g3ncl/scacchiera/docs/hardware/matrix.md

# Matrix board (superseded baseline)

**Superseded 2026-08-02 by the four-lane [quad board](quad.md), which ships.** This file stays
because it is not dead weight: the quad instantiates this board's `matrix_cell` sixteen times and
inherits its loop geometry unchanged, so everything below about the antennas, the tag, the switch
cell and the tuning is the shipping design's documentation too. What is superseded is the outline,
the single-substrate stackup and the fabrication economics. The board still generates and still
passes DRC, and it stays that way deliberately: it is the measured baseline every figure in
`quad.md` is a delta against.

The sensing board: 8 row and 8 column line antennas under the 280 x 280 mm play area, one shared
13.56 MHz bus, and the switching that couples exactly one line at a time. A piece's square is the
intersection of the row and the column that both read its tag's UID, so 16 antennas cover 64
squares (the row-column technique from the research wiki, proven by the NFC Game Board project).
Schematic in `hardware/pcb/matrix.py`, layout in `hardware/pcb/matrix_layout.py`.

## Antennas

Each line is a single-turn rectangular loop, 276 x 31 mm of 1 mm trace, inset 2 mm inside its
35 mm lane. Single-turn keeps rows entirely on the front copper and columns entirely on the back,
so the two sets cross with no jumpers, and the resulting low inductance (0.59 uH by Grover's
formula from the routed geometry) tunes with a plain 220 pF C0G plus DNP trim pads. Rows face the
pieces; columns read through the 1.0 mm substrate, inside the 3.0 mm read budget of
[functional/physical.md](../functional/physical.md). The loop is drawn by a net-tie footprint
(`Chessboard:Antenna_Line`, generated by `hardware/pcb/footprints.py`) whose two terminals land on
through-hole pads in the component margin.

## Piece tag

Candidate, not yet purchased: an Avery Dennison **AD Circus SLIX2** round inlay (product code
3006370 / IL-603074) carrying the **NXP SL2S2602 (ICODE SLIX2)** die. Datasheets are filed in the
vault (`SL2S2602_NXP.pdf`, `AD-CIRCUS-SLIX2_AVERYDENNISON.pdf`) and ingested as
`Wiki/sources/sl2s2602-datasheet.md` and `Wiki/sources/ad-circus-slix2-datasheet.md`.

ISO/IEC 15693 rather than ISO/IEC 14443-A, and that is an architectural consequence rather than a
preference. A vicinity card operates at roughly a tenth the field strength of a proximity card,
and coupling an 18 mm tag coil to a 276 mm line antenna is weak by construction. 15693 is also
what BitwiseID's unaddressed `READ MULTIPLE BLOCKS` and `INVENTORY READ` need, and what the
PN5180 on the hub reads best.

Numbers the V4 model takes from these datasheets:

| Value | Figure | Source |
| --- | --- | --- |
| Tag antenna diameter | 18 mm | inlay datasheet, Overview |
| Die-cut diameter | 21 mm | inlay datasheet, Technical features |
| Inlay thickness | 141 um | inlay datasheet, Technical features |
| Chip input capacitance | 23.5 pF typ, 22.3 to 24.7 pF | SL2S2602 Table 84 |
| Minimum input power | 40 uW | SL2S2602 Table 84 |

The 21 mm die-cut leaves 0.5 mm radial clearance in the 22 mm recess of
[functional/physical.md](../functional/physical.md); this is the tag drawing that
`PHY-TAG-RECESS-DIAMETER` in [criteria.yaml](criteria.yaml) was waiting on. Model the 18 mm coil,
not the die-cut: using the die-cut would overstate the coupling area by 36 percent.

### Why the pawn bases are oversized

The tag fits the 22 mm recess, but at conventional proportions the recess does not fit a pawn. On
the 35 mm grid the standard ratios (king base 0.73 to 0.78 of the square, pawn base about 0.586)
give a 25.6 to 27.3 mm king base and an approximately 20.5 mm pawn base, smaller than the 21 mm
die-cut. Sixteen of the thirty-two pieces are pawns.

Every ISO 15693 tag small enough for a 20.5 mm pawn base was surveyed and rejected:

| Part | Size | Verdict |
| --- | --- | --- |
| AD Miniblock SLIX2 | 18 x 18 mm die-cut, 14.5 mm coil | 25.5 mm across the diagonal, worse than the round Circus |
| AD Minitrack SLIX2 | 14 x 31 mm | 31 mm long, does not fit any base |
| HID laundry tag SLIX2 | 16 mm disc | Fits, but EUR 1.64 and a sealed puck rather than a 141 um inlay |
| SLIX2 on-metal micro | 6 mm disc | EUR 2.50, and anti-metal behavior is prohibited by the functional spec |

Nothing small is comparably priced, and everything small couples worse, because coupling scales
with coil area and this design is already weakly coupled by construction. So the piece geometry
moves instead of the tag: `docs/functional/physical.md` sets a 24 mm minimum base diameter for
every piece, pawns included, which holds the 22 mm recess with 1 mm of wall per side and the bound
tag with 1.5 mm. A 35 mm square is already well under FIDE's 50 mm minimum, so the set is
non-standard regardless; the visible cost is that pawn bases end up close to the king's.

Two gaps, recorded rather than assumed away. Avery Dennison publishes no coil inductance, turn
count, or resonant frequency, so the tag resonator has to be back-solved against the 23.5 pF or
measured at V8, and that value is derived, not sourced. NXP publishes no equivalent parallel
resistance at minimum operating power, so loaded tag Q is derived too. V4 can run a bounded model
on this part; it cannot yet run a fully datasheet-sourced one.

### Coupling against the proven design

The prior art is in the vault as a full design package: schematics, Sprint Layout PCBs and the
vendor datasheets, at `Vault/Scacchiera/Clippings/nfcgameboard.com/files/`. Its antenna grid
schematic states **"Antenna: 15 x 320 (347) mm single winding PCB trace"**, thirty of them, on a
15 by 15 grid. Running that geometry through the same FastHenry model as ours is the only
calibration available for a number no datasheet gives:

| | nfcgameboard | this design |
| --- | --- | --- |
| Loop | 15 x 320 mm | 31 x 276 mm |
| Lane pitch | 21.3 mm (inferred from 320/15) | 35 mm |
| Fill, breadth over pitch | 0.70 | **0.89** |
| Gap between adjacent loops | 6.3 mm | **4.0 mm** |
| Adjacent-line coupling | 0.0786 | **0.1401** |
| Worst row-to-column coupling | 0.0170 | **0.0664** |

**Our lines couple 1.8 times harder than the design that demonstrably works, and our worst
row-to-column crossing is 3.9 times theirs.** That is not a proven defect, because nothing
establishes where the failure threshold is, but it does mean this copper sits outside the regime
the working hardware demonstrates, and the prior art can no longer be cited as covering it.

The lever is `LOOP_INSET`, and it is already against a wall:

| Inset | Breadth | Adjacent coupling | Margin enclosing a worst-case off-centre tag |
| --- | --- | --- | --- |
| **2.0 mm, current** | 31.0 mm | 0.1401 | **+1.0 mm** |
| 3.0 mm | 29.0 mm | 0.1067 | 0.0 mm |
| 4.0 mm | 27.0 mm | 0.0842 | -1.0 mm |
| 5.25 mm | 24.5 mm | 0.0640 | -2.2 mm |

A 24 mm piece base can sit 5.5 mm off centre in a 35 mm square, putting the far edge of an 18 mm
tag coil 14.5 mm from the centre, and the current loop half-breadth is 15.5 mm. So the 2 mm inset
is what keeps a badly placed piece inside its own loop, and buying crosstalk margin spends read
margin one for one. The enclosure figure is a proxy rather than a cliff, because a loop's field
does not stop at its conductor, but the direction of the trade is real.

Three ways out, none free: accept the coupling and show it harmless, widen the inset and accept
less tolerance to a badly placed piece, or enlarge the piece bases further so pieces self-centre
better and the inset can grow. The third interacts with the 24 mm minimum already set in
[functional/physical.md](../functional/physical.md).

Which is why this is a measurement question. The test article in
[test-article-quad.md](test-article-quad.md) settles read range against off-centre position and
whether a neighbouring line answers, in one session, and neither can be settled by more solving.

Note what the lever is, though: `LOOP_INSET` is per-line geometry, and the three ways out are one
sweep of one parameter. That was the argument for the split sensing plane in [quad.md](quad.md),
and it is why that board rather than this one ships: an attempt costs 20.92 EUR there against 58.34
here. The two architectures carry identical copper and identical coupling; they differ in what it
costs to change them.

## Switch cell

One cell per line, the single-ended half of the hybrid PIN switch the previous 64-antenna design
validated in SPICE:

- series BAR64-02V PIN diode: 2.5 ohm at 10 mA forward (datasheet max, 100 MHz), sub-picofarad
  reverse, so fifteen deselected
  cells load the bus with about 6 pF total where analog switches would collapse the tank;
- shunt BSS123-7-F grounding the tank when deselected (the off/on suppression);
- bias steering from the 3V3 rail: high-side BSS84-7-F, 180 ohm set resistor, isolation BAR64-02V,
  10 uH choke, with the forward current returning through the loop's own grounded end. That choke is
  rated 15 mA, and the swept bias reaches 10.58 mA over the rail and resistor tolerances, so 29
  percent of its rating stays unused;
- 100 nF DC block toward the shared bus and a 100 kilohm bleed.

Selection is one-hot active low from two daisy-chained 74HC595 registers; the same line both
releases the shunt and turns on the bias steering. After power-up the register state is undefined
until the hub clocks a pattern in, and the reader field is off until then.

## Interface to the hub

### The selection registers cannot be cleared

Both 74HC595 `SRCLR_N` pins are tied to 3V3 and both `OE_N` pins to ground, so the sixteen
selection outputs are permanently enabled and can never be blanked. The hub has a `SEL_SRCLR_N`
net on expander P1.3, but it runs to pullup R31 and stops: it is absent from J4's seven conductors
and from this board entirely. Confirmed against the generated netlists, where it reads
`SEL_SRCLR_N: (('R31', '2'), ('U6', '16'))` against a properly routed
`SEL_RCLK: (('J4', '7'), ('R26', '1'), ('U6', '4'))`.

Two consequences:

1. **From power-up until firmware acts, the selection is undefined.** A 74HC595's storage register
   powers up in no particular state and its outputs are live immediately. Several PIN diodes may be
   forward biased at once, which is an unmanaged current and a meaningless RF state, though not a
   damaging one: sixteen cells at about 10 mA is 160 mA on a rail sized well above that.
2. **Shifting a known pattern is the matrix driver's first action and cannot be skipped**, because
   there is no blanking alternative.

Not worth fixing in copper. J4 is a full 7-pin connector, so routing the signal means an 8-pin part
at both ends and a re-route of two boards, to replace something a 16-bit shift already does. What
was worth fixing is the trap: `hardware/pcb/firmware_pins.py` excludes the net from the generated
firmware header, so no driver can reach for a clear that would appear to succeed and do nothing.

### Connector

7-pin JST GH: the RF bus between two grounds, 3V3, and the register serial (SER, SRCLK, RCLK).
The reader and its matching live on the hub; this board is copper and switching only.

## Board

300 x 300 mm, 2 layers, 1.0 mm thick. The play area sits 15 mm off the left and bottom edges;
those margins carry every component (all on the back, keeping the front face flat for the
controlled air gap), the connector, and both-face ground pours. Components are placed
deterministically in code. Normal builds import the reviewed route in
`hardware/pcb/routes/matrix.ses`; `make pcb-matrix-reroute` explicitly produces a new Freerouting
candidate. KiCad DRC with schematic parity (`make pcb-matrix-drc`) reports 0 violations,
0 unconnected, and 0 parity issues. The four shared serial nets and Q24 power escape are routed
deterministically before the reviewed session is imported, so their 0.65 mm register escapes do
not depend on autorouter variation. Ground pours are added and filled after routing.

## Mounting

Two M2.5 plated holes bonded to ground, past each end of the switch-cell array. Only two, and that is
a constraint rather than a choice: the 15 mm left and bottom margins are already fully committed to
hand-routed register lanes, the reserved front-copper band for the U1 serial verticals, the cell part
rows at 4.4 and 10.6 mm, and the vertical corridors the router needs for all 16 selection lines.
Putting a 5.4 mm pad mid-margin made Freerouting fail outright on SEL_CHAIN. The far two edges are
only 5 mm wide with the outer antenna loop 1.6 mm away, where a grounded screw would load it.
Screwing all four edges needs a wider outline, which belongs with the enclosure design.

## Validation

`hardware/tests/test_sim_matrix.py` builds the cell and the full 16-cell bus from the same SKiDL
objects as the netlist, expands the loop footprint to its geometry-derived inductance and AC
resistance (`hardware/sim/loop.py`), and runs ngspice against
[criteria.yaml](criteria.yaml). With the exact Diodes vendor MOSFET models, the selected cell
resonates at 13.54 MHz, the loaded 16-line bus at 12.93 MHz, off/on suppression is 65.6 dB, and
steering bias is 10.326 mA on and 0.058 uA off.

## Cost

Generated BOM totals 4.80 EUR in parts; with area-dominated fabrication the board lands around
the 25 EUR target in [boards.md](boards.md).
