g3ncl/scacchiera/docs/software/architecture.md

# Firmware architecture

How the firmware is split so that the behaviour in [functional/gameplay.md](../functional/gameplay.md)
can be tested on a development machine rather than only on a board. This file covers the split, the
build targets, and the rule that keeps them apart. Driver detail belongs in its own file per
peripheral, not here.

## The split

V5 in [simulation-workflow.md](../simulation-workflow.md) requires gameplay and product state logic
to be independent of ESP32 register access. That is not a testing convenience, it follows from the
first principle in [functional/overview.md](../functional/overview.md): the typed physical position
is authoritative and a sensing fault is never converted into a move. Deciding what the position
means has to be separable from deciding what the hardware just reported, or the two get to influence
each other.

So there are two layers and one boundary.

`core/` holds the position, the rules, move derivation from typed snapshots, the clock, the game
state machine, the fault table, provisioning, and PGN. It includes no ESP-IDF header, touches no
register, and blocks on nothing. It is C that runs anywhere.

`port/` holds the PN5180, the TCA9535, the displays, the light bars, the matrix scan, the button,
persistence, and the network. It is where ESP-IDF appears.

The boundary is a small set of headers in `core/` that `port/` implements: a scan returns a typed
snapshot, a clock returns monotonic milliseconds, an output surface accepts display text and light
cues, and storage accepts and returns a game snapshot. On the host the same headers are implemented
by deterministic fakes, which is what makes generated move sequences and injected faults possible.

Nothing in `core/` calls into `port/`. The application in `main/` owns the wiring and is the only
place that knows both exist.

## Why C

The target build has to be the exact ESP32-C6 image V6 runs in Wokwi and V9 releases, and ESP-IDF is
a C toolchain. Using anything else in `core/` would mean either a second toolchain in the image or a
host-only reimplementation of the rules, and a rules engine that is not the shipped one is not
evidence. Strict warnings, static analysis, and the address and undefined-behaviour sanitizers all
run on the host build, where they are cheap.

## Build targets

Two, from the same sources:

- **Host tests.** Plain CMake and CTest over `core/` plus the fakes, with Unity and CMock. This is
  the V5 gate. It builds with warnings as errors and runs under the sanitizers.
- **Target image.** The ESP-IDF build over `core/`, `port/` and `main/` for the ESP32-C6 and its
  partition layout. This is the binary V6 executes and V9 releases.

A file that will not compile in both is in the wrong layer.

## Layout

```
software/firmware/
  core/          rules, state, clock, faults, PGN; no ESP-IDF
  core/hw/       the headers port and the fakes both implement
  port/          ESP-IDF drivers
  main/          application wiring and entry point
  test/          host tests and deterministic fakes
```

The browser client is a separate concern and gets its own directory and its own document when it
starts. It mirrors state and configures the board; nothing required by `docs/functional/` depends on
it being connected.

## Scope for hardware validation

V5 and V6 exist here to de-risk hardware before it is fabricated, not to finish the product. So the
work is ordered by what a board can teach us and nothing else.

**In scope now**, because it is what exercises the hardware: the PN5180 driver down to SPI framing,
BUSY, IRQ, reset and inventory; the TCA9535 and everything hanging off it; the display SPI at the
timing the SSD1362 table fixes; the matrix register chain and its scan; the light-bar data stream;
the button; the charger and rail signals; power-up, warm reset and the recovery path. These are the
parts whose failure means a board respin, so they are the parts V6 has to run in simulation against
behavioural peripheral models.

**The rules engine is real**: `core/game.c` is the game state machine from
[functional/gameplay.md](../functional/gameplay.md), driven by identity-resolved stable positions,
clean raw sweeps for the second-scale gestures, the button, and a clock that arrives as a parameter.
It covers the start check against the standard position, the ten-second time-control window, the
provisional-move contract (commit on the opponent's first lift, cancel by returning, replace by a
different legal move), promotion by replacement tag, the resign and draw king-absence countdowns,
pause and resume, flag fall with the insufficient-material exception, the automatic endings with the
claimable hints, a sealed persisted record after every commit, and resume-after-restart against a
matching physical board. Gestures advance only on clean sweeps: no evidence, no countdown, so an
unreadable board can never resign a game nobody touched.

## Status

`software/firmware/` holds the host build, the boundary headers, the core logic, the six drivers and
the deterministic fakes. `make firmware-test` is part of `make check`.

What is there:

- CMake and CTest over `core/` plus the fakes, building with `-Werror`, `-Wconversion`,
  `-Wsign-conversion`, `-Wshadow` and the rest, and with gcc's `-fanalyzer` as the static analysis
  step. `clang-tidy` and `cppcheck` are not installed on this machine.
- `core/`: `square` (zero based, aligned with the sensor array), `piece`, `fault` (the six faults
  from [functional/gameplay.md](../functional/gameplay.md) with a test that fails if the table
  drifts), `snapshot` (typed 64-square reading with UID, plus equality, occupancy and duplicate-UID
  detection), `scan_join` (sixteen line reads to sixty-four squares), `stability` (when a sweep has
  become a position), `text` with its generated glyph table, and the chess core: `move`,
  `position` (with FEN for perft fixtures), `movegen` (legal generation, verified against
  published perft counts), `movederive` (which legal move turned a known position into the sensed
  one), `chessclock`, `repetition`, `result`, `registry` and `identity` (UID to piece through the
  provisioning table), `game_record` (the sealed, CRC-checked persisted game), and the `engine`
  stub that will replace piecewise use of those parts with the game state machine.
- `core/hw/`: `clock`, `scan`, `output`, `storage`, the four headers `port/` and the fakes both
  implement as free functions. No indirection layer, because link-time substitution already does
  the job.
- `test/`: deterministic fakes for all four boundary headers, and twenty-one test executables
  covering square indexing, snapshot semantics, the fault table, the stub's contract, the fakes
  themselves, the scan join, the stability layer, text rendering, both the matrix and light-bar
  encodings, and the chess core: moves, positions, move generation (perft), move derivation, the
  clock, results, the registry and identity resolution.
- `main/`: the wiring plus the scan loop, one pass of scan, stability, identity and engine every
  quarter second, with faults surfacing on both displays. Only the expander aborts the boot on
  failure; a dead scan path or output surface logs, is announced where possible, and leaves the
  rest of the board running.

The game machine is pinned two ways: unit tests for every spec behaviour (commit, cancel,
replace, time selection, flag fall, gestures, resume, persistence failure), and generated
sequences in `test_game_sequences.c`, where scripted games cover checkmate, castling, en passant
and promotion end to end, and deterministic random games are cross-checked ply by ply against an
independent repetition ledger and result evaluation, ending with a resume round trip.

The analyzer and the sanitizers are both V5 obligations, and they do not share a build: gcc's
analyzer, run over sanitizer-instrumented code, reports uninitialized values that exist only in the
instrumentation's own temporaries, with no source location to inspect. So the gate runs one per
configuration. The configure probes a real sanitizer link, because gcc accepts the flag without the
runtime libraries and only fails at link. With `libasan` and `libubsan` present the tests run under
ASan and UBSan and the analyzer is skipped with a notice; a second configure with
`-DFIRMWARE_SANITIZE=OFF` is the analyzer pass. Without the runtimes the analyzer pass is what
runs, and the gate warns that the sanitizer half is missing.

### The target image

`make firmware-target` produces a 227 KB `chessboard.bin` for the ESP32-C6, leaving 85 percent of
its app partition free.

- **Pinned to ESP-IDF v5.5.5**, commit `b774170ff46c393eeb5e495ea37936038d3f4f4f`, with the
  riscv32 toolchain at esp-14.2.0. v5.5 rather than v6.0 because V6 has to run this exact image in
  Wokwi and the v5.5 line has the most mileage there.
- The IDF project root is `target/`, kept separate because the host gate owns
  `software/firmware/CMakeLists.txt` and two build systems cannot share one project root.
  `core/CMakeLists.txt` registers itself either as an IDF component or as a plain static library
  depending on `ESP_PLATFORM`, so both builds compile the same sources rather than a copy.
- `target/partitions.csv` fixes the layout: two 1.5 MB OTA app slots so a failed update cannot
  leave a board that will not boot, NVS for the in-progress snapshot because it is rewritten after
  every committed move and NVS wear-levels, and a 896 KB SPIFFS partition for PGN.
- `port/board_pins.h` is generated from the hub netlist by `hardware/pcb/firmware_pins.py`, and
  `hardware/tests/test_firmware_pins.py` fails if the committed copy drifts. A stale pin map is not
  a compile error, it is a board that boots and does the wrong thing.

`firmware-target` is deliberately not part of `make check`, because it needs a 2 GB toolchain
exported rather than a checkout dependency.

## Drivers

`port/` holds six drivers and the boundary implementation, all compiling for the C6. Boot order is
not arbitrary; each step depends on the previous one.

| Step | What it establishes |
| --- | --- |
| `expander_init` | resets asserted, light-bar rail off, matrix latch idle low |
| `spi_bus_init` | the one bus shared by reader, both displays and the matrix registers |
| `matrix_init` | shifts and latches all-deselected, the only path to a known selection |
| `pn5180_init` | reset, then an EEPROM version read that proves the framing |
| `display_init` | shared reset, 50 ms settle, init sequence, clear, on |
| `lightbar_init` | blank the pixels, then enable the rail |
| `board_hw_storage_init` | NVS for the in-progress snapshot |

Three properties of the wiring shape all of this, and each was read from the netlist rather than
assumed:

- **The matrix registers have no chip select**, so every byte sent to the reader or a display is
  also shifted into them. Their outputs only move on a latch edge, so the shift and the latch must
  be atomic against all other SPI traffic. Every driver that transacts acquires the bus.
- **The expander's outputs power up high**, so values are written before directions. Otherwise the
  reader and displays leave reset uncontrolled, the light-bar rail switches on, and the matrix
  latches random selection.
- **The matrix cannot be blanked**, so shifting a known pattern is mandatory rather than tidy.
- **The selection chain is four eight-bit registers, one per sensing board**, so a scan shifts 32
  bits and only the low nibble of each byte reaches a lane. Half of every register drives nothing
  ([hardware/quad.md](../hardware/quad.md)), which makes the line-to-bit map a stride of 8 with a
  lane count of 4 rather than the linear map the two-register monolith had. That is the one thing
  the sensing-plane repartition asked of software, and `test_matrix_encoding.c` pins both the
  stride and the byte order so a refactor cannot transpose the board.

## What is real and what is not

Real: the expander, the matrix selection, the PN5180 framing down to BUSY and sixteen-slot ISO
15693 anticollision, the SSD1362 command path, the light-bar stream, the clock, light cues, NVS
persistence, a full sixteen-line sweep joined into a snapshot, rendered display text, and the stability layer that decides when a sweep has become a position.

Text comes from `core/text.c` against a glyph table generated by
`software/firmware/tools/generate_font.py`, where the glyphs are drawn as art so a wrong bit shows
up in review rather than only on a panel. `make firmware-font` regenerates it. The renderer is in
`core/` because packing four-bit pixels two to a byte is logic, not hardware, and it is covered by
ten host tests including the nibble order, which mirrors characters in pairs when it is wrong.

Not real, and deliberately so:

- **PGN export.** The record persists moves and the clock; rendering completed games as PGN with
  SAN belongs to the browser-client increment, which also owns the explicit undo.
- **Sleep and low battery.** Both need the battery ADC path and a power-state driver that do not
  exist yet; the gameplay spec's twenty-minute sleep and five-minute low-battery shutdown stay
  open until they do.
- **The provisioning journey.** Identity resolution through the registry is real: a stable
  position is resolved UID by UID and an unknown tag is a `TAG_FAULT` at its square. What does not
  exist is the journey that fills the registry: the button-gated write of piece records to tags
  and the readback that proves them. Until then every piece on an unprovisioned board reads as
  `TAG_FAULT`, which is the honest state.
- **The BitwiseID scheme.** Sixteen-slot anticollision, now with the standard's mask recursion on
  collided slots, resolves everything a line carries, which is what makes a real position readable
  at all, but it does so slot by slot.
  [The research](../../Vault/Scacchiera/Wiki/concepts/bitwiseid-method.md) exists because that
  scales badly: the source paper measures an equivalent 8x8 scan at 616 to 745 ms with classic
  anticollision. Throughput, not correctness, is what BitwiseID buys, and it waits on a bench
  answer to whether the PN5180 exposes collision positions the way the paper's reader does.
- **Retry.** A collided slot is not retried, it is recursed: the slot a tag picks is UID-derived,
  so only a longer mask separates the colliders. A collision that survives the mask and round
  budgets is reported as an under-read line rather than guessed at.

`core/stability.c` is where "stable" is given a meaning, and it keeps two jobs apart that are easy
to conflate. Agreement emits a position once it has read identically three sweeps running, and only
once, so a board that stays put does not re-fire on every scan. Instability is separate: a square
changing more than three times inside a two-second window is the `SQUARE_UNSTABLE` fault from the
functional spec, "a square repeatedly changes between present, absent, or unreadable", which no
single sweep can see. The threshold sits above ordinary handling, because lift-place-adjust is a
move rather than a defect, and the window resets so a long game does not accumulate every square
into instability. A faulted sweep neither confirms the candidate nor replaces it.

The join from sixteen line reads to sixty-four squares lives in `core/scan_join.c`, not in a
driver, because that is where the ghost-piece and crosstalk faults live and it is testable without
hardware. Nine tests cover it, including that a tag heard on two lines never becomes a piece and
that a tag heard on one axis is not placed at a guessed square.
