g3ncl/scacchiera/docs/hardware/power-module-interface.md

# Power module interface

The battery, charger, protection, power path and 5 V conversion live on the custom power board. This
file is the contract that board satisfies and that an optional purchased replacement must also satisfy,
so either can be used without changing the hub, firmware, or enclosure electrical assumptions.

The hub owns the safety gate regardless of which module is fitted: qualified 5 V leaves the hub, and
a module that misbehaves cannot charge a cell outside the window proven in
[hub.md](hub.md).

## Signals

The input harness is seven-way JST GH 1.25 mm. The output harness is eight-way Molex Micro-Fit 3.0.
Power and ground use multiple contacts so no single terminal carries the whole interface current.

**J2, hub to module input.** Qualified 5 V, gated by cell temperature.

| Pin | Signal | Direction | Note |
| --- | --- | --- | --- |
| 1 to 3 | CHARGE_5V | hub to module | three contacts, 3.0 A capability |
| 4 to 7 | GND | shared | four contacts |

While an adapter is connected this harness carries charge current and system load together, which is
why it has more supply contacts than J3.

**J3, module to hub.** The module's regulated output and its optional telemetry.

| Pin | Signal | Direction | Required |
| --- | --- | --- | --- |
| 1, 2 | MODULE_5V | module to hub | yes, two contacts; connector revision required for margin at 2 A |
| 3, 4 | GND | shared | yes; connector revision required for margin at 2 A |
| 5 | I2C_SCL | hub to module | no |
| 6 | I2C_SDA | bidirectional | no |
| 7 | BAT_RAW | module to hub | yes, the cell terminal |
| 8 | NC | none | reserved, deliberately unconnected |

## Mandatory properties

A candidate module must provide all of these:

- **5 V output at 2.0 A continuous, never sagging below 4.0 V.** The board's coincident worst case
  is derived in `hardware/verification/load_budget.py` and comes to 1.48 A: both light bars white
  (448 mA) on the 5 V directly, plus 1.33 A on the 3.3 V rail behind the buck, with the radio at its
  transmit peak, the reader driving its field at maximum, both displays active and the matrix biased. The floor comes from the hub side: its buck holds 3.3 V until its input falls to 3.51 V at
  that load, and 4.0 V keeps half a volt in hand for the cable and connector drops that figure
  excludes. A module that sags further browns out the MCU, and the hub cannot ride it out; its
  output capacitance is worth about five microseconds. The 2 A rating provides 35 percent current
  headroom over that presently derived load and is the required 10 W stress capability.
- **Charging from a 5 V input at 1.5 A or more**, which gives the 6.5 Ah cell candidate enough
  constant-current time to meet `POWER-CHARGE-10-80` at 240 minutes.
- **Uninterrupted output across source insertion and removal.** The board must not reset when the
  adapter is connected or pulled. This is the property the module exists for, and V8 measures it.
- **Output that stays up at a few milliamps indefinitely.** The board sleeps after twenty idle
  minutes under `GAME-IDLE-SLEEP` and draws far less than the 45 to 50 mA at which power-bank
  controllers switch themselves off. If a module needs a register write to disable that shutdown,
  the setting must survive a brownout and a power cycle, and V8 must show it.
- **Cell terminal available** on a pad or pin, for the hub's own battery reading.
- **Cell protection**: overcharge, over-discharge, overcurrent and short circuit, on the module or
  on the cell's own protection board.
- **Fits the service volume**: no dimension across the rail above 46 mm, including the cell. A
  cylindrical cell may run lengthwise along the 310 mm rail, so its diameter rather than its length
  consumes this cross-rail dimension.

## Deliberately not required

- **I2C telemetry.** The hub reads cell voltage itself through the divider on `BAT_RAW`, so battery
  level and estimated play time do not depend on a module's register map. Where a module does expose
  I2C, the hub can use it for source presence and charge control, but nothing required by
  `docs/functional/` rests on it. This is what lets a module with an undocumented or absent I2C
  interface be fitted.
- **A cell thermistor.** The hub carries its own cell-bonded sensor and analog window, so a module
  without an NTC input is acceptable and a module with one is redundant rather than trusted.
- **USB Power Delivery negotiation.** The inlet is power-only and presents passive sink resistors.
  The hub does measure the ordinary Type-C 5 V current advertisement so it can distinguish default,
  1.5 A, and 3.0 A sources without requesting a PD contract or a higher voltage.
- **A specific cell format.** Any protected assembly meeting runtime, current, and cross-section
  requirements fits. The filed 21700 candidate is permitted lengthwise, but it is not yet a bound
  protected assembly.

## Fitted implementation

The custom power board is fitted. A purchased module is only an optional replacement and is not a V1
release dependency. The previously selected PiSugar 3 Plus fails the 46 mm width, which is why the
interface remains a contract rather than being written around that product.

## Verification

- V2 checks both connector pin maps against this table from the schematic.
- V3 proves the temperature gate holds for any module, derives the 4.0 V output floor from the hub,
  and sweeps the fitted custom board's boost power stage at the full 2 A obligation.
- V8 measures, on the fitted module: charge time against `POWER-CHARGE-10-80` and
  `POWER-CHARGE-10-FULL`, output continuity across source insertion and removal, output held during
  sleep, and cell-surface temperature under charge.
