g3ncl/scacchiera/Vault/Scacchiera/Wiki/concepts/commercial-battery-subsystem.md

---
type: concept
date_updated: 2026-07-26
source_count: 4
confidence: high
tags:
  - wiki/concept
  - wiki/power
  - wiki/safety
---

# Commercial battery subsystem

A purchased battery subsystem keeps the lithium cell, CC/CV charger, protection, boost converter,
and power-path switching together as a tested replaceable unit. The chessboard consumes a regulated
5 V rail and status data instead of reproducing the dangerous part of the design.

This boundary is cleaner than copying a module schematic. A published schematic does not transfer
layout parasitics, thermal behavior, production tests, battery matching, firmware, or transport
evidence. It is also cleaner than attaching telemetry around a minimal power-bank board when a
module such as [[pisugar3-plus]] already exposes power state and battery percentage over I2C.

The subsystem boundary does not make the completed product automatically safe. Enclosure
ventilation, cell temperature, strain relief, impact protection, NFC interference, charge time,
runtime, and output continuity remain system-level verification obligations.
