g3ncl/scacchiera/Vault/Scacchiera/Datasheets/430450200_C122431.md

# Molex 430450200 product data

Source: https://www.molex.com/en-us/products/part-detail/430450200
Captured: 2026-07-29

Part number: 430450200
Series: Micro-Fit 3.0 43045
Description: right-angle, through-hole, dual-row PCB header
Circuits: 2
Pitch: 3.00 mm
Current maximum per contact: 8.5 A
Voltage maximum: 600 V
Recommended PCB thickness: 1.60 mm
Operating temperature: -40 to +105 degC
Mating cycles maximum: 30
Mating housing: 430200200
Material: high-temperature thermoplastic housing, brass contacts, matte-tin mating finish

The manufacturer drawing is
https://www.molex.com/content/dam/molex/molex-dot-com/products/automated/en-us/3dcadmodelspdf/430/43045/430450200.pdf
and identifies material number 430450200 and a two-circuit shell.
