g3ncl/scacchiera/Vault/Scacchiera/Datasheets/430450800_C122422.md

# Molex 430450800 product data

Source: https://www.molex.com/en-us/products/part-detail/430450800
Captured: 2026-07-29

Part number: 430450800
Series: Micro-Fit 3.0 43045
Description: right-angle, through-hole, dual-row PCB header
Circuits: 8
Pitch: 3.00 mm
Current maximum per contact: 8.5 A
Voltage maximum: 600 V
Recommended PCB thickness: 1.60 mm
Operating temperature: -40 to +105 degC
Mating cycles maximum: 30
Mating housing: 430200800
Material: high-temperature thermoplastic housing, brass contacts, matte-tin mating finish

The manufacturer sales drawing for the family is
https://www.molex.com/content/dam/molex/molex-dot-com/products/automated/en-us/salesdrawingpdf/430/43045/430450400_sd.pdf
and explicitly lists 43045-0800 in the eight-circuit row.
