g3ncl/scacchiera/Vault/Scacchiera/Wiki/entities/0603waf1002t5e.md

---
type: entity
tags:
  - wiki/entity
  - wiki/component
date_updated: 2026-07-29
source_count: 1
---

# 0603WAF1002T5E

Exact fitted component from UNI-ROYAL, used by hub R34 (10k), hub R35 (10k), hub R4 (10k), hub R36 (10k), hub R20 (10k), hub R23 (10k), hub R25 (10k), hub R31 (10k), power R14 (10k 1%), power R1 (10k 1%), power R2 (10k 1%).

[mpn::0603WAF1002T5E] [supplier::JLCPCB]
[order_code::C25804] [category::resistor]

The immutable source is summarized in [[0603waf1002t5e-datasheet]]. The complete
library, rating, availability, and model audit is machine checked from
`docs/verification/v1-components.yaml`.
