g3ncl/scacchiera/Vault/Scacchiera/Wiki/entities/0603waf1003t5e.md

---
type: entity
tags:
  - wiki/entity
  - wiki/component
date_updated: 2026-07-29
source_count: 1
---

# 0603WAF1003T5E

Exact fitted component from UNI-ROYAL, used by matrix R3 (100k 1%), matrix R6 (100k 1%), matrix R9 (100k 1%), matrix R12 (100k 1%), matrix R15 (100k 1%), matrix R18 (100k 1%), matrix R21 (100k 1%), matrix R24 (100k 1%), matrix R27 (100k 1%), matrix R30 (100k 1%), matrix R33 (100k 1%), matrix R36 (100k 1%), matrix R39 (100k 1%), matrix R42 (100k 1%), matrix R45 (100k 1%), matrix R48 (100k 1%), hub R6 (100k 1%), hub R7 (100k 1%), hub R8 (100k 1%), hub R9 (100k 1%), hub R10 (100k 1%), hub R11 (100k 1%), hub R12 (100k), hub R15 (100k), hub R18 (100k), hub R19 (100k), hub R37 (100k), hub R24 (100k), hub R26 (100k), power R15 (100k 1%), power R17 (100k 1%), power R3 (100k 1%), power R6 (100k 1%), power R8 (100k 1%).

[mpn::0603WAF1003T5E] [supplier::JLCPCB]
[order_code::C25803] [category::resistor]

The immutable source is summarized in [[0603waf1003t5e-datasheet]]. The complete
library, rating, availability, and model audit is machine checked from
`docs/verification/v1-components.yaml`.
