g3ncl/scacchiera/Vault/Scacchiera/Wiki/sources/0603waf1003t5e-datasheet.md

---
type: source-summary
tags:
  - wiki/source
  - wiki/component
date_updated: 2026-07-29
source_file: "Datasheets/0603WAF1003T5E_C25803.pdf"
source_title: "0603WAF1003T5E manufacturer datasheet"
publisher: "UNI-ROYAL"
---

# 0603WAF1003T5E datasheet

This source binds [0603WAF1003T5E](../entities/0603waf1003t5e.md) to supplier order
code `C25803`. It is used by matrix R3 (100k 1%), matrix R6 (100k 1%), matrix R9 (100k 1%), matrix R12 (100k 1%), matrix R15 (100k 1%), matrix R18 (100k 1%), matrix R21 (100k 1%), matrix R24 (100k 1%), matrix R27 (100k 1%), matrix R30 (100k 1%), matrix R33 (100k 1%), matrix R36 (100k 1%), matrix R39 (100k 1%), matrix R42 (100k 1%), matrix R45 (100k 1%), matrix R48 (100k 1%), hub R6 (100k 1%), hub R7 (100k 1%), hub R8 (100k 1%), hub R9 (100k 1%), hub R10 (100k 1%), hub R11 (100k 1%), hub R12 (100k), hub R15 (100k), hub R18 (100k), hub R19 (100k), hub R37 (100k), hub R24 (100k), hub R26 (100k), power R15 (100k 1%), power R17 (100k 1%), power R3 (100k 1%), power R6 (100k 1%), power R8 (100k 1%).

[mpn::0603WAF1003T5E] [order_code::C25803]
[manufacturer::UNI-ROYAL] [footprint::Resistor_SMD:R_0603_1608Metric]

## Design facts reviewed

- Library proof: manufacturer pin and package drawing checked against the SKiDL pin numbers, KiCad pad numbers, polarity, top assembly side and KiCad zero-degree orientation.
- Ratings used by the design: value, tolerance, rated power, maximum working voltage, temperature coefficient, operating temperature and package dimensions.
- Exact selected limits: See the filed data sheet and structured audit..
- Datasheet locator: ratings, dimensions and part-number tables.
- Simulation treatment: analytical, valid only for
  lumped model with datasheet tolerance, bias, ESR, DCR and temperature corners.
- Conflicts: none open. Any later catalog or document mismatch reopens V1.
