g3ncl/scacchiera/Vault/Scacchiera/Wiki/sources/lqm21dh100m70l-datasheet.md

---
type: source-summary
tags:
  - wiki/source
  - wiki/component
date_updated: 2026-08-20
source_file: "Datasheets/LQM21DH100M70L_C882484.pdf"
source_title: "LQM21DH100M70L manufacturer datasheet"
publisher: "Murata"
---

# LQM21DH100M70L datasheet

This source binds [LQM21DH100M70L](../entities/lqm21dh100m70l.md) to supplier order
code `C882484`. It is used by matrix L1 (10uH), matrix L3 (10uH), matrix L5 (10uH), matrix L7 (10uH), matrix L9 (10uH), matrix L11 (10uH), matrix L13 (10uH), matrix L15 (10uH), matrix L17 (10uH), matrix L19 (10uH), matrix L21 (10uH), matrix L23 (10uH), matrix L25 (10uH), matrix L27 (10uH), matrix L29 (10uH), matrix L31 (10uH).

[mpn::LQM21DH100M70L] [order_code::C882484]
[manufacturer::Murata] [footprint::Inductor_SMD:L_0805_2012Metric]

## Design facts reviewed

- Library proof: manufacturer pin and package drawing checked against the SKiDL pin numbers, KiCad pad numbers, polarity, top assembly side and KiCad zero-degree orientation.
- Ratings used by the design: inductance, tolerance, rated or saturation current, DC resistance, self-resonance, temperature range and package dimensions.
- Exact selected limits: 10 uH plus or minus 20 percent at 1 MHz, 250 mA saturation-type rated current by inductance change, 300 mA temperature-rise rated current at 125 degrees Celsius ambient, 0.845 ohm maximum DC resistance, 27 MHz minimum self-resonance, ferrite shielded, 0805 package.
- Datasheet locator: electrical characteristics, ratings and dimensions tables.
- Simulation treatment: analytical, valid only for
  lumped model with datasheet tolerance, bias, ESR, DCR and temperature corners.
- Conflicts: none open. Any later catalog or document mismatch reopens V1.
