g3ncl/scacchiera/Vault/Scacchiera/Wiki/entities/0402b223k500nt.md

---
type: entity
tags:
  - wiki/entity
  - wiki/component
date_updated: 2026-07-29
source_count: 1
---

# 0402B223K500NT

Exact fitted component from Fenghua Advanced Technology, used by power C13 (22n 50V).

[mpn::0402B223K500NT] [supplier::JLCPCB]
[order_code::C1532] [category::capacitor]

The immutable source is summarized in [[0402b223k500nt-datasheet]]. The complete
library, rating, availability, and model audit is machine checked from
`docs/verification/v1-components.yaml`.

Power C13 is the series compensation capacitor for [[tps61088rhlr]]. A sensitivity analysis based on TI equations 13 through 17 selects 22 nF over the former 4.7 nF value. TI specifies the error-amplifier transconductance only typically, so the plus or minus 30 percent sweep does not close V3 control-loop evidence. JLC lists C1532 as a Basic assembly part while LCSC retail reported no stock on 2026-07-29.
