g3ncl/scacchiera/Vault/Scacchiera/Wiki/entities/0603waf1000t5e.md

---
type: entity
tags:
  - wiki/entity
  - wiki/component
date_updated: 2026-07-29
source_count: 1
---

# 0603WAF1000T5E

Exact fitted component from UNI-ROYAL, used by hub R27 (100R), hub R28 (100R), power R12 (100R 1%), power R13 (100R 1%).

[mpn::0603WAF1000T5E] [supplier::JLCPCB]
[order_code::C22775] [category::resistor]

The immutable source is summarized in [[0603waf1000t5e-datasheet]]. The complete
library, rating, availability, and model audit is machine checked from
`docs/verification/v1-components.yaml`.
