g3ncl/scacchiera/Vault/Scacchiera/Wiki/entities/0603waf1004t5e.md

---
type: entity
tags:
  - wiki/entity
  - wiki/component
date_updated: 2026-07-29
source_count: 1
---

# 0603WAF1004T5E

Exact fitted component from UNI-ROYAL, used by hub R3 (1M), hub R13 (1M), hub R14 (1M), hub R32 (1M), hub R33 (1M), power R16 (1M 1%), power R18 (1M 1%), power R19 (1M 1%).

[mpn::0603WAF1004T5E] [supplier::JLCPCB]
[order_code::C22935] [category::resistor]

The immutable source is summarized in [[0603waf1004t5e-datasheet]]. The complete
library, rating, availability, and model audit is machine checked from
`docs/verification/v1-components.yaml`.
