g3ncl/scacchiera/Vault/Scacchiera/Wiki/entities/0603waf2492t5e.md

---
type: entity
tags:
  - wiki/entity
  - wiki/component
date_updated: 2026-07-29
source_count: 1
---

# 0603WAF2492T5E

Exact fitted component from UNI-ROYAL, used by power R9 (24.9k 1%).

[mpn::0603WAF2492T5E] [supplier::JLCPCB]
[order_code::C25962] [category::resistor]

The immutable source is summarized in [[0603waf2492t5e-datasheet]]. The complete
library, rating, availability, and model audit is machine checked from
`docs/verification/v1-components.yaml`.
