g3ncl/scacchiera/Vault/Scacchiera/Wiki/entities/0603waf3303t5e.md

---
type: entity
tags:
  - wiki/entity
  - wiki/component
date_updated: 2026-07-29
source_count: 1
---

# 0603WAF3303T5E

Exact fitted component from UNI-ROYAL, used by power R6 (330k 1%).

[mpn::0603WAF3303T5E] [supplier::JLCPCB]
[order_code::C23137] [category::resistor]

The immutable source is summarized in [[0603waf3303t5e-datasheet]]. The complete
library, rating, availability, and model audit is machine checked from
`docs/verification/v1-components.yaml`.
