g3ncl/scacchiera/Vault/Scacchiera/Wiki/entities/0603waf3902t5e.md

---
type: entity
tags:
  - wiki/entity
  - wiki/component
date_updated: 2026-07-29
source_count: 1
---

# 0603WAF3902T5E

Exact fitted component from UNI-ROYAL, used by hub R5 (39k 1%), hub R17 (39k 1%), power R10 (39k 1%).

[mpn::0603WAF3902T5E] [supplier::JLCPCB]
[order_code::C23153] [category::resistor]

The immutable source is summarized in [[0603waf3902t5e-datasheet]]. The complete
library, rating, availability, and model audit is machine checked from
`docs/verification/v1-components.yaml`.
