g3ncl/scacchiera/Vault/Scacchiera/Wiki/entities/0603waf5101t5e.md

---
type: entity
tags:
  - wiki/entity
  - wiki/component
date_updated: 2026-07-29
source_count: 1
---

# 0603WAF5101T5E

Exact fitted component from UNI-ROYAL, used by hub R1 (5.1k), hub R2 (5.1k), power R7 (51k 1%), power R11 (5.1k 1%).

[mpn::0603WAF5101T5E] [supplier::JLCPCB]
[order_code::C23186] [category::resistor]

The immutable source is summarized in [[0603waf5101t5e-datasheet]]. The complete
library, rating, availability, and model audit is machine checked from
`docs/verification/v1-components.yaml`.
