g3ncl/scacchiera/Vault/Scacchiera/Wiki/entities/430250200.md

---
type: entity
tags: [wiki/entity, wiki/component]
date_updated: 2026-07-29
source_count: 1
---

# 430250200

Molex two-circuit Micro-Fit 3.0 receptacle housing selected for the protected battery assembly. It
mates with the fitted 430450200 PCB header and accepts [[430300038]] female terminals. Evidence is
summarized in [[micro-fit-3-0-mating-evidence]].
