g3ncl/scacchiera/Vault/Scacchiera/Wiki/entities/430250800.md

---
type: entity
tags: [wiki/entity, wiki/component]
date_updated: 2026-07-29
source_count: 1
---

# 430250800

Molex eight-circuit Micro-Fit 3.0 receptacle housing selected for both ends of the power-board to hub
harness. It mates with the fitted 430450800 PCB headers and accepts [[430300038]] female terminals.
Evidence is summarized in [[micro-fit-3-0-mating-evidence]].
