g3ncl/scacchiera/Vault/Scacchiera/Wiki/entities/430450200.md

---
type: entity
tags:
  - wiki/entity
  - wiki/component
date_updated: 2026-07-29
source_count: 1
---

# 430450200

Exact fitted component from Molex, used by power J3 (430450200).

[mpn::430450200] [supplier::JLCPCB]
[order_code::C122431] [category::connector]

The immutable source is summarized in [[430450200-datasheet]]. The complete
library, rating, availability, and model audit is machine checked from
`docs/verification/v1-components.yaml`.
