g3ncl/scacchiera/Vault/Scacchiera/Wiki/entities/430450800.md

---
type: entity
tags:
  - wiki/entity
  - wiki/component
date_updated: 2026-07-29
source_count: 1
---

# 430450800

Exact fitted component from Molex, used by hub J3 (430450800), power J2 (430450800).

[mpn::430450800] [supplier::JLCPCB]
[order_code::C122422] [category::connector]

The immutable source is summarized in [[430450800-datasheet]]. The complete
library, rating, availability, and model audit is machine checked from
`docs/verification/v1-components.yaml`.
