g3ncl/scacchiera/Vault/Scacchiera/Wiki/entities/b2b-ph-k-s-lf-sn.md

---
type: entity
tags:
  - wiki/entity
  - wiki/component
date_updated: 2026-07-29
source_count: 1
---

# B2B-PH-K-S(LF)(SN)

Exact fitted component from JST, used by power J3 (B2B-PH-K-S(LF)(SN)).

[mpn::B2B-PH-K-S(LF)(SN)] [supplier::JLCPCB]
[order_code::C131337] [category::connector]

The immutable source is summarized in [[b2b-ph-k-s-lf-sn-datasheet]]. The complete
library, rating, availability, and model audit is machine checked from
`docs/verification/v1-components.yaml`.
