g3ncl/scacchiera/Vault/Scacchiera/Wiki/entities/bat54h.md

---
type: entity
tags:
  - wiki/entity
  - wiki/component
date_updated: 2026-07-29
source_count: 1
---

# BAT54H

Exact fitted component from Jiangsu Changjing Electronics Technology, used by power D1 (BAT54H).

[mpn::BAT54H] [supplier::JLCPCB]
[order_code::C475620] [category::semiconductor]

The immutable source is summarized in [[bat54h-datasheet]]. The complete
library, rating, availability, and model audit is machine checked from
`docs/verification/v1-components.yaml`.

Power D1 clamps the comparator sense input during reversed-cell insertion. The exact LCSC C475620 device is SOD-323, with pin 1 cathode on the sense node and pin 2 anode at ground.
