g3ncl/scacchiera/Vault/Scacchiera/Wiki/entities/bq25619rtwr.md

---
type: entity
tags:
  - wiki/entity
  - wiki/component
date_updated: 2026-07-29
source_count: 1
---

# BQ25619RTWR

Superseded Texas Instruments charger previously used by power U1. [[bq25895rtwr]] replaces it
because the 5 A battery path was too close to the efficiency-bounded 10 W boost current.

[mpn::BQ25619RTWR] [supplier::JLCPCB]
[order_code::C2864534] [category::semiconductor]

The immutable source is summarized in [[bq25619rtwr-datasheet]]. It remains historical design
evidence and is no longer in the fitted-component audit.
