g3ncl/scacchiera/Vault/Scacchiera/Wiki/entities/cl05b104ko5nnnc.md

---
type: entity
tags:
  - wiki/entity
  - wiki/component
date_updated: 2026-07-29
source_count: 1
---

# CL05B104KO5NNNC

Exact fitted component from Samsung Electro-Mechanics, used by lightbar C1 (100n), lightbar C2 (100n), lightbar C3 (100n), lightbar C4 (100n), lightbar C5 (100n), lightbar C6 (100n), lightbar C7 (100n), lightbar C8 (100n), lightbar C9 (100n), lightbar C10 (100n), lightbar C11 (100n), lightbar C12 (100n), lightbar C13 (100n), lightbar C14 (100n), matrix C65 (100n X7R 10%), matrix C66 (100n X7R 10%), matrix C1 (100n X7R 10%), matrix C5 (100n X7R 10%), matrix C9 (100n X7R 10%), matrix C13 (100n X7R 10%), matrix C17 (100n X7R 10%), matrix C21 (100n X7R 10%), matrix C25 (100n X7R 10%), matrix C29 (100n X7R 10%), matrix C33 (100n X7R 10%), matrix C37 (100n X7R 10%), matrix C41 (100n X7R 10%), matrix C45 (100n X7R 10%), matrix C49 (100n X7R 10%), matrix C53 (100n X7R 10%), matrix C57 (100n X7R 10%), matrix C61 (100n X7R 10%), hub C38 (100n), hub C39 (100n), hub C15 (100n), hub C16 (100n), hub C17 (100n), hub C18 (100n), hub C1 (100n), hub C10 (100n), hub C11 (100n), hub C28 (100n), hub C21 (100n), hub C22 (100n), hub C23 (100n), hub C26 (100n), power C21 (100n 16V), power C1 (100n 16V), power C2 (100n 16V), power C20 (100n 16V), power C10 (100n 16V), power C11 (100n 16V), power C12 (100n 16V), power C16 (100n 16V).

[mpn::CL05B104KO5NNNC] [supplier::JLCPCB]
[order_code::C1525] [category::capacitor]

The immutable source is summarized in [[cl05b104ko5nnnc-datasheet]]. The complete
library, rating, availability, and model audit is machine checked from
`docs/verification/v1-components.yaml`.
