g3ncl/scacchiera/Vault/Scacchiera/Wiki/entities/cl10a105kb8nnnc.md

---
type: entity
tags:
  - wiki/entity
  - wiki/component
date_updated: 2026-07-29
source_count: 1
---

# CL10A105KB8NNNC

Exact fitted component from Samsung Electro-Mechanics, used by hub C13 (1u 50V), hub C6 (1u), power C3 (1u 25V), power C17 (1u 25V).

[mpn::CL10A105KB8NNNC] [supplier::JLCPCB]
[order_code::C15849] [category::capacitor]

The immutable source is summarized in [[cl10a105kb8nnnc-datasheet]]. The complete
library, rating, availability, and model audit is machine checked from
`docs/verification/v1-components.yaml`.
