g3ncl/scacchiera/Vault/Scacchiera/Wiki/entities/cl10a225ko8nnnc.md

---
type: entity
tags:
  - wiki/entity
  - wiki/component
date_updated: 2026-07-29
source_count: 1
---

# CL10A225KO8NNNC

Exact fitted component from Samsung Electro-Mechanics, used by hub C25 (2.2u 16V), power C9 (2.2u 16V).

[mpn::CL10A225KO8NNNC] [supplier::JLCPCB]
[order_code::C23630] [category::capacitor]

The immutable source is summarized in [[cl10a225ko8nnnc-datasheet]]. The complete
library, rating, availability, and model audit is machine checked from
`docs/verification/v1-components.yaml`.
