g3ncl/scacchiera/Vault/Scacchiera/Wiki/entities/cl21a106kaynnne.md

---
type: entity
tags:
  - wiki/entity
  - wiki/component
date_updated: 2026-07-29
source_count: 1
---

# CL21A106KAYNNNE

Exact fitted component from Samsung Electro-Mechanics, used by hub C14 (10u 25V), hub C2 (10u 25V), hub C27 (10u 25V), power C8 (10u 25V).

[mpn::CL21A106KAYNNNE] [supplier::JLCPCB]
[order_code::C15850] [category::capacitor]

The immutable source is summarized in [[cl21a106kaynnne-datasheet]]. The complete
library, rating, availability, and model audit is machine checked from
`docs/verification/v1-components.yaml`.
