g3ncl/scacchiera/Vault/Scacchiera/Wiki/entities/cl21a226maqnnne.md

---
type: entity
tags:
  - wiki/entity
  - wiki/component
date_updated: 2026-07-29
source_count: 1
---

# CL21A226MAQNNNE

Exact fitted component from Samsung Electro-Mechanics, used by hub C3 (22u 25V), hub C4 (22u 25V), power C7 (22u 25V), power C15 (22u 25V), power C18 (22u 25V), power C19 (22u 25V), power C22 (22u 25V).

[mpn::CL21A226MAQNNNE] [supplier::JLCPCB]
[order_code::C45783] [category::capacitor]

The immutable source is summarized in [[cl21a226maqnnne-datasheet]]. The complete
library, rating, availability, and model audit is machine checked from
`docs/verification/v1-components.yaml`.

The power boost now uses C18, C19, and C22 in parallel. Its minimum-capacitance corner combines initial tolerance, the published X5R temperature limit, and a 50 percent DC-bias sensitivity bound. The filed sheet gives no part-specific DC-bias curve or 500 kHz ESR limit, so those remain explicit V8 measurements rather than V3 claims.
