g3ncl/scacchiera/Vault/Scacchiera/Wiki/entities/cl21a475kaqnnne.md

---
type: entity
tags:
  - wiki/entity
  - wiki/component
date_updated: 2026-07-29
source_count: 1
---

# CL21A475KAQNNNE

Exact fitted component from Samsung Electro-Mechanics, used by power C4 (4.7u 25V), power C5 (4.7u 25V), power C14 (4.7u 25V), power C6 (4.7u 25V).

[mpn::CL21A475KAQNNNE] [supplier::JLCPCB]
[order_code::C1779] [category::capacitor]

The immutable source is summarized in [[cl21a475kaqnnne-datasheet]]. The complete
library, rating, availability, and model audit is machine checked from
`docs/verification/v1-components.yaml`.
