g3ncl/scacchiera/Vault/Scacchiera/Wiki/entities/sm07b-ghs-tb-lf-sn.md

---
type: entity
tags:
  - wiki/entity
  - wiki/component
date_updated: 2026-07-29
source_count: 1
---

# SM07B-GHS-TB(LF)(SN)

Exact fitted component from JST, used by matrix J1 (SM07B-GHS-TB), hub J2 (SM07B-GHS-TB(LF)(SN)), hub J4 (SM07B-GHS-TB(LF)(SN)), hub J5 (SM07B-GHS-TB(LF)(SN)), hub J6 (SM07B-GHS-TB(LF)(SN)), power J1 (SM07B-GHS-TB(LF)(SN)).

[mpn::SM07B-GHS-TB(LF)(SN)] [supplier::JLCPCB]
[order_code::C495552] [category::connector]

The immutable source is summarized in [[sm07b-ghs-tb-lf-sn-datasheet]]. The complete
library, rating, availability, and model audit is machine checked from
`docs/verification/v1-components.yaml`.
