g3ncl/scacchiera/Vault/Scacchiera/Wiki/sources/0402b223k500nt-datasheet.md

---
type: source-summary
tags:
  - wiki/source
  - wiki/component
date_updated: 2026-07-29
source_file: "Datasheets/0402B223K500NT_C1532.pdf"
source_title: "0402B223K500NT manufacturer datasheet"
publisher: "Fenghua Advanced Technology"
---

# 0402B223K500NT datasheet

This source binds [0402B223K500NT](../entities/0402b223k500nt.md) to supplier order
code `C1532`. It is used by power C13 (22n 50V).

[mpn::0402B223K500NT] [order_code::C1532]
[manufacturer::Fenghua Advanced Technology] [footprint::Capacitor_SMD:C_0402_1005Metric]

## Design facts reviewed

- Library proof: manufacturer pin and package drawing checked against the SKiDL pin numbers, KiCad pad numbers, polarity, top assembly side and KiCad zero-degree orientation.
- Ratings used by the design: capacitance, tolerance, rated voltage, dielectric, temperature range, DC-bias behavior where published and package dimensions.
- Exact selected limits: 22 nF plus or minus 10 percent, 50 V, X7R with plus or minus 15 percent temperature change from minus 55 to 125 degrees Celsius, 0402 package and nickel-barrier termination.
- Datasheet locator: part-number, characteristics and dimensions tables.
- Simulation treatment: analytical, valid only for
  initial tolerance and X7R temperature change are data-sheet bounded; error-amplifier transconductance is a plus or minus 30 percent sensitivity because TI gives no limits.
- Conflicts: none open. Any later catalog or document mismatch reopens V1.
