g3ncl/scacchiera/Vault/Scacchiera/Wiki/sources/0603waf1000t5e-datasheet.md

---
type: source-summary
tags:
  - wiki/source
  - wiki/component
date_updated: 2026-07-29
source_file: "Datasheets/0603WAF1000T5E_C22775.pdf"
source_title: "0603WAF1000T5E manufacturer datasheet"
publisher: "UNI-ROYAL"
---

# 0603WAF1000T5E datasheet

This source binds [0603WAF1000T5E](../entities/0603waf1000t5e.md) to supplier order
code `C22775`. It is used by hub R27 (100R), hub R28 (100R), power R12 (100R 1%), power R13 (100R 1%).

[mpn::0603WAF1000T5E] [order_code::C22775]
[manufacturer::UNI-ROYAL] [footprint::Resistor_SMD:R_0603_1608Metric]

## Design facts reviewed

- Library proof: manufacturer pin and package drawing checked against the SKiDL pin numbers, KiCad pad numbers, polarity, top assembly side and KiCad zero-degree orientation.
- Ratings used by the design: value, tolerance, rated power, maximum working voltage, temperature coefficient, operating temperature and package dimensions.
- Exact selected limits: See the filed data sheet and structured audit..
- Datasheet locator: ratings, dimensions and part-number tables.
- Simulation treatment: analytical, valid only for
  lumped model with datasheet tolerance, bias, ESR, DCR and temperature corners.
- Conflicts: none open. Any later catalog or document mismatch reopens V1.
