g3ncl/scacchiera/Vault/Scacchiera/Wiki/sources/430450200-datasheet.md

---
type: source-summary
tags:
  - wiki/source
  - wiki/component
date_updated: 2026-07-29
source_file: "Datasheets/430450200_C122431.md"
source_title: "430450200 manufacturer datasheet"
publisher: "Molex"
---

# 430450200 datasheet

This source binds [430450200](../entities/430450200.md) to supplier order
code `C122431`. It is used by power J3 (430450200).

[mpn::430450200] [order_code::C122431]
[manufacturer::Molex] [footprint::Connector_Molex:Molex_Micro-Fit_3.0_43045-0200_2x01_P3.00mm_Horizontal]

## Design facts reviewed

- Library proof: manufacturer pin and package drawing checked against the SKiDL pin numbers, KiCad pad numbers, polarity, top assembly side and KiCad zero-degree orientation.
- Ratings used by the design: pin numbering, current, voltage, contact resistance, temperature, mating direction and package dimensions.
- Exact selected limits: two circuits, 8.5 A maximum per contact, 600 V, minus 40 to 105 degrees Celsius, right-angle through-hole Micro-Fit 3.0 header.
- Datasheet locator: ratings, ordering information and dimensional drawing.
- Simulation treatment: layout_derived, valid only for
  contact and interconnect parasitics derived from rated contacts and routed geometry.
- Conflicts: none open. Any later catalog or document mismatch reopens V1.
