g3ncl/scacchiera/Vault/Scacchiera/Wiki/sources/430450800-datasheet.md

---
type: source-summary
tags:
  - wiki/source
  - wiki/component
date_updated: 2026-07-29
source_file: "Datasheets/430450800_C122422.md"
source_title: "430450800 manufacturer datasheet"
publisher: "Molex"
---

# 430450800 datasheet

This source binds [430450800](../entities/430450800.md) to supplier order
code `C122422`. It is used by hub J3 (430450800), power J2 (430450800).

[mpn::430450800] [order_code::C122422]
[manufacturer::Molex] [footprint::Connector_Molex:Molex_Micro-Fit_3.0_43045-0800_2x04_P3.00mm_Horizontal]

## Design facts reviewed

- Library proof: manufacturer pin and package drawing checked against the SKiDL pin numbers, KiCad pad numbers, polarity, top assembly side and KiCad zero-degree orientation.
- Ratings used by the design: pin numbering, current, voltage, contact resistance, temperature, mating direction and package dimensions.
- Exact selected limits: eight circuits, 8.5 A maximum per contact, 600 V, minus 40 to 105 degrees Celsius, right-angle through-hole Micro-Fit 3.0 header.
- Datasheet locator: ratings, ordering information and dimensional drawing.
- Simulation treatment: layout_derived, valid only for
  contact and interconnect parasitics derived from rated contacts and routed geometry.
- Conflicts: none open. Any later catalog or document mismatch reopens V1.
