g3ncl/scacchiera/Vault/Scacchiera/Wiki/sources/b2b-ph-k-s-lf-sn-datasheet.md

---
type: source-summary
tags:
  - wiki/source
  - wiki/component
date_updated: 2026-07-29
source_file: "Datasheets/B2B-PH-K-S-LF-SN_C131337.pdf"
source_title: "B2B-PH-K-S(LF)(SN) manufacturer datasheet"
publisher: "JST"
---

# B2B-PH-K-S(LF)(SN) datasheet

This source binds [B2B-PH-K-S(LF)(SN)](../entities/b2b-ph-k-s-lf-sn.md) to supplier order
code `C131337`. It is used by power J3 (B2B-PH-K-S(LF)(SN)).

[mpn::B2B-PH-K-S(LF)(SN)] [order_code::C131337]
[manufacturer::JST] [footprint::Connector_JST:JST_PH_B2B-PH-K_1x02_P2.00mm_Vertical]

## Design facts reviewed

- Library proof: manufacturer pin and package drawing checked against the SKiDL pin numbers, KiCad pad numbers, polarity, top assembly side and KiCad zero-degree orientation.
- Ratings used by the design: pin numbering, current, voltage, contact resistance, temperature, mating direction and package dimensions.
- Exact selected limits: See the filed data sheet and structured audit..
- Datasheet locator: ratings, ordering information and dimensional drawing.
- Simulation treatment: layout_derived, valid only for
  contact and interconnect parasitics derived from rated contacts and routed geometry.
- Conflicts: none open. Any later catalog or document mismatch reopens V1.
