g3ncl/scacchiera/Vault/Scacchiera/Wiki/sources/bq25895rtwr-datasheet.md

---
type: source-summary
tags:
  - wiki/source
  - wiki/component
date_updated: 2026-07-31
source_file: "Datasheets/BQ25895RTWR_C80200.pdf"
source_title: "BQ25895RTWR manufacturer datasheet"
publisher: "Texas Instruments"
---

# BQ25895RTWR datasheet

This source binds [BQ25895RTWR](../entities/bq25895rtwr.md) to supplier order
code `C80200`. It is used by power U1 (BQ25895RTWR).

[mpn::BQ25895RTWR] [order_code::C80200]
[manufacturer::Texas Instruments] [footprint::Package_DFN_QFN:Texas_RTW_WQFN-24-1EP_4x4mm_P0.5mm_EP2.7x2.7mm]

## Design facts reviewed

- Library proof: manufacturer pin and package drawing checked against the SKiDL pin numbers, KiCad pad numbers, polarity, top assembly side and KiCad zero-degree orientation.
- Ratings used by the design: pinout, no-connect and exposed-pad treatment, recommended operating range, absolute maximum voltage, current, power and temperature, startup state, thermal data and package.
- Exact selected limits: 3.9 to 14 V input operating range, 5 A charge-current capability, NVDC power path, 6 A continuous and 9 A one-second battery discharge path, 19 mOhm maximum BATFET resistance over temperature, 9 A overcurrent threshold and RTW WQFN-24 pinout.
- Datasheet locator: pin description, absolute maximum, recommended operation, electrical, thermal and package tables.
- Simulation treatment: datasheet_bounded, valid only for
  no distributable vendor ngspice model was identified; V3 may use only parameters enumerated in this part's filed datasheet and must sweep their full published limits; digital protocol behavior belongs to V6.
- Conflicts: none open. Any later catalog or document mismatch reopens V1.

## Thermal data, read 2026-07-31

The Thermal Information table gives theta-JA as 31.8 degrees Celsius per watt for the RTW
WQFN-24 package, and the Absolute Maximum table puts the junction limit at 150 degrees.
