g3ncl/scacchiera/Vault/Scacchiera/Wiki/sources/cl05b104ko5nnnc-datasheet.md

---
type: source-summary
tags:
  - wiki/source
  - wiki/component
date_updated: 2026-07-29
source_file: "Datasheets/CL05B104KO5NNNC_C1525_manufacturer.pdf"
source_title: "CL05B104KO5NNNC manufacturer datasheet"
publisher: "Samsung Electro-Mechanics"
---

# CL05B104KO5NNNC datasheet

This source binds [CL05B104KO5NNNC](../entities/cl05b104ko5nnnc.md) to supplier order
code `C1525`. It is used by lightbar C1 (100n), lightbar C2 (100n), lightbar C3 (100n), lightbar C4 (100n), lightbar C5 (100n), lightbar C6 (100n), lightbar C7 (100n), lightbar C8 (100n), lightbar C9 (100n), lightbar C10 (100n), lightbar C11 (100n), lightbar C12 (100n), lightbar C13 (100n), lightbar C14 (100n), matrix C65 (100n X7R 10%), matrix C66 (100n X7R 10%), matrix C1 (100n X7R 10%), matrix C5 (100n X7R 10%), matrix C9 (100n X7R 10%), matrix C13 (100n X7R 10%), matrix C17 (100n X7R 10%), matrix C21 (100n X7R 10%), matrix C25 (100n X7R 10%), matrix C29 (100n X7R 10%), matrix C33 (100n X7R 10%), matrix C37 (100n X7R 10%), matrix C41 (100n X7R 10%), matrix C45 (100n X7R 10%), matrix C49 (100n X7R 10%), matrix C53 (100n X7R 10%), matrix C57 (100n X7R 10%), matrix C61 (100n X7R 10%), hub C38 (100n), hub C39 (100n), hub C15 (100n), hub C16 (100n), hub C17 (100n), hub C18 (100n), hub C1 (100n), hub C10 (100n), hub C11 (100n), hub C28 (100n), hub C21 (100n), hub C22 (100n), hub C23 (100n), hub C26 (100n), power C21 (100n 16V), power C1 (100n 16V), power C2 (100n 16V), power C20 (100n 16V), power C10 (100n 16V), power C11 (100n 16V), power C12 (100n 16V), power C16 (100n 16V).

[mpn::CL05B104KO5NNNC] [order_code::C1525]
[manufacturer::Samsung Electro-Mechanics] [footprint::Capacitor_SMD:C_0402_1005Metric]

## Design facts reviewed

- Library proof: manufacturer pin and package drawing checked against the SKiDL pin numbers, KiCad pad numbers, polarity, top assembly side and KiCad zero-degree orientation.
- Ratings used by the design: capacitance, tolerance, rated voltage, dielectric, temperature range, DC-bias behavior where published and package dimensions.
- Exact selected limits: See the filed data sheet and structured audit..
- Datasheet locator: part-number, characteristics and dimensions tables.
- Simulation treatment: analytical, valid only for
  lumped model with datasheet tolerance, bias, ESR, DCR and temperature corners.
- Conflicts: none open. Any later catalog or document mismatch reopens V1.
