g3ncl/scacchiera/Vault/Scacchiera/Wiki/sources/cl10a105kb8nnnc-datasheet.md

---
type: source-summary
tags:
  - wiki/source
  - wiki/component
date_updated: 2026-07-29
source_file: "Datasheets/CL10A105KB8NNNC_C15849_manufacturer.pdf"
source_title: "CL10A105KB8NNNC manufacturer datasheet"
publisher: "Samsung Electro-Mechanics"
---

# CL10A105KB8NNNC datasheet

This source binds [CL10A105KB8NNNC](../entities/cl10a105kb8nnnc.md) to supplier order
code `C15849`. It is used by hub C13 (1u 50V), hub C6 (1u), power C3 (1u 25V), power C17 (1u 25V).

[mpn::CL10A105KB8NNNC] [order_code::C15849]
[manufacturer::Samsung Electro-Mechanics] [footprint::Capacitor_SMD:C_0603_1608Metric]

## Design facts reviewed

- Library proof: manufacturer pin and package drawing checked against the SKiDL pin numbers, KiCad pad numbers, polarity, top assembly side and KiCad zero-degree orientation.
- Ratings used by the design: capacitance, tolerance, rated voltage, dielectric, temperature range, DC-bias behavior where published and package dimensions.
- Exact selected limits: See the filed data sheet and structured audit..
- Datasheet locator: part-number, characteristics and dimensions tables.
- Simulation treatment: analytical, valid only for
  lumped model with datasheet tolerance, bias, ESR, DCR and temperature corners.
- Conflicts: none open. Any later catalog or document mismatch reopens V1.
