g3ncl/scacchiera/Vault/Scacchiera/Wiki/sources/cl10a225ko8nnnc-datasheet.md

---
type: source-summary
tags:
  - wiki/source
  - wiki/component
date_updated: 2026-07-29
source_file: "Datasheets/CL10A225KO8NNNC_C23630_manufacturer.pdf"
source_title: "CL10A225KO8NNNC manufacturer datasheet"
publisher: "Samsung Electro-Mechanics"
---

# CL10A225KO8NNNC datasheet

This source binds [CL10A225KO8NNNC](../entities/cl10a225ko8nnnc.md) to supplier order
code `C23630`. It is used by hub C25 (2.2u 16V), power C9 (2.2u 16V).

[mpn::CL10A225KO8NNNC] [order_code::C23630]
[manufacturer::Samsung Electro-Mechanics] [footprint::Capacitor_SMD:C_0603_1608Metric]

## Design facts reviewed

- Library proof: manufacturer pin and package drawing checked against the SKiDL pin numbers, KiCad pad numbers, polarity, top assembly side and KiCad zero-degree orientation.
- Ratings used by the design: capacitance, tolerance, rated voltage, dielectric, temperature range, DC-bias behavior where published and package dimensions.
- Exact selected limits: See the filed data sheet and structured audit..
- Datasheet locator: part-number, characteristics and dimensions tables.
- Simulation treatment: analytical, valid only for
  lumped model with datasheet tolerance, bias, ESR, DCR and temperature corners.
- Conflicts: none open. Any later catalog or document mismatch reopens V1.
