g3ncl/scacchiera/Vault/Scacchiera/Wiki/sources/cl21a226maqnnne-datasheet.md

---
type: source-summary
tags:
  - wiki/source
  - wiki/component
date_updated: 2026-07-29
source_file: "Datasheets/CL21A226MAQNNNE_C45783_manufacturer.pdf"
source_title: "CL21A226MAQNNNE manufacturer datasheet"
publisher: "Samsung Electro-Mechanics"
---

# CL21A226MAQNNNE datasheet

This source binds [CL21A226MAQNNNE](../entities/cl21a226maqnnne.md) to supplier order
code `C45783`. It is used by hub C3 (22u 25V), hub C4 (22u 25V), power C7 (22u 25V), power C15 (22u 25V), power C18 (22u 25V), power C19 (22u 25V), power C22 (22u 25V).

[mpn::CL21A226MAQNNNE] [order_code::C45783]
[manufacturer::Samsung Electro-Mechanics] [footprint::Capacitor_SMD:C_0805_2012Metric]

## Design facts reviewed

- Library proof: manufacturer pin and package drawing checked against the SKiDL pin numbers, KiCad pad numbers, polarity, top assembly side and KiCad zero-degree orientation.
- Ratings used by the design: capacitance, tolerance, rated voltage, dielectric, temperature range, DC-bias behavior where published and package dimensions.
- Exact selected limits: 22 uF plus or minus 20 percent, 25 V, X5R from minus 55 to 85 degrees Celsius with capacitance change within plus or minus 15 percent, and 0.1 maximum dissipation factor measured at 120 Hz.
- Datasheet locator: part-number, characteristics and dimensions tables.
- Simulation treatment: analytical, valid only for
  initial tolerance and X5R temperature change are datasheet-bounded; the 50 percent DC-bias value is a sensitivity bound, and 500 kHz ESR remains open.
- Conflicts: none open. Any later catalog or document mismatch reopens V1.
