g3ncl/scacchiera/Vault/Scacchiera/Wiki/sources/cl21a475kaqnnne-datasheet.md

---
type: source-summary
tags:
  - wiki/source
  - wiki/component
date_updated: 2026-07-29
source_file: "Datasheets/CL21A475KAQNNNE_C1779_manufacturer.pdf"
source_title: "CL21A475KAQNNNE manufacturer datasheet"
publisher: "Samsung Electro-Mechanics"
---

# CL21A475KAQNNNE datasheet

This source binds [CL21A475KAQNNNE](../entities/cl21a475kaqnnne.md) to supplier order
code `C1779`. It is used by power C4 (4.7u 25V), power C5 (4.7u 25V), power C14 (4.7u 25V), power C6 (4.7u 25V).

[mpn::CL21A475KAQNNNE] [order_code::C1779]
[manufacturer::Samsung Electro-Mechanics] [footprint::Capacitor_SMD:C_0805_2012Metric]

## Design facts reviewed

- Library proof: manufacturer pin and package drawing checked against the SKiDL pin numbers, KiCad pad numbers, polarity, top assembly side and KiCad zero-degree orientation.
- Ratings used by the design: capacitance, tolerance, rated voltage, dielectric, temperature range, DC-bias behavior where published and package dimensions.
- Exact selected limits: See the filed data sheet and structured audit..
- Datasheet locator: part-number, characteristics and dimensions tables.
- Simulation treatment: analytical, valid only for
  lumped model with datasheet tolerance, bias, ESR, DCR and temperature corners.
- Conflicts: none open. Any later catalog or document mismatch reopens V1.
