g3ncl/scacchiera/Vault/Scacchiera/Wiki/sources/dfe252012f-1r0m-p2-datasheet.md

---
type: source-summary
tags:
  - wiki/source
  - wiki/component
date_updated: 2026-07-29
source_file: "Datasheets/DFE252012F-1R0M-P2_C435392.pdf"
source_title: "DFE252012F-1R0M=P2 manufacturer datasheet"
publisher: "Murata"
---

# DFE252012F-1R0M=P2 datasheet

This source binds [DFE252012F-1R0M=P2](../entities/dfe252012f-1r0m-p2.md) to supplier order
code `C435392`. It is used by power L1 (1uH).

[mpn::DFE252012F-1R0M=P2] [order_code::C435392]
[manufacturer::Murata] [footprint::Chessboard:DFE252012F]

## Design facts reviewed

- Library proof: manufacturer pin and package drawing checked against the SKiDL pin numbers, KiCad pad numbers, polarity, top assembly side and KiCad zero-degree orientation.
- Ratings used by the design: inductance, tolerance, rated or saturation current, DC resistance, self-resonance, temperature range and package dimensions.
- Exact selected limits: 1.0 uH plus or minus 20 percent, 40 mOhm maximum DCR, 4.7 A maximum inductance-decrease current, 3.3 A maximum 40 degree temperature-rise current, minus 40 to 125 degrees Celsius and 2.5 x 2.0 x 1.2 mm body.
- Datasheet locator: electrical characteristics, ratings and dimensions tables.
- Simulation treatment: analytical, valid only for
  lumped model with datasheet tolerance, bias, ESR, DCR and temperature corners.
- Conflicts: none open. Any later catalog or document mismatch reopens V1.
