g3ncl/scacchiera/Vault/Scacchiera/Wiki/sources/mcp73871t-2cci-ml-datasheet.md

---
type: source-summary
tags:
  - wiki/source
  - wiki/component
date_updated: 2026-07-29
source_file: "Datasheets/MCP73871T-2CCI-ML_C511310.pdf"
source_title: "MCP73871T-2CCI/ML manufacturer datasheet"
publisher: "Microchip Technology"
---

# MCP73871T-2CCI/ML datasheet

This source binds [MCP73871T-2CCI/ML](../entities/mcp73871t-2cci-ml.md) to supplier order
code `C511310`. It is used by power U1 (MCP73871T-2CCI/ML).

[mpn::MCP73871T-2CCI/ML] [order_code::C511310]
[manufacturer::Microchip Technology] [footprint::Package_DFN_QFN:QFN-20-1EP_4x4mm_P0.5mm_EP2.6x2.6mm]

## Design facts reviewed

- Library proof: manufacturer pin and package drawing checked against the SKiDL pin numbers, KiCad pad numbers, polarity, top assembly side and KiCad zero-degree orientation.
- Ratings used by the design: pinout, no-connect and exposed-pad treatment, recommended operating range, absolute maximum voltage, current, power and temperature, startup state, thermal data and package.
- Exact selected limits: 900 to 1100 mA fast charge with PROG1 at 1 kohm and SEL high, 75 to 125 mA termination with PROG3 at 10 kohm, 1.5 to 1.8 A adapter input limit, 1.23 V VPCC threshold plus or minus 3 percent, and 7 V absolute maximum input.
- Datasheet locator: pin description, absolute maximum, recommended operation, electrical, thermal and package tables.
- Simulation treatment: datasheet_bounded, valid only for
  no distributable vendor ngspice model was identified; V3 may use only parameters enumerated in this part's filed datasheet and must sweep their full published limits; digital protocol behavior belongs to V6.
- Conflicts: none open. Any later catalog or document mismatch reopens V1.
