g3ncl/scacchiera/Vault/Scacchiera/Wiki/sources/micro-fit-3-0-mating-evidence.md

---
type: source-summary
tags:
  - wiki/source
  - wiki/component
date_updated: 2026-08-01
source_file: Datasheets/MICRO-FIT-3.0-MATING_MOLEX.md
source_title: Molex Micro-Fit 3.0 mating-component manufacturer evidence
publisher: Molex
---

# Micro-Fit 3.0 mating evidence

The manufacturer specification maps the fitted series 43045 PCB headers to series 43025
receptacle housings and series 43030 female terminals. The selected housings are [[430250800]] for
the eight-circuit hub link and [[430250200]] for the two-circuit cell link. Both are locking,
polarized, dual-row, 3.00 mm-pitch nylon housings rated from minus 40 to plus 105 degrees Celsius.

The selected [[430300038]] terminal is tin-plated phosphor bronze for 18 AWG or 0.75 square
millimetre wire, with 1.85 mm maximum insulation diameter. Molex names hand tool 63828-0200 for
this terminal and wire range.

This source binds mating compatibility and the terminal wire range. It does not qualify wire type,
length, color coding, crimp workmanship, strain relief, or a complete assembled harness.

It also carries no current rating, which matters because the cell harness runs 5.871 A peak
through one [[430300038]] contact pair. Partially addressed on 2026-08-01 by
[[micro-fit-current-rating]], which files PS-43045 revision M1 and finds its table stopping at
20 AWG at 5 A with no 18 AWG row. That leaves the fitted terminal's rating unresolved rather than
established.
