g3ncl/scacchiera/Vault/Scacchiera/Wiki/sources/micro-fit-current-rating.md

---
type: source-summary
tags:
  - wiki/source
  - wiki/component
date_updated: 2026-08-01
source_file: "Datasheets/PS-43045-M1_MOLEX-VIA-OCTOPART.pdf"
source_title: "Molex PS-43045 Micro-Fit dual row connectors, product specification revision M1, 2007-11-21, bundled with the 43030-0006 terminal drawing"
publisher: "Molex, retrieved from an Octopart mirror"
---

# Micro-Fit 3.0 current rating

Fills the gap [[micro-fit-3-0-mating-evidence]] left open: that page binds mating compatibility and
the wire range and says in its own last line that it qualifies nothing else, so no current rating
stood behind the highest-current path in the product. It does not close the gap. See the provenance
warning below.

[document::PS-43045] [revision::M1] [date::2007-11-21]

## Ratings recorded

Section 4.2, current and applicable wires:

| AWG | Amps |
| --- | --- |
| 20 | 5 |
| 22 | 5 |
| 24 | 4 |
| 26 | 3 |
| 28 | 2 |
| 30 | 1 |

**The table stops at 20 AWG. This revision has no 18 AWG row.** Maximum outside insulation diameter
is 1.85 mm for 20 to 24 AWG, which matches the 1.85 mm already recorded for the bound
[[430300038]] terminal.

Section 4.2's own preamble: current depends on connector size, contact material, plating, ambient
temperature and board characteristics, and "actual current rating is application dependent and
should be evaluated for each application".

Section 4.3, temperature: -40 to +105 degrees Celsius operating, **including terminal temperature
rise**.

The bundled 43030-0006 terminal drawing states 250 V, **5.0 A maximum**, 10 milliohm maximum contact
resistance. That terminal is the 20 to 24 AWG variant, not the fitted 18 AWG one.
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
