g3ncl/scacchiera/Vault/Scacchiera/Wiki/sources/nr6045s4r7mt-datasheet.md

---
type: source-summary
tags:
  - wiki/source
  - wiki/component
date_updated: 2026-08-01
source_file: "Datasheets/NR6045S4R7MT_C42370396.pdf"
source_title: "NR6045S4R7MT manufacturer datasheet"
publisher: "Magnetsyc"
---

# NR6045S4R7MT datasheet

This source binds [NR6045S4R7MT](../entities/nr6045s4r7mt.md) to supplier order
code `C42370396`. It is used by hub L1 (4.7uH).

[mpn::NR6045S4R7MT] [order_code::C42370396]
[manufacturer::Magnetsyc] [footprint::Chessboard:NR6045S]
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
