g3ncl/scacchiera/Vault/Scacchiera/Clippings/jlcpcb/economic-parts-2026-08-02.csv

code | url | file | library | deleted | lastSeen | brand | model | package | type | describe | erpComponentName | price | stock | MOQ | category | firstSeen | pcbaMinQty | pcbaMinPrice
C10002 | TexasInstruments-LM2596SX_5_0NOPB/C10002 | https://www.lcsc.com/datasheet/lcsc_datasheet_2304140030_Texas-Instruments-LM2596SX-5-0-NOPB_C10002.pdf | expand | 0 | 2026-08-02 05:18:50 | Texas Instruments | LM2596SX-5.0/NOPB | TO-263-5 | DC-DC Converters | -40℃~+125℃@(TJ) 1 150kHz 3A 4.5V~40V 5V Buck Buck Built-in Fixed No TO-263-5 DC-DC Converters ROHS | 降压型 3A 4.5V~40V | 1.3555 | 13254 | 1 | Power Management (PMIC) | 2026-06-07 09:28:36 | 1 | 1.3555
C1002 | Sunlord-GZ1608D601TF/C1002 | https://www.lcsc.com/datasheet/lcsc_datasheet_2310301640_Sunlord-GZ1608D601TF_C1002.pdf | base | 0 | 2026-08-02 05:18:50 | Sunlord | GZ1608D601TF | 0603 | Ferrite Beads | -55℃~+125℃ 1 200mA 450mΩ 600Ω@100MHz ±25% 0603 Ferrite Beads ROHS | 单路 0603磁珠 阻抗600Ω@100MHz | 0.0188 | 863729 | 1 | Filters | 2026-06-07 09:28:36 | 20 | 0.376
C1015 | Sunlord-GZ2012D101TF/C1015 | https://www.lcsc.com/datasheet/lcsc_datasheet_2310301640_Sunlord-GZ2012D101TF_C1015.pdf | base | 0 | 2026-08-02 05:18:50 | Sunlord | GZ2012D101TF | 0805 | Ferrite Beads | 1 100Ω@100MHz 150mΩ 800mA ±25% 0805 Ferrite Beads ROHS | 单路 0805磁珠 阻抗100Ω@100MHz | 0.0276 | 2131472 | 1 | Filters | 2026-06-07 09:28:36 | 20 | 0.552
C1017 | Sunlord-GZ2012D601TF/C1017 | https://www.lcsc.com/datasheet/lcsc_datasheet_2310301640_Sunlord-GZ2012D601TF_C1017.pdf | base | 0 | 2026-08-02 05:18:50 | Sunlord | GZ2012D601TF | 0805 | Ferrite Beads | -55℃~+125℃ 1 300mΩ 500mA 600Ω@100MHz ±25% 0805 Ferrite Beads ROHS | 单路 0805磁珠 阻抗600Ω@100MHz | 0.0286 | 500064 | 1 | Filters | 2026-06-07 09:28:36 | 20 | 0.572
C1034 | Sunlord-SDFL1608Q4R7KTF/C1034 | https://www.lcsc.com/datasheet/lcsc_datasheet_2310301641_Sunlord-SDFL1608Q4R7KTF_C1034.pdf | expand | 0 | 2026-08-02 05:18:50 | Sunlord | SDFL1608Q4R7KTF | 0603 | Inductors (SMD) | 15mA 2.1Ω 33MHz 35@10MHz 4.7uH ±10% 0603 Inductors (SMD) ROHS | 4.7uH ±10% | 0.0207 | 76557 | 1 | Inductors, Coils, Chokes | 2026-06-07 09:28:36 | 20 | 0.414
C1035 | Sunlord-SDFL1608S100KTF/C1035 | https://www.lcsc.com/datasheet/lcsc_datasheet_2310301641_Sunlord-SDFL1608S100KTF_C1035.pdf | base | 0 | 2026-08-02 05:18:50 | Sunlord | SDFL1608S100KTF | 0603 | Inductors (SMD) | 1.85Ω 10uH 17MHz 30@2MHz 3mA ±10% 0603 Inductors (SMD) ROHS | 10uH ±10% | 0.0302 | 695304 | 1 | Inductors, Coils, Chokes | 2026-06-07 09:28:36 | 20 | 0.604
C1042 | Sunlord-SDFL2012Q1R0KTF/C1042 | https://www.lcsc.com/datasheet/lcsc_datasheet_2310301641_Sunlord-SDFL2012Q1R0KTF_C1042.pdf | expand | 0 | 2026-08-02 05:18:50 | Sunlord | SDFL2012Q1R0KTF | 0805 | Inductors (SMD) | 1uH 400mΩ 45@10MHz 50mA 75MHz Multilayer inductor ±10% 0805 Inductors (SMD) ROHS | 1uH ±10% | 0.0541 | 61451 | 1 | Inductors, Coils, Chokes | 2026-06-07 09:28:36 | 20 | 1.082
C1043 | 1395-CMI201209U2R2KT/C1043 | https://www.lcsc.com/datasheet/lcsc_datasheet_2302231101_FH--Guangdong-Fenghua-Advanced-Tech-CMI201209U2R2KT_C1043.pdf | expand | 0 | 2026-08-02 05:18:50 | FH (Guangdong Fenghua Advanced Tech) | CMI201209U2R2KT | 0805 | Inductors (SMD) | 2.2uH 35@10MHz 50MHz 50mA 600mΩ ±10% 0805 Inductors (SMD) ROHS | 2.2uH ±10% | 0.027 | 147888 | 1 | Inductors, Coils, Chokes | 2026-06-07 09:28:36 | 20 | 0.54
C1046 | Sunlord-SDFL2012S100KTF/C1046 | https://www.lcsc.com/datasheet/lcsc_datasheet_2310301641_Sunlord-SDFL2012S100KTF_C1046.pdf | base | 0 | 2026-08-02 05:18:50 | Sunlord | SDFL2012S100KTF | 0805 | Inductors (SMD) | 1.15Ω 10uH 15mA 24MHz 50@2MHz Multilayer inductor ±10% 0805 Inductors (SMD) ROHS | 10uH ±10% | 0.0556 | 138839 | 1 | Inductors, Coils, Chokes | 2026-06-07 09:28:36 | 20 | 1.112
C10487 | VishayIntertech-SI2301CDS_T1GE3/C10487 | https://www.lcsc.com/datasheet/lcsc_datasheet_1808272021_Vishay-Intertech-SI2301CDS-T1-GE3_C10487.pdf | base | 0 | 2026-08-02 05:18:50 | Vishay Intertech | SI2301CDS-T1-GE3 | SOT-23 | MOSFETs | -55℃~+150℃ 1 P-Channel 1.6W 10nC@4.5V 142mΩ@2.5V 1V 20V 3.1A 405pF 55pF 75pF P-Channel SOT-23 MOSFETs ROHS | SI2301CDS-T1-GE3 | 0.1054 | 254636 | 1 | Transistors/Thyristors | 2026-06-07 09:28:36 | 5 | 0.527
C1049 | 1401-CMI321609U4R7KT/C1049 | https://www.lcsc.com/datasheet/lcsc_datasheet_2302231101_FH--Guangdong-Fenghua-Advanced-Tech-CMI321609U4R7KT_C1049.pdf | expand | 0 | 2026-08-02 05:18:50 | FH (Guangdong Fenghua Advanced Tech) | CMI321609U4R7KT | 1206 | Inductors (SMD) | 25mA 35@10MHz 35MHz 4.7uH 650mΩ ±10% 1206 Inductors (SMD) ROHS | 4.7uH ±10% | 0.0478 | 34105 | 1 | Inductors, Coils, Chokes | 2026-06-07 09:28:36 | 20 | 0.956
C1051 | 1403-CMI321609X100KT/C1051 | https://www.lcsc.com/datasheet/lcsc_datasheet_2302231101_FH--Guangdong-Fenghua-Advanced-Tech-CMI321609X100KT_C1051.pdf | expand | 0 | 2026-08-02 05:18:50 | FH (Guangdong Fenghua Advanced Tech) | CMI321609X100KT | 1206 | Inductors (SMD) | 10uH 24MHz 25mA 35@2MHz 800mΩ ±10% 1206 Inductors (SMD) ROHS | 10uH ±10% | 0.0472 | 189309 | 1 | Inductors, Coils, Chokes | 2026-06-07 09:28:36 | 20 | 0.944
C105432 | 106647-S8550_RANGE_120_200/C105432 | https://www.lcsc.com/datasheet/lcsc_datasheet_2304140030_Jiangsu-Changjing-Electronics-Technology-Co---Ltd--S8550-RANGE-120-200_C105432.pdf | base | 0 | 2026-08-02 05:18:50 | Jiangsu Changjing Electronics Technology Co., Ltd. | S8550(RANGE:120-200) | SOT-23 | Bipolar (BJT) | -55℃~+150℃ 1 PNP 100nA 120 150MHz 25V 300mW 500mA 5V 600mV PNP SOT-23 Bipolar (BJT) ROHS | S8550(RANGE:120-200) | 0.0152 | 277232 | 1 | Transistors/Thyristors | 2026-06-07 09:28:36 | 10 | 0.152
C107045 | YAGEO-CC0603JRNPO9BN270/C107045 | https://www.lcsc.com/datasheet/lcsc_datasheet_2304140030_YAGEO-CC0603JRNPO9BN270_C107045.pdf | expand | 0 | 2026-08-02 05:18:50 | YAGEO | CC0603JRNPO9BN270 | 0603 | Multilayer Ceramic Capacitors MLCC - SMD/SMT | 27pF 50V NP0 ±5% 0603 Multilayer Ceramic Capacitors MLCC - SMD/SMT ROHS | 27pF ±5% 50V | 0.0087 | 606189 | 1 | Capacitors | 2026-06-07 09:28:36 | 20 | 0.174
C107110 | YAGEO-CC0805JRNPO9BN150/C107110 | https://www.lcsc.com/datasheet/lcsc_datasheet_2304140030_YAGEO-CC0805JRNPO9BN150_C107110.pdf | expand | 0 | 2026-08-02 05:18:50 | YAGEO | CC0805JRNPO9BN150 | 0805 | Multilayer Ceramic Capacitors MLCC - SMD/SMT | 15pF 50V NP0 ±5% 0805 Multilayer Ceramic Capacitors MLCC - SMD/SMT ROHS | 15pF ±5% 50V | 0.0181 | 209496 | 1 | Capacitors | 2026-06-07 09:28:36 | 20 | 0.362
C107114 | YAGEO-CC0805JRNPO9BN300/C107114 | https://www.lcsc.com/datasheet/lcsc_datasheet_2304140030_YAGEO-CC0805JRNPO9BN300_C107114.pdf | expand | 0 | 2026-08-02 05:18:50 | YAGEO | CC0805JRNPO9BN300 | 0805 | Multilayer Ceramic Capacitors MLCC - SMD/SMT | 30pF 50V NP0 ±5% 0805 Multilayer Ceramic Capacitors MLCC - SMD/SMT ROHS | 30pF ±5% 50V | 0.0186 | 266313 | 1 | Capacitors | 2026-06-07 09:28:36 | 20 | 0.372
C107115 | YAGEO-CC0805JRNPO9BN330/C107115 | https://www.lcsc.com/datasheet/lcsc_datasheet_2304140030_YAGEO-CC0805JRNPO9BN330_C107115.pdf | expand | 0 | 2026-08-02 05:18:50 | YAGEO | CC0805JRNPO9BN330 | 0805 | Multilayer Ceramic Capacitors MLCC - SMD/SMT | 33pF 50V NP0 ±5% 0805 Multilayer Ceramic Capacitors MLCC - SMD/SMT ROHS | 33pF ±5% 50V | 0.0183 | 725823 | 1 | Capacitors | 2026-06-07 09:28:36 | 20 | 0.366
C107145 | YAGEO-CC0805KRX7R9BB221/C107145 | https://www.lcsc.com/datasheet/lcsc_datasheet_2304140030_YAGEO-CC0805KRX7R9BB221_C107145.pdf | base | 0 | 2026-08-02 05:18:50 | YAGEO | CC0805KRX7R9BB221 | 0805 | Multilayer Ceramic Capacitors MLCC - SMD/SMT | 220pF 50V X7R ±10% 0805 Multilayer Ceramic Capacitors MLCC - SMD/SMT ROHS | 220pF ±10% 50V | 0.0162 | 1078669 | 1 | Capacitors | 2026-06-07 09:28:36 | 20 | 0.324
C109227 | LiteOn-LTV_817S_TA1C/C109227 | https://www.lcsc.com/datasheet/lcsc_datasheet_2304140030_Lite-On-LTV-817S-TA1-C_C109227.pdf | base | 0 | 2026-08-02 05:18:50 | Lite-On | LTV-817S-TA1-C | SMD-4P | Transistor, Photovoltaic Output Optoisolators | -30℃~+110℃ 1 1.2V 100mV@1mA,20mA 35V 3us 4us@2mA,100Ω 50% 50mA 50mA 5kV 600% 6V DC Phototransistor SMD-4P Transistor, Photovoltaic Output Optoisolators ROHS | DC输入 隔离电压(rms):5000V | 0.0752 | 231791 | 1 | Optoisolators | 2026-06-07 09:28:36 | 5 | 0.376
C112574 | 113807-X5032110592MSB2GI/C112574 | https://www.lcsc.com/datasheet/lcsc_datasheet_2403291504_YXC-Crystal-Oscillators-X5032110592MSB2GI_C112574.pdf | expand | 0 | 2026-08-02 05:18:50 | YXC Crystal Oscillators | X5032110592MSB2GI | SMD5032-2P | Crystals | -40℃~+85℃ 11.0592MHz 20pF Crystal Oscillator ±10ppm ±20ppm SMD5032-2P Crystals ROHS | YSX530GA 11.0592MHZ 2P 5032 20PF ±10PPM -40~85℃ (±20PPM) | 0.304 | 12039 | 1 | Crystals, Oscillators, Resonators | 2026-06-07 09:28:36 | 5 | 1.52
C115450 | LiteOn-LTV_217_BG/C115450 | https://www.lcsc.com/datasheet/lcsc_datasheet_1811092010_Lite-On-LTV-217-B-G_C115450.pdf | base | 0 | 2026-08-02 05:18:50 | Lite-On | LTV-217-B-G | SOP-4-175mil | Transistor, Photovoltaic Output Optoisolators | -55℃~+110℃ 1 1.2V 200mW 2us 3.75kV 3us 400mV@8mA,2.4mA 50% 50mA 50mA 600% 6V 70V DC Phototransistor SOP-4-175mil Transistor, Photovoltaic Output Optoisolators ROHS | DC输入 | 0.0962 | 288725 | 1 | Optoisolators | 2026-06-07 09:28:36 | 5 | 0.481
C115962 | YXC_CrystalOscillators-X50328MSB2GI/C115962 | https://www.lcsc.com/datasheet/lcsc_datasheet_2403291504_YXC-Crystal-Oscillators-X50328MSB2GI_C115962.pdf | base | 0 | 2026-08-02 05:18:50 | YXC Crystal Oscillators | X50328MSB2GI | SMD5032-2P | Crystals | -40℃~+85℃ 20pF 8MHz Crystal Oscillator ±10ppm ±20ppm SMD5032-2P Crystals ROHS | YSX530GA 8MHZ 2P 5032 20PF ±10PPM -40~85℃ (±20PPM) | 0.2447 | 269367 | 1 | Crystals, Oscillators, Resonators | 2026-06-07 09:28:36 | 5 | 1.2235
C11616 | 12170-0402WGF5103TCE/C11616 | https://www.lcsc.com/datasheet/lcsc_datasheet_2206010216_UNI-ROYAL-Uniroyal-Elec-0402WGF5103TCE_C11616.pdf | expand | 0 | 2026-08-02 05:18:50 | UNI-ROYAL(Uniroyal Elec) | 0402WGF5103TCE | 0402 | Chip Resistor - Surface Mount | -55℃~+155℃ 50V 510kΩ 62.5mW Thick Film Resistor ±1% ±100ppm/℃ 0402 Chip Resistor - Surface Mount ROHS | 510kΩ ±1% 62.5mW 厚膜电阻 | 0.0011 | 0 | 8142 | Resistors | 2026-06-07 09:28:36 | 8152 | 8.9672
C11702 | 12256-0402WGF1001TCE/C11702 | https://www.lcsc.com/datasheet/lcsc_datasheet_2206010216_UNI-ROYAL-Uniroyal-Elec-0402WGF1001TCE_C11702.pdf | base | 0 | 2026-08-02 05:18:50 | UNI-ROYAL(Uniroyal Elec) | 0402WGF1001TCE | 0402 | Chip Resistor - Surface Mount | -55℃~+155℃ 1kΩ 50V 62.5mW Thick Film Resistor ±1% ±100ppm/℃ 0402 Chip Resistor - Surface Mount ROHS | 1kΩ ±1% 62.5mW 厚膜电阻 | 0.0098 | 4085386 | 914 | Resistors | 2026-06-07 09:28:36 | 924 | 9.0552
C12044 | 12599-TP4057_42_SOT26R/C12044 | https://www.lcsc.com/datasheet/lcsc_datasheet_1811021622_TOPPOWER-Nanjing-Extension-Microelectronics-TP4057-42-SOT26-R_C12044.pdf | expand | 0 | 2026-08-02 05:18:50 | TOPPOWER(Nanjing Extension Microelectronics) | TP4057-42-SOT26-R | SOT-23-6 | Battery Management | -40℃~+85℃ 1 4.2V 40uA 4V~9V 500mA Charging IC Lithium Battery Not supported Not supported SOT-23-6 Battery Management ROHS | 500mA单节锂离子电池充电器 | 0.1527 | 54755 | 1 | Power Management (PMIC) | 2026-06-07 09:28:36 | 5 | 0.7635
C12084 | TexasInstruments-SN65HVD230DR/C12084 | https://www.lcsc.com/datasheet/lcsc_datasheet_2304140030_Texas-Instruments-SN65HVD230DR_C12084.pdf | expand | 0 | 2026-08-02 05:18:50 | Texas Instruments | SN65HVD230DR | SOIC-8 | CAN Transceivers | -40℃~+85℃ 17mA 1Mbps 370uA 3V~3.6V CAN Transceiver SOIC-8 CAN Transceivers ROHS | 3.3-V CAN 收发器 | 0.7245 | 77619 | 1 | Interface | 2026-06-07 09:28:36 | 1 | 0.7245
C12447 | 13081-0603WAF4022T5E/C12447 | https://www.lcsc.com/datasheet/lcsc_datasheet_2206010216_UNI-ROYAL-Uniroyal-Elec-0603WAF4022T5E_C12447.pdf | expand | 0 | 2026-08-02 05:18:50 | UNI-ROYAL(Uniroyal Elec) | 0603WAF4022T5E | 0603 | Chip Resistor - Surface Mount | -55℃~+155℃ 100mW 40.2kΩ 75V Thick Film Resistor ±1% ±100ppm/℃ 0603 Chip Resistor - Surface Mount ROHS | 40.2kΩ ±1% 100mW 厚膜电阻 | 0.0055 | 171864 | 1 | Resistors | 2026-06-07 09:28:36 | 20 | 0.11
C12530 | 13164-CL05A225MQ5NSNC/C12530 | https://www.lcsc.com/datasheet/lcsc_datasheet_2304140030_Samsung-Electro-Mechanics-CL05A225MQ5NSNC_C12530.pdf | base | 0 | 2026-08-02 05:18:50 | Samsung Electro-Mechanics | CL05A225MQ5NSNC | 0402 | Multilayer Ceramic Capacitors MLCC - SMD/SMT | 2.2uF 6.3V X5R ±20% 0402 Multilayer Ceramic Capacitors MLCC - SMD/SMT ROHS | 2.2uF ±20% 6.3V | 0.0064 | 8397129 | 1 | Capacitors | 2026-06-07 09:28:36 | 20 | 0.128
C12674 | YXC_CrystalOscillators-X49SM8MSD2SC/C12674 | https://www.lcsc.com/datasheet/lcsc_datasheet_2403291504_YXC-Crystal-Oscillators-X49SM8MSD2SC_C12674.pdf | base | 0 | 2026-08-02 05:18:50 | YXC Crystal Oscillators | X49SM8MSD2SC | HC-49S-SMD | Crystals | -20℃~+70℃ 20pF 8MHz Crystal Oscillator ±20ppm ±30ppm HC-49S-SMD Crystals ROHS | HC-49SMD 8MHZ 20PF ±20PPM -20~70℃（±30PPM） | 0.0975 | 144244 | 1 | Crystals, Oscillators, Resonators | 2026-06-07 09:28:36 | 2 | 0.195
C12891 | 13537-CL31A226KAHNNNE/C12891 | https://www.lcsc.com/datasheet/lcsc_datasheet_2304140030_Samsung-Electro-Mechanics-CL31A226KAHNNNE_C12891.pdf | base | 0 | 2026-08-02 05:18:50 | Samsung Electro-Mechanics | CL31A226KAHNNNE | 1206 | Multilayer Ceramic Capacitors MLCC - SMD/SMT | 22uF 25V X5R ±10% 1206 Multilayer Ceramic Capacitors MLCC - SMD/SMT ROHS | 22uF ±10% 25V | 0.3817 | 1083133 | 1 | Capacitors | 2026-06-07 09:28:36 | 5 | 1.9085
C13167 | 13814-0603WAF2701T5E/C13167 | https://www.lcsc.com/datasheet/lcsc_datasheet_2206010216_UNI-ROYAL-Uniroyal-Elec-0603WAF2701T5E_C13167.pdf | base | 0 | 2026-08-02 05:18:50 | UNI-ROYAL(Uniroyal Elec) | 0603WAF2701T5E | 0603 | Chip Resistor - Surface Mount | -55℃~+155℃ 100mW 2.7kΩ 75V Thick Film Resistor ±1% ±100ppm/℃ 0603 Chip Resistor - Surface Mount ROHS | 2.7kΩ ±1% 100mW 厚膜电阻 | 0.0029 | 745666 | 1 | Resistors | 2026-06-07 09:28:36 | 20 | 0.058
C1322360 | 1413077-0603B822K500NT/C1322360 | https://wmsc.lcsc.com/wmsc/upload/file/pdf/v2/lcsc/2304140030_FH--Guangdong-Fenghua-Advanced-Tech-0603B822K500NT_C1322360.pdf | base | 0 | 2026-08-02 05:18:50 | FH (Guangdong Fenghua Advanced Tech) | 0603B822K500NT | 0603 | Multilayer Ceramic Capacitors MLCC - SMD/SMT | 50V 8.2nF X7R ±10% 0603 Multilayer Ceramic Capacitors MLCC - SMD/SMT ROHS | 8.2nF ±10% 50V | 0.0073 | 103895 | 1 | Capacitors | 2026-06-07 09:28:36 | 20 | 0.146
C13320 | 13967-0603WAF5104T5E/C13320 | https://www.lcsc.com/datasheet/lcsc_datasheet_2206010216_UNI-ROYAL-Uniroyal-Elec-0603WAF5104T5E_C13320.pdf | expand | 0 | 2026-08-02 05:18:50 | UNI-ROYAL(Uniroyal Elec) | 0603WAF5104T5E | 0603 | Chip Resistor - Surface Mount | -55℃~+155℃ 100mW 5.1MΩ 75V Thick Film Resistor ±1% ±100ppm/℃ 0603 Chip Resistor - Surface Mount ROHS | 5.1MΩ ±1% 100mW 厚膜电阻 | 0.0085 | 235151 | 1 | Resistors | 2026-06-07 09:28:36 | 20 | 0.17
C13415 | Sunlord-SDCL1608C68NJTDF/C13415 | https://www.lcsc.com/datasheet/lcsc_datasheet_2310301641_Sunlord-SDCL1608C68NJTDF_C13415.pdf | expand | 0 | 2026-08-02 05:18:50 | Sunlord | SDCL1608C68NJTDF | 0603 | Inductors (SMD) | 12@100MHz 300mA 68nH 850mΩ 900MHz ±5% 0603 Inductors (SMD) ROHS | 68nH ±5% | 0.0267 | 115845 | 1 | Inductors, Coils, Chokes | 2026-06-07 09:28:36 | 20 | 0.534
C13482 | MaxLinear-SP3232EEY_LTR/C13482 | https://www.lcsc.com/datasheet/lcsc_datasheet_2408280932_MaxLinear-SP3232EEY-L-TR_C13482.pdf | base | 0 | 2026-08-02 05:18:50 | MaxLinear | SP3232EEY-L/TR | TSSOP-16 | RS232 ICs | -40℃~+85℃ 2 2 235Kbps 3V~5.5V Transceiver Yes ±15kV TSSOP-16 RS232 ICs ROHS | SP3232EEY-L/TR | 0.3592 | 161421 | 1 | Interface | 2026-06-07 09:28:36 | 5 | 1.796
C13533 | 14182-CL05C331JB5NNNC/C13533 | https://www.lcsc.com/datasheet/lcsc_datasheet_2304140030_Samsung-Electro-Mechanics-CL05C331JB5NNNC_C13533.pdf | expand | 0 | 2026-08-02 05:18:50 | Samsung Electro-Mechanics | CL05C331JB5NNNC | 0402 | Multilayer Ceramic Capacitors MLCC - SMD/SMT | 330pF 50V C0G ±5% 0402 Multilayer Ceramic Capacitors MLCC - SMD/SMT ROHS | 330pF ±5% 50V | 0.0062 | 362711 | 1 | Capacitors | 2026-06-07 09:28:36 | 20 | 0.124
C13585 | 14236-CL31A106KBHNNNE/C13585 | https://www.lcsc.com/datasheet/lcsc_datasheet_2304140030_Samsung-Electro-Mechanics-CL31A106KBHNNNE_C13585.pdf | base | 0 | 2026-08-02 05:18:50 | Samsung Electro-Mechanics | CL31A106KBHNNNE | 1206 | Multilayer Ceramic Capacitors MLCC - SMD/SMT | 10uF 50V X5R ±10% 1206 Multilayer Ceramic Capacitors MLCC - SMD/SMT ROHS | 10uF ±10% 50V | 0.2911 | 4657882 | 1 | Capacitors | 2026-06-07 09:28:36 | 5 | 1.4555
C13738 | YXC_CrystalOscillators-X322516MLB4SI/C13738 | https://www.lcsc.com/datasheet/lcsc_datasheet_2403291504_YXC-Crystal-Oscillators-X322516MLB4SI_C13738.pdf | base | 0 | 2026-08-02 05:18:50 | YXC Crystal Oscillators | X322516MLB4SI | SMD3225-4P | Crystals | -40℃~+85℃ 16MHz 9pF Crystal Oscillator ±10ppm ±20ppm SMD3225-4P Crystals ROHS | YSX321SL 16MHZ 4P 3225 9PF ±10PPM -40~85℃ (±20PPM) | 0.0928 | 124414 | 1 | Crystals, Oscillators, Resonators | 2026-06-07 09:28:36 | 5 | 0.464
C13967 | 14623-CL21B474KBFNNNE/C13967 | https://www.lcsc.com/datasheet/lcsc_datasheet_2304140030_Samsung-Electro-Mechanics-CL21B474KBFNNNE_C13967.pdf | base | 0 | 2026-08-02 05:18:50 | Samsung Electro-Mechanics | CL21B474KBFNNNE | 0805 | Multilayer Ceramic Capacitors MLCC - SMD/SMT | 470nF 50V X7R ±10% 0805 Multilayer Ceramic Capacitors MLCC - SMD/SMT ROHS | 470nF ±10% 50V | 0.0284 | 861139 | 1 | Capacitors | 2026-06-07 09:28:36 | 20 | 0.568
C14033 | Sunlord-SDCL1005C3N9STDF/C14033 | https://www.lcsc.com/datasheet/lcsc_datasheet_2310301641_Sunlord-SDCL1005C3N9STDF_C14033.pdf | expand | 0 | 2026-08-02 05:18:50 | Sunlord | SDCL1005C3N9STDF | 0402 | Inductors (SMD) | 200mΩ 3.9nH 300mA 4GHz 8@100MHz Multilayer inductor 0402 Inductors (SMD) ROHS | ±0.3nH 3.9nH | 0.005 | 161928 | 1 | Inductors, Coils, Chokes | 2026-06-07 09:28:36 | 20 | 0.1
C14289 | HoltekSemicon-HT75331/C14289 | https://www.lcsc.com/datasheet/lcsc_datasheet_2312191111_Holtek-Semicon-HT7533-1_C14289.pdf | base | 0 | 2026-08-02 05:18:50 | Holtek Semicon | HT7533-1 | SOT-89-3 | Voltage Regulators - Linear, Low Drop Out (LDO) Regulators | -40℃~+85℃@(Ta) 1 100mA 2.5uA 25mV@(1mA) 3.3V 30V Fixed Positive SOT-89-3 Voltage Regulators - Linear, Low Drop Out (LDO) Regulators ROHS | 3.3V 100mA 30V | 0.1424 | 216797 | 1 | Power Management (PMIC) | 2026-06-07 09:28:36 | 5 | 0.712
C14441 | 15103-CL05C680JB5NNNC/C14441 | https://www.lcsc.com/datasheet/lcsc_datasheet_2304140030_Samsung-Electro-Mechanics-CL05C680JB5NNNC_C14441.pdf | expand | 0 | 2026-08-02 05:18:50 | Samsung Electro-Mechanics | CL05C680JB5NNNC | 0402 | Multilayer Ceramic Capacitors MLCC - SMD/SMT | 50V 68pF C0G ±5% 0402 Multilayer Ceramic Capacitors MLCC - SMD/SMT ROHS | 68pF ±5% 50V | 0.0094 | 178824 | 1 | Capacitors | 2026-06-07 09:28:36 | 20 | 0.188
C14663 | YAGEO-CC0603KRX7R9BB104/C14663 | https://www.lcsc.com/datasheet/lcsc_datasheet_2211101700_YAGEO-CC0603KRX7R9BB104_C14663.pdf | base | 0 | 2026-08-02 05:18:50 | YAGEO | CC0603KRX7R9BB104 | 0603 | Multilayer Ceramic Capacitors MLCC - SMD/SMT | 100nF 50V X7R ±10% 0603 Multilayer Ceramic Capacitors MLCC - SMD/SMT ROHS | 100nF ±10% 50V | 0.0241 | 33208690 | 1 | Capacitors | 2026-06-07 09:28:36 | 20 | 0.482
C14709 | MurataElectronics-BLM18PG121SN1D/C14709 | https://www.lcsc.com/datasheet/lcsc_datasheet_2304140030_Murata-Electronics-BLM18PG121SN1D_C14709.pdf | base | 0 | 2026-08-02 05:18:50 | Murata Electronics | BLM18PG121SN1D | 0603 | Ferrite Beads | -55℃~+125℃ 1 120Ω@100MHz 2A 50mΩ ±25% 0603 Ferrite Beads ROHS | 单路 0603磁珠 阻抗120Ω@100MHz | 0.023 | 2872703 | 1 | Filters | 2026-06-07 09:28:36 | 20 | 0.46
C14857 | 15529-CL21C470JBANNNC/C14857 | https://www.lcsc.com/datasheet/lcsc_datasheet_2304140030_Samsung-Electro-Mechanics-CL21C470JBANNNC_C14857.pdf | base | 0 | 2026-08-02 05:18:50 | Samsung Electro-Mechanics | CL21C470JBANNNC | 0805 | Multilayer Ceramic Capacitors MLCC - SMD/SMT | 47pF 50V C0G ±5% 0805 Multilayer Ceramic Capacitors MLCC - SMD/SMT ROHS | 47pF ±5% 50V | 0.0199 | 221006 | 1 | Capacitors | 2026-06-07 09:28:36 | 20 | 0.398
C14858 | 15530-CL10C101JB8NNNC/C14858 | https://www.lcsc.com/datasheet/lcsc_datasheet_2304140030_Samsung-Electro-Mechanics-CL10C101JB8NNNC_C14858.pdf | base | 0 | 2026-08-02 05:18:50 | Samsung Electro-Mechanics | CL10C101JB8NNNC | 0603 | Multilayer Ceramic Capacitors MLCC - SMD/SMT | 100pF 50V C0G ±5% 0603 Multilayer Ceramic Capacitors MLCC - SMD/SMT ROHS | 100pF ±5% 50V | 0.0145 | 7111745 | 1 | Capacitors | 2026-06-07 09:28:36 | 20 | 0.29
C14877 | MicrochipTech-ATMEGA328PAU/C14877 | https://www.lcsc.com/datasheet/lcsc_datasheet_2410010303_Microchip-Tech-ATMEGA328P-AU_C14877.pdf | expand | 0 | 2026-08-02 05:18:50 | Microchip Tech | ATMEGA328P-AU | TQFP-32(7x7) | Microcontrollers (MCU/MPU/SOC) | -40℃~+85℃ 1.8V~5.5V 10bit 1KB 20MHz 23 2KB 32KB 8 Bit AVR Built-in FLASH TQFP-32(7x7) Microcontrollers (MCU/MPU/SOC) ROHS | 基于AVR增强型RISC架构的低功耗CMOS 8位微控制器 | 2.4156 | 23665 | 1 | Embedded Processors & Controllers | 2026-06-07 09:28:36 | 1 | 2.4156
C149504 | 160838-0805W8F1003T5E/C149504 | https://www.lcsc.com/datasheet/lcsc_datasheet_2205312316_UNI-ROYAL-Uniroyal-Elec-0805W8F1003T5E_C149504.pdf | base | 0 | 2026-08-02 05:18:50 | UNI-ROYAL(Uniroyal Elec) | 0805W8F1003T5E | 0805 | Chip Resistor - Surface Mount | -55℃~+155℃ 100kΩ 125mW 150V Thick Film Resistor ±1% ±100ppm/℃ 0805 Chip Resistor - Surface Mount ROHS | 100kΩ ±1% 125mW 厚膜电阻 | 0.0103 | 6208569 | 1 | Resistors | 2026-06-07 09:28:36 | 20 | 0.206
C14996 | MDD_Microdiode_Semiconductor-SS210/C14996 | https://www.lcsc.com/datasheet/lcsc_datasheet_2407101107_MDD-Microdiode-Semiconductor-SS210_C14996.pdf | base | 0 | 2026-08-02 05:18:50 | MDD(Microdiode Semiconductor) | SS210 | SMA(DO-214AC) | Schottky Diodes | -55℃~+150℃ 1 Independent 100V 2A 500uA@100V 850mV@2A SMA(DO-214AC) Schottky Diodes ROHS | SS210 | 0.032 | 1492372 | 1 | Diodes | 2026-06-07 09:28:36 | 9 | 0.288
C15008 | 15681-CL31A107MQHNNNE/C15008 | https://www.lcsc.com/datasheet/lcsc_datasheet_2304140030_Samsung-Electro-Mechanics-CL31A107MQHNNNE_C15008.pdf | base | 0 | 2026-08-02 05:18:50 | Samsung Electro-Mechanics | CL31A107MQHNNNE | 1206 | Multilayer Ceramic Capacitors MLCC - SMD/SMT | 100uF 6.3V X5R ±20% 1206 Multilayer Ceramic Capacitors MLCC - SMD/SMT ROHS | 100uF ±20% 6.3V | 0.2932 | 3004801 | 1 | Capacitors | 2026-06-07 09:28:36 | 5 | 1.466
C15127 | Alpha_OmegaSemicon-AO3401A/C15127 | https://www.lcsc.com/datasheet/lcsc_datasheet_2412061733_Alpha---Omega-Semicon-AO3401A_C15127.pdf | base | 0 | 2026-08-02 05:18:50 | Alpha & Omega Semicon | AO3401A | SOT-23 | MOSFETs | 1 P-Channel 14nC@10V 30V 47mΩ@10V、60mΩ@4.5V、85mΩ@2.5V 4A 55pF 645pF 80pF 900mV SOT-23 MOSFETs ROHS | AO3401A | 0.0991 | 723870 | 1 | Transistors/Thyristors | 2026-06-07 09:28:36 | 5 | 0.4955
C15195 | 15869-CL05B103KB5NNNC/C15195 | https://www.lcsc.com/datasheet/lcsc_datasheet_2304140030_Samsung-Electro-Mechanics-CL05B103KB5NNNC_C15195.pdf | base | 0 | 2026-08-02 05:18:50 | Samsung Electro-Mechanics | CL05B103KB5NNNC | 0402 | Multilayer Ceramic Capacitors MLCC - SMD/SMT | 10nF 50V X7R ±10% 0402 Multilayer Ceramic Capacitors MLCC - SMD/SMT ROHS | 10nF ±10% 50V | 0.0053 | 10617920 | 1 | Capacitors | 2026-06-07 09:28:36 | 20 | 0.106
C1523 | 1875-0402B102K500NT/C1523 | https://www.lcsc.com/datasheet/lcsc_datasheet_2304140030_FH--Guangdong-Fenghua-Advanced-Tech-0402B102K500NT_C1523.pdf | base | 0 | 2026-08-02 05:18:50 | FH (Guangdong Fenghua Advanced Tech) | 0402B102K500NT | 0402 | Multilayer Ceramic Capacitors MLCC - SMD/SMT | 1nF 50V X7R ±10% 0402 Multilayer Ceramic Capacitors MLCC - SMD/SMT ROHS | 1nF ±10% 50V | 0.01 | 5476521 | 1 | Capacitors | 2026-06-07 09:28:36 | 20 | 0.2
C1525 | 1877-CL05B104KO5NNNC/C1525 | https://www.lcsc.com/datasheet/lcsc_datasheet_2304140030_Samsung-Electro-Mechanics-CL05B104KO5NNNC_C1525.pdf | base | 0 | 2026-08-02 05:18:50 | Samsung Electro-Mechanics | CL05B104KO5NNNC | 0402 | Multilayer Ceramic Capacitors MLCC - SMD/SMT | 100nF 16V X7R ±10% 0402 Multilayer Ceramic Capacitors MLCC - SMD/SMT ROHS | 100nF ±10% 16V | 0.0054 | 46798324 | 1 | Capacitors | 2026-06-07 09:28:36 | 20 | 0.108
C1527 | 1879-0402B151K500NT/C1527 | https://www.lcsc.com/datasheet/lcsc_datasheet_2304140030_FH--Guangdong-Fenghua-Advanced-Tech-0402B151K500NT_C1527.pdf | expand | 0 | 2026-08-02 05:18:50 | FH (Guangdong Fenghua Advanced Tech) | 0402B151K500NT | 0402 | Multilayer Ceramic Capacitors MLCC - SMD/SMT | 150pF 50V X7R ±10% 0402 Multilayer Ceramic Capacitors MLCC - SMD/SMT ROHS | 150pF ±10% 50V | 0.0037 | 186297 | 1 | Capacitors | 2026-06-07 09:28:36 | 20 | 0.074
C1530 | 1882-0402B221K500NT/C1530 | https://www.lcsc.com/datasheet/lcsc_datasheet_2304140030_FH--Guangdong-Fenghua-Advanced-Tech-0402B221K500NT_C1530.pdf | base | 0 | 2026-08-02 05:18:50 | FH (Guangdong Fenghua Advanced Tech) | 0402B221K500NT | 0402 | Multilayer Ceramic Capacitors MLCC - SMD/SMT | 220pF 50V X7R ±10% 0402 Multilayer Ceramic Capacitors MLCC - SMD/SMT ROHS | 220pF ±10% 50V | 0.003 | 1539308 | 1 | Capacitors | 2026-06-07 09:28:36 | 20 | 0.06
C1531 | 1883-0402B222K500NT/C1531 | https://www.lcsc.com/datasheet/lcsc_datasheet_2304140030_FH--Guangdong-Fenghua-Advanced-Tech-0402B222K500NT_C1531.pdf | expand | 0 | 2026-08-02 05:18:50 | FH (Guangdong Fenghua Advanced Tech) | 0402B222K500NT | 0402 | Multilayer Ceramic Capacitors MLCC - SMD/SMT | 2.2nF 50V X7R ±10% 0402 Multilayer Ceramic Capacitors MLCC - SMD/SMT ROHS | 2.2nF ±10% 50V | 0.0018 | 980076 | 1 | Capacitors | 2026-06-07 09:28:36 | 20 | 0.036
C1532 | 1884-0402B223K500NT/C1532 | https://www.lcsc.com/datasheet/lcsc_datasheet_2304140030_FH--Guangdong-Fenghua-Advanced-Tech-0402B223K500NT_C1532.pdf | base | 0 | 2026-08-02 05:18:50 | FH (Guangdong Fenghua Advanced Tech) | 0402B223K500NT | 0402 | Multilayer Ceramic Capacitors MLCC - SMD/SMT | 22nF 50V X7R ±10% 0402 Multilayer Ceramic Capacitors MLCC - SMD/SMT ROHS | 22nF ±10% 50V | 0.0137 | 1051123 | 1 | Capacitors | 2026-06-07 09:28:36 | 20 | 0.274
C1537 | 1889-0402B471K500NT/C1537 | https://www.lcsc.com/datasheet/lcsc_datasheet_2304140030_FH--Guangdong-Fenghua-Advanced-Tech-0402B471K500NT_C1537.pdf | expand | 0 | 2026-08-02 05:18:50 | FH (Guangdong Fenghua Advanced Tech) | 0402B471K500NT | 0402 | Multilayer Ceramic Capacitors MLCC - SMD/SMT | 470pF 50V X7R ±10% 0402 Multilayer Ceramic Capacitors MLCC - SMD/SMT ROHS | 470pF ±10% 50V | 0.0075 | 1008323 | 1 | Capacitors | 2026-06-07 09:28:36 | 20 | 0.15
C1538 | 1890-0402B472K500NT/C1538 | https://www.lcsc.com/datasheet/lcsc_datasheet_2304140030_FH--Guangdong-Fenghua-Advanced-Tech-0402B472K500NT_C1538.pdf | base | 0 | 2026-08-02 05:18:50 | FH (Guangdong Fenghua Advanced Tech) | 0402B472K500NT | 0402 | Multilayer Ceramic Capacitors MLCC - SMD/SMT | 4.7nF 50V X7R ±10% 0402 Multilayer Ceramic Capacitors MLCC - SMD/SMT ROHS | 4.7nF ±10% 50V | 0.0079 | 724105 | 1 | Capacitors | 2026-06-07 09:28:36 | 20 | 0.158
C1542 | 1894-0402B682K500NT/C1542 | https://www.lcsc.com/datasheet/lcsc_datasheet_2304140030_FH--Guangdong-Fenghua-Advanced-Tech-0402B682K500NT_C1542.pdf | expand | 0 | 2026-08-02 05:18:50 | FH (Guangdong Fenghua Advanced Tech) | 0402B682K500NT | 0402 | Multilayer Ceramic Capacitors MLCC - SMD/SMT | 50V 6.8nF X7R ±10% 0402 Multilayer Ceramic Capacitors MLCC - SMD/SMT ROHS | 6.8nF ±10% 50V | 0.0083 | 219291 | 1 | Capacitors | 2026-06-07 09:28:36 | 20 | 0.166
C1546 | 1898-0402CG101J500NT/C1546 | https://www.lcsc.com/datasheet/lcsc_datasheet_2304140030_FH--Guangdong-Fenghua-Advanced-Tech-0402CG101J500NT_C1546.pdf | base | 0 | 2026-08-02 05:18:50 | FH (Guangdong Fenghua Advanced Tech) | 0402CG101J500NT | 0402 | Multilayer Ceramic Capacitors MLCC - SMD/SMT | 100pF 50V C0G ±5% 0402 Multilayer Ceramic Capacitors MLCC - SMD/SMT ROHS | 100pF ±5% 50V | 0.0079 | 6139620 | 1 | Capacitors | 2026-06-07 09:28:36 | 20 | 0.158
C1547 | 1899-0402CG120J500NT/C1547 | https://www.lcsc.com/datasheet/lcsc_datasheet_2304140030_FH--Guangdong-Fenghua-Advanced-Tech-0402CG120J500NT_C1547.pdf | base | 0 | 2026-08-02 05:18:50 | FH (Guangdong Fenghua Advanced Tech) | 0402CG120J500NT | 0402 | Multilayer Ceramic Capacitors MLCC - SMD/SMT | 12pF 50V C0G ±5% 0402 Multilayer Ceramic Capacitors MLCC - SMD/SMT ROHS | 12pF ±5% 50V | 0.0113 | 2478448 | 1 | Capacitors | 2026-06-07 09:28:36 | 20 | 0.226
C1548 | 1900-0402CG150J500NT/C1548 | https://www.lcsc.com/datasheet/lcsc_datasheet_2304140030_FH--Guangdong-Fenghua-Advanced-Tech-0402CG150J500NT_C1548.pdf | base | 0 | 2026-08-02 05:18:50 | FH (Guangdong Fenghua Advanced Tech) | 0402CG150J500NT | 0402 | Multilayer Ceramic Capacitors MLCC - SMD/SMT | 15pF 50V C0G ±5% 0402 Multilayer Ceramic Capacitors MLCC - SMD/SMT ROHS | 15pF ±5% 50V | 0.0047 | 2353414 | 1 | Capacitors | 2026-06-07 09:28:36 | 20 | 0.094
C1549 | 1901-0402CG180J500NT/C1549 | https://www.lcsc.com/datasheet/lcsc_datasheet_2304140030_FH--Guangdong-Fenghua-Advanced-Tech-0402CG180J500NT_C1549.pdf | base | 0 | 2026-08-02 05:18:50 | FH (Guangdong Fenghua Advanced Tech) | 0402CG180J500NT | 0402 | Multilayer Ceramic Capacitors MLCC - SMD/SMT | 18pF 50V C0G ±5% 0402 Multilayer Ceramic Capacitors MLCC - SMD/SMT ROHS | 18pF ±5% 50V | 0.0054 | 1570075 | 1 | Capacitors | 2026-06-07 09:28:36 | 20 | 0.108
C1550 | 1902-0402CG1R0C500NT/C1550 | https://www.lcsc.com/datasheet/lcsc_datasheet_2304140030_FH--Guangdong-Fenghua-Advanced-Tech-0402CG1R0C500NT_C1550.pdf | expand | 0 | 2026-08-02 05:18:50 | FH (Guangdong Fenghua Advanced Tech) | 0402CG1R0C500NT | 0402 | Multilayer Ceramic Capacitors MLCC - SMD/SMT | 1pF 50V C0G 0402 Multilayer Ceramic Capacitors MLCC - SMD/SMT ROHS | ±0.25pF 1pF 50V | 0.0049 | 1194031 | 1 | Capacitors | 2026-06-07 09:28:36 | 20 | 0.098
C1552 | 1904-0402CG1R5C500NT/C1552 | https://www.lcsc.com/datasheet/lcsc_datasheet_2304140030_FH--Guangdong-Fenghua-Advanced-Tech-0402CG1R5C500NT_C1552.pdf | expand | 0 | 2026-08-02 05:18:50 | FH (Guangdong Fenghua Advanced Tech) | 0402CG1R5C500NT | 0402 | Multilayer Ceramic Capacitors MLCC - SMD/SMT | 1.5pF 50V C0G 0402 Multilayer Ceramic Capacitors MLCC - SMD/SMT ROHS | ±0.25pF 1.5pF 50V | 0.0056 | 325011 | 1 | Capacitors | 2026-06-07 09:28:36 | 20 | 0.112
C15525 | 16204-CL05A106MQ5NUNC/C15525 | https://www.lcsc.com/datasheet/lcsc_datasheet_2208231630_Samsung-Electro-Mechanics-CL05A106MQ5NUNC_C15525.pdf | base | 0 | 2026-08-02 05:18:50 | Samsung Electro-Mechanics | CL05A106MQ5NUNC | 0402 | Multilayer Ceramic Capacitors MLCC - SMD/SMT | 10uF 6.3V X5R ±20% 0402 Multilayer Ceramic Capacitors MLCC - SMD/SMT ROHS | 10uF ±20% 6.3V | 0.0281 | 12882471 | 1 | Capacitors | 2026-06-07 09:28:36 | 20 | 0.562
C1554 | 1906-0402CG200J500NT/C1554 | https://www.lcsc.com/datasheet/lcsc_datasheet_2304140030_FH--Guangdong-Fenghua-Advanced-Tech-0402CG200J500NT_C1554.pdf | base | 0 | 2026-08-02 05:18:50 | FH (Guangdong Fenghua Advanced Tech) | 0402CG200J500NT | 0402 | Multilayer Ceramic Capacitors MLCC - SMD/SMT | 20pF 50V C0G ±5% 0402 Multilayer Ceramic Capacitors MLCC - SMD/SMT ROHS | 20pF ±5% 50V | 0.0135 | 1489105 | 1 | Capacitors | 2026-06-07 09:28:36 | 20 | 0.27
C1555 | 1907-0402CG220J500NT/C1555 | https://www.lcsc.com/datasheet/lcsc_datasheet_2304140030_FH--Guangdong-Fenghua-Advanced-Tech-0402CG220J500NT_C1555.pdf | base | 0 | 2026-08-02 05:18:50 | FH (Guangdong Fenghua Advanced Tech) | 0402CG220J500NT | 0402 | Multilayer Ceramic Capacitors MLCC - SMD/SMT | 22pF 50V C0G ±5% 0402 Multilayer Ceramic Capacitors MLCC - SMD/SMT ROHS | 22pF ±5% 50V | 0.0087 | 3048635 | 1 | Capacitors | 2026-06-07 09:28:36 | 20 | 0.174
C1557 | 1909-0402CG270J500NT/C1557 | https://www.lcsc.com/datasheet/lcsc_datasheet_2304140030_FH--Guangdong-Fenghua-Advanced-Tech-0402CG270J500NT_C1557.pdf | expand | 0 | 2026-08-02 05:18:50 | FH (Guangdong Fenghua Advanced Tech) | 0402CG270J500NT | 0402 | Multilayer Ceramic Capacitors MLCC - SMD/SMT | 27pF 50V C0G ±5% 0402 Multilayer Ceramic Capacitors MLCC - SMD/SMT ROHS | 27pF ±5% 50V | 0.0036 | 638873 | 1 | Capacitors | 2026-06-07 09:28:36 | 20 | 0.072
C1559 | 1911-0402CG2R2C500NT/C1559 | https://www.lcsc.com/datasheet/lcsc_datasheet_2304140030_FH--Guangdong-Fenghua-Advanced-Tech-0402CG2R2C500NT_C1559.pdf | expand | 0 | 2026-08-02 05:18:50 | FH (Guangdong Fenghua Advanced Tech) | 0402CG2R2C500NT | 0402 | Multilayer Ceramic Capacitors MLCC - SMD/SMT | 2.2pF 50V C0G 0402 Multilayer Ceramic Capacitors MLCC - SMD/SMT ROHS | ±0.25pF 2.2pF 50V | 0.0051 | 336652 | 1 | Capacitors | 2026-06-07 09:28:36 | 20 | 0.102
C1561 | 1913-0402CG2R7C500NT/C1561 | https://www.lcsc.com/datasheet/lcsc_datasheet_2304140030_FH--Guangdong-Fenghua-Advanced-Tech-0402CG2R7C500NT_C1561.pdf | expand | 0 | 2026-08-02 05:18:50 | FH (Guangdong Fenghua Advanced Tech) | 0402CG2R7C500NT | 0402 | Multilayer Ceramic Capacitors MLCC - SMD/SMT | 2.7pF 50V C0G 0402 Multilayer Ceramic Capacitors MLCC - SMD/SMT ROHS | ±0.25pF 2.7pF 50V | 0.0032 | 141703 | 1 | Capacitors | 2026-06-07 09:28:36 | 20 | 0.064
C1562 | 1914-0402CG330J500NT/C1562 | https://www.lcsc.com/datasheet/lcsc_datasheet_2304140030_FH--Guangdong-Fenghua-Advanced-Tech-0402CG330J500NT_C1562.pdf | base | 0 | 2026-08-02 05:18:50 | FH (Guangdong Fenghua Advanced Tech) | 0402CG330J500NT | 0402 | Multilayer Ceramic Capacitors MLCC - SMD/SMT | 33pF 50V C0G ±5% 0402 Multilayer Ceramic Capacitors MLCC - SMD/SMT ROHS | 33pF ±5% 50V | 0.0117 | 1753625 | 1 | Capacitors | 2026-06-07 09:28:36 | 20 | 0.234
C1565 | 1917-0402CG3R3C500NT/C1565 | https://www.lcsc.com/datasheet/lcsc_datasheet_2304140030_FH--Guangdong-Fenghua-Advanced-Tech-0402CG3R3C500NT_C1565.pdf | expand | 0 | 2026-08-02 05:18:50 | FH (Guangdong Fenghua Advanced Tech) | 0402CG3R3C500NT | 0402 | Multilayer Ceramic Capacitors MLCC - SMD/SMT | 3.3pF 50V C0G 0402 Multilayer Ceramic Capacitors MLCC - SMD/SMT ROHS | ±0.25pF 3.3pF 50V | 0.004 | 255731 | 1 | Capacitors | 2026-06-07 09:28:36 | 20 | 0.08
C1567 | 1919-0402CG470J500NT/C1567 | https://www.lcsc.com/datasheet/lcsc_datasheet_2304140030_FH--Guangdong-Fenghua-Advanced-Tech-0402CG470J500NT_C1567.pdf | base | 0 | 2026-08-02 05:18:50 | FH (Guangdong Fenghua Advanced Tech) | 0402CG470J500NT | 0402 | Multilayer Ceramic Capacitors MLCC - SMD/SMT | 47pF 50V C0G ±5% 0402 Multilayer Ceramic Capacitors MLCC - SMD/SMT ROHS | 47pF ±5% 50V | 0.0152 | 1148301 | 1 | Capacitors | 2026-06-07 09:28:36 | 20 | 0.304
C1569 | 1921-0402CG4R7C500NT/C1569 | https://www.lcsc.com/datasheet/lcsc_datasheet_2304140030_FH--Guangdong-Fenghua-Advanced-Tech-0402CG4R7C500NT_C1569.pdf | expand | 0 | 2026-08-02 05:18:50 | FH (Guangdong Fenghua Advanced Tech) | 0402CG4R7C500NT | 0402 | Multilayer Ceramic Capacitors MLCC - SMD/SMT | 4.7pF 50V C0G 0402 Multilayer Ceramic Capacitors MLCC - SMD/SMT ROHS | ±0.25pF 4.7pF 50V | 0.0112 | 835422 | 1 | Capacitors | 2026-06-07 09:28:36 | 20 | 0.224
C1570 | 1922-0402CG300J500NT/C1570 | https://www.lcsc.com/datasheet/lcsc_datasheet_2304140030_FH--Guangdong-Fenghua-Advanced-Tech-0402CG300J500NT_C1570.pdf | expand | 0 | 2026-08-02 05:18:50 | FH (Guangdong Fenghua Advanced Tech) | 0402CG300J500NT | 0402 | Multilayer Ceramic Capacitors MLCC - SMD/SMT | 30pF 50V C0G ±5% 0402 Multilayer Ceramic Capacitors MLCC - SMD/SMT ROHS | 30pF ±5% 50V | 0.0041 | 365333 | 1 | Capacitors | 2026-06-07 09:28:36 | 20 | 0.082
C1576 | 1928-0402CG6R8C500NT/C1576 | https://www.lcsc.com/datasheet/lcsc_datasheet_2304140030_FH--Guangdong-Fenghua-Advanced-Tech-0402CG6R8C500NT_C1576.pdf | expand | 0 | 2026-08-02 05:18:50 | FH (Guangdong Fenghua Advanced Tech) | 0402CG6R8C500NT | 0402 | Multilayer Ceramic Capacitors MLCC - SMD/SMT | 50V 6.8pF C0G 0402 Multilayer Ceramic Capacitors MLCC - SMD/SMT ROHS | ±0.25pF 6.8pF 50V | 0.0067 | 297314 | 1 | Capacitors | 2026-06-07 09:28:36 | 20 | 0.134
C15849 | 16531-CL10A105KB8NNNC/C15849 | https://www.lcsc.com/datasheet/lcsc_datasheet_2304140030_Samsung-Electro-Mechanics-CL10A105KB8NNNC_C15849.pdf | base | 0 | 2026-08-02 05:18:50 | Samsung Electro-Mechanics | CL10A105KB8NNNC | 0603 | Multilayer Ceramic Capacitors MLCC - SMD/SMT | 1uF 50V X5R ±10% 0603 Multilayer Ceramic Capacitors MLCC - SMD/SMT ROHS | 1uF ±10% 50V | 0.0154 | 14248556 | 1 | Capacitors | 2026-06-07 09:28:36 | 20 | 0.308
C1585 | 1937-0402F333M500NT/C1585 | https://www.lcsc.com/datasheet/lcsc_datasheet_2304140030_FH--Guangdong-Fenghua-Advanced-Tech-0402F333M500NT_C1585.pdf | expand | 0 | 2026-08-02 05:18:50 | FH (Guangdong Fenghua Advanced Tech) | 0402F333M500NT | 0402 | Multilayer Ceramic Capacitors MLCC - SMD/SMT | 33nF 50V Y5V ±20% 0402 Multilayer Ceramic Capacitors MLCC - SMD/SMT ROHS | 停产 33nF ±20% 50V | 0.0031 | 0 | 1 | Capacitors | 2026-06-07 09:28:36 | 20 | 0.062
C15850 | 16532-CL21A106KAYNNNE/C15850 | https://www.lcsc.com/datasheet/lcsc_datasheet_2304140030_Samsung-Electro-Mechanics-CL21A106KAYNNNE_C15850.pdf | base | 0 | 2026-08-02 05:18:50 | Samsung Electro-Mechanics | CL21A106KAYNNNE | 0805 | Multilayer Ceramic Capacitors MLCC - SMD/SMT | 10uF 25V X5R ±10% 0805 Multilayer Ceramic Capacitors MLCC - SMD/SMT ROHS | 10uF ±10% 25V | 0.1044 | 11293715 | 1 | Capacitors | 2026-06-07 09:28:36 | 20 | 2.088
C15879 | onsemi-SMF05CT1G/C15879 | https://www.lcsc.com/datasheet/lcsc_datasheet_1810311712_onsemi-SMF05CT1G_C15879.pdf | expand | 0 | 2026-08-02 05:18:50 | onsemi | SMF05CT1G | SC-88 | ESD and Surge Protection (TVS/ESD) | -40℃~+125℃ 100W@8/20us 12.5V 5 5V 7.2V 70nA 80pF 8A@8/20us IEC 61000-4-2 TVS SC-88 ESD and Surge Protection (TVS/ESD) ROHS | TVS 5V截止 峰值浪涌电流：8A@8/20us | 0.1396 | 54171 | 1 | Circuit Protection | 2026-06-07 09:28:36 | 5 | 0.698
C1588 | 1940-CL10B102KB8NNNC/C1588 | https://www.lcsc.com/datasheet/lcsc_datasheet_2304140030_Samsung-Electro-Mechanics-CL10B102KB8NNNC_C1588.pdf | base | 0 | 2026-08-02 05:18:50 | Samsung Electro-Mechanics | CL10B102KB8NNNC | 0603 | Multilayer Ceramic Capacitors MLCC - SMD/SMT | 1nF 50V X7R ±10% 0603 Multilayer Ceramic Capacitors MLCC - SMD/SMT ROHS | 1nF ±10% 50V | 0.0072 | 7101557 | 1 | Capacitors | 2026-06-07 09:28:36 | 20 | 0.144
C1594 | 1946-0603B151K500NT/C1594 | https://www.lcsc.com/datasheet/lcsc_datasheet_2304140030_FH--Guangdong-Fenghua-Advanced-Tech-0603B151K500NT_C1594.pdf | base | 0 | 2026-08-02 05:18:50 | FH (Guangdong Fenghua Advanced Tech) | 0603B151K500NT | 0603 | Multilayer Ceramic Capacitors MLCC - SMD/SMT | 150pF 50V X7R ±10% 0603 Multilayer Ceramic Capacitors MLCC - SMD/SMT ROHS | 150pF ±10% 50V | 0.0113 | 332533 | 1 | Capacitors | 2026-06-07 09:28:36 | 20 | 0.226
C1595 | 1947-0603B152K500NT/C1595 | https://www.lcsc.com/datasheet/lcsc_datasheet_2304140030_FH--Guangdong-Fenghua-Advanced-Tech-0603B152K500NT_C1595.pdf | expand | 0 | 2026-08-02 05:18:50 | FH (Guangdong Fenghua Advanced Tech) | 0603B152K500NT | 0603 | Multilayer Ceramic Capacitors MLCC - SMD/SMT | 1.5nF 50V X7R ±10% 0603 Multilayer Ceramic Capacitors MLCC - SMD/SMT ROHS | 1.5nF ±10% 50V | 0.0075 | 216394 | 1 | Capacitors | 2026-06-07 09:28:36 | 20 | 0.15
C1596 | 1948-0603B153K500NT/C1596 | https://www.lcsc.com/datasheet/lcsc_datasheet_2304140030_FH--Guangdong-Fenghua-Advanced-Tech-0603B153K500NT_C1596.pdf | expand | 0 | 2026-08-02 05:18:50 | FH (Guangdong Fenghua Advanced Tech) | 0603B153K500NT | 0603 | Multilayer Ceramic Capacitors MLCC - SMD/SMT | 15nF 50V X7R ±10% 0603 Multilayer Ceramic Capacitors MLCC - SMD/SMT ROHS | 15nF ±10% 50V | 0.0117 | 71488 | 1 | Capacitors | 2026-06-07 09:28:36 | 20 | 0.234
C1600 | 1952-0603B201K500NT/C1600 | https://www.lcsc.com/datasheet/lcsc_datasheet_2304140030_FH--Guangdong-Fenghua-Advanced-Tech-0603B201K500NT_C1600.pdf | expand | 0 | 2026-08-02 05:18:50 | FH (Guangdong Fenghua Advanced Tech) | 0603B201K500NT | 0603 | Multilayer Ceramic Capacitors MLCC - SMD/SMT | 200pF 50V X7R ±10% 0603 Multilayer Ceramic Capacitors MLCC - SMD/SMT ROHS | 200pF ±10% 50V | 0.0163 | 41484 | 1 | Capacitors | 2026-06-07 09:28:36 | 20 | 0.326
C1603 | 1955-CL10B221KB8NNNC/C1603 | https://www.lcsc.com/datasheet/lcsc_datasheet_2304140030_Samsung-Electro-Mechanics-CL10B221KB8NNNC_C1603.pdf | base | 0 | 2026-08-02 05:18:50 | Samsung Electro-Mechanics | CL10B221KB8NNNC | 0603 | Multilayer Ceramic Capacitors MLCC - SMD/SMT | 220pF 50V X7R ±10% 0603 Multilayer Ceramic Capacitors MLCC - SMD/SMT ROHS | 220pF ±10% 50V | 0.0079 | 1284344 | 1 | Capacitors | 2026-06-07 09:28:36 | 20 | 0.158
C1604 | 1956-0603B222K500NT/C1604 | https://www.lcsc.com/datasheet/lcsc_datasheet_2304140030_FH--Guangdong-Fenghua-Advanced-Tech-0603B222K500NT_C1604.pdf | base | 0 | 2026-08-02 05:18:50 | FH (Guangdong Fenghua Advanced Tech) | 0603B222K500NT | 0603 | Multilayer Ceramic Capacitors MLCC - SMD/SMT | 2.2nF 50V X7R ±10% 0603 Multilayer Ceramic Capacitors MLCC - SMD/SMT ROHS | 2.2nF ±10% 50V | 0.0159 | 1790239 | 1 | Capacitors | 2026-06-07 09:28:36 | 20 | 0.318
C1609 | 1961-0603B272K500NT/C1609 | https://www.lcsc.com/datasheet/lcsc_datasheet_2304140030_FH--Guangdong-Fenghua-Advanced-Tech-0603B272K500NT_C1609.pdf | expand | 0 | 2026-08-02 05:18:50 | FH (Guangdong Fenghua Advanced Tech) | 0603B272K500NT | 0603 | Multilayer Ceramic Capacitors MLCC - SMD/SMT | 2.7nF 50V X7R ±10% 0603 Multilayer Ceramic Capacitors MLCC - SMD/SMT ROHS | 2.7nF ±10% 50V | 0.0093 | 133680 | 1 | Capacitors | 2026-06-07 09:28:36 | 20 | 0.186
C16106 | HoltekSemicon-HT75501/C16106 | https://www.lcsc.com/datasheet/lcsc_datasheet_2404031722_Holtek-Semicon-HT7550-1_C16106.pdf | expand | 0 | 2026-08-02 05:18:50 | Holtek Semicon | HT7550-1 | SOT-89-3 | Voltage Regulators - Linear, Low Drop Out (LDO) Regulators | -40℃~+85℃@(Ta) 1 150mA 2.5uA 25mV@(1mA) 30V 5V Fixed Positive SOT-89-3 Voltage Regulators - Linear, Low Drop Out (LDO) Regulators ROHS | 5V 150mA 30V | 0.1337 | 197461 | 1 | Power Management (PMIC) | 2026-06-07 09:28:36 | 5 | 0.6685
C1613 | 1965-CL10B332KB8NNNC/C1613 | https://www.lcsc.com/datasheet/lcsc_datasheet_2304140030_Samsung-Electro-Mechanics-CL10B332KB8NNNC_C1613.pdf | base | 0 | 2026-08-02 05:18:50 | Samsung Electro-Mechanics | CL10B332KB8NNNC | 0603 | Multilayer Ceramic Capacitors MLCC - SMD/SMT | 3.3nF 50V X7R ±10% 0603 Multilayer Ceramic Capacitors MLCC - SMD/SMT ROHS | 3.3nF ±10% 50V | 0.0065 | 471240 | 1 | Capacitors | 2026-06-07 09:28:36 | 20 | 0.13
C16133 | -TAJB107K006RNJ/C16133 | https://www.lcsc.com/datasheet/lcsc_datasheet_2111161030_Kyocera-AVX-TAJB107K006RNJ_C16133.pdf | base | 0 | 2026-08-02 05:18:50 | -- | TAJB107K006RNJ | CASE-B-3528-21(mm) | Tantalum Capacitors | -55℃~+125℃ 1.7Ω@100kHz 100uF 6.3V ±10% CASE-B-3528-21(mm) Tantalum Capacitors ROHS | 100uF ±10% 6.3V | 0.2779 | 475542 | 1 | Capacitors | 2026-06-07 09:28:36 | 5 | 1.3895
C1615 | 1967-0603B334K250NT/C1615 | https://www.lcsc.com/datasheet/lcsc_datasheet_2304140030_FH--Guangdong-Fenghua-Advanced-Tech-0603B334K250NT_C1615.pdf | expand | 0 | 2026-08-02 05:18:50 | FH (Guangdong Fenghua Advanced Tech) | 0603B334K250NT | 0603 | Multilayer Ceramic Capacitors MLCC - SMD/SMT | 25V 330nF X7R ±10% 0603 Multilayer Ceramic Capacitors MLCC - SMD/SMT ROHS | 330nF ±10% 25V | 0.0222 | 208770 | 1 | Capacitors | 2026-06-07 09:28:36 | 20 | 0.444
C1620 | 1972-0603B471K500NT/C1620 | https://www.lcsc.com/datasheet/lcsc_datasheet_2304140030_FH--Guangdong-Fenghua-Advanced-Tech-0603B471K500NT_C1620.pdf | base | 0 | 2026-08-02 05:18:50 | FH (Guangdong Fenghua Advanced Tech) | 0603B471K500NT | 0603 | Multilayer Ceramic Capacitors MLCC - SMD/SMT | 470pF 50V X7R ±10% 0603 Multilayer Ceramic Capacitors MLCC - SMD/SMT ROHS | 470pF ±10% 50V | 0.0158 | 1564714 | 1 | Capacitors | 2026-06-07 09:28:36 | 20 | 0.316
C1622 | 1974-CL10B473KB8NNNC/C1622 | https://www.lcsc.com/datasheet/lcsc_datasheet_2304140030_Samsung-Electro-Mechanics-CL10B473KB8NNNC_C1622.pdf | base | 0 | 2026-08-02 05:18:50 | Samsung Electro-Mechanics | CL10B473KB8NNNC | 0603 | Multilayer Ceramic Capacitors MLCC - SMD/SMT | 47nF 50V X7R ±10% 0603 Multilayer Ceramic Capacitors MLCC - SMD/SMT ROHS | 47nF ±10% 50V | 0.0137 | 1461713 | 1 | Capacitors | 2026-06-07 09:28:36 | 20 | 0.274
C1623 | 1975-CL10B474KA8NNNC/C1623 | https://www.lcsc.com/datasheet/lcsc_datasheet_2304140030_Samsung-Electro-Mechanics-CL10B474KA8NNNC_C1623.pdf | base | 0 | 2026-08-02 05:18:50 | Samsung Electro-Mechanics | CL10B474KA8NNNC | 0603 | Multilayer Ceramic Capacitors MLCC - SMD/SMT | 25V 470nF X7R ±10% 0603 Multilayer Ceramic Capacitors MLCC - SMD/SMT ROHS | 470nF ±10% 25V | 0.0241 | 4097414 | 1 | Capacitors | 2026-06-07 09:28:36 | 20 | 0.482
C1630 | 1982-0603B681K500NT/C1630 | https://www.lcsc.com/datasheet/lcsc_datasheet_2304140030_FH--Guangdong-Fenghua-Advanced-Tech-0603B681K500NT_C1630.pdf | expand | 0 | 2026-08-02 05:18:50 | FH (Guangdong Fenghua Advanced Tech) | 0603B681K500NT | 0603 | Multilayer Ceramic Capacitors MLCC - SMD/SMT | 50V 680pF X7R ±10% 0603 Multilayer Ceramic Capacitors MLCC - SMD/SMT ROHS | 680pF ±10% 50V | 0.0091 | 163509 | 1 | Capacitors | 2026-06-07 09:28:36 | 20 | 0.182
C1631 | 1983-0603B682K500NT/C1631 | https://www.lcsc.com/datasheet/lcsc_datasheet_2304140030_FH--Guangdong-Fenghua-Advanced-Tech-0603B682K500NT_C1631.pdf | base | 0 | 2026-08-02 05:18:50 | FH (Guangdong Fenghua Advanced Tech) | 0603B682K500NT | 0603 | Multilayer Ceramic Capacitors MLCC - SMD/SMT | 50V 6.8nF X7R ±10% 0603 Multilayer Ceramic Capacitors MLCC - SMD/SMT ROHS | 6.8nF ±10% 50V | 0.0109 | 323666 | 1 | Capacitors | 2026-06-07 09:28:36 | 20 | 0.218
C1634 | 1986-CL10C100JB8NNNC/C1634 | https://www.lcsc.com/datasheet/lcsc_datasheet_2304140030_Samsung-Electro-Mechanics-CL10C100JB8NNNC_C1634.pdf | base | 0 | 2026-08-02 05:18:50 | Samsung Electro-Mechanics | CL10C100JB8NNNC | 0603 | Multilayer Ceramic Capacitors MLCC - SMD/SMT | 10pF 50V C0G ±5% 0603 Multilayer Ceramic Capacitors MLCC - SMD/SMT ROHS | 10pF ±5% 50V | 0.0075 | 3192328 | 1 | Capacitors | 2026-06-07 09:28:36 | 20 | 0.15
C1644 | 1996-CL10C150JB8NNNC/C1644 | https://www.lcsc.com/datasheet/lcsc_datasheet_2304140030_Samsung-Electro-Mechanics-CL10C150JB8NNNC_C1644.pdf | base | 0 | 2026-08-02 05:18:50 | Samsung Electro-Mechanics | CL10C150JB8NNNC | 0603 | Multilayer Ceramic Capacitors MLCC - SMD/SMT | 15pF 50V C0G ±5% 0603 Multilayer Ceramic Capacitors MLCC - SMD/SMT ROHS | 15pF ±5% 50V | 0.0138 | 1492105 | 1 | Capacitors | 2026-06-07 09:28:36 | 20 | 0.276
C1647 | 1999-CL10C180JB8NNNC/C1647 | https://www.lcsc.com/datasheet/lcsc_datasheet_2304140030_Samsung-Electro-Mechanics-CL10C180JB8NNNC_C1647.pdf | base | 0 | 2026-08-02 05:18:50 | Samsung Electro-Mechanics | CL10C180JB8NNNC | 0603 | Multilayer Ceramic Capacitors MLCC - SMD/SMT | 18pF 50V C0G ±5% 0603 Multilayer Ceramic Capacitors MLCC - SMD/SMT ROHS | 18pF ±5% 50V | 0.0109 | 558843 | 1 | Capacitors | 2026-06-07 09:28:36 | 20 | 0.218
C1648 | 2000-CL10C200JB8NNNC/C1648 | https://www.lcsc.com/datasheet/lcsc_datasheet_2304140030_Samsung-Electro-Mechanics-CL10C200JB8NNNC_C1648.pdf | base | 0 | 2026-08-02 05:18:50 | Samsung Electro-Mechanics | CL10C200JB8NNNC | 0603 | Multilayer Ceramic Capacitors MLCC - SMD/SMT | 20pF 50V C0G ±5% 0603 Multilayer Ceramic Capacitors MLCC - SMD/SMT ROHS | 20pF ±5% 50V | 0.0152 | 2554507 | 1 | Capacitors | 2026-06-07 09:28:36 | 20 | 0.304
C1653 | 2005-CL10C220JB8NNNC/C1653 | https://www.lcsc.com/datasheet/lcsc_datasheet_2304140030_Samsung-Electro-Mechanics-CL10C220JB8NNNC_C1653.pdf | base | 0 | 2026-08-02 05:18:50 | Samsung Electro-Mechanics | CL10C220JB8NNNC | 0603 | Multilayer Ceramic Capacitors MLCC - SMD/SMT | 22pF 50V C0G ±5% 0603 Multilayer Ceramic Capacitors MLCC - SMD/SMT ROHS | 22pF ±5% 50V | 0.0067 | 4431048 | 1 | Capacitors | 2026-06-07 09:28:36 | 20 | 0.134
C1658 | 2010-0603CG300J500NT/C1658 | https://www.lcsc.com/datasheet/lcsc_datasheet_2304140030_FH--Guangdong-Fenghua-Advanced-Tech-0603CG300J500NT_C1658.pdf | base | 0 | 2026-08-02 05:18:50 | FH (Guangdong Fenghua Advanced Tech) | 0603CG300J500NT | 0603 | Multilayer Ceramic Capacitors MLCC - SMD/SMT | 30pF 50V C0G ±5% 0603 Multilayer Ceramic Capacitors MLCC - SMD/SMT ROHS | 30pF ±5% 50V | 0.0115 | 576272 | 1 | Capacitors | 2026-06-07 09:28:36 | 20 | 0.23
C16581 | 17264-TP4056_42ESOP8/C16581 | https://www.lcsc.com/datasheet/lcsc_datasheet_1809261820_TOPPOWER-Nanjing-Extension-Microelectronics-TP4056-42-ESOP8_C16581.pdf | expand | 0 | 2026-08-02 05:18:50 | TOPPOWER(Nanjing Extension Microelectronics) | TP4056-42-ESOP8 | ESOP-8 | Battery Management | -40℃~+85℃ 1 1A 2uA 4.2V 4V~8V Charging IC Lithium Battery Support ESOP-8 Battery Management ROHS | 1A线性锂离子电池充电器 | 0.1866 | 79665 | 1 | Power Management (PMIC) | 2026-06-07 09:28:36 | 1 | 0.1866
C1663 | 2015-CL10C330JB8NNNC/C1663 | https://www.lcsc.com/datasheet/lcsc_datasheet_2304140030_Samsung-Electro-Mechanics-CL10C330JB8NNNC_C1663.pdf | base | 0 | 2026-08-02 05:18:50 | Samsung Electro-Mechanics | CL10C330JB8NNNC | 0603 | Multilayer Ceramic Capacitors MLCC - SMD/SMT | 33pF 50V C0G ±5% 0603 Multilayer Ceramic Capacitors MLCC - SMD/SMT ROHS | 33pF ±5% 50V | 0.0077 | 1991377 | 1 | Capacitors | 2026-06-07 09:28:36 | 20 | 0.154
C1664 | 2016-CL10C331JB8NNNC/C1664 | https://www.lcsc.com/datasheet/lcsc_datasheet_2304140030_Samsung-Electro-Mechanics-CL10C331JB8NNNC_C1664.pdf | base | 0 | 2026-08-02 05:18:50 | Samsung Electro-Mechanics | CL10C331JB8NNNC | 0603 | Multilayer Ceramic Capacitors MLCC - SMD/SMT | 330pF 50V C0G ±5% 0603 Multilayer Ceramic Capacitors MLCC - SMD/SMT ROHS | 330pF ±5% 50V | 0.0146 | 990388 | 1 | Capacitors | 2026-06-07 09:28:36 | 20 | 0.292
C1669 | 2021-0603CG4R7C500NT/C1669 | https://www.lcsc.com/datasheet/lcsc_datasheet_2304140030_FH--Guangdong-Fenghua-Advanced-Tech-0603CG4R7C500NT_C1669.pdf | expand | 0 | 2026-08-02 05:18:50 | FH (Guangdong Fenghua Advanced Tech) | 0603CG4R7C500NT | 0603 | Multilayer Ceramic Capacitors MLCC - SMD/SMT | 4.7pF 50V C0G 0603 Multilayer Ceramic Capacitors MLCC - SMD/SMT ROHS | ±0.25pF 4.7pF 50V | 0.0048 | 109528 | 1 | Capacitors | 2026-06-07 09:28:36 | 20 | 0.096
C1671 | 2023-CL10C470JB8NNNC/C1671 | https://www.lcsc.com/datasheet/lcsc_datasheet_2304140030_Samsung-Electro-Mechanics-CL10C470JB8NNNC_C1671.pdf | base | 0 | 2026-08-02 05:18:50 | Samsung Electro-Mechanics | CL10C470JB8NNNC | 0603 | Multilayer Ceramic Capacitors MLCC - SMD/SMT | 47pF 50V C0G ±5% 0603 Multilayer Ceramic Capacitors MLCC - SMD/SMT ROHS | 47pF ±5% 50V | 0.0113 | 1413502 | 1 | Capacitors | 2026-06-07 09:28:36 | 20 | 0.226
C16772 | 17456-CL05B224KO5NNNC/C16772 | https://www.lcsc.com/datasheet/lcsc_datasheet_2304140030_Samsung-Electro-Mechanics-CL05B224KO5NNNC_C16772.pdf | base | 0 | 2026-08-02 05:18:50 | Samsung Electro-Mechanics | CL05B224KO5NNNC | 0402 | Multilayer Ceramic Capacitors MLCC - SMD/SMT | 16V 220nF X7R ±10% 0402 Multilayer Ceramic Capacitors MLCC - SMD/SMT ROHS | 220nF ±10% 16V | 0.006 | 4532376 | 1 | Capacitors | 2026-06-07 09:28:36 | 20 | 0.12
C16780 | 17464-CL21A476MQYNNNE/C16780 | https://www.lcsc.com/datasheet/lcsc_datasheet_2304140030_Samsung-Electro-Mechanics-CL21A476MQYNNNE_C16780.pdf | base | 0 | 2026-08-02 05:18:50 | Samsung Electro-Mechanics | CL21A476MQYNNNE | 0805 | Multilayer Ceramic Capacitors MLCC - SMD/SMT | 47uF 6.3V X5R ±20% 0805 Multilayer Ceramic Capacitors MLCC - SMD/SMT ROHS | 47uF ±20% 6.3V | 0.1766 | 2215585 | 1 | Capacitors | 2026-06-07 09:28:36 | 7 | 1.2362
C1679 | 2031-0603CG6R8C500NT/C1679 | https://www.lcsc.com/datasheet/lcsc_datasheet_2304140030_FH--Guangdong-Fenghua-Advanced-Tech-0603CG6R8C500NT_C1679.pdf | expand | 0 | 2026-08-02 05:18:50 | FH (Guangdong Fenghua Advanced Tech) | 0603CG6R8C500NT | 0603 | Multilayer Ceramic Capacitors MLCC - SMD/SMT | 50V 6.8pF C0G 0603 Multilayer Ceramic Capacitors MLCC - SMD/SMT ROHS | ±0.25pF 6.8pF 50V | 0.0047 | 436742 | 1 | Capacitors | 2026-06-07 09:28:36 | 20 | 0.086
C1685 | 2037-0603CG8R2C500NT/C1685 | https://www.lcsc.com/datasheet/lcsc_datasheet_2304140030_FH--Guangdong-Fenghua-Advanced-Tech-0603CG8R2C500NT_C1685.pdf | expand | 0 | 2026-08-02 05:18:50 | FH (Guangdong Fenghua Advanced Tech) | 0603CG8R2C500NT | 0603 | Multilayer Ceramic Capacitors MLCC - SMD/SMT | 50V 8.2pF C0G 0603 Multilayer Ceramic Capacitors MLCC - SMD/SMT ROHS | ±0.25pF 8.2pF 50V | 0.0073 | 83717 | 1 | Capacitors | 2026-06-07 09:28:36 | 20 | 0.146
C1710 | 2062-CL21B103KBANNNC/C1710 | https://www.lcsc.com/datasheet/lcsc_datasheet_2304140030_Samsung-Electro-Mechanics-CL21B103KBANNNC_C1710.pdf | base | 0 | 2026-08-02 05:18:50 | Samsung Electro-Mechanics | CL21B103KBANNNC | 0805 | Multilayer Ceramic Capacitors MLCC - SMD/SMT | 10nF 50V X7R ±10% 0805 Multilayer Ceramic Capacitors MLCC - SMD/SMT ROHS | 10nF ±10% 50V | 0.0189 | 2888232 | 1 | Capacitors | 2026-06-07 09:28:36 | 20 | 0.378
C1716 | 2068-0805B151K500NT/C1716 | https://www.lcsc.com/datasheet/lcsc_datasheet_2304140030_FH--Guangdong-Fenghua-Advanced-Tech-0805B151K500NT_C1716.pdf | expand | 0 | 2026-08-02 05:18:50 | FH (Guangdong Fenghua Advanced Tech) | 0805B151K500NT | 0805 | Multilayer Ceramic Capacitors MLCC - SMD/SMT | 150pF 50V X7R ±10% 0805 Multilayer Ceramic Capacitors MLCC - SMD/SMT ROHS | 150pF ±10% 50V | 0.0217 | 103075 | 1 | Capacitors | 2026-06-07 09:28:36 | 20 | 0.434
C17168 | 17853-0402WGF0000TCE/C17168 | https://www.lcsc.com/datasheet/lcsc_datasheet_2206010216_UNI-ROYAL-Uniroyal-Elec-0402WGF0000TCE_C17168.pdf | base | 0 | 2026-08-02 05:18:50 | UNI-ROYAL(Uniroyal Elec) | 0402WGF0000TCE | 0402 | Chip Resistor - Surface Mount | -55℃~+155℃ 0Ω 50V 62.5mW Thick Film Resistor ±1% ±800ppm/℃ 0402 Chip Resistor - Surface Mount ROHS | 0Ω ±1% 62.5mW 厚膜电阻 | 0.0012 | 312307 | 7463 | Resistors | 2026-06-07 09:28:36 | 7473 | 8.9676
C1717 | 2069-0805B152K500NT/C1717 | https://www.lcsc.com/datasheet/lcsc_datasheet_2304140030_FH--Guangdong-Fenghua-Advanced-Tech-0805B152K500NT_C1717.pdf | expand | 0 | 2026-08-02 05:18:50 | FH (Guangdong Fenghua Advanced Tech) | 0805B152K500NT | 0805 | Multilayer Ceramic Capacitors MLCC - SMD/SMT | 1.5nF 50V X7R ±10% 0805 Multilayer Ceramic Capacitors MLCC - SMD/SMT ROHS | 1.5nF ±10% 50V | 0.0139 | 99196 | 1 | Capacitors | 2026-06-07 09:28:36 | 20 | 0.278
C17179589 | hongjiacheng-MMBD4148CC/C17179589 | https://wmsc.lcsc.com/wmsc/upload/file/pdf/v2/lcsc/2309121402_hongjiacheng-MMBD4148CC_C17179589.pdf | expand | 0 | 2026-08-02 05:18:50 | hongjiacheng | MMBD4148CC | SOT-23 | Switching Diodes | -55℃~+150℃ 1 Pair Common Cathode 100V 1V@10mA 200mA 350mW 4ns 5uA SOT-23 Switching Diodes ROHS | MMBD4148CC | 0.0172 | 3297 | 1 | Diodes | 2026-06-07 09:28:36 | 10 | 0.172
C17179590 | hongjiacheng-MMBD4148SE/C17179590 | https://wmsc.lcsc.com/wmsc/upload/file/pdf/v2/lcsc/2402060455_hongjiacheng-MMBD4148SE_C17179590.pdf | expand | 0 | 2026-08-02 05:18:50 | hongjiacheng | MMBD4148SE | SOT-23 | Switching Diodes | -55℃~+150℃ 1 Pair Series Connection 100V 1V@10mA 200mA 2A 350mW 4ns 5uA SOT-23 Switching Diodes ROHS | MMBD4148SE | 0.0153 | 169133 | 1 | Diodes | 2026-06-07 09:28:36 | 10 | 0.153
C1729 | 2081-CL21B223KBANNNC/C1729 | https://www.lcsc.com/datasheet/lcsc_datasheet_2304140030_Samsung-Electro-Mechanics-CL21B223KBANNNC_C1729.pdf | base | 0 | 2026-08-02 05:18:50 | Samsung Electro-Mechanics | CL21B223KBANNNC | 0805 | Multilayer Ceramic Capacitors MLCC - SMD/SMT | 22nF 50V X7R ±10% 0805 Multilayer Ceramic Capacitors MLCC - SMD/SMT ROHS | 22nF ±10% 50V | 0.0083 | 285084 | 1 | Capacitors | 2026-06-07 09:28:36 | 20 | 0.166
C17379 | 18067-0805W8F1201T5E/C17379 | https://www.lcsc.com/datasheet/lcsc_datasheet_2206010216_UNI-ROYAL-Uniroyal-Elec-0805W8F1201T5E_C17379.pdf | base | 0 | 2026-08-02 05:18:50 | UNI-ROYAL(Uniroyal Elec) | 0805W8F1201T5E | 0805 | Chip Resistor - Surface Mount | -55℃~+155℃ 1.2kΩ 125mW 150V Thick Film Resistor ±1% ±100ppm/℃ 0805 Chip Resistor - Surface Mount ROHS | 1.2kΩ ±1% 125mW 厚膜电阻 | 0.0091 | 565586 | 1 | Resistors | 2026-06-07 09:28:36 | 20 | 0.182
C1739 | 2091-0805B333K500NT/C1739 | https://www.lcsc.com/datasheet/lcsc_datasheet_2304140030_FH--Guangdong-Fenghua-Advanced-Tech-0805B333K500NT_C1739.pdf | base | 0 | 2026-08-02 05:18:50 | FH (Guangdong Fenghua Advanced Tech) | 0805B333K500NT | 0805 | Multilayer Ceramic Capacitors MLCC - SMD/SMT | 33nF 50V X7R ±10% 0805 Multilayer Ceramic Capacitors MLCC - SMD/SMT ROHS | 33nF ±10% 50V | 0.018 | 202353 | 1 | Capacitors | 2026-06-07 09:28:36 | 20 | 0.36
C17398 | 18086-0805W8F1801T5E/C17398 | https://www.lcsc.com/datasheet/lcsc_datasheet_2206010216_UNI-ROYAL-Uniroyal-Elec-0805W8F1801T5E_C17398.pdf | expand | 0 | 2026-08-02 05:18:50 | UNI-ROYAL(Uniroyal Elec) | 0805W8F1801T5E | 0805 | Chip Resistor - Surface Mount | -55℃~+155℃ 1.8kΩ 125mW 150V Thick Film Resistor ±1% ±100ppm/℃ 0805 Chip Resistor - Surface Mount ROHS | 1.8kΩ ±1% 125mW 厚膜电阻 | 0.004 | 13448 | 2239 | Resistors | 2026-06-07 09:28:36 | 2249 | 8.996
C1740 | 2092-0805B334K500NT/C1740 | https://www.lcsc.com/datasheet/lcsc_datasheet_2304140030_FH--Guangdong-Fenghua-Advanced-Tech-0805B334K500NT_C1740.pdf | expand | 0 | 2026-08-02 05:18:50 | FH (Guangdong Fenghua Advanced Tech) | 0805B334K500NT | 0805 | Multilayer Ceramic Capacitors MLCC - SMD/SMT | 330nF 50V X7R ±10% 0805 Multilayer Ceramic Capacitors MLCC - SMD/SMT ROHS | 330nF ±10% 50V | 0.0273 | 12 | 329 | Capacitors | 2026-06-07 09:28:36 | 339 | 9.2547
C17408 | 18096-0805W8F1000T5E/C17408 | https://www.lcsc.com/datasheet/lcsc_datasheet_2411221126_UNI-ROYAL-Uniroyal-Elec-0805W8F1000T5E_C17408.pdf | base | 0 | 2026-08-02 05:18:50 | UNI-ROYAL(Uniroyal Elec) | 0805W8F1000T5E | 0805 | Chip Resistor - Surface Mount | -55℃~+155℃ 100Ω 125mW 150V Thick Film Resistor ±1% ±100ppm/℃ 0805 Chip Resistor - Surface Mount ROHS | 100Ω ±1% 125mW 厚膜电阻 | 0.0103 | 7954302 | 1 | Resistors | 2026-06-07 09:28:36 | 20 | 0.206
C17414 | 18102-0805W8F1002T5E/C17414 | https://www.lcsc.com/datasheet/lcsc_datasheet_2411221126_UNI-ROYAL-Uniroyal-Elec-0805W8F1002T5E_C17414.pdf | base | 0 | 2026-08-02 05:18:50 | UNI-ROYAL(Uniroyal Elec) | 0805W8F1002T5E | 0805 | Chip Resistor - Surface Mount | -55℃~+155℃ 10kΩ 125mW 150V Thick Film Resistor ±1% ±100ppm/℃ 0805 Chip Resistor - Surface Mount ROHS | 10kΩ ±1% 125mW 厚膜电阻 | 0.011 | 21914118 | 1 | Resistors | 2026-06-07 09:28:36 | 20 | 0.22
C17415 | 18103-0805W8F100JT5E/C17415 | https://www.lcsc.com/datasheet/lcsc_datasheet_2206010216_UNI-ROYAL-Uniroyal-Elec-0805W8F100JT5E_C17415.pdf | base | 0 | 2026-08-02 05:18:50 | UNI-ROYAL(Uniroyal Elec) | 0805W8F100JT5E | 0805 | Chip Resistor - Surface Mount | -55℃~+155℃ 10Ω 125mW 150V Thick Film Resistor ±1% ±200ppm/℃ 0805 Chip Resistor - Surface Mount ROHS | 10Ω ±1% 125mW 厚膜电阻 | 0.0099 | 3568269 | 1 | Resistors | 2026-06-07 09:28:36 | 20 | 0.198
C17429 | 18117-0805W8F1102T5E/C17429 | https://www.lcsc.com/datasheet/lcsc_datasheet_2206010216_UNI-ROYAL-Uniroyal-Elec-0805W8F1102T5E_C17429.pdf | expand | 0 | 2026-08-02 05:18:50 | UNI-ROYAL(Uniroyal Elec) | 0805W8F1102T5E | 0805 | Chip Resistor - Surface Mount | -55℃~+155℃ 11kΩ 125mW 150V Thick Film Resistor ±1% ±100ppm/℃ 0805 Chip Resistor - Surface Mount ROHS | 11kΩ ±1% 125mW 厚膜电阻 | 0.0043 | 90125 | 1 | Resistors | 2026-06-07 09:28:36 | 20 | 0.086
C1743 | 2095-0805B471K500NT/C1743 | https://www.lcsc.com/datasheet/lcsc_datasheet_2304140030_FH--Guangdong-Fenghua-Advanced-Tech-0805B471K500NT_C1743.pdf | base | 0 | 2026-08-02 05:18:50 | FH (Guangdong Fenghua Advanced Tech) | 0805B471K500NT | 0805 | Multilayer Ceramic Capacitors MLCC - SMD/SMT | 470pF 50V X7R ±10% 0805 Multilayer Ceramic Capacitors MLCC - SMD/SMT ROHS | 470pF ±10% 50V | 0.0142 | 587238 | 1 | Capacitors | 2026-06-07 09:28:36 | 20 | 0.284
C17436 | 18124-0805W8F1203T5E/C17436 | https://www.lcsc.com/datasheet/lcsc_datasheet_2206010216_UNI-ROYAL-Uniroyal-Elec-0805W8F1203T5E_C17436.pdf | expand | 0 | 2026-08-02 05:18:50 | UNI-ROYAL(Uniroyal Elec) | 0805W8F1203T5E | 0805 | Chip Resistor - Surface Mount | -55℃~+155℃ 120kΩ 125mW 150V Thick Film Resistor ±1% ±100ppm/℃ 0805 Chip Resistor - Surface Mount ROHS | 120kΩ ±1% 125mW 厚膜电阻 | 0.0075 | 209698 | 1 | Resistors | 2026-06-07 09:28:36 | 20 | 0.15
C17437 | 18125-0805W8F1200T5E/C17437 | https://www.lcsc.com/datasheet/lcsc_datasheet_2206010216_UNI-ROYAL-Uniroyal-Elec-0805W8F1200T5E_C17437.pdf | base | 0 | 2026-08-02 05:18:50 | UNI-ROYAL(Uniroyal Elec) | 0805W8F1200T5E | 0805 | Chip Resistor - Surface Mount | -55℃~+155℃ 120Ω 125mW 150V Thick Film Resistor ±1% ±100ppm/℃ 0805 Chip Resistor - Surface Mount ROHS | 120Ω ±1% 125mW 厚膜电阻 | 0.0155 | 1577728 | 1 | Resistors | 2026-06-07 09:28:36 | 20 | 0.31
C1744 | 2096-0805B472K500NT/C1744 | https://www.lcsc.com/datasheet/lcsc_datasheet_2304140030_FH--Guangdong-Fenghua-Advanced-Tech-0805B472K500NT_C1744.pdf | base | 0 | 2026-08-02 05:18:50 | FH (Guangdong Fenghua Advanced Tech) | 0805B472K500NT | 0805 | Multilayer Ceramic Capacitors MLCC - SMD/SMT | 4.7nF 50V X7R ±10% 0805 Multilayer Ceramic Capacitors MLCC - SMD/SMT ROHS | 4.7nF ±10% 50V | 0.0156 | 644688 | 1 | Capacitors | 2026-06-07 09:28:36 | 20 | 0.312
C17444 | 18132-0805W8F1202T5E/C17444 | https://www.lcsc.com/datasheet/lcsc_datasheet_2206010216_UNI-ROYAL-Uniroyal-Elec-0805W8F1202T5E_C17444.pdf | base | 0 | 2026-08-02 05:18:50 | UNI-ROYAL(Uniroyal Elec) | 0805W8F1202T5E | 0805 | Chip Resistor - Surface Mount | -55℃~+155℃ 125mW 12kΩ 150V Thick Film Resistor ±1% ±100ppm/℃ 0805 Chip Resistor - Surface Mount ROHS | 12kΩ ±1% 125mW 厚膜电阻 | 0.0041 | 804964 | 1 | Resistors | 2026-06-07 09:28:36 | 20 | 0.082
C17455 | 18143-0805W8F1302T5E/C17455 | https://www.lcsc.com/datasheet/lcsc_datasheet_2206010216_UNI-ROYAL-Uniroyal-Elec-0805W8F1302T5E_C17455.pdf | expand | 0 | 2026-08-02 05:18:50 | UNI-ROYAL(Uniroyal Elec) | 0805W8F1302T5E | 0805 | Chip Resistor - Surface Mount | -55℃~+155℃ 125mW 13kΩ 150V Thick Film Resistor ±1% ±100ppm/℃ 0805 Chip Resistor - Surface Mount ROHS | 13kΩ ±1% 125mW 厚膜电阻 | 0.018 | 184244 | 1 | Resistors | 2026-06-07 09:28:36 | 20 | 0.36
C17470 | 18158-0805W8F1503T5E/C17470 | https://www.lcsc.com/datasheet/lcsc_datasheet_2206010216_UNI-ROYAL-Uniroyal-Elec-0805W8F1503T5E_C17470.pdf | base | 0 | 2026-08-02 05:18:50 | UNI-ROYAL(Uniroyal Elec) | 0805W8F1503T5E | 0805 | Chip Resistor - Surface Mount | -55℃~+155℃ 125mW 150V 150kΩ Thick Film Resistor ±1% ±100ppm/℃ 0805 Chip Resistor - Surface Mount ROHS | 150kΩ ±1% 125mW 厚膜电阻 | 0.0129 | 942088 | 1 | Resistors | 2026-06-07 09:28:36 | 20 | 0.258
C17471 | 18159-0805W8F1500T5E/C17471 | https://www.lcsc.com/datasheet/lcsc_datasheet_2206010216_UNI-ROYAL-Uniroyal-Elec-0805W8F1500T5E_C17471.pdf | base | 0 | 2026-08-02 05:18:50 | UNI-ROYAL(Uniroyal Elec) | 0805W8F1500T5E | 0805 | Chip Resistor - Surface Mount | -55℃~+155℃ 125mW 150V 150Ω Thick Film Resistor ±1% ±100ppm/℃ 0805 Chip Resistor - Surface Mount ROHS | 150Ω ±1% 125mW 厚膜电阻 | 0.0105 | 925578 | 1 | Resistors | 2026-06-07 09:28:36 | 20 | 0.21
C17475 | 18163-0805W8F1502T5E/C17475 | https://www.lcsc.com/datasheet/lcsc_datasheet_2206010216_UNI-ROYAL-Uniroyal-Elec-0805W8F1502T5E_C17475.pdf | base | 0 | 2026-08-02 05:18:50 | UNI-ROYAL(Uniroyal Elec) | 0805W8F1502T5E | 0805 | Chip Resistor - Surface Mount | -55℃~+155℃ 125mW 150V 15kΩ Thick Film Resistor ±1% ±100ppm/℃ 0805 Chip Resistor - Surface Mount ROHS | 15kΩ ±1% 125mW 厚膜电阻 | 0.013 | 1245934 | 1 | Resistors | 2026-06-07 09:28:36 | 20 | 0.26
C17477 | 18165-0805W8F0000T5E/C17477 | https://www.lcsc.com/datasheet/lcsc_datasheet_2206010216_UNI-ROYAL-Uniroyal-Elec-0805W8F0000T5E_C17477.pdf | base | 0 | 2026-08-02 05:18:50 | UNI-ROYAL(Uniroyal Elec) | 0805W8F0000T5E | 0805 | Chip Resistor - Surface Mount | -55℃~+155℃ 0Ω 125mW 150V Thick Film Resistor ±1% ±800ppm/℃ 0805 Chip Resistor - Surface Mount ROHS | 0Ω ±1% 125mW 厚膜电阻 | 0.01 | 8301502 | 1 | Resistors | 2026-06-07 09:28:36 | 20 | 0.2
C17480 | 18168-0805W8F150JT5E/C17480 | https://www.lcsc.com/datasheet/lcsc_datasheet_2206010216_UNI-ROYAL-Uniroyal-Elec-0805W8F150JT5E_C17480.pdf | expand | 0 | 2026-08-02 05:18:50 | UNI-ROYAL(Uniroyal Elec) | 0805W8F150JT5E | 0805 | Chip Resistor - Surface Mount | -55℃~+155℃ 125mW 150V 15Ω Thick Film Resistor ±1% ±100ppm/℃ 0805 Chip Resistor - Surface Mount ROHS | 15Ω ±1% 125mW 厚膜电阻 | 0.0086 | 573363 | 1 | Resistors | 2026-06-07 09:28:36 | 20 | 0.172
C17490 | 18178-0805W8F1602T5E/C17490 | https://www.lcsc.com/datasheet/lcsc_datasheet_2206010216_UNI-ROYAL-Uniroyal-Elec-0805W8F1602T5E_C17490.pdf | expand | 0 | 2026-08-02 05:18:50 | UNI-ROYAL(Uniroyal Elec) | 0805W8F1602T5E | 0805 | Chip Resistor - Surface Mount | -55℃~+155℃ 125mW 150V 16kΩ Thick Film Resistor ±1% ±100ppm/℃ 0805 Chip Resistor - Surface Mount ROHS | 16kΩ ±1% 125mW 厚膜电阻 | 0.0139 | 333488 | 1 | Resistors | 2026-06-07 09:28:36 | 20 | 0.278
C17501 | 18189-0805W8F1803T5E/C17501 | https://www.lcsc.com/datasheet/lcsc_datasheet_2206010216_UNI-ROYAL-Uniroyal-Elec-0805W8F1803T5E_C17501.pdf | expand | 0 | 2026-08-02 05:18:50 | UNI-ROYAL(Uniroyal Elec) | 0805W8F1803T5E | 0805 | Chip Resistor - Surface Mount | -55℃~+155℃ 125mW 150V 180kΩ Thick Film Resistor ±1% ±100ppm/℃ 0805 Chip Resistor - Surface Mount ROHS | 180kΩ ±1% 125mW 厚膜电阻 | 0.0075 | 156510 | 1 | Resistors | 2026-06-07 09:28:36 | 20 | 0.15
C17506 | 18194-0805W8F1802T5E/C17506 | https://www.lcsc.com/datasheet/lcsc_datasheet_2206010216_UNI-ROYAL-Uniroyal-Elec-0805W8F1802T5E_C17506.pdf | expand | 0 | 2026-08-02 05:18:50 | UNI-ROYAL(Uniroyal Elec) | 0805W8F1802T5E | 0805 | Chip Resistor - Surface Mount | -55℃~+155℃ 125mW 150V 18kΩ Thick Film Resistor ±1% ±100ppm/℃ 0805 Chip Resistor - Surface Mount ROHS | 18kΩ ±1% 125mW 厚膜电阻 | 0.0086 | 275082 | 1 | Resistors | 2026-06-07 09:28:36 | 20 | 0.172
C17513 | 18201-0805W8F1001T5E/C17513 | https://www.lcsc.com/datasheet/lcsc_datasheet_2205311800_UNI-ROYAL-Uniroyal-Elec-0805W8F1001T5E_C17513.pdf | base | 0 | 2026-08-02 05:18:50 | UNI-ROYAL(Uniroyal Elec) | 0805W8F1001T5E | 0805 | Chip Resistor - Surface Mount | -55℃~+155℃ 125mW 150V 1kΩ Thick Film Resistor ±1% ±100ppm/℃ 0805 Chip Resistor - Surface Mount ROHS | 1kΩ ±1% 125mW 厚膜电阻 | 0.0163 | 12897724 | 1 | Resistors | 2026-06-07 09:28:36 | 20 | 0.326
C17514 | 18202-0805W8F1004T5E/C17514 | https://www.lcsc.com/datasheet/lcsc_datasheet_2206010200_UNI-ROYAL-Uniroyal-Elec-0805W8F1004T5E_C17514.pdf | base | 0 | 2026-08-02 05:18:50 | UNI-ROYAL(Uniroyal Elec) | 0805W8F1004T5E | 0805 | Chip Resistor - Surface Mount | -55℃~+155℃ 125mW 150V 1MΩ Thick Film Resistor ±1% ±100ppm/℃ 0805 Chip Resistor - Surface Mount ROHS | 1MΩ ±1% 125mW 厚膜电阻 | 0.0093 | 3559202 | 1 | Resistors | 2026-06-07 09:28:36 | 20 | 0.186
C17520 | 18208-0805W8F2201T5E/C17520 | https://www.lcsc.com/datasheet/lcsc_datasheet_2206010200_UNI-ROYAL-Uniroyal-Elec-0805W8F2201T5E_C17520.pdf | base | 0 | 2026-08-02 05:18:50 | UNI-ROYAL(Uniroyal Elec) | 0805W8F2201T5E | 0805 | Chip Resistor - Surface Mount | -55℃~+155℃ 125mW 150V 2.2kΩ Thick Film Resistor ±1% ±100ppm/℃ 0805 Chip Resistor - Surface Mount ROHS | 2.2kΩ ±1% 125mW 厚膜电阻 | 0.0092 | 1283003 | 1 | Resistors | 2026-06-07 09:28:36 | 20 | 0.184
C17521 | 18209-0805W8F220KT5E/C17521 | https://www.lcsc.com/datasheet/lcsc_datasheet_2206010200_UNI-ROYAL-Uniroyal-Elec-0805W8F220KT5E_C17521.pdf | base | 0 | 2026-08-02 05:18:50 | UNI-ROYAL(Uniroyal Elec) | 0805W8F220KT5E | 0805 | Chip Resistor - Surface Mount | -55℃~+155℃ 125mW 150V 2.2Ω Thick Film Resistor ±1% ±200ppm/℃ 0805 Chip Resistor - Surface Mount ROHS | 2.2Ω ±1% 125mW 厚膜电阻 | 0.008 | 402983 | 1 | Resistors | 2026-06-07 09:28:36 | 20 | 0.16
C17526 | 18214-0805W8F2401T5E/C17526 | https://www.lcsc.com/datasheet/lcsc_datasheet_2206010200_UNI-ROYAL-Uniroyal-Elec-0805W8F2401T5E_C17526.pdf | base | 0 | 2026-08-02 05:18:50 | UNI-ROYAL(Uniroyal Elec) | 0805W8F2401T5E | 0805 | Chip Resistor - Surface Mount | -55℃~+155℃ 125mW 150V 2.4kΩ Thick Film Resistor ±1% ±100ppm/℃ 0805 Chip Resistor - Surface Mount ROHS | 2.4kΩ ±1% 125mW 厚膜电阻 | 0.0036 | 418080 | 1 | Resistors | 2026-06-07 09:28:36 | 20 | 0.072
C17530 | 18218-0805W8F2701T5E/C17530 | https://www.lcsc.com/datasheet/lcsc_datasheet_2206010200_UNI-ROYAL-Uniroyal-Elec-0805W8F2701T5E_C17530.pdf | base | 0 | 2026-08-02 05:18:50 | UNI-ROYAL(Uniroyal Elec) | 0805W8F2701T5E | 0805 | Chip Resistor - Surface Mount | -55℃~+155℃ 125mW 150V 2.7kΩ Thick Film Resistor ±1% ±100ppm/℃ 0805 Chip Resistor - Surface Mount ROHS | 2.7kΩ ±1% 125mW 厚膜电阻 | 0.0119 | 2093742 | 1 | Resistors | 2026-06-07 09:28:36 | 20 | 0.238
C17539 | 18227-0805W8F2003T5E/C17539 | https://www.lcsc.com/datasheet/lcsc_datasheet_2206010200_UNI-ROYAL-Uniroyal-Elec-0805W8F2003T5E_C17539.pdf | base | 0 | 2026-08-02 05:18:50 | UNI-ROYAL(Uniroyal Elec) | 0805W8F2003T5E | 0805 | Chip Resistor - Surface Mount | -55℃~+155℃ 125mW 150V 200kΩ Thick Film Resistor ±1% ±100ppm/℃ 0805 Chip Resistor - Surface Mount ROHS | 200kΩ ±1% 125mW 厚膜电阻 | 0.013 | 960375 | 1 | Resistors | 2026-06-07 09:28:36 | 20 | 0.26
C17540 | 18228-0805W8F2000T5E/C17540 | https://www.lcsc.com/datasheet/lcsc_datasheet_2206010200_UNI-ROYAL-Uniroyal-Elec-0805W8F2000T5E_C17540.pdf | base | 0 | 2026-08-02 05:18:50 | UNI-ROYAL(Uniroyal Elec) | 0805W8F2000T5E | 0805 | Chip Resistor - Surface Mount | -55℃~+155℃ 125mW 150V 200Ω Thick Film Resistor ±1% ±100ppm/℃ 0805 Chip Resistor - Surface Mount ROHS | 200Ω ±1% 125mW 厚膜电阻 | 0.0137 | 1968426 | 1 | Resistors | 2026-06-07 09:28:36 | 20 | 0.274
C17544 | 18232-0805W8F200JT5E/C17544 | https://www.lcsc.com/datasheet/lcsc_datasheet_2206010200_UNI-ROYAL-Uniroyal-Elec-0805W8F200JT5E_C17544.pdf | base | 0 | 2026-08-02 05:18:50 | UNI-ROYAL(Uniroyal Elec) | 0805W8F200JT5E | 0805 | Chip Resistor - Surface Mount | -55℃~+155℃ 125mW 150V 20Ω Thick Film Resistor ±1% ±100ppm/℃ 0805 Chip Resistor - Surface Mount ROHS | 20Ω ±1% 125mW 厚膜电阻 | 0.0096 | 2462622 | 1 | Resistors | 2026-06-07 09:28:36 | 20 | 0.192
C1755 | 2107-0805B682K500NT/C1755 | https://www.lcsc.com/datasheet/lcsc_datasheet_2304140030_FH--Guangdong-Fenghua-Advanced-Tech-0805B682K500NT_C1755.pdf | expand | 0 | 2026-08-02 05:18:50 | FH (Guangdong Fenghua Advanced Tech) | 0805B682K500NT | 0805 | Multilayer Ceramic Capacitors MLCC - SMD/SMT | 50V 6.8nF X7R ±10% 0805 Multilayer Ceramic Capacitors MLCC - SMD/SMT ROHS | 6.8nF ±10% 50V | 0.0133 | 81285 | 1 | Capacitors | 2026-06-07 09:28:36 | 20 | 0.266
C17556 | 18244-0805W8F2203T5E/C17556 | https://www.lcsc.com/datasheet/lcsc_datasheet_2206010200_UNI-ROYAL-Uniroyal-Elec-0805W8F2203T5E_C17556.pdf | base | 0 | 2026-08-02 05:18:50 | UNI-ROYAL(Uniroyal Elec) | 0805W8F2203T5E | 0805 | Chip Resistor - Surface Mount | -55℃~+155℃ 125mW 150V 220kΩ Thick Film Resistor ±1% ±100ppm/℃ 0805 Chip Resistor - Surface Mount ROHS | 220kΩ ±1% 125mW 厚膜电阻 | 0.0107 | 587253 | 1 | Resistors | 2026-06-07 09:28:36 | 20 | 0.214
C17557 | 18245-0805W8F2200T5E/C17557 | https://www.lcsc.com/datasheet/lcsc_datasheet_2206010200_UNI-ROYAL-Uniroyal-Elec-0805W8F2200T5E_C17557.pdf | base | 0 | 2026-08-02 05:18:50 | UNI-ROYAL(Uniroyal Elec) | 0805W8F2200T5E | 0805 | Chip Resistor - Surface Mount | -55℃~+155℃ 125mW 150V 220Ω Thick Film Resistor ±1% ±100ppm/℃ 0805 Chip Resistor - Surface Mount ROHS | 220Ω ±1% 125mW 厚膜电阻 | 0.0106 | 1584595 | 1 | Resistors | 2026-06-07 09:28:36 | 20 | 0.212
C17560 | 18248-0805W8F2202T5E/C17560 | https://www.lcsc.com/datasheet/lcsc_datasheet_2206010200_UNI-ROYAL-Uniroyal-Elec-0805W8F2202T5E_C17560.pdf | base | 0 | 2026-08-02 05:18:50 | UNI-ROYAL(Uniroyal Elec) | 0805W8F2202T5E | 0805 | Chip Resistor - Surface Mount | -55℃~+155℃ 125mW 150V 22kΩ Thick Film Resistor ±1% ±100ppm/℃ 0805 Chip Resistor - Surface Mount ROHS | 22kΩ ±1% 125mW 厚膜电阻 | 0.0107 | 2301912 | 1 | Resistors | 2026-06-07 09:28:36 | 20 | 0.214
C17561 | 18249-0805W8F220JT5E/C17561 | https://www.lcsc.com/datasheet/lcsc_datasheet_2206010200_UNI-ROYAL-Uniroyal-Elec-0805W8F220JT5E_C17561.pdf | base | 0 | 2026-08-02 05:18:50 | UNI-ROYAL(Uniroyal Elec) | 0805W8F220JT5E | 0805 | Chip Resistor - Surface Mount | -55℃~+155℃ 125mW 150V 22Ω Thick Film Resistor ±1% ±100ppm/℃ 0805 Chip Resistor - Surface Mount ROHS | 22Ω ±1% 125mW 厚膜电阻 | 0.0103 | 2119779 | 1 | Resistors | 2026-06-07 09:28:36 | 20 | 0.206
C17572 | 18260-0805W8F2400T5E/C17572 | https://www.lcsc.com/datasheet/lcsc_datasheet_2206010200_UNI-ROYAL-Uniroyal-Elec-0805W8F2400T5E_C17572.pdf | expand | 0 | 2026-08-02 05:18:50 | UNI-ROYAL(Uniroyal Elec) | 0805W8F2400T5E | 0805 | Chip Resistor - Surface Mount | -55℃~+155℃ 125mW 150V 240Ω Thick Film Resistor ±1% ±100ppm/℃ 0805 Chip Resistor - Surface Mount ROHS | 240Ω ±1% 125mW 厚膜电阻 | 0.016 | 287714 | 1 | Resistors | 2026-06-07 09:28:36 | 20 | 0.32
C17575 | 18263-0805W8F2402T5E/C17575 | https://www.lcsc.com/datasheet/lcsc_datasheet_2206010200_UNI-ROYAL-Uniroyal-Elec-0805W8F2402T5E_C17575.pdf | base | 0 | 2026-08-02 05:18:50 | UNI-ROYAL(Uniroyal Elec) | 0805W8F2402T5E | 0805 | Chip Resistor - Surface Mount | -55℃~+155℃ 125mW 150V 24kΩ Thick Film Resistor ±1% ±100ppm/℃ 0805 Chip Resistor - Surface Mount ROHS | 24kΩ ±1% 125mW 厚膜电阻 | 0.0072 | 683756 | 1 | Resistors | 2026-06-07 09:28:36 | 20 | 0.144
C17589 | 18277-0805W8F2703T5E/C17589 | https://www.lcsc.com/datasheet/lcsc_datasheet_2206010200_UNI-ROYAL-Uniroyal-Elec-0805W8F2703T5E_C17589.pdf | expand | 0 | 2026-08-02 05:18:50 | UNI-ROYAL(Uniroyal Elec) | 0805W8F2703T5E | 0805 | Chip Resistor - Surface Mount | -55℃~+155℃ 125mW 150V 270kΩ Thick Film Resistor ±1% ±100ppm/℃ 0805 Chip Resistor - Surface Mount ROHS | 270kΩ ±1% 125mW 厚膜电阻 | 0.012 | 211004 | 1 | Resistors | 2026-06-07 09:28:36 | 20 | 0.24
C17590 | 18278-0805W8F2700T5E/C17590 | https://www.lcsc.com/datasheet/lcsc_datasheet_2206010200_UNI-ROYAL-Uniroyal-Elec-0805W8F2700T5E_C17590.pdf | expand | 0 | 2026-08-02 05:18:50 | UNI-ROYAL(Uniroyal Elec) | 0805W8F2700T5E | 0805 | Chip Resistor - Surface Mount | -55℃~+155℃ 125mW 150V 270Ω Thick Film Resistor ±1% ±100ppm/℃ 0805 Chip Resistor - Surface Mount ROHS | 270Ω ±1% 125mW 厚膜电阻 | 0.015 | 608394 | 1 | Resistors | 2026-06-07 09:28:36 | 20 | 0.3
C17593 | 18281-0805W8F2702T5E/C17593 | https://www.lcsc.com/datasheet/lcsc_datasheet_2206010200_UNI-ROYAL-Uniroyal-Elec-0805W8F2702T5E_C17593.pdf | base | 0 | 2026-08-02 05:18:50 | UNI-ROYAL(Uniroyal Elec) | 0805W8F2702T5E | 0805 | Chip Resistor - Surface Mount | -55℃~+155℃ 125mW 150V 27kΩ Thick Film Resistor ±1% ±100ppm/℃ 0805 Chip Resistor - Surface Mount ROHS | 27kΩ ±1% 125mW 厚膜电阻 | 0.0044 | 429115 | 1 | Resistors | 2026-06-07 09:28:36 | 20 | 0.088
C17594 | 18282-0805W8F270JT5E/C17594 | https://www.lcsc.com/datasheet/lcsc_datasheet_2206010200_UNI-ROYAL-Uniroyal-Elec-0805W8F270JT5E_C17594.pdf | expand | 0 | 2026-08-02 05:18:50 | UNI-ROYAL(Uniroyal Elec) | 0805W8F270JT5E | 0805 | Chip Resistor - Surface Mount | -55℃~+155℃ 125mW 150V 27Ω Thick Film Resistor ±1% ±100ppm/℃ 0805 Chip Resistor - Surface Mount ROHS | 27Ω ±1% 125mW 厚膜电阻 | 0.0072 | 154709 | 1 | Resistors | 2026-06-07 09:28:36 | 20 | 0.144
C17604 | 18292-0805W8F2001T5E/C17604 | https://www.lcsc.com/datasheet/lcsc_datasheet_2206010200_UNI-ROYAL-Uniroyal-Elec-0805W8F2001T5E_C17604.pdf | base | 0 | 2026-08-02 05:18:50 | UNI-ROYAL(Uniroyal Elec) | 0805W8F2001T5E | 0805 | Chip Resistor - Surface Mount | -55℃~+155℃ 125mW 150V 2kΩ Thick Film Resistor ±1% ±100ppm/℃ 0805 Chip Resistor - Surface Mount ROHS | 2kΩ ±1% 125mW 厚膜电阻 | 0.0112 | 5440427 | 1 | Resistors | 2026-06-07 09:28:36 | 20 | 0.224
C17606 | 18294-0805W8F200KT5E/C17606 | https://www.lcsc.com/datasheet/lcsc_datasheet_2206010200_UNI-ROYAL-Uniroyal-Elec-0805W8F200KT5E_C17606.pdf | expand | 0 | 2026-08-02 05:18:50 | UNI-ROYAL(Uniroyal Elec) | 0805W8F200KT5E | 0805 | Chip Resistor - Surface Mount | -55℃~+155℃ 125mW 150V 2Ω Thick Film Resistor ±1% ±200ppm/℃ 0805 Chip Resistor - Surface Mount ROHS | 2Ω ±1% 125mW 厚膜电阻 | 0.0055 | 0 | 1629 | Resistors | 2026-06-07 09:28:36 | 1641 | 9.0255
C17614 | 18302-0805W8F3901T5E/C17614 | https://www.lcsc.com/datasheet/lcsc_datasheet_2206010200_UNI-ROYAL-Uniroyal-Elec-0805W8F3901T5E_C17614.pdf | base | 0 | 2026-08-02 05:18:50 | UNI-ROYAL(Uniroyal Elec) | 0805W8F3901T5E | 0805 | Chip Resistor - Surface Mount | -55℃~+155℃ 125mW 150V 3.9kΩ Thick Film Resistor ±1% ±100ppm/℃ 0805 Chip Resistor - Surface Mount ROHS | 3.9kΩ ±1% 125mW 厚膜电阻 | 0.005 | 467228 | 1 | Resistors | 2026-06-07 09:28:36 | 20 | 0.1
C17616 | 18304-0805W8F3003T5E/C17616 | https://www.lcsc.com/datasheet/lcsc_datasheet_2206010200_UNI-ROYAL-Uniroyal-Elec-0805W8F3003T5E_C17616.pdf | expand | 0 | 2026-08-02 05:18:50 | UNI-ROYAL(Uniroyal Elec) | 0805W8F3003T5E | 0805 | Chip Resistor - Surface Mount | -55℃~+155℃ 125mW 150V 300kΩ Thick Film Resistor ±1% ±100ppm/℃ 0805 Chip Resistor - Surface Mount ROHS | 300kΩ ±1% 125mW 厚膜电阻 | 0.0132 | 365455 | 1 | Resistors | 2026-06-07 09:28:36 | 20 | 0.264
C17617 | 18305-0805W8F3000T5E/C17617 | https://www.lcsc.com/datasheet/lcsc_datasheet_2206010200_UNI-ROYAL-Uniroyal-Elec-0805W8F3000T5E_C17617.pdf | base | 0 | 2026-08-02 05:18:50 | UNI-ROYAL(Uniroyal Elec) | 0805W8F3000T5E | 0805 | Chip Resistor - Surface Mount | -55℃~+155℃ 125mW 150V 300Ω Thick Film Resistor ±1% ±100ppm/℃ 0805 Chip Resistor - Surface Mount ROHS | 300Ω ±1% 125mW 厚膜电阻 | 0.0095 | 1210739 | 1 | Resistors | 2026-06-07 09:28:36 | 20 | 0.19
C17621 | 18309-0805W8F3002T5E/C17621 | https://www.lcsc.com/datasheet/lcsc_datasheet_2205311830_UNI-ROYAL-Uniroyal-Elec-0805W8F3002T5E_C17621.pdf | base | 0 | 2026-08-02 05:18:50 | UNI-ROYAL(Uniroyal Elec) | 0805W8F3002T5E | 0805 | Chip Resistor - Surface Mount | -55℃~+155℃ 125mW 150V 30kΩ Thick Film Resistor ±1% ±100ppm/℃ 0805 Chip Resistor - Surface Mount ROHS | 30kΩ ±1% 125mW 厚膜电阻 | 0.0079 | 1292554 | 1 | Resistors | 2026-06-07 09:28:36 | 20 | 0.158
C17629 | 18317-0805W8F3303T5E/C17629 | https://www.lcsc.com/datasheet/lcsc_datasheet_2205311830_UNI-ROYAL-Uniroyal-Elec-0805W8F3303T5E_C17629.pdf | expand | 0 | 2026-08-02 05:18:50 | UNI-ROYAL(Uniroyal Elec) | 0805W8F3303T5E | 0805 | Chip Resistor - Surface Mount | -55℃~+155℃ 125mW 150V 330kΩ Thick Film Resistor ±1% ±100ppm/℃ 0805 Chip Resistor - Surface Mount ROHS | 330kΩ ±1% 125mW 厚膜电阻 | 0.0055 | 269830 | 1 | Resistors | 2026-06-07 09:28:36 | 20 | 0.11
C17630 | 18318-0805W8F3300T5E/C17630 | https://www.lcsc.com/datasheet/lcsc_datasheet_2205311830_UNI-ROYAL-Uniroyal-Elec-0805W8F3300T5E_C17630.pdf | base | 0 | 2026-08-02 05:18:50 | UNI-ROYAL(Uniroyal Elec) | 0805W8F3300T5E | 0805 | Chip Resistor - Surface Mount | -55℃~+155℃ 125mW 150V 330Ω Thick Film Resistor ±1% ±100ppm/℃ 0805 Chip Resistor - Surface Mount ROHS | 330Ω ±1% 125mW 厚膜电阻 | 0.0093 | 3057141 | 1 | Resistors | 2026-06-07 09:28:36 | 20 | 0.186
C17633 | 18321-0805W8F3302T5E/C17633 | https://www.lcsc.com/datasheet/lcsc_datasheet_2205311830_UNI-ROYAL-Uniroyal-Elec-0805W8F3302T5E_C17633.pdf | base | 0 | 2026-08-02 05:18:50 | UNI-ROYAL(Uniroyal Elec) | 0805W8F3302T5E | 0805 | Chip Resistor - Surface Mount | -55℃~+155℃ 125mW 150V 33kΩ Thick Film Resistor ±1% ±100ppm/℃ 0805 Chip Resistor - Surface Mount ROHS | 33kΩ ±1% 125mW 厚膜电阻 | 0.0043 | 552954 | 1 | Resistors | 2026-06-07 09:28:36 | 20 | 0.086
C17634 | 18322-0805W8F330JT5E/C17634 | https://www.lcsc.com/datasheet/lcsc_datasheet_2205311830_UNI-ROYAL-Uniroyal-Elec-0805W8F330JT5E_C17634.pdf | base | 0 | 2026-08-02 05:18:50 | UNI-ROYAL(Uniroyal Elec) | 0805W8F330JT5E | 0805 | Chip Resistor - Surface Mount | -55℃~+155℃ 125mW 150V 33Ω Thick Film Resistor ±1% ±200ppm/℃ 0805 Chip Resistor - Surface Mount ROHS | 33Ω ±1% 125mW 厚膜电阻 | 0.0135 | 1308143 | 1 | Resistors | 2026-06-07 09:28:36 | 20 | 0.27
C17655 | 18343-0805W8F3900T5E/C17655 | https://www.lcsc.com/datasheet/lcsc_datasheet_2206010200_UNI-ROYAL-Uniroyal-Elec-0805W8F3900T5E_C17655.pdf | base | 0 | 2026-08-02 05:18:50 | UNI-ROYAL(Uniroyal Elec) | 0805W8F3900T5E | 0805 | Chip Resistor - Surface Mount | -55℃~+155℃ 125mW 150V 390Ω Thick Film Resistor ±1% ±100ppm/℃ 0805 Chip Resistor - Surface Mount ROHS | 390Ω ±1% 125mW 厚膜电阻 | 0.0039 | 1921324 | 1 | Resistors | 2026-06-07 09:28:36 | 20 | 0.078
C17656 | 18344-0805W8F3903T5E/C17656 | https://www.lcsc.com/datasheet/lcsc_datasheet_2206010200_UNI-ROYAL-Uniroyal-Elec-0805W8F3903T5E_C17656.pdf | expand | 0 | 2026-08-02 05:18:50 | UNI-ROYAL(Uniroyal Elec) | 0805W8F3903T5E | 0805 | Chip Resistor - Surface Mount | -55℃~+155℃ 125mW 150V 390kΩ Thick Film Resistor ±1% ±100ppm/℃ 0805 Chip Resistor - Surface Mount ROHS | 390kΩ ±1% 125mW 厚膜电阻 | 0.0052 | 462249 | 1 | Resistors | 2026-06-07 09:28:36 | 20 | 0.104
C17661 | 18349-0805W8F3001T5E/C17661 | https://www.lcsc.com/datasheet/lcsc_datasheet_2206010200_UNI-ROYAL-Uniroyal-Elec-0805W8F3001T5E_C17661.pdf | base | 0 | 2026-08-02 05:18:50 | UNI-ROYAL(Uniroyal Elec) | 0805W8F3001T5E | 0805 | Chip Resistor - Surface Mount | -55℃~+155℃ 125mW 150V 3kΩ Thick Film Resistor ±1% ±100ppm/℃ 0805 Chip Resistor - Surface Mount ROHS | 3kΩ ±1% 125mW 厚膜电阻 | 0.0095 | 2486029 | 1 | Resistors | 2026-06-07 09:28:36 | 20 | 0.19
C17667 | 18355-0805W8F4301T5E/C17667 | https://www.lcsc.com/datasheet/lcsc_datasheet_2206010200_UNI-ROYAL-Uniroyal-Elec-0805W8F4301T5E_C17667.pdf | expand | 0 | 2026-08-02 05:18:50 | UNI-ROYAL(Uniroyal Elec) | 0805W8F4301T5E | 0805 | Chip Resistor - Surface Mount | -55℃~+155℃ 125mW 150V 4.3kΩ Thick Film Resistor ±1% ±100ppm/℃ 0805 Chip Resistor - Surface Mount ROHS | 4.3kΩ ±1% 125mW 厚膜电阻 | 0.017 | 266200 | 1 | Resistors | 2026-06-07 09:28:36 | 20 | 0.34
C17673 | 18361-0805W8F4701T5E/C17673 | https://www.lcsc.com/datasheet/lcsc_datasheet_2206010200_UNI-ROYAL-Uniroyal-Elec-0805W8F4701T5E_C17673.pdf | base | 0 | 2026-08-02 05:18:50 | UNI-ROYAL(Uniroyal Elec) | 0805W8F4701T5E | 0805 | Chip Resistor - Surface Mount | -55℃~+155℃ 125mW 150V 4.7kΩ Thick Film Resistor ±1% ±100ppm/℃ 0805 Chip Resistor - Surface Mount ROHS | 4.7kΩ ±1% 125mW 厚膜电阻 | 0.011 | 7405086 | 1 | Resistors | 2026-06-07 09:28:36 | 20 | 0.22
C17675 | 18363-0805W8F470KT5E/C17675 | https://www.lcsc.com/datasheet/lcsc_datasheet_2206010200_UNI-ROYAL-Uniroyal-Elec-0805W8F470KT5E_C17675.pdf | base | 0 | 2026-08-02 05:18:50 | UNI-ROYAL(Uniroyal Elec) | 0805W8F470KT5E | 0805 | Chip Resistor - Surface Mount | -55℃~+155℃ 125mW 150V 4.7Ω Thick Film Resistor ±1% ±200ppm/℃ 0805 Chip Resistor - Surface Mount ROHS | 4.7Ω ±1% 125mW 厚膜电阻 | 0.0066 | 109150 | 1 | Resistors | 2026-06-07 09:28:36 | 20 | 0.132
C17677 | 18365-0805W8F4991T5E/C17677 | https://www.lcsc.com/datasheet/lcsc_datasheet_2206010200_UNI-ROYAL-Uniroyal-Elec-0805W8F4991T5E_C17677.pdf | expand | 0 | 2026-08-02 05:18:50 | UNI-ROYAL(Uniroyal Elec) | 0805W8F4991T5E | 0805 | Chip Resistor - Surface Mount | -55℃~+155℃ 125mW 150V 4.99kΩ Thick Film Resistor ±1% ±100ppm/℃ 0805 Chip Resistor - Surface Mount ROHS | 4.99kΩ ±1% 125mW 厚膜电阻 | 0.0063 | 188203 | 1 | Resistors | 2026-06-07 09:28:36 | 20 | 0.126
C17695 | 18383-0805W8F4302T5E/C17695 | https://www.lcsc.com/datasheet/lcsc_datasheet_2206010200_UNI-ROYAL-Uniroyal-Elec-0805W8F4302T5E_C17695.pdf | expand | 0 | 2026-08-02 05:18:50 | UNI-ROYAL(Uniroyal Elec) | 0805W8F4302T5E | 0805 | Chip Resistor - Surface Mount | -55℃~+155℃ 125mW 150V 43kΩ Thick Film Resistor ±1% ±100ppm/℃ 0805 Chip Resistor - Surface Mount ROHS | 43kΩ ±1% 125mW 厚膜电阻 | 0.0051 | 113820 | 1 | Resistors | 2026-06-07 09:28:36 | 20 | 0.102
C17709 | 18397-0805W8F4703T5E/C17709 | https://www.lcsc.com/datasheet/lcsc_datasheet_2206010200_UNI-ROYAL-Uniroyal-Elec-0805W8F4703T5E_C17709.pdf | base | 0 | 2026-08-02 05:18:50 | UNI-ROYAL(Uniroyal Elec) | 0805W8F4703T5E | 0805 | Chip Resistor - Surface Mount | -55℃~+155℃ 125mW 150V 470kΩ Thick Film Resistor ±1% ±100ppm/℃ 0805 Chip Resistor - Surface Mount ROHS | 470kΩ ±1% 125mW 厚膜电阻 | 0.0046 | 755640 | 1 | Resistors | 2026-06-07 09:28:36 | 20 | 0.092
C17710 | 18398-0805W8F4700T5E/C17710 | https://www.lcsc.com/datasheet/lcsc_datasheet_2206010200_UNI-ROYAL-Uniroyal-Elec-0805W8F4700T5E_C17710.pdf | base | 0 | 2026-08-02 05:18:50 | UNI-ROYAL(Uniroyal Elec) | 0805W8F4700T5E | 0805 | Chip Resistor - Surface Mount | -55℃~+155℃ 125mW 150V 470Ω Thick Film Resistor ±1% ±100ppm/℃ 0805 Chip Resistor - Surface Mount ROHS | 470Ω ±1% 125mW 厚膜电阻 | 0.0105 | 3383790 | 1 | Resistors | 2026-06-07 09:28:36 | 20 | 0.21
C17713 | 18401-0805W8F4702T5E/C17713 | https://www.lcsc.com/datasheet/lcsc_datasheet_2206010200_UNI-ROYAL-Uniroyal-Elec-0805W8F4702T5E_C17713.pdf | base | 0 | 2026-08-02 05:18:50 | UNI-ROYAL(Uniroyal Elec) | 0805W8F4702T5E | 0805 | Chip Resistor - Surface Mount | -55℃~+155℃ 125mW 150V 47kΩ Thick Film Resistor ±1% ±100ppm/℃ 0805 Chip Resistor - Surface Mount ROHS | 47kΩ ±1% 125mW 厚膜电阻 | 0.0131 | 2672342 | 1 | Resistors | 2026-06-07 09:28:36 | 20 | 0.262
C17714 | 18402-0805W8F470JT5E/C17714 | https://www.lcsc.com/datasheet/lcsc_datasheet_2206010200_UNI-ROYAL-Uniroyal-Elec-0805W8F470JT5E_C17714.pdf | base | 0 | 2026-08-02 05:18:50 | UNI-ROYAL(Uniroyal Elec) | 0805W8F470JT5E | 0805 | Chip Resistor - Surface Mount | -55℃~+155℃ 125mW 150V 47Ω Thick Film Resistor ±1% ±100ppm/℃ 0805 Chip Resistor - Surface Mount ROHS | 47Ω ±1% 125mW 厚膜电阻 | 0.0092 | 920282 | 1 | Resistors | 2026-06-07 09:28:36 | 20 | 0.184
C17719 | 18407-0805W8F4992T5E/C17719 | https://www.lcsc.com/datasheet/lcsc_datasheet_2206010200_UNI-ROYAL-Uniroyal-Elec-0805W8F4992T5E_C17719.pdf | expand | 0 | 2026-08-02 05:18:50 | UNI-ROYAL(Uniroyal Elec) | 0805W8F4992T5E | 0805 | Chip Resistor - Surface Mount | -55℃~+155℃ 125mW 150V 49.9kΩ Thick Film Resistor ±1% ±100ppm/℃ 0805 Chip Resistor - Surface Mount ROHS | 49.9kΩ ±1% 125mW 厚膜电阻 | 0.0089 | 91548 | 1 | Resistors | 2026-06-07 09:28:36 | 20 | 0.178
C17720 | 18408-0805W8F499JT5E/C17720 | https://www.lcsc.com/datasheet/lcsc_datasheet_2206010200_UNI-ROYAL-Uniroyal-Elec-0805W8F499JT5E_C17720.pdf | base | 0 | 2026-08-02 05:18:50 | UNI-ROYAL(Uniroyal Elec) | 0805W8F499JT5E | 0805 | Chip Resistor - Surface Mount | -55℃~+155℃ 125mW 150V 49.9Ω Thick Film Resistor ±1% ±100ppm/℃ 0805 Chip Resistor - Surface Mount ROHS | 49.9Ω ±1% 125mW 厚膜电阻 | 0.0121 | 918456 | 1 | Resistors | 2026-06-07 09:28:36 | 20 | 0.242
C17724 | 18412-0805W8F510KT5E/C17724 | https://www.lcsc.com/datasheet/lcsc_datasheet_2206010200_UNI-ROYAL-Uniroyal-Elec-0805W8F510KT5E_C17724.pdf | base | 0 | 2026-08-02 05:18:50 | UNI-ROYAL(Uniroyal Elec) | 0805W8F510KT5E | 0805 | Chip Resistor - Surface Mount | -55℃~+155℃ 125mW 150V 5.1Ω Thick Film Resistor ±1% ±200ppm/℃ 0805 Chip Resistor - Surface Mount ROHS | 5.1Ω ±1% 125mW 厚膜电阻 | 0.0069 | 749134 | 1 | Resistors | 2026-06-07 09:28:36 | 20 | 0.138
C17733 | 18421-0805W8F5103T5E/C17733 | https://www.lcsc.com/datasheet/lcsc_datasheet_2206010200_UNI-ROYAL-Uniroyal-Elec-0805W8F5103T5E_C17733.pdf | expand | 0 | 2026-08-02 05:18:50 | UNI-ROYAL(Uniroyal Elec) | 0805W8F5103T5E | 0805 | Chip Resistor - Surface Mount | -55℃~+155℃ 125mW 150V 510kΩ Thick Film Resistor ±1% ±100ppm/℃ 0805 Chip Resistor - Surface Mount ROHS | 510kΩ ±1% 125mW 厚膜电阻 | 0.0122 | 412134 | 1 | Resistors | 2026-06-07 09:28:36 | 20 | 0.244
C17734 | 18422-0805W8F5100T5E/C17734 | https://www.lcsc.com/datasheet/lcsc_datasheet_2206010200_UNI-ROYAL-Uniroyal-Elec-0805W8F5100T5E_C17734.pdf | base | 0 | 2026-08-02 05:18:50 | UNI-ROYAL(Uniroyal Elec) | 0805W8F5100T5E | 0805 | Chip Resistor - Surface Mount | -55℃~+155℃ 125mW 150V 510Ω Thick Film Resistor ±1% ±100ppm/℃ 0805 Chip Resistor - Surface Mount ROHS | 510Ω ±1% 125mW 厚膜电阻 | 0.009 | 3033409 | 1 | Resistors | 2026-06-07 09:28:36 | 20 | 0.18
C17737 | 18425-0805W8F5102T5E/C17737 | https://www.lcsc.com/datasheet/lcsc_datasheet_2206010200_UNI-ROYAL-Uniroyal-Elec-0805W8F5102T5E_C17737.pdf | base | 0 | 2026-08-02 05:18:50 | UNI-ROYAL(Uniroyal Elec) | 0805W8F5102T5E | 0805 | Chip Resistor - Surface Mount | -55℃~+155℃ 125mW 150V 51kΩ Thick Film Resistor ±1% ±100ppm/℃ 0805 Chip Resistor - Surface Mount ROHS | 51kΩ ±1% 125mW 厚膜电阻 | 0.0146 | 1245793 | 1 | Resistors | 2026-06-07 09:28:36 | 20 | 0.292
C17738 | 18426-0805W8F510JT5E/C17738 | https://www.lcsc.com/datasheet/lcsc_datasheet_2411221126_UNI-ROYAL-Uniroyal-Elec-0805W8F510JT5E_C17738.pdf | base | 0 | 2026-08-02 05:18:50 | UNI-ROYAL(Uniroyal Elec) | 0805W8F510JT5E | 0805 | Chip Resistor - Surface Mount | -55℃~+155℃ 125mW 150V 51Ω Thick Film Resistor ±1% ±100ppm/℃ 0805 Chip Resistor - Surface Mount ROHS | 51Ω ±1% 125mW 厚膜电阻 | 0.0054 | 1074615 | 1 | Resistors | 2026-06-07 09:28:36 | 20 | 0.108
C17756 | 18444-0805W8F5602T5E/C17756 | https://www.lcsc.com/datasheet/lcsc_datasheet_2206010200_UNI-ROYAL-Uniroyal-Elec-0805W8F5602T5E_C17756.pdf | expand | 0 | 2026-08-02 05:18:50 | UNI-ROYAL(Uniroyal Elec) | 0805W8F5602T5E | 0805 | Chip Resistor - Surface Mount | -55℃~+155℃ 125mW 150V 56kΩ Thick Film Resistor ±1% ±100ppm/℃ 0805 Chip Resistor - Surface Mount ROHS | 56kΩ ±1% 125mW 厚膜电阻 | 0.0059 | 640653 | 1 | Resistors | 2026-06-07 09:28:36 | 20 | 0.118
C17757 | 18445-0805W8F560JT5E/C17757 | https://www.lcsc.com/datasheet/lcsc_datasheet_2206010200_UNI-ROYAL-Uniroyal-Elec-0805W8F560JT5E_C17757.pdf | expand | 0 | 2026-08-02 05:18:50 | UNI-ROYAL(Uniroyal Elec) | 0805W8F560JT5E | 0805 | Chip Resistor - Surface Mount | -55℃~+155℃ 125mW 150V 56Ω Thick Film Resistor ±1% ±100ppm/℃ 0805 Chip Resistor - Surface Mount ROHS | 56Ω ±1% 125mW 厚膜电阻 | 0.0092 | 16423 | 974 | Resistors | 2026-06-07 09:28:36 | 984 | 9.0528
C17767 | 18455-0805W8F6201T5E/C17767 | https://www.lcsc.com/datasheet/lcsc_datasheet_2205311830_UNI-ROYAL-Uniroyal-Elec-0805W8F6201T5E_C17767.pdf | expand | 0 | 2026-08-02 05:18:50 | UNI-ROYAL(Uniroyal Elec) | 0805W8F6201T5E | 0805 | Chip Resistor - Surface Mount | -55℃~+155℃ 125mW 150V 6.2kΩ Thick Film Resistor ±1% ±100ppm/℃ 0805 Chip Resistor - Surface Mount ROHS | 6.2kΩ ±1% 125mW 厚膜电阻 | 0.006 | 207048 | 1 | Resistors | 2026-06-07 09:28:36 | 20 | 0.12
C17772 | 18460-0805W8F6801T5E/C17772 | https://www.lcsc.com/datasheet/lcsc_datasheet_2205311830_UNI-ROYAL-Uniroyal-Elec-0805W8F6801T5E_C17772.pdf | base | 0 | 2026-08-02 05:18:50 | UNI-ROYAL(Uniroyal Elec) | 0805W8F6801T5E | 0805 | Chip Resistor - Surface Mount | -55℃~+155℃ 125mW 150V 6.8kΩ Thick Film Resistor ±1% ±100ppm/℃ 0805 Chip Resistor - Surface Mount ROHS | 6.8kΩ ±1% 125mW 厚膜电阻 | 0.0142 | 654987 | 1 | Resistors | 2026-06-07 09:28:36 | 20 | 0.284
C17783 | 18471-0805W8F6202T5E/C17783 | https://www.lcsc.com/datasheet/lcsc_datasheet_2205311830_UNI-ROYAL-Uniroyal-Elec-0805W8F6202T5E_C17783.pdf | expand | 0 | 2026-08-02 05:18:50 | UNI-ROYAL(Uniroyal Elec) | 0805W8F6202T5E | 0805 | Chip Resistor - Surface Mount | -55℃~+155℃ 125mW 150V 62kΩ Thick Film Resistor ±1% ±100ppm/℃ 0805 Chip Resistor - Surface Mount ROHS | 62kΩ ±1% 125mW 厚膜电阻 | 0.0041 | 375055 | 1 | Resistors | 2026-06-07 09:28:36 | 20 | 0.082
C1779 | 2131-CL21A475KAQNNNE/C1779 | https://www.lcsc.com/datasheet/lcsc_datasheet_2304140030_Samsung-Electro-Mechanics-CL21A475KAQNNNE_C1779.pdf | base | 0 | 2026-08-02 05:18:50 | Samsung Electro-Mechanics | CL21A475KAQNNNE | 0805 | Multilayer Ceramic Capacitors MLCC - SMD/SMT | 25V 4.7uF X5R ±10% 0805 Multilayer Ceramic Capacitors MLCC - SMD/SMT ROHS | 4.7uF ±10% 25V | 0.0454 | 3660909 | 1 | Capacitors | 2026-06-07 09:28:36 | 20 | 0.908
C17797 | 18485-0805W8F6803T5E/C17797 | https://www.lcsc.com/datasheet/lcsc_datasheet_2205311830_UNI-ROYAL-Uniroyal-Elec-0805W8F6803T5E_C17797.pdf | expand | 0 | 2026-08-02 05:18:50 | UNI-ROYAL(Uniroyal Elec) | 0805W8F6803T5E | 0805 | Chip Resistor - Surface Mount | -55℃~+155℃ 125mW 150V 680kΩ Thick Film Resistor ±1% ±100ppm/℃ 0805 Chip Resistor - Surface Mount ROHS | 680kΩ ±1% 125mW 厚膜电阻 | 0.0041 | 96123 | 1 | Resistors | 2026-06-07 09:28:36 | 20 | 0.082
C17798 | 18486-0805W8F6800T5E/C17798 | https://www.lcsc.com/datasheet/lcsc_datasheet_2205311830_UNI-ROYAL-Uniroyal-Elec-0805W8F6800T5E_C17798.pdf | base | 0 | 2026-08-02 05:18:50 | UNI-ROYAL(Uniroyal Elec) | 0805W8F6800T5E | 0805 | Chip Resistor - Surface Mount | -55℃~+155℃ 125mW 150V 680Ω Thick Film Resistor ±1% ±100ppm/℃ 0805 Chip Resistor - Surface Mount ROHS | 680Ω ±1% 125mW 厚膜电阻 | 0.0112 | 1540821 | 1 | Resistors | 2026-06-07 09:28:36 | 20 | 0.224
C17801 | 18489-0805W8F6802T5E/C17801 | https://www.lcsc.com/datasheet/lcsc_datasheet_2205311830_UNI-ROYAL-Uniroyal-Elec-0805W8F6802T5E_C17801.pdf | base | 0 | 2026-08-02 05:18:50 | UNI-ROYAL(Uniroyal Elec) | 0805W8F6802T5E | 0805 | Chip Resistor - Surface Mount | -55℃~+155℃ 125mW 150V 68kΩ Thick Film Resistor ±1% ±100ppm/℃ 0805 Chip Resistor - Surface Mount ROHS | 68kΩ ±1% 125mW 厚膜电阻 | 0.0038 | 366155 | 1 | Resistors | 2026-06-07 09:28:36 | 20 | 0.076
C17802 | 18490-0805W8F680JT5E/C17802 | https://www.lcsc.com/datasheet/lcsc_datasheet_2205311830_UNI-ROYAL-Uniroyal-Elec-0805W8F680JT5E_C17802.pdf | expand | 0 | 2026-08-02 05:18:50 | UNI-ROYAL(Uniroyal Elec) | 0805W8F680JT5E | 0805 | Chip Resistor - Surface Mount | -55℃~+155℃ 125mW 150V 68Ω Thick Film Resistor ±1% ±200ppm/℃ 0805 Chip Resistor - Surface Mount ROHS | 68Ω ±1% 125mW 厚膜电阻 | 0.0163 | 80946 | 1 | Resistors | 2026-06-07 09:28:36 | 20 | 0.326
C17807 | 18495-0805W8F7501T5E/C17807 | https://www.lcsc.com/datasheet/lcsc_datasheet_2205311830_UNI-ROYAL-Uniroyal-Elec-0805W8F7501T5E_C17807.pdf | expand | 0 | 2026-08-02 05:18:50 | UNI-ROYAL(Uniroyal Elec) | 0805W8F7501T5E | 0805 | Chip Resistor - Surface Mount | -55℃~+155℃ 125mW 150V 7.5kΩ Thick Film Resistor ±1% ±100ppm/℃ 0805 Chip Resistor - Surface Mount ROHS | 7.5kΩ ±1% 125mW 厚膜电阻 | 0.0051 | 502139 | 1 | Resistors | 2026-06-07 09:28:36 | 20 | 0.102
C17818 | 18506-0805W8F7500T5E/C17818 | https://www.lcsc.com/datasheet/lcsc_datasheet_2205311830_UNI-ROYAL-Uniroyal-Elec-0805W8F7500T5E_C17818.pdf | expand | 0 | 2026-08-02 05:18:50 | UNI-ROYAL(Uniroyal Elec) | 0805W8F7500T5E | 0805 | Chip Resistor - Surface Mount | -55℃~+155℃ 125mW 150V 750Ω Thick Film Resistor ±1% ±100ppm/℃ 0805 Chip Resistor - Surface Mount ROHS | 750Ω ±1% 125mW 厚膜电阻 | 0.0044 | 404513 | 1 | Resistors | 2026-06-07 09:28:36 | 20 | 0.088
C17819 | 18507-0805W8F7502T5E/C17819 | https://www.lcsc.com/datasheet/lcsc_datasheet_2205311830_UNI-ROYAL-Uniroyal-Elec-0805W8F7502T5E_C17819.pdf | expand | 0 | 2026-08-02 05:18:50 | UNI-ROYAL(Uniroyal Elec) | 0805W8F7502T5E | 0805 | Chip Resistor - Surface Mount | -55℃~+155℃ 125mW 150V 75kΩ Thick Film Resistor ±1% ±100ppm/℃ 0805 Chip Resistor - Surface Mount ROHS | 75kΩ ±1% 125mW 厚膜电阻 | 0.0163 | 818812 | 1 | Resistors | 2026-06-07 09:28:36 | 20 | 0.326
C17828 | 18516-0805W8F8201T5E/C17828 | https://www.lcsc.com/datasheet/lcsc_datasheet_2205311830_UNI-ROYAL-Uniroyal-Elec-0805W8F8201T5E_C17828.pdf | base | 0 | 2026-08-02 05:18:50 | UNI-ROYAL(Uniroyal Elec) | 0805W8F8201T5E | 0805 | Chip Resistor - Surface Mount | -55℃~+155℃ 125mW 150V 8.2kΩ Thick Film Resistor ±1% ±100ppm/℃ 0805 Chip Resistor - Surface Mount ROHS | 8.2kΩ ±1% 125mW 厚膜电阻 | 0.0038 | 551182 | 1 | Resistors | 2026-06-07 09:28:36 | 20 | 0.076
C17837 | 18525-0805W8F8200T5E/C17837 | https://www.lcsc.com/datasheet/lcsc_datasheet_2205311830_UNI-ROYAL-Uniroyal-Elec-0805W8F8200T5E_C17837.pdf | expand | 0 | 2026-08-02 05:18:50 | UNI-ROYAL(Uniroyal Elec) | 0805W8F8200T5E | 0805 | Chip Resistor - Surface Mount | -55℃~+155℃ 125mW 150V 820Ω Thick Film Resistor ±1% ±100ppm/℃ 0805 Chip Resistor - Surface Mount ROHS | 820Ω ±1% 125mW 厚膜电阻 | 0.016 | 243091 | 1 | Resistors | 2026-06-07 09:28:36 | 20 | 0.32
C17840 | 18528-0805W8F8202T5E/C17840 | https://www.lcsc.com/datasheet/lcsc_datasheet_2205311830_UNI-ROYAL-Uniroyal-Elec-0805W8F8202T5E_C17840.pdf | expand | 0 | 2026-08-02 05:18:50 | UNI-ROYAL(Uniroyal Elec) | 0805W8F8202T5E | 0805 | Chip Resistor - Surface Mount | -55℃~+155℃ 125mW 150V 82kΩ Thick Film Resistor ±1% ±100ppm/℃ 0805 Chip Resistor - Surface Mount ROHS | 82kΩ ±1% 125mW 厚膜电阻 | 0.0113 | 125030 | 1 | Resistors | 2026-06-07 09:28:36 | 20 | 0.226
C17855 | 18543-0805W8F9101T5E/C17855 | https://www.lcsc.com/datasheet/lcsc_datasheet_2206010200_UNI-ROYAL-Uniroyal-Elec-0805W8F9101T5E_C17855.pdf | expand | 0 | 2026-08-02 05:18:50 | UNI-ROYAL(Uniroyal Elec) | 0805W8F9101T5E | 0805 | Chip Resistor - Surface Mount | -55℃~+155℃ 125mW 150V 9.1kΩ Thick Film Resistor ±1% ±100ppm/℃ 0805 Chip Resistor - Surface Mount ROHS | 9.1kΩ ±1% 125mW 厚膜电阻 | 0.0041 | 153864 | 1 | Resistors | 2026-06-07 09:28:36 | 20 | 0.082
C17887 | 18575-1206W4F3000T5E/C17887 | https://www.lcsc.com/datasheet/lcsc_datasheet_2206010200_UNI-ROYAL-Uniroyal-Elec-1206W4F3000T5E_C17887.pdf | base | 0 | 2026-08-02 05:18:50 | UNI-ROYAL(Uniroyal Elec) | 1206W4F3000T5E | 1206 | Chip Resistor - Surface Mount | -55℃~+155℃ 200V 250mW 300Ω Thick Film Resistor ±1% ±100ppm/℃ 1206 Chip Resistor - Surface Mount ROHS | 300Ω ±1% 250mW 厚膜电阻 | 0.012 | 591256 | 1 | Resistors | 2026-06-07 09:28:36 | 15 | 0.18
C17888 | 18576-1206W4F0000T5E/C17888 | https://www.lcsc.com/datasheet/lcsc_datasheet_2206010200_UNI-ROYAL-Uniroyal-Elec-1206W4F0000T5E_C17888.pdf | base | 0 | 2026-08-02 05:18:50 | UNI-ROYAL(Uniroyal Elec) | 1206W4F0000T5E | 1206 | Chip Resistor - Surface Mount | -55℃~+155℃ 0Ω 200V 250mW Thick Film Resistor ±1% ±800ppm/℃ 1206 Chip Resistor - Surface Mount ROHS | 0Ω ±1% 250mW 厚膜电阻 | 0.0218 | 3422433 | 1 | Resistors | 2026-06-07 09:28:36 | 15 | 0.327
C1790 | 2142-CL21C101JBANNNC/C1790 | https://www.lcsc.com/datasheet/lcsc_datasheet_2304140030_Samsung-Electro-Mechanics-CL21C101JBANNNC_C1790.pdf | base | 0 | 2026-08-02 05:18:50 | Samsung Electro-Mechanics | CL21C101JBANNNC | 0805 | Multilayer Ceramic Capacitors MLCC - SMD/SMT | 100pF 50V C0G ±5% 0805 Multilayer Ceramic Capacitors MLCC - SMD/SMT ROHS | 100pF ±5% 50V | 0.0091 | 1212595 | 1 | Capacitors | 2026-06-07 09:28:36 | 20 | 0.182
C17900 | 18588-1206W4F1003T5E/C17900 | https://www.lcsc.com/datasheet/lcsc_datasheet_2206010145_UNI-ROYAL-Uniroyal-Elec-1206W4F1003T5E_C17900.pdf | base | 0 | 2026-08-02 05:18:50 | UNI-ROYAL(Uniroyal Elec) | 1206W4F1003T5E | 1206 | Chip Resistor - Surface Mount | -55℃~+155℃ 100kΩ 200V 250mW Thick Film Resistor ±1% ±100ppm/℃ 1206 Chip Resistor - Surface Mount ROHS | 100kΩ ±1% 250mW 厚膜电阻 | 0.0233 | 1981884 | 1 | Resistors | 2026-06-07 09:28:36 | 15 | 0.3495
C17901 | 18589-1206W4F1000T5E/C17901 | https://www.lcsc.com/datasheet/lcsc_datasheet_2206010145_UNI-ROYAL-Uniroyal-Elec-1206W4F1000T5E_C17901.pdf | base | 0 | 2026-08-02 05:18:50 | UNI-ROYAL(Uniroyal Elec) | 1206W4F1000T5E | 1206 | Chip Resistor - Surface Mount | -55℃~+155℃ 100Ω 200V 250mW Thick Film Resistor ±1% ±100ppm/℃ 1206 Chip Resistor - Surface Mount ROHS | 100Ω ±1% 250mW 厚膜电阻 | 0.0146 | 2512453 | 1 | Resistors | 2026-06-07 09:28:36 | 15 | 0.219
C17902 | 18590-1206W4F1002T5E/C17902 | https://www.lcsc.com/datasheet/lcsc_datasheet_2206010145_UNI-ROYAL-Uniroyal-Elec-1206W4F1002T5E_C17902.pdf | base | 0 | 2026-08-02 05:18:50 | UNI-ROYAL(Uniroyal Elec) | 1206W4F1002T5E | 1206 | Chip Resistor - Surface Mount | -55℃~+155℃ 10kΩ 200V 250mW Thick Film Resistor ±1% ±100ppm/℃ 1206 Chip Resistor - Surface Mount ROHS | 10kΩ ±1% 250mW 厚膜电阻 | 0.0207 | 3796580 | 1 | Resistors | 2026-06-07 09:28:36 | 15 | 0.3105
C17903 | 18591-1206W4F100JT5E/C17903 | https://www.lcsc.com/datasheet/lcsc_datasheet_2206010145_UNI-ROYAL-Uniroyal-Elec-1206W4F100JT5E_C17903.pdf | base | 0 | 2026-08-02 05:18:50 | UNI-ROYAL(Uniroyal Elec) | 1206W4F100JT5E | 1206 | Chip Resistor - Surface Mount | -55℃~+155℃ 10Ω 200V 250mW Thick Film Resistor ±1% ±400ppm/℃ 1206 Chip Resistor - Surface Mount ROHS | 10Ω ±1% 250mW 厚膜电阻 | 0.021 | 2192297 | 1 | Resistors | 2026-06-07 09:28:36 | 15 | 0.315
C17909 | 18597-1206W4F1200T5E/C17909 | https://www.lcsc.com/datasheet/lcsc_datasheet_2206010145_UNI-ROYAL-Uniroyal-Elec-1206W4F1200T5E_C17909.pdf | base | 0 | 2026-08-02 05:18:50 | UNI-ROYAL(Uniroyal Elec) | 1206W4F1200T5E | 1206 | Chip Resistor - Surface Mount | -55℃~+155℃ 120Ω 200V 250mW Thick Film Resistor ±1% ±100ppm/℃ 1206 Chip Resistor - Surface Mount ROHS | 120Ω ±1% 250mW 厚膜电阻 | 0.0132 | 1141018 | 1 | Resistors | 2026-06-07 09:28:36 | 15 | 0.198
C1792 | 2144-0805CG120J500NT/C1792 | https://www.lcsc.com/datasheet/lcsc_datasheet_2304140030_FH--Guangdong-Fenghua-Advanced-Tech-0805CG120J500NT_C1792.pdf | expand | 0 | 2026-08-02 05:18:50 | FH (Guangdong Fenghua Advanced Tech) | 0805CG120J500NT | 0805 | Multilayer Ceramic Capacitors MLCC - SMD/SMT | 12pF 50V C0G ±5% 0805 Multilayer Ceramic Capacitors MLCC - SMD/SMT ROHS | 12pF ±5% 50V | 0.0153 | 35109 | 586 | Capacitors | 2026-06-07 09:28:36 | 596 | 9.1188
C17924 | 18612-1206W4F1800T5E/C17924 | https://www.lcsc.com/datasheet/lcsc_datasheet_2206010145_UNI-ROYAL-Uniroyal-Elec-1206W4F1800T5E_C17924.pdf | expand | 0 | 2026-08-02 05:18:50 | UNI-ROYAL(Uniroyal Elec) | 1206W4F1800T5E | 1206 | Chip Resistor - Surface Mount | -55℃~+155℃ 180Ω 200V 250mW Thick Film Resistor ±1% ±100ppm/℃ 1206 Chip Resistor - Surface Mount ROHS | 180Ω ±1% 250mW 厚膜电阻 | 0.0234 | 171974 | 1 | Resistors | 2026-06-07 09:28:36 | 15 | 0.351
C17927 | 18615-1206W4F1004T5E/C17927 | https://www.lcsc.com/datasheet/lcsc_datasheet_2206010145_UNI-ROYAL-Uniroyal-Elec-1206W4F1004T5E_C17927.pdf | base | 0 | 2026-08-02 05:18:50 | UNI-ROYAL(Uniroyal Elec) | 1206W4F1004T5E | 1206 | Chip Resistor - Surface Mount | -55℃~+155℃ 1MΩ 200V 250mW Thick Film Resistor ±1% ±100ppm/℃ 1206 Chip Resistor - Surface Mount ROHS | 1MΩ ±1% 250mW 厚膜电阻 | 0.0077 | 5624460 | 1 | Resistors | 2026-06-07 09:28:36 | 15 | 0.1155
C17928 | 18616-1206W4F100KT5E/C17928 | https://www.lcsc.com/datasheet/lcsc_datasheet_2206010145_UNI-ROYAL-Uniroyal-Elec-1206W4F100KT5E_C17928.pdf | base | 0 | 2026-08-02 05:18:50 | UNI-ROYAL(Uniroyal Elec) | 1206W4F100KT5E | 1206 | Chip Resistor - Surface Mount | -55℃~+155℃ 1Ω 200V 250mW Thick Film Resistor ±1% ±200ppm/℃ 1206 Chip Resistor - Surface Mount ROHS | 1Ω ±1% 250mW 厚膜电阻 | 0.0454 | 312170 | 1 | Resistors | 2026-06-07 09:28:36 | 15 | 0.681
C17936 | 18624-1206W4F4701T5E/C17936 | https://www.lcsc.com/datasheet/lcsc_datasheet_2206010145_UNI-ROYAL-Uniroyal-Elec-1206W4F4701T5E_C17936.pdf | base | 0 | 2026-08-02 05:18:50 | UNI-ROYAL(Uniroyal Elec) | 1206W4F4701T5E | 1206 | Chip Resistor - Surface Mount | -55℃~+155℃ 200V 250mW 4.7kΩ Thick Film Resistor ±1% ±100ppm/℃ 1206 Chip Resistor - Surface Mount ROHS | 4.7kΩ ±1% 250mW 厚膜电阻 | 0.0205 | 4066321 | 1 | Resistors | 2026-06-07 09:28:36 | 15 | 0.3075
C17944 | 18632-1206W4F2001T5E/C17944 | https://www.lcsc.com/datasheet/lcsc_datasheet_2206010145_UNI-ROYAL-Uniroyal-Elec-1206W4F2001T5E_C17944.pdf | base | 0 | 2026-08-02 05:18:50 | UNI-ROYAL(Uniroyal Elec) | 1206W4F2001T5E | 1206 | Chip Resistor - Surface Mount | -55℃~+155℃ 200V 250mW 2kΩ Thick Film Resistor ±1% ±100ppm/℃ 1206 Chip Resistor - Surface Mount ROHS | 2kΩ ±1% 250mW 厚膜电阻 | 0.0158 | 769794 | 1 | Resistors | 2026-06-07 09:28:36 | 15 | 0.237
C17955 | 18643-1206W4F200JT5E/C17955 | https://www.lcsc.com/datasheet/lcsc_datasheet_2206010145_UNI-ROYAL-Uniroyal-Elec-1206W4F200JT5E_C17955.pdf | base | 0 | 2026-08-02 05:18:50 | UNI-ROYAL(Uniroyal Elec) | 1206W4F200JT5E | 1206 | Chip Resistor - Surface Mount | -55℃~+155℃ 200V 20Ω 250mW Thick Film Resistor ±1% ±100ppm/℃ 1206 Chip Resistor - Surface Mount ROHS | 20Ω ±1% 250mW 厚膜电阻 | 0.0205 | 753406 | 1 | Resistors | 2026-06-07 09:28:36 | 15 | 0.3075
C17958 | 18646-1206W4F220JT5E/C17958 | https://www.lcsc.com/datasheet/lcsc_datasheet_2206010145_UNI-ROYAL-Uniroyal-Elec-1206W4F220JT5E_C17958.pdf | base | 0 | 2026-08-02 05:18:50 | UNI-ROYAL(Uniroyal Elec) | 1206W4F220JT5E | 1206 | Chip Resistor - Surface Mount | -55℃~+155℃ 200V 22Ω 250mW Thick Film Resistor ±1% ±100ppm/℃ 1206 Chip Resistor - Surface Mount ROHS | 22Ω ±1% 250mW 厚膜电阻 | 0.0138 | 408748 | 1 | Resistors | 2026-06-07 09:28:36 | 15 | 0.207
C1797 | 2149-0805CG180J500NT/C1797 | https://www.lcsc.com/datasheet/lcsc_datasheet_2304140030_FH--Guangdong-Fenghua-Advanced-Tech-0805CG180J500NT_C1797.pdf | expand | 0 | 2026-08-02 05:18:50 | FH (Guangdong Fenghua Advanced Tech) | 0805CG180J500NT | 0805 | Multilayer Ceramic Capacitors MLCC - SMD/SMT | 18pF 50V C0G ±5% 0805 Multilayer Ceramic Capacitors MLCC - SMD/SMT ROHS | 18pF ±5% 50V | 0.0124 | 215767 | 1 | Capacitors | 2026-06-07 09:28:36 | 20 | 0.248
C1798 | 2150-CL21C200JBANNNC/C1798 | https://www.lcsc.com/datasheet/lcsc_datasheet_2304140030_Samsung-Electro-Mechanics-CL21C200JBANNNC_C1798.pdf | base | 0 | 2026-08-02 05:18:50 | Samsung Electro-Mechanics | CL21C200JBANNNC | 0805 | Multilayer Ceramic Capacitors MLCC - SMD/SMT | 20pF 50V C0G ±5% 0805 Multilayer Ceramic Capacitors MLCC - SMD/SMT ROHS | 20pF ±5% 50V | 0.0173 | 320624 | 1 | Capacitors | 2026-06-07 09:28:36 | 20 | 0.346
C17985 | 18673-1206W4F7500T5E/C17985 | https://www.lcsc.com/datasheet/lcsc_datasheet_2206010145_UNI-ROYAL-Uniroyal-Elec-1206W4F7500T5E_C17985.pdf | expand | 0 | 2026-08-02 05:18:50 | UNI-ROYAL(Uniroyal Elec) | 1206W4F7500T5E | 1206 | Chip Resistor - Surface Mount | -55℃~+155℃ 200V 250mW 750Ω Thick Film Resistor ±1% ±100ppm/℃ 1206 Chip Resistor - Surface Mount ROHS | 750Ω ±1% 250mW 厚膜电阻 | 0.0143 | 153293 | 1 | Resistors | 2026-06-07 09:28:36 | 15 | 0.2145
C1804 | 2156-CL21C220JBANNNC/C1804 | https://www.lcsc.com/datasheet/lcsc_datasheet_2304140030_Samsung-Electro-Mechanics-CL21C220JBANNNC_C1804.pdf | base | 0 | 2026-08-02 05:18:50 | Samsung Electro-Mechanics | CL21C220JBANNNC | 0805 | Multilayer Ceramic Capacitors MLCC - SMD/SMT | 22pF 50V C0G ±5% 0805 Multilayer Ceramic Capacitors MLCC - SMD/SMT ROHS | 22pF ±5% 50V | 0.018 | 1214149 | 1 | Capacitors | 2026-06-07 09:28:36 | 20 | 0.36
C18199085 | hongjiacheng-1N4001W/C18199085 | https://wmsc.lcsc.com/wmsc/upload/file/pdf/v2/lcsc/2309251015_hongjiacheng-1N4001W_C18199085.pdf | expand | 0 | 2026-08-02 05:18:50 | hongjiacheng | 1N4001W | SOD-123FL | Diodes - General Purpose | -55℃~+150℃ 1A 1V@1A 2uA@50V 30A 50V Standalone SOD-123FL Diodes - General Purpose ROHS | 1N4001W | 0.0084 | 136547 | 1 | Diodes | 2026-06-07 09:28:36 | 15 | 0.126
C18199086 | hongjiacheng-1N4002W/C18199086 | https://wmsc.lcsc.com/wmsc/upload/file/pdf/v2/lcsc/2309251425_hongjiacheng-1N4002W_C18199086.pdf | expand | 0 | 2026-08-02 05:18:50 | hongjiacheng | 1N4002W | SOD-123FL | Diodes - General Purpose | -55℃~+150℃ 100V 1A 1V@1A 2uA@100V 30A Standalone SOD-123FL Diodes - General Purpose ROHS | 1N4002W | 0.0093 | 87170 | 1 | Diodes | 2026-06-07 09:28:36 | 15 | 0.1395
C18199087 | hongjiacheng-1N4004W/C18199087 | https://wmsc.lcsc.com/wmsc/upload/file/pdf/v2/lcsc/2309251425_hongjiacheng-1N4004W_C18199087.pdf | expand | 0 | 2026-08-02 05:18:50 | hongjiacheng | 1N4004W | SOD-123FL | Diodes - General Purpose | -55℃~+150℃ 1A 1V@1A 2uA@400V 30A 400V Independent SOD-123FL Diodes - General Purpose ROHS | 1N4004W | 0.0098 | 219027 | 1 | Diodes | 2026-06-07 09:28:36 | 15 | 0.147
C18199088 | hongjiacheng-1N4007W/C18199088 | https://wmsc.lcsc.com/wmsc/upload/file/pdf/v2/lcsc/2309251425_hongjiacheng-1N4007W_C18199088.pdf | expand | 0 | 2026-08-02 05:18:50 | hongjiacheng | 1N4007W | SOD-123FL | Diodes - General Purpose | -55℃~+150℃ 1A 1V@1A 1kV 2uA@1000V 30A Standalone SOD-123FL Diodes - General Purpose ROHS | 1N4007W | 0.0078 | 1246688 | 1 | Diodes | 2026-06-07 09:28:36 | 15 | 0.117
C18199089 | hongjiacheng-M1F/C18199089 | https://wmsc.lcsc.com/wmsc/upload/file/pdf/v2/lcsc/2309251015_hongjiacheng-M1F_C18199089.pdf | expand | 0 | 2026-08-02 05:18:50 | hongjiacheng | M1F | SMAF | Diodes - General Purpose | -55℃~+150℃ 1A 1V@1A 2uA@50V 30A 50V Standalone SMAF Diodes - General Purpose ROHS | M1F | 0.011 | 15318 | 1 | Diodes | 2026-06-07 09:28:36 | 15 | 0.165
C18199090 | hongjiacheng-M7F/C18199090 | https://wmsc.lcsc.com/wmsc/upload/file/pdf/v2/lcsc/2309251425_hongjiacheng-M7F_C18199090.pdf | expand | 0 | 2026-08-02 05:18:50 | hongjiacheng | M7F | SMAF | Diodes - General Purpose | -55℃~+150℃ 1A 1V@1A 1kV 2uA@1000V 30A Standalone SMAF Diodes - General Purpose ROHS | M7F | 0.0122 | 25400 | 1 | Diodes | 2026-06-07 09:28:36 | 15 | 0.183
C18199091 | hongjiacheng-S2MF/C18199091 | https://wmsc.lcsc.com/wmsc/upload/file/pdf/v2/lcsc/2309251015_hongjiacheng-S2MF_C18199091.pdf | expand | 0 | 2026-08-02 05:18:50 | hongjiacheng | S2MF | SMAF | Diodes - General Purpose | -55℃~+150℃ 1V@2A 1kV 2A 2uA@1000V 50A Standalone SMAF Diodes - General Purpose ROHS | S2MF | 0.0143 | 137 | 1 | Diodes | 2026-06-07 09:28:36 | 15 | 0.2145
C18199092 | hongjiacheng-S3MF/C18199092 | https://wmsc.lcsc.com/wmsc/upload/file/pdf/v2/lcsc/2309251015_hongjiacheng-S3MF_C18199092.pdf | expand | 0 | 2026-08-02 05:18:50 | hongjiacheng | S3MF | SMAF | Diodes - General Purpose | -55℃~+150℃ 1.1V@3A 1kV 3A 5uA@1000V 80A Standalone SMAF Diodes - General Purpose ROHS | S3MF | 0.0225 | 95683 | 1 | Diodes | 2026-06-07 09:28:36 | 15 | 0.3375
C18199093 | hongjiacheng-M1/C18199093 | https://wmsc.lcsc.com/wmsc/upload/file/pdf/v2/lcsc/2310131745_hongjiacheng-M1_C18199093.pdf | expand | 0 | 2026-08-02 05:18:50 | hongjiacheng | M1 | SMA(DO-214AC) | Diodes - General Purpose | -55℃~+150℃ 1A 1V@1A 2uA@50V 30A 50V Standalone SMA(DO-214AC) Diodes - General Purpose ROHS | M1 | 0.0144 | 13489 | 1 | Diodes | 2026-06-07 09:28:36 | 15 | 0.216
C18199095 | hongjiacheng-M4/C18199095 | https://wmsc.lcsc.com/wmsc/upload/file/pdf/v2/lcsc/2402090755_hongjiacheng-M4_C18199095.pdf | expand | 0 | 2026-08-02 05:18:50 | hongjiacheng | M4 | SMA(DO-214AC) | Diodes - General Purpose | -55℃~+150℃ 1A 1V@1A 2uA@400V 30A 400V Standalone SMA(DO-214AC) Diodes - General Purpose ROHS | M4 | 0.013 | 209698 | 1 | Diodes | 2026-06-07 09:28:36 | 15 | 0.195
C18199098 | hongjiacheng-M6/C18199098 | https://wmsc.lcsc.com/wmsc/upload/file/pdf/v2/lcsc/2310161756_hongjiacheng-M6_C18199098.pdf | expand | 0 | 2026-08-02 05:18:50 | hongjiacheng | M6 | SMA(DO-214AC) | Diodes - General Purpose | -55℃~+150℃ 1A 1V@1A 2uA@800V 30A 800V Standalone SMA(DO-214AC) Diodes - General Purpose ROHS | M6 | 0.0128 | 18974 | 1 | Diodes | 2026-06-07 09:28:36 | 15 | 0.192
C18199100 | hongjiacheng-S2M/C18199100 | https://wmsc.lcsc.com/wmsc/upload/file/pdf/v2/lcsc/2310131745_hongjiacheng-S2M_C18199100.pdf | expand | 0 | 2026-08-02 05:18:50 | hongjiacheng | S2M | SMA(DO-214AC) | Diodes - General Purpose | -55℃~+150℃ 1V@2A 1kV 2A 2uA@1000V 50A Standalone SMA(DO-214AC) Diodes - General Purpose ROHS | S2M | 0.0186 | 2205 | 1 | Diodes | 2026-06-07 09:28:36 | 15 | 0.279
C18199101 | hongjiacheng-S2MB/C18199101 | https://wmsc.lcsc.com/wmsc/upload/file/pdf/v2/lcsc/2310131745_hongjiacheng-S2MB_C18199101.pdf | expand | 0 | 2026-08-02 05:18:50 | hongjiacheng | S2MB | SMB | Diodes - General Purpose | -55℃~+150℃ 1V@2A 1kV 2A 2uA@1000V 50A Standalone SMB Diodes - General Purpose ROHS | S2MB | 0.0165 | 142156 | 1 | Diodes | 2026-06-07 09:28:36 | 5 | 0.0825
C18199102 | hongjiacheng-S3MB/C18199102 | https://wmsc.lcsc.com/wmsc/upload/file/pdf/v2/lcsc/2310131745_hongjiacheng-S3MB_C18199102.pdf | expand | 0 | 2026-08-02 05:18:50 | hongjiacheng | S3MB | SMB | Diodes - General Purpose | -55℃~+150℃ 100A 1V@3A 1kV 2uA@1000V 3A Standalone SMB Diodes - General Purpose ROHS | S3MB | 0.031 | 376342 | 1 | Diodes | 2026-06-07 09:28:36 | 5 | 0.155
C18199103 | hongjiacheng-S3MC/C18199103 | https://wmsc.lcsc.com/wmsc/upload/file/pdf/v2/lcsc/2310131745_hongjiacheng-S3MC_C18199103.pdf | expand | 0 | 2026-08-02 05:18:50 | hongjiacheng | S3MC | SMC | Diodes - General Purpose | -55℃~+150℃ 100A 1V@3A 1kV 2uA@1000V 3A Standalone SMC Diodes - General Purpose ROHS | S3MC | 0.0585 | 3081 | 1 | Diodes | 2026-06-07 09:28:36 | 2 | 0.117
C18199104 | hongjiacheng-S5JB/C18199104 | https://wmsc.lcsc.com/wmsc/upload/file/pdf/v2/lcsc/2310131745_hongjiacheng-S5JB_C18199104.pdf | expand | 0 | 2026-08-02 05:18:50 | hongjiacheng | S5JB | SMB | Diodes - General Purpose | -55℃~+150℃ 150A 1V@5A 2uA@600V 5A 600V Standalone SMB Diodes - General Purpose ROHS | S5JB | 0.0325 | 131 | 276 | Diodes | 2026-06-07 09:28:36 | 278 | 9.035
C18199105 | hongjiacheng-S5MB/C18199105 | https://wmsc.lcsc.com/wmsc/upload/file/pdf/v2/lcsc/2402091120_hongjiacheng-S5MB_C18199105.pdf | expand | 0 | 2026-08-02 05:18:50 | hongjiacheng | S5MB | SMB | Diodes - General Purpose | -55℃~+150℃ 150A 1V@5A 1kV 2uA@1000V 5A Standalone SMB Diodes - General Purpose ROHS | S5MB | 0.0407 | 828450 | 1 | Diodes | 2026-06-07 09:28:36 | 5 | 0.2035
C18199106 | hongjiacheng-S5MC/C18199106 | https://wmsc.lcsc.com/wmsc/upload/file/pdf/v2/lcsc/2310131745_hongjiacheng-S5MC_C18199106.pdf | expand | 0 | 2026-08-02 05:18:50 | hongjiacheng | S5MC | SMC | Diodes - General Purpose | -55℃~+150℃ 150A 1V@5A 1kV 2uA@1000V 5A Standalone SMC Diodes - General Purpose ROHS | S5MC | 0.0551 | 33046 | 1 | Diodes | 2026-06-07 09:28:36 | 2 | 0.1102
C18199107 | hongjiacheng-S6MC/C18199107 | https://wmsc.lcsc.com/wmsc/upload/file/pdf/v2/lcsc/2310131745_hongjiacheng-S6MC_C18199107.pdf | expand | 0 | 2026-08-02 05:18:50 | hongjiacheng | S6MC | SMC | Diodes - General Purpose | -55℃~+150℃ 1.1V@6A 150A 1kV 5uA@1000V 6A Standalone SMC Diodes - General Purpose ROHS | S6MC | 0.0659 | 49525 | 1 | Diodes | 2026-06-07 09:28:36 | 2 | 0.1318
C18199108 | hongjiacheng-S8KC/C18199108 | https://wmsc.lcsc.com/wmsc/upload/file/pdf/v2/lcsc/2310131745_hongjiacheng-S8KC_C18199108.pdf | expand | 0 | 2026-08-02 05:18:50 | hongjiacheng | S8KC | SMC | Diodes - General Purpose | -55℃~+150℃ 175A 1V@8A 2uA@800V 800V 8A Standalone SMC Diodes - General Purpose ROHS | S8KC | 0.0577 | 10262 | 1 | Diodes | 2026-06-07 09:28:36 | 2 | 0.1154
C18199109 | hongjiacheng-S8MC/C18199109 | https://wmsc.lcsc.com/wmsc/upload/file/pdf/v2/lcsc/2402091540_hongjiacheng-S8MC_C18199109.pdf | expand | 0 | 2026-08-02 05:18:50 | hongjiacheng | S8MC | SMC | Diodes - General Purpose | -55℃~+150℃ 175A 1V@8A 1kV 2uA@1000V 8A Standalone SMC Diodes - General Purpose ROHS | S8MC | 0.0568 | 6053 | 1 | Diodes | 2026-06-07 09:28:36 | 2 | 0.1136
C18199110 | hongjiacheng-S10JC/C18199110 | https://wmsc.lcsc.com/wmsc/upload/file/pdf/v2/lcsc/2310131745_hongjiacheng-S10JC_C18199110.pdf | expand | 0 | 2026-08-02 05:18:50 | hongjiacheng | S10JC | SMC | Diodes - General Purpose | -55℃~+150℃ 10A 1V@10A 200A 2uA@600V 600V Standalone SMC Diodes - General Purpose ROHS | S10JC | 0.0817 | 19476 | 1 | Diodes | 2026-06-07 09:28:36 | 2 | 0.1634
C18199111 | hongjiacheng-S10MC/C18199111 | https://wmsc.lcsc.com/wmsc/upload/file/pdf/v2/lcsc/2402151400_hongjiacheng-S10MC_C18199111.pdf | expand | 0 | 2026-08-02 05:18:50 | hongjiacheng | S10MC | SMC | Diodes - General Purpose | -55℃~+150℃ 10A 1V@10A 1kV 200A 2uA@1000V Standalone SMC Diodes - General Purpose ROHS | S10MC | 0.094 | 92623 | 1 | Diodes | 2026-06-07 09:28:36 | 2 | 0.188
C18199112 | hongjiacheng-S5BBF/C18199112 | https://wmsc.lcsc.com/wmsc/upload/file/pdf/v2/lcsc/2310131745_hongjiacheng-S5BBF_C18199112.pdf | expand | 0 | 2026-08-02 05:18:50 | hongjiacheng | S5BBF | SMBF | Diodes - General Purpose | -55℃~+150℃ 100V 150A 1V@5A 2uA@100V 5A Standalone SMBF Diodes - General Purpose ROHS | S5BBF | 0.0355 | 9104 | 1 | Diodes | 2026-06-07 09:28:36 | 5 | 0.1775
C18199113 | hongjiacheng-FR102W/C18199113 | https://wmsc.lcsc.com/wmsc/upload/file/pdf/v2/lcsc/2309251015_hongjiacheng-FR102W_C18199113.pdf | expand | 0 | 2026-08-02 05:18:50 | hongjiacheng | FR102W | SOD-123FL | Fast Recovery / High Efficiency Diodes | -55℃~+150℃ 1 Independent 1.3V@1A 100V 150ns 1A 2uA@100V 30A SOD-123FL Fast Recovery / High Efficiency Diodes ROHS | FR102W | 0.009 | 1693 | 1 | Diodes | 2026-06-07 09:28:36 | 15 | 0.135
C18199114 | hongjiacheng-FR107W/C18199114 | https://wmsc.lcsc.com/wmsc/upload/file/pdf/v2/lcsc/2309251425_hongjiacheng-FR107W_C18199114.pdf | expand | 0 | 2026-08-02 05:18:50 | hongjiacheng | FR107W | SOD-123FL | Fast Recovery / High Efficiency Diodes | -55℃~+150℃ 1 Independent 1.3V@1A 1A 1kV 2uA@1000V 30A 500ns SOD-123FL Fast Recovery / High Efficiency Diodes ROHS | FR107W | 0.0106 | 178699 | 1 | Diodes | 2026-06-07 09:28:36 | 15 | 0.159
C18199115 | hongjiacheng-RS1MF/C18199115 | https://wmsc.lcsc.com/wmsc/upload/file/pdf/v2/lcsc/2309251015_hongjiacheng-RS1MF_C18199115.pdf | expand | 0 | 2026-08-02 05:18:50 | hongjiacheng | RS1MF | SMAF | Fast Recovery / High Efficiency Diodes | -55℃~+150℃ 1 Independent 1.3V@1A 1A 1kV 30A 500ns 5uA@1kV SMAF Fast Recovery / High Efficiency Diodes ROHS | RS1MF | 0.0111 | 36210 | 1 | Diodes | 2026-06-07 09:28:36 | 15 | 0.1665
C18199116 | hongjiacheng-RS3MF/C18199116 | https://wmsc.lcsc.com/wmsc/upload/file/pdf/v2/lcsc/2309251015_hongjiacheng-RS3MF_C18199116.pdf | expand | 0 | 2026-08-02 05:18:50 | hongjiacheng | RS3MF | SMAF | Fast Recovery / High Efficiency Diodes | -55℃~+150℃ 1 Independent 1.3V@3A 1kV 3A 500ns 5uA@1kV 70A SMAF Fast Recovery / High Efficiency Diodes ROHS | RS3MF | 0.0323 | 130811 | 1 | Diodes | 2026-06-07 09:28:36 | 15 | 0.4845
C18199117 | hongjiacheng-RS1G/C18199117 | https://wmsc.lcsc.com/wmsc/upload/file/pdf/v2/lcsc/2309251015_hongjiacheng-RS1G_C18199117.pdf | expand | 0 | 2026-08-02 05:18:50 | hongjiacheng | RS1G | SMA(DO-214AC) | Fast Recovery / High Efficiency Diodes | -55℃~+150℃ 1 Independent 1.3V@1A 150ns 1A 30A 400V 5uA@400V SMA(DO-214AC) Fast Recovery / High Efficiency Diodes ROHS | RS1G | 0.0134 | 12622 | 1 | Diodes | 2026-06-07 09:28:36 | 15 | 0.201
C18199118 | hongjiacheng-RS1J/C18199118 | https://wmsc.lcsc.com/wmsc/upload/file/pdf/v2/lcsc/2309251425_hongjiacheng-RS1J_C18199118.pdf | expand | 0 | 2026-08-02 05:18:50 | hongjiacheng | RS1J | SMA(DO-214AC) | Fast Recovery / High Efficiency Diodes | -55℃~+150℃ 1 Independent 1.3V@1A 1A 250ns 30A 5uA@600V 600V SMA(DO-214AC) Fast Recovery / High Efficiency Diodes ROHS | RS1J | 0.0147 | 36693 | 1 | Diodes | 2026-06-07 09:28:36 | 15 | 0.2205
C18199119 | hongjiacheng-RS3MB/C18199119 | https://wmsc.lcsc.com/wmsc/upload/file/pdf/v2/lcsc/2309251015_hongjiacheng-RS3MB_C18199119.pdf | expand | 0 | 2026-08-02 05:18:50 | hongjiacheng | RS3MB | SMB | Fast Recovery / High Efficiency Diodes | -55℃~+150℃ 1 Independent 1.3V@3A 100A 1kV 2uA@1000V 3A 500ns SMB Fast Recovery / High Efficiency Diodes ROHS | RS3MB | 0.0354 | 4544 | 1 | Diodes | 2026-06-07 09:28:36 | 5 | 0.177
C18199120 | hongjiacheng-RS3MC/C18199120 | https://wmsc.lcsc.com/wmsc/upload/file/pdf/v2/lcsc/2309271620_hongjiacheng-RS3MC_C18199120.pdf | expand | 0 | 2026-08-02 05:18:50 | hongjiacheng | RS3MC | SMC | Fast Recovery / High Efficiency Diodes | -55℃~+150℃ 1 Independent 1.3V@3A 100A 1kV 2uA@1000V 3A 500ns SMC Fast Recovery / High Efficiency Diodes ROHS | RS3MC | 0.0577 | 3388 | 1 | Diodes | 2026-06-07 09:28:36 | 2 | 0.1154
C18199121 | hongjiacheng-RS5MC/C18199121 | https://wmsc.lcsc.com/wmsc/upload/file/pdf/v2/lcsc/2309251015_hongjiacheng-RS5MC_C18199121.pdf | expand | 0 | 2026-08-02 05:18:50 | hongjiacheng | RS5MC | SMC | Fast Recovery / High Efficiency Diodes | -55℃~+150℃ 1 Independent 1.3V@5A 150A 1kV 2uA@1000V 500ns 5A SMC Fast Recovery / High Efficiency Diodes ROHS | RS5MC | 0.0602 | 16333 | 1 | Diodes | 2026-06-07 09:28:36 | 2 | 0.1204
C18199122 | hongjiacheng-US1DW/C18199122 | https://jlc-prod-smt.oss-eu-central-1.aliyuncs.com/smtDataManualFile/8755883096690839552-C18199122.pdf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 | expand | 0 | 2026-08-02 05:18:50 | hongjiacheng | US1DW | SOD-123FL | Fast Recovery / High Efficiency Diodes | -55℃~+150℃ 1 Independent 1.7V 1A 200V 2uA 30A 50ns SOD-123FL Fast Recovery / High Efficiency Diodes ROHS | US1DW | 0.012 | 40920 | 1 | Diodes | 2026-06-07 09:28:36 | 15 | 0.18
C18199123 | hongjiacheng-US1MW/C18199123 | https://wmsc.lcsc.com/wmsc/upload/file/pdf/v2/lcsc/2402212310_hongjiacheng-US1MW_C18199123.pdf | expand | 0 | 2026-08-02 05:18:50 | hongjiacheng | US1MW | SOD-123FL | Fast Recovery / High Efficiency Diodes | -55℃~+150℃ 1 Independent 1.7V@1A 1A 1kV 2uA@1000V 30A 75ns SOD-123FL Fast Recovery / High Efficiency Diodes ROHS | US1MW | 0.0119 | 477412 | 1 | Diodes | 2026-06-07 09:28:36 | 15 | 0.1785
C18199124 | hongjiacheng-US1MF/C18199124 | https://wmsc.lcsc.com/wmsc/upload/file/pdf/v2/lcsc/2310131745_hongjiacheng-US1MF_C18199124.pdf | expand | 0 | 2026-08-02 05:18:50 | hongjiacheng | US1MF | SMAF | Fast Recovery / High Efficiency Diodes | -55℃~+150℃ 1 Independent 1.7V@1A 1A 1kV 30A 5uA 75ns SMAF Fast Recovery / High Efficiency Diodes ROHS | US1MF | 0.014 | 57089 | 1 | Diodes | 2026-06-07 09:28:36 | 15 | 0.21
C18199125 | hongjiacheng-US1A/C18199125 | https://wmsc.lcsc.com/wmsc/upload/file/pdf/v2/lcsc/2309251015_hongjiacheng-US1A_C18199125.pdf | expand | 0 | 2026-08-02 05:18:50 | hongjiacheng | US1A | SMA(DO-214AC) | Fast Recovery / High Efficiency Diodes | -55℃~+150℃ 1 Independent 1A 1V@1A 30A 50V 50ns 5uA@50V SMA(DO-214AC) Fast Recovery / High Efficiency Diodes ROHS | US1A | 0.0147 | 4226 | 1 | Diodes | 2026-06-07 09:28:36 | 20 | 0.294
C18199126 | hongjiacheng-US1B/C18199126 | https://wmsc.lcsc.com/wmsc/upload/file/pdf/v2/lcsc/2309251425_hongjiacheng-US1B_C18199126.pdf | expand | 0 | 2026-08-02 05:18:50 | hongjiacheng | US1B | SMA(DO-214AC) | Fast Recovery / High Efficiency Diodes | -55℃~+150℃ 1 Independent 100V 1A 1V@1A 30A 50ns 5uA@100V SMA(DO-214AC) Fast Recovery / High Efficiency Diodes ROHS | US1B | 0.0147 | 17374 | 1 | Diodes | 2026-06-07 09:28:36 | 15 | 0.2205
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
