g3ncl/scacchiera/Vault/Scacchiera/Datasheets/PISUGAR3_PLUS.step

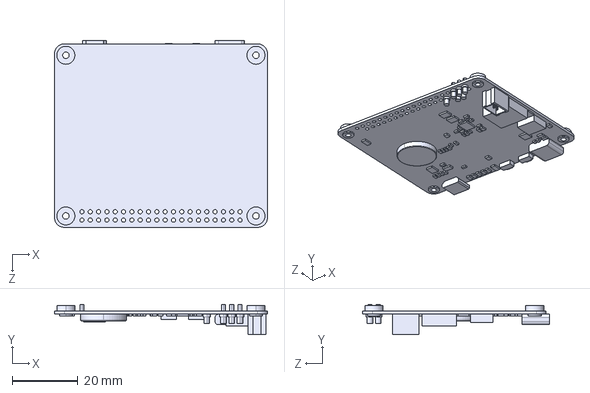
[picture p1: CAD file, 2026-07-26]
Vault/Scacchiera/Datasheets/PISUGAR3_PLUS.step
65.0 x 9.22 x 57.0 mm
