g3ncl/scacchiera/Vault/Scacchiera/Clippings/nfcgameboard.com/files/schematics-pdf/15x15 antenna grid switches.pdf

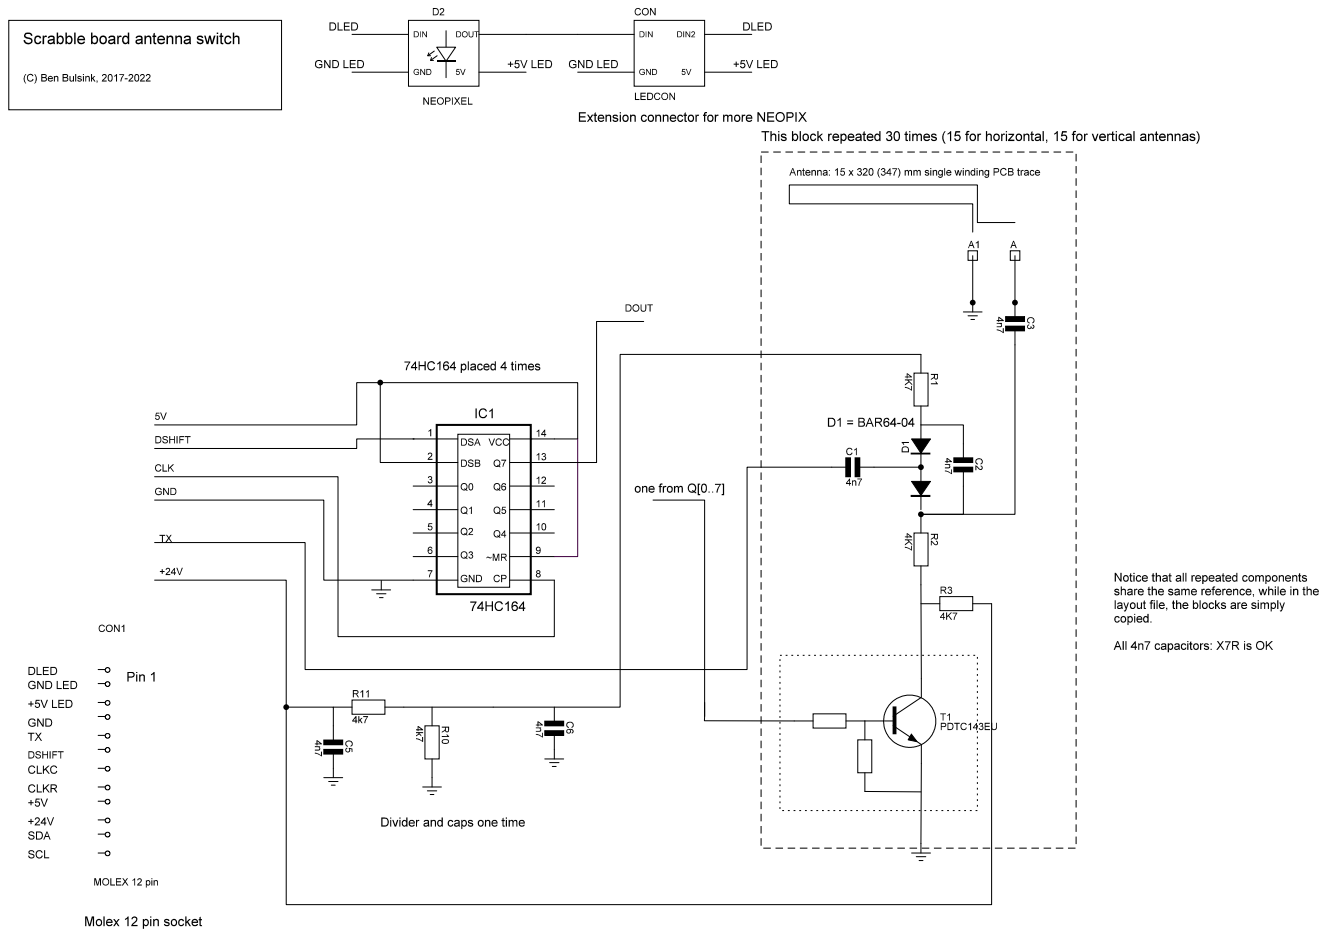
[picture p2: page 1]

Scrabble board antenna switch

Extension connector for more NEOPIX

This block repeated 30 times (15 for horizontal, 15 for vertical antennas)

Antenna: 15 x 320 (347) mm single winding PCB trace

Notice that all repeated components
share the same reference, while in the
layout file, the blocks are simply
copied.

All 4n7 capacitors: X7R is OK

Divider and caps one time
