g3ncl/scacchiera/Vault/Scacchiera/Clippings/nfcgameboard.com/files/schematics-pdf/Arduino Pro Micro.pdf

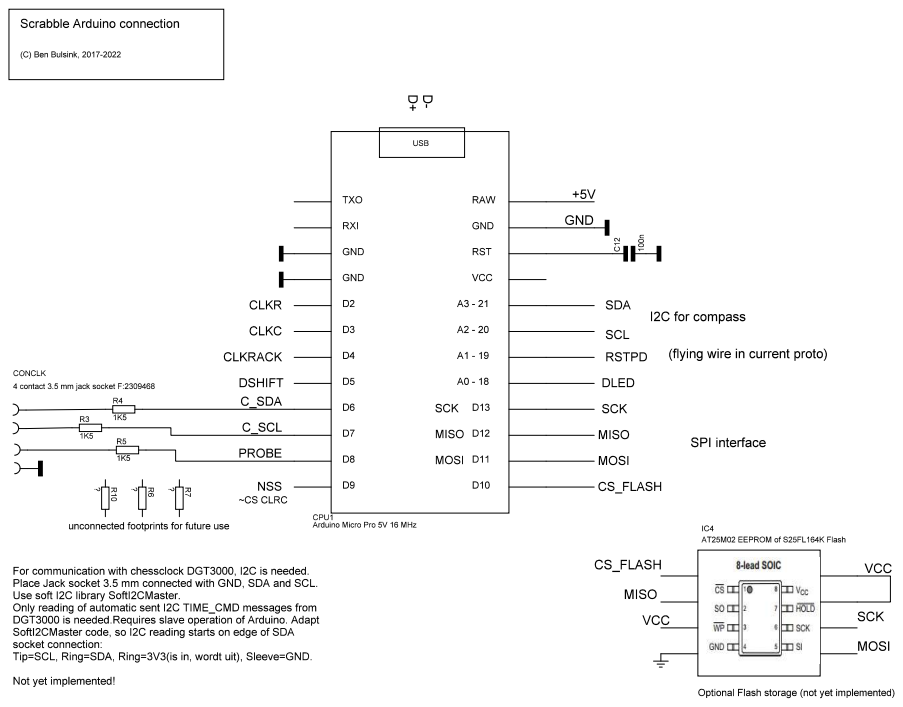
[picture p3: page 1]

CONCLK
4 contact 3.5 mm jack socket F:2309468

unconnected footprints for future use

For communication with chessclock DGT3000, I2C is needed.
Place Jack socket 3.5 mm connected with GND, SDA and SCL.
Use soft I2C library SoftI2CMaster.
Only reading of automatic sent I2C TIME_CMD messages from
DGT3000 is needed.Requires slave operation of Arduino. Adapt
SoftI2CMaster code, so I2C reading starts on edge of SDA
socket connection:
Tip=SCL, Ring=SDA, Ring=3V3(is in, wordt uit), Sleeve=GND.

Optional Flash storage (not yet implemented)
