g3ncl/scacchiera/Vault/Scacchiera/Clippings/nfcgameboard.com/files/schematics-pdf/CLRC632 reader.pdf

### Scrabble ICode reader

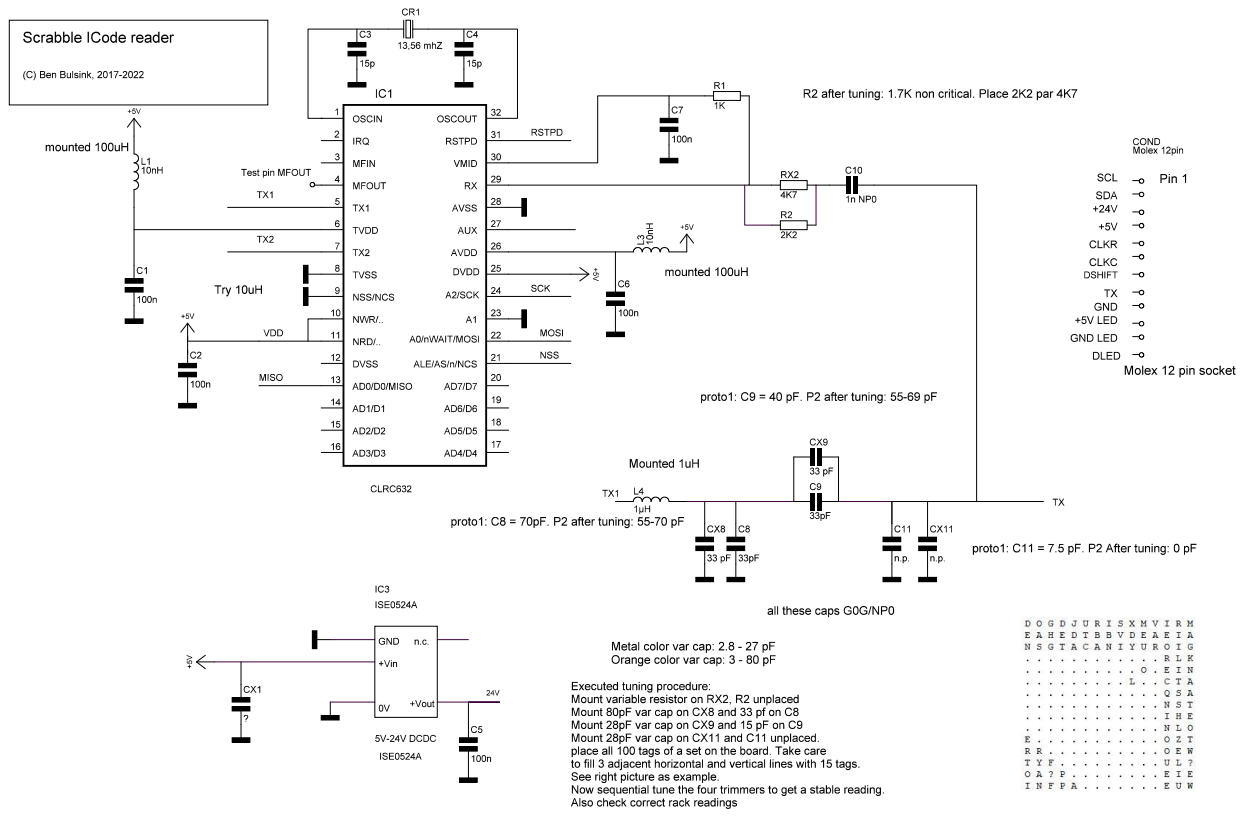
[picture p4: page 1]

R2 after tuning: 1.7K non critical. Place 2K2 par 4K7

proto1: C9 = 40 pF. P2 after tuning: 55-69 pF

proto1: C11 = 7.5 pF. P2 After tuning: 0 pF

Metal color var cap: 2.8 - 27 pF
Orange color var cap: 3 - 80 pF

Executed tuning procedure:
Mount variable resistor on RX2, R2 unplaced
Mount 80pF var cap on CX8 and 33 pf on C8
Mount 28pF var cap on CX9 and 15 pF on C9
Mount 28pF var cap on CX11 and C11 unplaced.
place all 100 tags of a set on the board. Take care
to fill 3 adjacent horizontal and vertical lines with 15 tags.
See right picture as example.
Now sequential tune the four trimmers to get a stable reading.
Also check correct rack readings
