g3ncl/scacchiera/Vault/Scacchiera/Clippings/nfcgameboard.com/files/schematics-pdf/Racks antenna switches.pdf

## Scrabble rack antenna switch

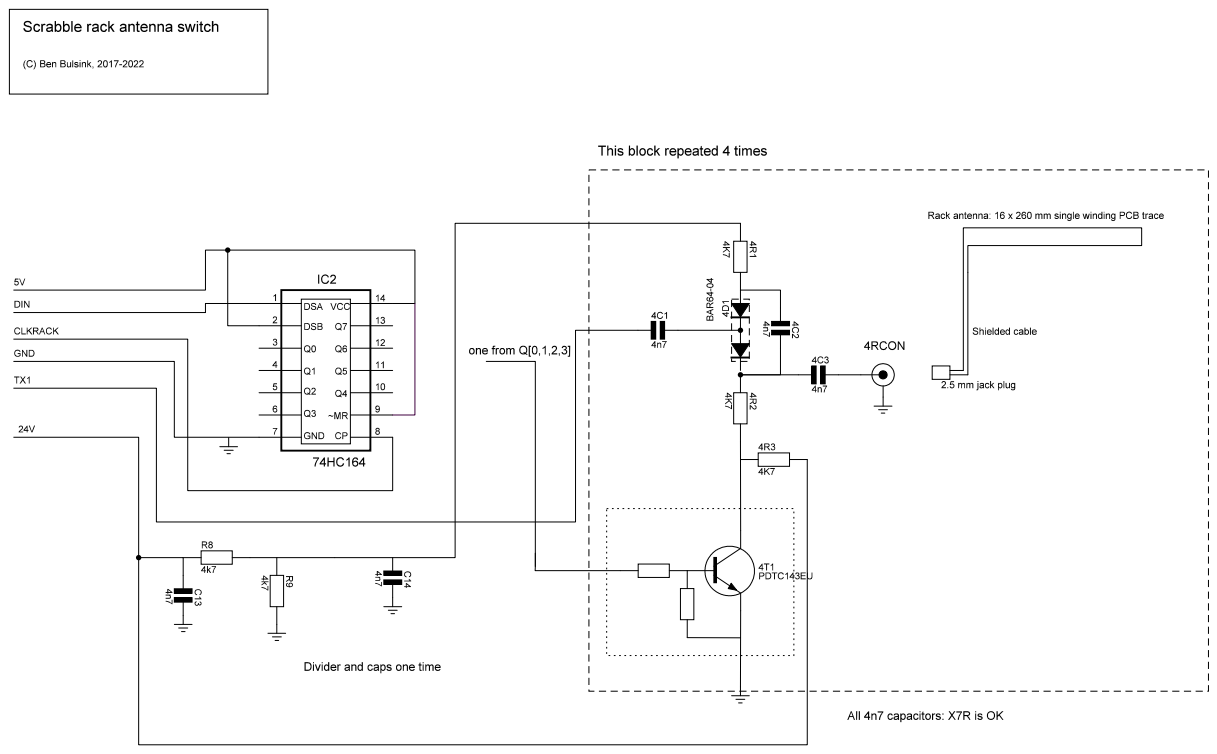
[picture p5: page 1]

This block repeated 4 times

Rack antenna: 16 x 260 mm single winding PCB trace

Divider and caps one time

All 4n7 capacitors: X7R is OK
