g3ncl/scacchiera/Vault/Scacchiera/Clippings/nfcgameboard.com/files/Cable-to-antenna-adapter.pdf

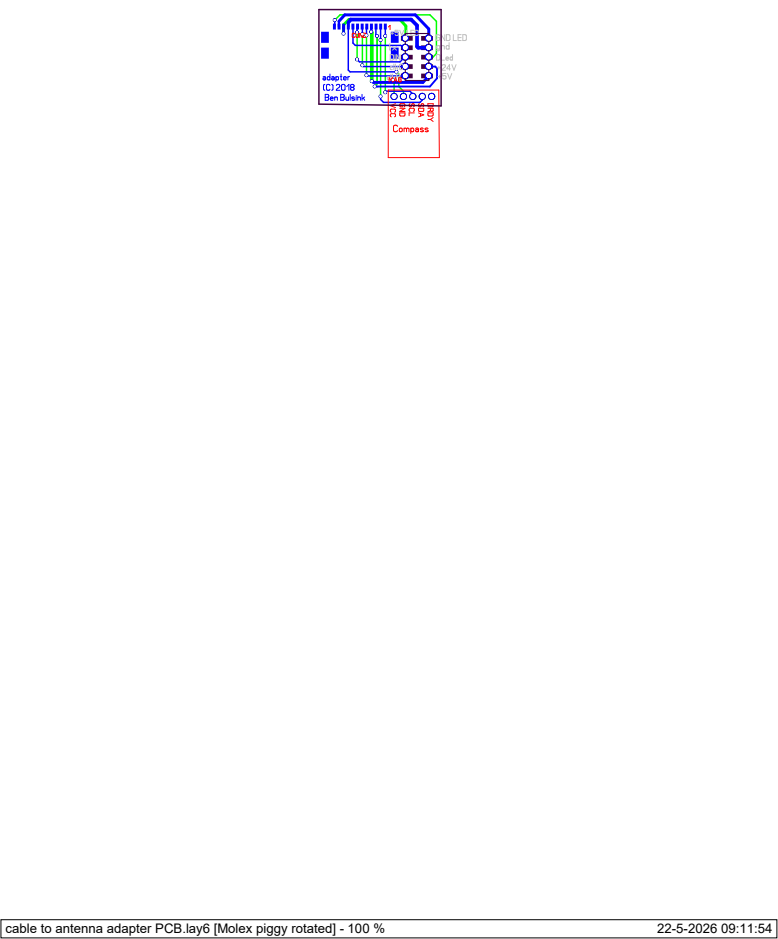
[picture p6: page 1]
cable to antenna adapter PCB.lay6 [Molex piggy rotated] - 100 %
