g3ncl/scacchiera/Vault/Scacchiera/Clippings/nfcgameboard.com/files/Scrabble-board-antenna-PCB.pdf

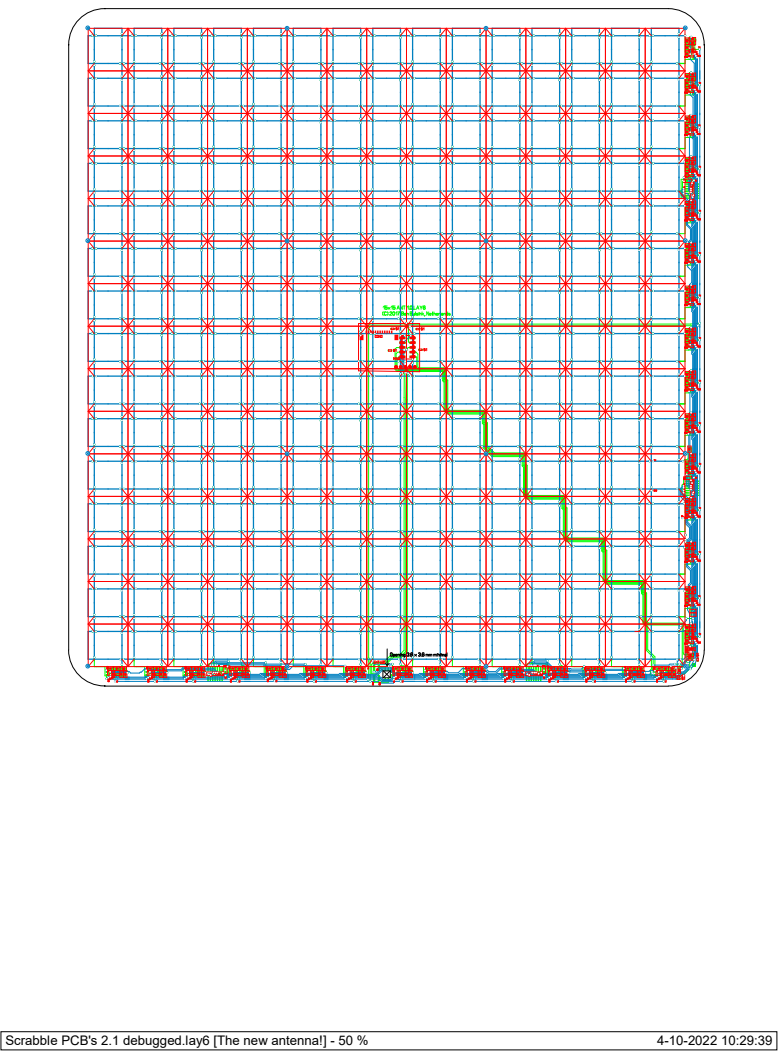
[picture p7: page 1]
Scrabble PCB's 2.1 debugged.lay6 [The new antenna!] - 50 %
