g3ncl/scacchiera/Vault/Scacchiera/Clippings/nfcgameboard.com/files/Scrabble-controller-board-PCB.pdf

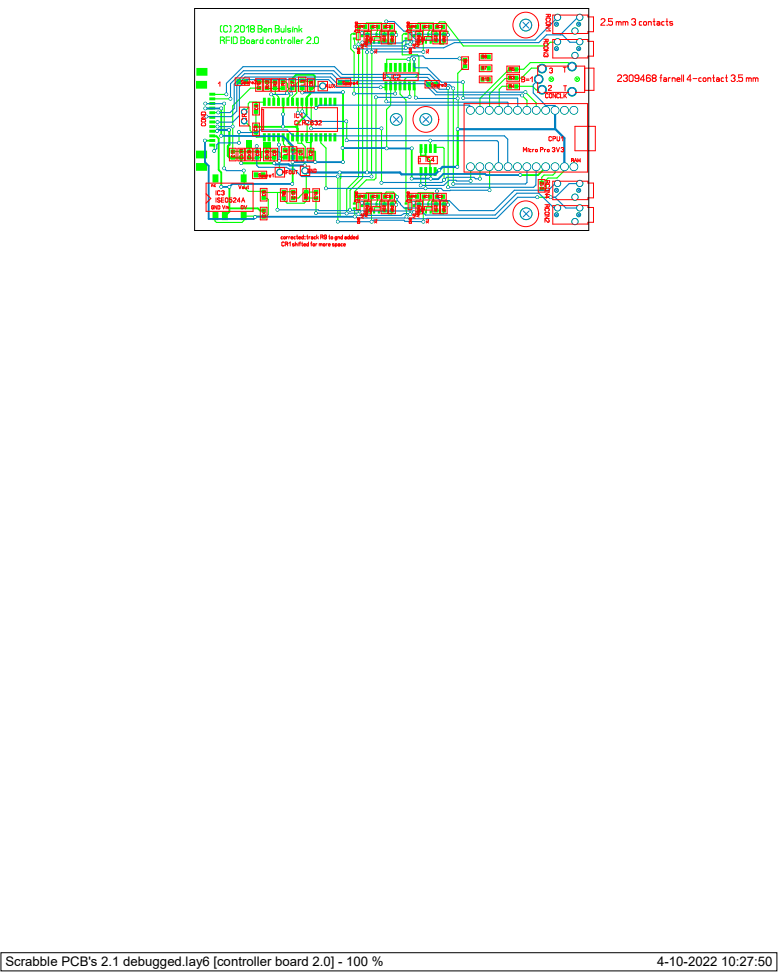
[picture p8: page 1]
Scrabble PCB's 2.1 debugged.lay6 [controller board 2.0] - 100 %
