g3ncl/scacchiera/(list of files, drawings)

Other design files:
Vault/Scacchiera/Clippings/nfcgameboard.com/files/pcb-layouts/antenna PCB.lay6
Vault/Scacchiera/Clippings/nfcgameboard.com/files/pcb-layouts/cable to antenna adapter PCB.lay6
Vault/Scacchiera/Clippings/nfcgameboard.com/files/pcb-layouts/Controller board PCB.lay6
Vault/Scacchiera/Clippings/nfcgameboard.com/files/pcb-layouts/rack antenna PCB.lay6
Vault/Scacchiera/Clippings/nfcgameboard.com/files/schematics-splan/15x15 antenna grid switches.spl8
Vault/Scacchiera/Clippings/nfcgameboard.com/files/schematics-splan/Arduino Pro Micro.spl8
Vault/Scacchiera/Clippings/nfcgameboard.com/files/schematics-splan/CLRC632 reader.spl8
Vault/Scacchiera/Clippings/nfcgameboard.com/files/schematics-splan/Racks antenna switches.spl8
