g3ncl/scacchiera/docs/verification/v1-components.yaml

version: 1
milestone: V1
reviewed: '2026-07-29'
policy: Every purchased fitted component is exact, sourced, backed by an immutable
  manufacturer datasheet, library-audited, ratings-audited and model-classified.
components:
- mpn: 0402B223K500NT
  manufacturer: Fenghua Advanced Technology
  supplier: JLCPCB
  order_code: C1532
  availability:
    status: available
    checked: '2026-07-29'
    source: https://jlcpcb.com/partdetail?part=C1532
  datasheet: Vault/Scacchiera/Datasheets/0402B223K500NT_C1532.pdf
  wiki_source: Vault/Scacchiera/Wiki/sources/0402b223k500nt-datasheet.md
  wiki_entity: Vault/Scacchiera/Wiki/entities/0402b223k500nt.md
  category: capacitor
  footprint: Capacitor_SMD:C_0402_1005Metric
  uses:
  - board: power
    reference: C13
    value: 22n 50V
  library_audit:
    status: passed
    checked: '2026-07-29'
    evidence: manufacturer pin and package drawing checked against the SKiDL pin numbers,
      KiCad pad numbers, polarity, top assembly side and KiCad zero-degree orientation
    checks:
    - symbol_pin_numbers_and_names
    - symbol_electrical_types
    - exposed_and_no_connect_pins
    - footprint_pad_numbers
    - package_dimensions
    - polarity_and_pin_one
    - assembly_side
    - cpl_zero_rotation
  ratings_audit:
    status: passed
    fields: capacitance, tolerance, rated voltage, dielectric, temperature range,
      DC-bias behavior where published and package dimensions
    datasheet_locator: part-number, characteristics and dimensions tables
  simulation_model:
    kind: analytical
    path: hardware/sim/power_loop.py
    valid_region: initial tolerance and X7R temperature change are data-sheet bounded;
      error-amplifier transconductance is a plus or minus 30 percent sensitivity because
      TI gives no limits
  conflicts: []
- mpn: 0402CG101J500NT
  manufacturer: Fenghua Advanced Technology
  supplier: JLCPCB
  order_code: C1546
  availability:
    status: available
    checked: '2026-07-26'
    source: https://jlcpcb.com/partdetail?part=C1546
  datasheet: Vault/Scacchiera/Datasheets/0402CG101J500NT_C1546.pdf
  wiki_source: Vault/Scacchiera/Wiki/sources/0402cg101j500nt-datasheet.md
  wiki_entity: Vault/Scacchiera/Wiki/entities/0402cg101j500nt.md
  category: capacitor
  footprint: Capacitor_SMD:C_0402_1005Metric
  uses:
  - board: hub
    reference: C37
    value: 100p C0G
  library_audit:
    status: passed
    checked: '2026-07-26'
    evidence: manufacturer pin and package drawing checked against the SKiDL pin numbers,
      KiCad pad numbers, polarity, top assembly side and KiCad zero-degree orientation
    checks:
    - symbol_pin_numbers_and_names
    - symbol_electrical_types
    - exposed_and_no_connect_pins
    - footprint_pad_numbers
    - package_dimensions
    - polarity_and_pin_one
    - assembly_side
    - cpl_zero_rotation
  ratings_audit:
    status: passed
    fields: capacitance, tolerance, rated voltage, dielectric, temperature range,
      DC-bias behavior where published and package dimensions
    datasheet_locator: part-number, characteristics and dimensions tables
  simulation_model:
    kind: analytical
    path: hardware/sim
    valid_region: lumped model with datasheet tolerance, bias, ESR, DCR and temperature
      corners
  conflicts: []
- mpn: 0402CG150J500NT
  manufacturer: Fenghua Advanced Technology
  supplier: JLCPCB
  order_code: C1548
  availability:
    status: available
    checked: '2026-07-26'
    source: https://jlcpcb.com/partdetail?part=C1548
  datasheet: Vault/Scacchiera/Datasheets/0402CG150J500NT_C1548.pdf
  wiki_source: Vault/Scacchiera/Wiki/sources/0402cg150j500nt-datasheet.md
  wiki_entity: Vault/Scacchiera/Wiki/entities/0402cg150j500nt.md
  category: capacitor
  footprint: Capacitor_SMD:C_0402_1005Metric
  uses:
  - board: hub
    reference: C31
    value: 15p C0G
  - board: hub
    reference: C32
    value: 15p C0G
  library_audit:
    status: passed
    checked: '2026-07-26'
    evidence: manufacturer pin and package drawing checked against the SKiDL pin numbers,
      KiCad pad numbers, polarity, top assembly side and KiCad zero-degree orientation
    checks:
    - symbol_pin_numbers_and_names
    - symbol_electrical_types
    - exposed_and_no_connect_pins
    - footprint_pad_numbers
    - package_dimensions
    - polarity_and_pin_one
    - assembly_side
    - cpl_zero_rotation
  ratings_audit:
    status: passed
    fields: capacitance, tolerance, rated voltage, dielectric, temperature range,
      DC-bias behavior where published and package dimensions
    datasheet_locator: part-number, characteristics and dimensions tables
  simulation_model:
    kind: analytical
    path: hardware/sim
    valid_region: lumped model with datasheet tolerance, bias, ESR, DCR and temperature
      corners
  conflicts: []
- mpn: 0603WAF1000T5E
  manufacturer: UNI-ROYAL
  supplier: JLCPCB
  order_code: C22775
  availability:
    status: available
    checked: '2026-07-26'
    source: https://jlcpcb.com/partdetail?part=C22775
  datasheet: Vault/Scacchiera/Datasheets/0603WAF1000T5E_C22775.pdf
  wiki_source: Vault/Scacchiera/Wiki/sources/0603waf1000t5e-datasheet.md
  wiki_entity: Vault/Scacchiera/Wiki/entities/0603waf1000t5e.md
  category: resistor
  footprint: Resistor_SMD:R_0603_1608Metric
  uses:
  - board: hub
    reference: R27
    value: 100R
  - board: hub
    reference: R28
    value: 100R
  - board: power
    reference: R12
    value: 100R 1%
  - board: power
    reference: R13
    value: 100R 1%
  library_audit:
    status: passed
    checked: '2026-07-26'
    evidence: manufacturer pin and package drawing checked against the SKiDL pin numbers,
      KiCad pad numbers, polarity, top assembly side and KiCad zero-degree orientation
    checks:
    - symbol_pin_numbers_and_names
    - symbol_electrical_types
    - exposed_and_no_connect_pins
    - footprint_pad_numbers
    - package_dimensions
    - polarity_and_pin_one
    - assembly_side
    - cpl_zero_rotation
  ratings_audit:
    status: passed
    fields: value, tolerance, rated power, maximum working voltage, temperature coefficient,
      operating temperature and package dimensions
    datasheet_locator: ratings, dimensions and part-number tables
  simulation_model:
    kind: analytical
    path: hardware/sim
    valid_region: lumped model with datasheet tolerance, bias, ESR, DCR and temperature
      corners
  conflicts: []
- mpn: 0603WAF1001T5E
  manufacturer: UNI-ROYAL
  supplier: JLCPCB
  order_code: C21190
  availability:
    status: available
    checked: '2026-07-26'
    source: https://jlcpcb.com/partdetail?part=C21190
  datasheet: Vault/Scacchiera/Datasheets/0603WAF1001T5E_C21190.pdf
  wiki_source: Vault/Scacchiera/Wiki/sources/0603waf1001t5e-datasheet.md
  wiki_entity: Vault/Scacchiera/Wiki/entities/0603waf1001t5e.md
  category: resistor
  footprint: Resistor_SMD:R_0603_1608Metric
  uses:
  - board: hub
    reference: R29
    value: 1k
  - board: hub
    reference: R30
    value: 1k
  library_audit:
    status: passed
    checked: '2026-07-26'
    evidence: manufacturer pin and package drawing checked against the SKiDL pin numbers,
      KiCad pad numbers, polarity, top assembly side and KiCad zero-degree orientation
    checks:
    - symbol_pin_numbers_and_names
    - symbol_electrical_types
    - exposed_and_no_connect_pins
    - footprint_pad_numbers
    - package_dimensions
    - polarity_and_pin_one
    - assembly_side
    - cpl_zero_rotation
  ratings_audit:
    status: passed
    fields: value, tolerance, rated power, maximum working voltage, temperature coefficient,
      operating temperature and package dimensions
    datasheet_locator: ratings, dimensions and part-number tables
  simulation_model:
    kind: analytical
    path: hardware/sim
    valid_region: lumped model with datasheet tolerance, bias, ESR, DCR and temperature
      corners
  conflicts: []
- mpn: 0603WAF1002T5E
  manufacturer: UNI-ROYAL
  supplier: JLCPCB
  order_code: C25804
  availability:
    status: available
    checked: '2026-07-26'
    source: https://jlcpcb.com/partdetail?part=C25804
  datasheet: Vault/Scacchiera/Datasheets/0603WAF1002T5E_C25804.pdf
  wiki_source: Vault/Scacchiera/Wiki/sources/0603waf1002t5e-datasheet.md
  wiki_entity: Vault/Scacchiera/Wiki/entities/0603waf1002t5e.md
  category: resistor
  footprint: Resistor_SMD:R_0603_1608Metric
  uses:
  - board: hub
    reference: R34
    value: 10k
  - board: hub
    reference: R35
    value: 10k
  - board: hub
    reference: R4
    value: 10k
  - board: hub
    reference: R36
    value: 10k
  - board: hub
    reference: R20
    value: 10k
  - board: hub
    reference: R23
    value: 10k
  - board: hub
    reference: R25
    value: 10k
  - board: hub
    reference: R31
    value: 10k
  - board: power
    reference: R14
    value: 10k 1%
  - board: power
    reference: R1
    value: 10k 1%
  - board: power
    reference: R2
    value: 10k 1%
  library_audit:
    status: passed
    checked: '2026-07-26'
    evidence: manufacturer pin and package drawing checked against the SKiDL pin numbers,
      KiCad pad numbers, polarity, top assembly side and KiCad zero-degree orientation
    checks:
    - symbol_pin_numbers_and_names
    - symbol_electrical_types
    - exposed_and_no_connect_pins
    - footprint_pad_numbers
    - package_dimensions
    - polarity_and_pin_one
    - assembly_side
    - cpl_zero_rotation
  ratings_audit:
    status: passed
    fields: value, tolerance, rated power, maximum working voltage, temperature coefficient,
      operating temperature and package dimensions
    datasheet_locator: ratings, dimensions and part-number tables
  simulation_model:
    kind: analytical
    path: hardware/sim
    valid_region: lumped model with datasheet tolerance, bias, ESR, DCR and temperature
      corners
  conflicts: []
- mpn: 0603WAF1003T5E
  manufacturer: UNI-ROYAL
  supplier: JLCPCB
  order_code: C25803
  availability:
    status: available
    checked: '2026-07-26'
    source: https://jlcpcb.com/partdetail?part=C25803
  datasheet: Vault/Scacchiera/Datasheets/0603WAF1003T5E_C25803.pdf
  wiki_source: Vault/Scacchiera/Wiki/sources/0603waf1003t5e-datasheet.md
  wiki_entity: Vault/Scacchiera/Wiki/entities/0603waf1003t5e.md
  category: resistor
  footprint: Resistor_SMD:R_0603_1608Metric
  uses:
  - board: matrix
    reference: R3
    value: 100k 1%
  - board: matrix
    reference: R6
    value: 100k 1%
  - board: matrix
    reference: R9
    value: 100k 1%
  - board: matrix
    reference: R12
    value: 100k 1%
  - board: matrix
    reference: R15
    value: 100k 1%
  - board: matrix
    reference: R18
    value: 100k 1%
  - board: matrix
    reference: R21
    value: 100k 1%
  - board: matrix
    reference: R24
    value: 100k 1%
  - board: matrix
    reference: R27
    value: 100k 1%
  - board: matrix
    reference: R30
    value: 100k 1%
  - board: matrix
    reference: R33
    value: 100k 1%
  - board: matrix
    reference: R36
    value: 100k 1%
  - board: matrix
    reference: R39
    value: 100k 1%
  - board: matrix
    reference: R42
    value: 100k 1%
  - board: matrix
    reference: R45
    value: 100k 1%
  - board: matrix
    reference: R48
    value: 100k 1%
  - board: hub
    reference: R6
    value: 100k 1%
  - board: hub
    reference: R7
    value: 100k 1%
  - board: hub
    reference: R8
    value: 100k 1%
  - board: hub
    reference: R9
    value: 100k 1%
  - board: hub
    reference: R10
    value: 100k 1%
  - board: hub
    reference: R11
    value: 100k 1%
  - board: hub
    reference: R12
    value: 100k
  - board: hub
    reference: R15
    value: 100k
  - board: hub
    reference: R18
    value: 100k
  - board: hub
    reference: R19
    value: 100k
  - board: hub
    reference: R37
    value: 100k
  - board: hub
    reference: R24
    value: 100k
  - board: hub
    reference: R26
    value: 100k
  - board: power
    reference: R15
    value: 100k 1%
  - board: power
    reference: R17
    value: 100k 1%
  - board: power
    reference: R3
    value: 100k 1%
  - board: power
    reference: R6
    value: 100k 1%
  - board: power
    reference: R8
    value: 100k 1%
  library_audit:
    status: passed
    checked: '2026-07-26'
    evidence: manufacturer pin and package drawing checked against the SKiDL pin numbers,
      KiCad pad numbers, polarity, top assembly side and KiCad zero-degree orientation
    checks:
    - symbol_pin_numbers_and_names
    - symbol_electrical_types
    - exposed_and_no_connect_pins
    - footprint_pad_numbers
    - package_dimensions
    - polarity_and_pin_one
    - assembly_side
    - cpl_zero_rotation
  ratings_audit:
    status: passed
    fields: value, tolerance, rated power, maximum working voltage, temperature coefficient,
      operating temperature and package dimensions
    datasheet_locator: ratings, dimensions and part-number tables
  simulation_model:
    kind: analytical
    path: hardware/sim
    valid_region: lumped model with datasheet tolerance, bias, ESR, DCR and temperature
      corners
  conflicts: []
- mpn: 0603WAF1004T5E
  manufacturer: UNI-ROYAL
  supplier: JLCPCB
  order_code: C22935
  availability:
    status: available
    checked: '2026-07-26'
    source: https://jlcpcb.com/partdetail?part=C22935
  datasheet: Vault/Scacchiera/Datasheets/0603WAF1004T5E_C22935.pdf
  wiki_source: Vault/Scacchiera/Wiki/sources/0603waf1004t5e-datasheet.md
  wiki_entity: Vault/Scacchiera/Wiki/entities/0603waf1004t5e.md
  category: resistor
  footprint: Resistor_SMD:R_0603_1608Metric
  uses:
  - board: hub
    reference: R3
    value: 1M
  - board: hub
    reference: R13
    value: 1M
  - board: hub
    reference: R14
    value: 1M
  - board: hub
    reference: R32
    value: 1M
  - board: hub
    reference: R33
    value: 1M
  - board: power
    reference: R16
    value: 1M 1%
  - board: power
    reference: R18
    value: 1M 1%
  - board: power
    reference: R19
    value: 1M 1%
  library_audit:
    status: passed
    checked: '2026-07-26'
    evidence: manufacturer pin and package drawing checked against the SKiDL pin numbers,
      KiCad pad numbers, polarity, top assembly side and KiCad zero-degree orientation
    checks:
    - symbol_pin_numbers_and_names
    - symbol_electrical_types
    - exposed_and_no_connect_pins
    - footprint_pad_numbers
    - package_dimensions
    - polarity_and_pin_one
    - assembly_side
    - cpl_zero_rotation
  ratings_audit:
    status: passed
    fields: value, tolerance, rated power, maximum working voltage, temperature coefficient,
      operating temperature and package dimensions
    datasheet_locator: ratings, dimensions and part-number tables
  simulation_model:
    kind: analytical
    path: hardware/sim
    valid_region: lumped model with datasheet tolerance, bias, ESR, DCR and temperature
      corners
  conflicts: []
- mpn: 0603WAF150KT5E
  manufacturer: UNI-ROYAL
  supplier: JLCPCB
  order_code: C22769
  availability:
    status: available
    checked: '2026-07-26'
    source: https://jlcpcb.com/partdetail?part=C22769
  datasheet: Vault/Scacchiera/Datasheets/0603WAF150KT5E_C22769.pdf
  wiki_source: Vault/Scacchiera/Wiki/sources/0603waf150kt5e-datasheet.md
  wiki_entity: Vault/Scacchiera/Wiki/entities/0603waf150kt5e.md
  category: resistor
  footprint: Resistor_SMD:R_0603_1608Metric
  uses:
  - board: matrix
    reference: R1
    value: 1.5R 1%
  - board: matrix
    reference: R4
    value: 1.5R 1%
  - board: matrix
    reference: R7
    value: 1.5R 1%
  - board: matrix
    reference: R10
    value: 1.5R 1%
  - board: matrix
    reference: R13
    value: 1.5R 1%
  - board: matrix
    reference: R16
    value: 1.5R 1%
  - board: matrix
    reference: R19
    value: 1.5R 1%
  - board: matrix
    reference: R22
    value: 1.5R 1%
  - board: matrix
    reference: R25
    value: 1.5R 1%
  - board: matrix
    reference: R28
    value: 1.5R 1%
  - board: matrix
    reference: R31
    value: 1.5R 1%
  - board: matrix
    reference: R34
    value: 1.5R 1%
  - board: matrix
    reference: R37
    value: 1.5R 1%
  - board: matrix
    reference: R40
    value: 1.5R 1%
  - board: matrix
    reference: R43
    value: 1.5R 1%
  - board: matrix
    reference: R46
    value: 1.5R 1%
  library_audit:
    status: passed
    checked: '2026-07-26'
    evidence: manufacturer pin and package drawing checked against the SKiDL pin numbers,
      KiCad pad numbers, polarity, top assembly side and KiCad zero-degree orientation
    checks:
    - symbol_pin_numbers_and_names
    - symbol_electrical_types
    - exposed_and_no_connect_pins
    - footprint_pad_numbers
    - package_dimensions
    - polarity_and_pin_one
    - assembly_side
    - cpl_zero_rotation
  ratings_audit:
    status: passed
    fields: value, tolerance, rated power, maximum working voltage, temperature coefficient,
      operating temperature and package dimensions
    datasheet_locator: ratings, dimensions and part-number tables
  simulation_model:
    kind: analytical
    path: hardware/sim
    valid_region: lumped model with datasheet tolerance, bias, ESR, DCR and temperature
      corners
  conflicts: []
- mpn: 0603WAF2492T5E
  manufacturer: UNI-ROYAL
  supplier: JLCPCB
  order_code: C25962
  availability:
    status: available
    checked: '2026-07-26'
    source: https://jlcpcb.com/partdetail?part=C25962
  datasheet: Vault/Scacchiera/Datasheets/0603WAF2492T5E_C25962.pdf
  wiki_source: Vault/Scacchiera/Wiki/sources/0603waf2492t5e-datasheet.md
  wiki_entity: Vault/Scacchiera/Wiki/entities/0603waf2492t5e.md
  category: resistor
  footprint: Resistor_SMD:R_0603_1608Metric
  uses:
  - board: power
    reference: R9
    value: 24.9k 1%
  library_audit:
    status: passed
    checked: '2026-07-26'
    evidence: manufacturer pin and package drawing checked against the SKiDL pin numbers,
      KiCad pad numbers, polarity, top assembly side and KiCad zero-degree orientation
    checks:
    - symbol_pin_numbers_and_names
    - symbol_electrical_types
    - exposed_and_no_connect_pins
    - footprint_pad_numbers
    - package_dimensions
    - polarity_and_pin_one
    - assembly_side
    - cpl_zero_rotation
  ratings_audit:
    status: passed
    fields: value, tolerance, rated power, maximum working voltage, temperature coefficient,
      operating temperature and package dimensions
    datasheet_locator: ratings, dimensions and part-number tables
  simulation_model:
    kind: analytical
    path: hardware/sim
    valid_region: lumped model with datasheet tolerance, bias, ESR, DCR and temperature
      corners
  conflicts: []
- mpn: 0603WAF3902T5E
  manufacturer: UNI-ROYAL
  supplier: JLCPCB
  order_code: C23153
  availability:
    status: available
    checked: '2026-07-26'
    source: https://jlcpcb.com/partdetail?part=C23153
  datasheet: Vault/Scacchiera/Datasheets/0603WAF3902T5E_C23153.pdf
  wiki_source: Vault/Scacchiera/Wiki/sources/0603waf3902t5e-datasheet.md
  wiki_entity: Vault/Scacchiera/Wiki/entities/0603waf3902t5e.md
  category: resistor
  footprint: Resistor_SMD:R_0603_1608Metric
  uses:
  - board: hub
    reference: R5
    value: 39k 1%
  - board: hub
    reference: R17
    value: 39k 1%
  - board: power
    reference: R10
    value: 39k 1%
  library_audit:
    status: passed
    checked: '2026-07-26'
    evidence: manufacturer pin and package drawing checked against the SKiDL pin numbers,
      KiCad pad numbers, polarity, top assembly side and KiCad zero-degree orientation
    checks:
    - symbol_pin_numbers_and_names
    - symbol_electrical_types
    - exposed_and_no_connect_pins
    - footprint_pad_numbers
    - package_dimensions
    - polarity_and_pin_one
    - assembly_side
    - cpl_zero_rotation
  ratings_audit:
    status: passed
    fields: value, tolerance, rated power, maximum working voltage, temperature coefficient,
      operating temperature and package dimensions
    datasheet_locator: ratings, dimensions and part-number tables
  simulation_model:
    kind: analytical
    path: hardware/sim
    valid_region: lumped model with datasheet tolerance, bias, ESR, DCR and temperature
      corners
  conflicts: []
- mpn: 0603WAF4701T5E
  manufacturer: UNI-ROYAL
  supplier: JLCPCB
  order_code: C23162
  availability:
    status: available
    checked: '2026-07-26'
    source: https://jlcpcb.com/partdetail?part=C23162
  datasheet: Vault/Scacchiera/Datasheets/0603WAF4701T5E_C23162.pdf
  wiki_source: Vault/Scacchiera/Wiki/sources/0603waf4701t5e-datasheet.md
  wiki_entity: Vault/Scacchiera/Wiki/entities/0603waf4701t5e.md
  category: resistor
  footprint: Resistor_SMD:R_0603_1608Metric
  uses:
  - board: hub
    reference: R21
    value: 4.7k
  - board: hub
    reference: R22
    value: 4.7k
  library_audit:
    status: passed
    checked: '2026-07-26'
    evidence: manufacturer pin and package drawing checked against the SKiDL pin numbers,
      KiCad pad numbers, polarity, top assembly side and KiCad zero-degree orientation
    checks:
    - symbol_pin_numbers_and_names
    - symbol_electrical_types
    - exposed_and_no_connect_pins
    - footprint_pad_numbers
    - package_dimensions
    - polarity_and_pin_one
    - assembly_side
    - cpl_zero_rotation
  ratings_audit:
    status: passed
    fields: value, tolerance, rated power, maximum working voltage, temperature coefficient,
      operating temperature and package dimensions
    datasheet_locator: ratings, dimensions and part-number tables
  simulation_model:
    kind: analytical
    path: hardware/sim
    valid_region: lumped model with datasheet tolerance, bias, ESR, DCR and temperature
      corners
  conflicts: []
- mpn: 0603WAF5101T5E
  manufacturer: UNI-ROYAL
  supplier: JLCPCB
  order_code: C23186
  availability:
    status: available
    checked: '2026-07-26'
    source: https://jlcpcb.com/partdetail?part=C23186
  datasheet: Vault/Scacchiera/Datasheets/0603WAF5101T5E_C23186.pdf
  wiki_source: Vault/Scacchiera/Wiki/sources/0603waf5101t5e-datasheet.md
  wiki_entity: Vault/Scacchiera/Wiki/entities/0603waf5101t5e.md
  category: resistor
  footprint: Resistor_SMD:R_0603_1608Metric
  uses:
  - board: hub
    reference: R1
    value: 5.1k
  - board: hub
    reference: R2
    value: 5.1k
  - board: power
    reference: R7
    value: 51k 1%
  - board: power
    reference: R11
    value: 5.1k 1%
  library_audit:
    status: passed
    checked: '2026-07-26'
    evidence: manufacturer pin and package drawing checked against the SKiDL pin numbers,
      KiCad pad numbers, polarity, top assembly side and KiCad zero-degree orientation
    checks:
    - symbol_pin_numbers_and_names
    - symbol_electrical_types
    - exposed_and_no_connect_pins
    - footprint_pad_numbers
    - package_dimensions
    - polarity_and_pin_one
    - assembly_side
    - cpl_zero_rotation
  ratings_audit:
    status: passed
    fields: value, tolerance, rated power, maximum working voltage, temperature coefficient,
      operating temperature and package dimensions
    datasheet_locator: ratings, dimensions and part-number tables
  simulation_model:
    kind: analytical
    path: hardware/sim
    valid_region: lumped model with datasheet tolerance, bias, ESR, DCR and temperature
      corners
  conflicts: []
- mpn: 0603WAF9102T5E
  manufacturer: UNI-ROYAL
  supplier: JLCPCB
  order_code: C23265
  availability:
    status: available
    checked: '2026-07-26'
    source: https://jlcpcb.com/partdetail?part=C23265
  datasheet: Vault/Scacchiera/Datasheets/0603WAF9102T5E_C23265.pdf
  wiki_source: Vault/Scacchiera/Wiki/sources/0603waf9102t5e-datasheet.md
  wiki_entity: Vault/Scacchiera/Wiki/entities/0603waf9102t5e.md
  category: resistor
  footprint: Resistor_SMD:R_0603_1608Metric
  uses:
  - board: power
    reference: R4
    value: 91k 1%
  - board: power
    reference: R5
    value: 91k 1%
  library_audit:
    status: passed
    checked: '2026-07-26'
    evidence: manufacturer pin and package drawing checked against the SKiDL pin numbers,
      KiCad pad numbers, polarity, top assembly side and KiCad zero-degree orientation
    checks:
    - symbol_pin_numbers_and_names
    - symbol_electrical_types
    - exposed_and_no_connect_pins
    - footprint_pad_numbers
    - package_dimensions
    - polarity_and_pin_one
    - assembly_side
    - cpl_zero_rotation
  ratings_audit:
    status: passed
    fields: value, tolerance, rated power, maximum working voltage, temperature coefficient,
      operating temperature and package dimensions
    datasheet_locator: ratings, dimensions and part-number tables
  simulation_model:
    kind: analytical
    path: hardware/sim
    valid_region: lumped model with datasheet tolerance, bias, ESR, DCR and temperature
      corners
  conflicts: []
- mpn: '430450200'
  manufacturer: Molex
  supplier: JLCPCB
  order_code: C122431
  availability:
    status: available
    checked: '2026-07-26'
    source: https://jlcpcb.com/partdetail?part=C122431
  datasheet: Vault/Scacchiera/Datasheets/430450200_C122431.md
  wiki_source: Vault/Scacchiera/Wiki/sources/430450200-datasheet.md
  wiki_entity: Vault/Scacchiera/Wiki/entities/430450200.md
  category: connector
  footprint: Connector_Molex:Molex_Micro-Fit_3.0_43045-0200_2x01_P3.00mm_Horizontal
  uses:
  - board: power
    reference: J3
    value: '430450200'
  library_audit:
    status: passed
    checked: '2026-07-26'
    evidence: manufacturer pin and package drawing checked against the SKiDL pin numbers,
      KiCad pad numbers, polarity, top assembly side and KiCad zero-degree orientation
    checks:
    - symbol_pin_numbers_and_names
    - symbol_electrical_types
    - exposed_and_no_connect_pins
    - footprint_pad_numbers
    - package_dimensions
    - polarity_and_pin_one
    - assembly_side
    - cpl_zero_rotation
  ratings_audit:
    status: passed
    fields: pin numbering, current, voltage, contact resistance, temperature, mating
      direction and package dimensions
    datasheet_locator: ratings, ordering information and dimensional drawing
  simulation_model:
    kind: layout_derived
    path: hardware/sim
    valid_region: contact and interconnect parasitics derived from rated contacts
      and routed geometry
  conflicts: []
- mpn: '430450800'
  manufacturer: Molex
  supplier: JLCPCB
  order_code: C122422
  availability:
    status: available
    checked: '2026-07-26'
    source: https://jlcpcb.com/partdetail?part=C122422
  datasheet: Vault/Scacchiera/Datasheets/430450800_C122422.md
  wiki_source: Vault/Scacchiera/Wiki/sources/430450800-datasheet.md
  wiki_entity: Vault/Scacchiera/Wiki/entities/430450800.md
  category: connector
  footprint: Connector_Molex:Molex_Micro-Fit_3.0_43045-0800_2x04_P3.00mm_Horizontal
  uses:
  - board: hub
    reference: J3
    value: '430450800'
  - board: power
    reference: J2
    value: '430450800'
  library_audit:
    status: passed
    checked: '2026-07-26'
    evidence: manufacturer pin and package drawing checked against the SKiDL pin numbers,
      KiCad pad numbers, polarity, top assembly side and KiCad zero-degree orientation
    checks:
    - symbol_pin_numbers_and_names
    - symbol_electrical_types
    - exposed_and_no_connect_pins
    - footprint_pad_numbers
    - package_dimensions
    - polarity_and_pin_one
    - assembly_side
    - cpl_zero_rotation
  ratings_audit:
    status: passed
    fields: pin numbering, current, voltage, contact resistance, temperature, mating
      direction and package dimensions
    datasheet_locator: ratings, ordering information and dimensional drawing
  simulation_model:
    kind: layout_derived
    path: hardware/sim
    valid_region: contact and interconnect parasitics derived from rated contacts
      and routed geometry
  conflicts: []
- mpn: 74HC595D,118
  manufacturer: Nexperia
  supplier: JLCPCB
  order_code: C5947
  availability:
    status: available
    checked: '2026-07-26'
    source: https://jlcpcb.com/partdetail?part=C5947
  datasheet: Vault/Scacchiera/Datasheets/74HC595D-118_C5947.pdf
  wiki_source: Vault/Scacchiera/Wiki/sources/74hc595d-118-datasheet.md
  wiki_entity: Vault/Scacchiera/Wiki/entities/74hc595d-118.md
  category: semiconductor
  footprint: Package_SO:SOIC-16_3.9x9.9mm_P1.27mm
  uses:
  - board: matrix
    reference: U1
    value: 74HC595D,118
  - board: matrix
    reference: U2
    value: 74HC595D,118
  library_audit:
    status: passed
    checked: '2026-07-26'
    evidence: manufacturer pin and package drawing checked against the SKiDL pin numbers,
      KiCad pad numbers, polarity, top assembly side and KiCad zero-degree orientation
    checks:
    - symbol_pin_numbers_and_names
    - symbol_electrical_types
    - exposed_and_no_connect_pins
    - footprint_pad_numbers
    - package_dimensions
    - polarity_and_pin_one
    - assembly_side
    - cpl_zero_rotation
  ratings_audit:
    status: passed
    fields: pinout, no-connect and exposed-pad treatment, recommended operating range,
      absolute maximum voltage, current, power and temperature, startup state, thermal
      data and package
    datasheet_locator: pin description, absolute maximum, recommended operation, electrical,
      thermal and package tables
  simulation_model:
    kind: datasheet_bounded
    path: hardware/sim
    valid_region: no distributable vendor ngspice model was identified; V3 may use
      only parameters enumerated in this part's filed datasheet and must sweep their
      full published limits; digital protocol behavior belongs to V6
  conflicts: []
- mpn: 7M27100009
  manufacturer: TXC
  supplier: JLCPCB
  order_code: C90919
  availability:
    status: available
    checked: '2026-07-26'
    source: https://jlcpcb.com/partdetail?part=C90919
  datasheet: Vault/Scacchiera/Datasheets/7M27100009_C90919.pdf
  wiki_source: Vault/Scacchiera/Wiki/sources/7m27100009-datasheet.md
  wiki_entity: Vault/Scacchiera/Wiki/entities/7m27100009.md
  category: crystal
  footprint: Crystal:Crystal_SMD_3225-4Pin_3.2x2.5mm
  uses:
  - board: hub
    reference: Y1
    value: 27.12MHz 7M27100009
  library_audit:
    status: passed
    checked: '2026-07-26'
    evidence: manufacturer pin and package drawing checked against the SKiDL pin numbers,
      KiCad pad numbers, polarity, top assembly side and KiCad zero-degree orientation
    checks:
    - symbol_pin_numbers_and_names
    - symbol_electrical_types
    - exposed_and_no_connect_pins
    - footprint_pad_numbers
    - package_dimensions
    - polarity_and_pin_one
    - assembly_side
    - cpl_zero_rotation
  ratings_audit:
    status: passed
    fields: frequency, tolerance, load capacitance, ESR, drive level, temperature
      stability and package dimensions
    datasheet_locator: electrical specifications and dimensions
  simulation_model:
    kind: analytical
    path: hardware/sim
    valid_region: lumped model with datasheet tolerance, bias, ESR, DCR and temperature
      corners
  conflicts: []
- mpn: A1257WR-S-4P
  manufacturer: CJT
  supplier: JLCPCB
  order_code: C225127
  availability:
    status: available
    checked: '2026-07-26'
    source: https://jlcpcb.com/partdetail?part=C225127
  datasheet: Vault/Scacchiera/Datasheets/A1257WR-S-4P_C225127.pdf
  wiki_source: Vault/Scacchiera/Wiki/sources/a1257wr-s-4p-datasheet.md
  wiki_entity: Vault/Scacchiera/Wiki/entities/a1257wr-s-4p.md
  category: connector
  footprint: Connector_JST:JST_GH_SM04B-GHS-TB_1x04-1MP_P1.25mm_Horizontal
  uses:
  - board: lightbar
    reference: J1
    value: A1257WR-S-4P
  - board: hub
    reference: J7
    value: A1257WR-S-4P
  - board: hub
    reference: J8
    value: A1257WR-S-4P
  - board: hub
    reference: J9
    value: A1257WR-S-4P
  library_audit:
    status: passed
    checked: '2026-07-26'
    evidence: manufacturer pin and package drawing checked against the SKiDL pin numbers,
      KiCad pad numbers, polarity, top assembly side and KiCad zero-degree orientation
    checks:
    - symbol_pin_numbers_and_names
    - symbol_electrical_types
    - exposed_and_no_connect_pins
    - footprint_pad_numbers
    - package_dimensions
    - polarity_and_pin_one
    - assembly_side
    - cpl_zero_rotation
  ratings_audit:
    status: passed
    fields: pin numbering, current, voltage, contact resistance, temperature, mating
      direction and package dimensions
    datasheet_locator: ratings, ordering information and dimensional drawing
  simulation_model:
    kind: layout_derived
    path: hardware/sim
    valid_region: contact and interconnect parasitics derived from rated contacts
      and routed geometry
  conflicts: []
- mpn: AP22811AW5-7
  manufacturer: Diodes Incorporated
  supplier: JLCPCB
  order_code: C3001660
  availability:
    status: available
    checked: '2026-07-26'
    source: https://jlcpcb.com/partdetail?part=C3001660
  datasheet: Vault/Scacchiera/Datasheets/AP22811AW5-7_C3001660.pdf
  wiki_source: Vault/Scacchiera/Wiki/sources/ap22811aw5-7-datasheet.md
  wiki_entity: Vault/Scacchiera/Wiki/entities/ap22811aw5-7.md
  category: semiconductor
  footprint: Package_TO_SOT_SMD:SOT-23-5
  uses:
  - board: hub
    reference: U1
    value: AP22811AW5-7
  library_audit:
    status: passed
    checked: '2026-07-26'
    evidence: manufacturer pin and package drawing checked against the SKiDL pin numbers,
      KiCad pad numbers, polarity, top assembly side and KiCad zero-degree orientation
    checks:
    - symbol_pin_numbers_and_names
    - symbol_electrical_types
    - exposed_and_no_connect_pins
    - footprint_pad_numbers
    - package_dimensions
    - polarity_and_pin_one
    - assembly_side
    - cpl_zero_rotation
  ratings_audit:
    status: passed
    fields: pinout, no-connect and exposed-pad treatment, recommended operating range,
      absolute maximum voltage, current, power and temperature, startup state, thermal
      data and package
    datasheet_locator: pin description, absolute maximum, recommended operation, electrical,
      thermal and package tables
  simulation_model:
    kind: datasheet_bounded
    path: hardware/sim
    valid_region: no distributable vendor ngspice model was identified; V3 may use
      only parameters enumerated in this part's filed datasheet and must sweep their
      full published limits; digital protocol behavior belongs to V6
  conflicts: []
- mpn: AP63203WU-7
  manufacturer: Diodes Incorporated
  supplier: JLCPCB
  order_code: C780769
  availability:
    status: available
    checked: '2026-07-26'
    source: https://jlcpcb.com/partdetail?part=C780769
  datasheet: Vault/Scacchiera/Datasheets/AP63203WU-7_C780769.pdf
  wiki_source: Vault/Scacchiera/Wiki/sources/ap63203wu-7-datasheet.md
  wiki_entity: Vault/Scacchiera/Wiki/entities/ap63203wu-7.md
  category: semiconductor
  footprint: Package_TO_SOT_SMD:SOT-23-6
  uses:
  - board: hub
    reference: U5
    value: AP63203WU-7
  library_audit:
    status: passed
    checked: '2026-07-26'
    evidence: manufacturer pin and package drawing checked against the SKiDL pin numbers,
      KiCad pad numbers, polarity, top assembly side and KiCad zero-degree orientation
    checks:
    - symbol_pin_numbers_and_names
    - symbol_electrical_types
    - exposed_and_no_connect_pins
    - footprint_pad_numbers
    - package_dimensions
    - polarity_and_pin_one
    - assembly_side
    - cpl_zero_rotation
  ratings_audit:
    status: passed
    fields: pinout, no-connect and exposed-pad treatment, recommended operating range,
      absolute maximum voltage, current, power and temperature, startup state, thermal
      data and package
    datasheet_locator: pin description, absolute maximum, recommended operation, electrical,
      thermal and package tables
  simulation_model:
    kind: datasheet_bounded
    path: hardware/sim
    valid_region: no distributable vendor ngspice model was identified; V3 may use
      only parameters enumerated in this part's filed datasheet and must sweep their
      full published limits; digital protocol behavior belongs to V6
  conflicts: []
- mpn: BAR64-02V
  manufacturer: Jiangsu Changjing Electronics Technology
  supplier: JLCPCB
  order_code: C5295579
  availability:
    status: available
    checked: '2026-07-26'
    source: https://jlcpcb.com/partdetail?part=C5295579
  datasheet: Vault/Scacchiera/Datasheets/BAR64-02V_C5295579.pdf
  wiki_source: Vault/Scacchiera/Wiki/sources/bar64-02v-datasheet.md
  wiki_entity: Vault/Scacchiera/Wiki/entities/bar64-02v.md
  category: semiconductor
  footprint: Diode_SMD:D_SOD-523
  uses:
  - board: matrix
    reference: D1
    value: BAR64-02V
  - board: matrix
    reference: D2
    value: BAR64-02V
  - board: matrix
    reference: D3
    value: BAR64-02V
  - board: matrix
    reference: D4
    value: BAR64-02V
  - board: matrix
    reference: D5
    value: BAR64-02V
  - board: matrix
    reference: D6
    value: BAR64-02V
  - board: matrix
    reference: D7
    value: BAR64-02V
  - board: matrix
    reference: D8
    value: BAR64-02V
  - board: matrix
    reference: D9
    value: BAR64-02V
  - board: matrix
    reference: D10
    value: BAR64-02V
  - board: matrix
    reference: D11
    value: BAR64-02V
  - board: matrix
    reference: D12
    value: BAR64-02V
  - board: matrix
    reference: D13
    value: BAR64-02V
  - board: matrix
    reference: D14
    value: BAR64-02V
  - board: matrix
    reference: D15
    value: BAR64-02V
  - board: matrix
    reference: D16
    value: BAR64-02V
  - board: matrix
    reference: D17
    value: BAR64-02V
  - board: matrix
    reference: D18
    value: BAR64-02V
  - board: matrix
    reference: D19
    value: BAR64-02V
  - board: matrix
    reference: D20
    value: BAR64-02V
  - board: matrix
    reference: D21
    value: BAR64-02V
  - board: matrix
    reference: D22
    value: BAR64-02V
  - board: matrix
    reference: D23
    value: BAR64-02V
  - board: matrix
    reference: D24
    value: BAR64-02V
  - board: matrix
    reference: D25
    value: BAR64-02V
  - board: matrix
    reference: D26
    value: BAR64-02V
  - board: matrix
    reference: D27
    value: BAR64-02V
  - board: matrix
    reference: D28
    value: BAR64-02V
  - board: matrix
    reference: D29
    value: BAR64-02V
  - board: matrix
    reference: D30
    value: BAR64-02V
  - board: matrix
    reference: D31
    value: BAR64-02V
  - board: matrix
    reference: D32
    value: BAR64-02V
  library_audit:
    status: passed
    checked: '2026-07-26'
    evidence: manufacturer pin and package drawing checked against the SKiDL pin numbers,
      KiCad pad numbers, polarity, top assembly side and KiCad zero-degree orientation
    checks:
    - symbol_pin_numbers_and_names
    - symbol_electrical_types
    - exposed_and_no_connect_pins
    - footprint_pad_numbers
    - package_dimensions
    - polarity_and_pin_one
    - assembly_side
    - cpl_zero_rotation
  ratings_audit:
    status: passed
    fields: pinout, no-connect and exposed-pad treatment, recommended operating range,
      absolute maximum voltage, current, power and temperature, startup state, thermal
      data and package
    datasheet_locator: pin description, absolute maximum, recommended operation, electrical,
      thermal and package tables
  simulation_model:
    kind: datasheet_bounded
    path: hardware/sim/models/bar64_02v.lib
    valid_region: 2.5 ohm maximum at 10 mA and 100 MHz; 0.55 pF maximum at 1 V and
      0.35 pF maximum at 5 V; V3 sweeps those published maxima
  conflicts: []
- mpn: BAT54H
  manufacturer: Jiangsu Changjing Electronics Technology
  supplier: JLCPCB
  order_code: C475620
  availability:
    status: available
    checked: '2026-07-26'
    source: https://jlcpcb.com/partdetail?part=C475620
  datasheet: Vault/Scacchiera/Datasheets/BAT54H_C475620.pdf
  wiki_source: Vault/Scacchiera/Wiki/sources/bat54h-datasheet.md
  wiki_entity: Vault/Scacchiera/Wiki/entities/bat54h.md
  category: semiconductor
  footprint: Diode_SMD:D_SOD-323
  uses:
  - board: power
    reference: D1
    value: BAT54H
  library_audit:
    status: passed
    checked: '2026-07-26'
    evidence: manufacturer pin and package drawing checked against the SKiDL pin numbers,
      KiCad pad numbers, polarity, top assembly side and KiCad zero-degree orientation
    checks:
    - symbol_pin_numbers_and_names
    - symbol_electrical_types
    - exposed_and_no_connect_pins
    - footprint_pad_numbers
    - package_dimensions
    - polarity_and_pin_one
    - assembly_side
    - cpl_zero_rotation
  ratings_audit:
    status: passed
    fields: pinout, no-connect and exposed-pad treatment, recommended operating range,
      absolute maximum voltage, current, power and temperature, startup state, thermal
      data and package
    datasheet_locator: pin description, absolute maximum, recommended operation, electrical,
      thermal and package tables
  simulation_model:
    kind: datasheet_bounded
    path: hardware/sim/reverse_battery.py
    valid_region: ngspice functional polarity model sweeps cold and already-powered
      insertion; comparator offset, hysteresis, power-on reset, MOSFET body diode
      and hot on-resistance are bounded from the filed component data sheets
  conflicts: []
- mpn: BQ25895RTWR
  manufacturer: Texas Instruments
  supplier: JLCPCB
  order_code: C80200
  availability:
    status: available
    checked: '2026-07-26'
    source: https://jlcpcb.com/partdetail?part=C80200
  datasheet: Vault/Scacchiera/Datasheets/BQ25895RTWR_C80200.pdf
  wiki_source: Vault/Scacchiera/Wiki/sources/bq25895rtwr-datasheet.md
  wiki_entity: Vault/Scacchiera/Wiki/entities/bq25895rtwr.md
  category: semiconductor
  footprint: Package_DFN_QFN:Texas_RTW_WQFN-24-1EP_4x4mm_P0.5mm_EP2.7x2.7mm
  uses:
  - board: power
    reference: U1
    value: BQ25895RTWR
  library_audit:
    status: passed
    checked: '2026-07-26'
    evidence: manufacturer pin and package drawing checked against the SKiDL pin numbers,
      KiCad pad numbers, polarity, top assembly side and KiCad zero-degree orientation
    checks:
    - symbol_pin_numbers_and_names
    - symbol_electrical_types
    - exposed_and_no_connect_pins
    - footprint_pad_numbers
    - package_dimensions
    - polarity_and_pin_one
    - assembly_side
    - cpl_zero_rotation
  ratings_audit:
    status: passed
    fields: pinout, no-connect and exposed-pad treatment, recommended operating range,
      absolute maximum voltage, current, power and temperature, startup state, thermal
      data and package
    datasheet_locator: pin description, absolute maximum, recommended operation, electrical,
      thermal and package tables
  simulation_model:
    kind: datasheet_bounded
    path: hardware/sim
    valid_region: no distributable vendor ngspice model was identified; V3 may use
      only parameters enumerated in this part's filed datasheet and must sweep their
      full published limits; digital protocol behavior belongs to V6
  conflicts: []
- mpn: BSS123-7-F
  manufacturer: Diodes Incorporated
  supplier: JLCPCB
  order_code: C85107
  availability:
    status: available
    checked: '2026-07-26'
    source: https://jlcpcb.com/partdetail?part=C85107
  datasheet: Vault/Scacchiera/Datasheets/BSS123-7-F_C85107.pdf
  wiki_source: Vault/Scacchiera/Wiki/sources/bss123-7-f-datasheet.md
  wiki_entity: Vault/Scacchiera/Wiki/entities/bss123-7-f.md
  category: semiconductor
  footprint: Package_TO_SOT_SMD:SOT-23
  uses:
  - board: matrix
    reference: Q1
    value: BSS123-7-F
  - board: matrix
    reference: Q3
    value: BSS123-7-F
  - board: matrix
    reference: Q5
    value: BSS123-7-F
  - board: matrix
    reference: Q7
    value: BSS123-7-F
  - board: matrix
    reference: Q9
    value: BSS123-7-F
  - board: matrix
    reference: Q11
    value: BSS123-7-F
  - board: matrix
    reference: Q13
    value: BSS123-7-F
  - board: matrix
    reference: Q15
    value: BSS123-7-F
  - board: matrix
    reference: Q17
    value: BSS123-7-F
  - board: matrix
    reference: Q19
    value: BSS123-7-F
  - board: matrix
    reference: Q21
    value: BSS123-7-F
  - board: matrix
    reference: Q23
    value: BSS123-7-F
  - board: matrix
    reference: Q25
    value: BSS123-7-F
  - board: matrix
    reference: Q27
    value: BSS123-7-F
  - board: matrix
    reference: Q29
    value: BSS123-7-F
  - board: matrix
    reference: Q31
    value: BSS123-7-F
  library_audit:
    status: passed
    checked: '2026-07-26'
    evidence: manufacturer pin and package drawing checked against the SKiDL pin numbers,
      KiCad pad numbers, polarity, top assembly side and KiCad zero-degree orientation
    checks:
    - symbol_pin_numbers_and_names
    - symbol_electrical_types
    - exposed_and_no_connect_pins
    - footprint_pad_numbers
    - package_dimensions
    - polarity_and_pin_one
    - assembly_side
    - cpl_zero_rotation
  ratings_audit:
    status: passed
    fields: pinout, no-connect and exposed-pad treatment, recommended operating range,
      absolute maximum voltage, current, power and temperature, startup state, thermal
      data and package
    datasheet_locator: pin description, absolute maximum, recommended operation, electrical,
      thermal and package tables
  simulation_model:
    kind: vendor
    path: hardware/sim/models/vendor/BSS123.spice.txt
    valid_region: Diodes model for BSS123, D-G-S order; corner limits remain datasheet
      bounded
  conflicts: []
- mpn: BSS84-7-F
  manufacturer: Diodes Incorporated
  supplier: JLCPCB
  order_code: C85202
  availability:
    status: available
    checked: '2026-07-26'
    source: https://jlcpcb.com/partdetail?part=C85202
  datasheet: Vault/Scacchiera/Datasheets/BSS84-7-F_C85202.pdf
  wiki_source: Vault/Scacchiera/Wiki/sources/bss84-7-f-datasheet.md
  wiki_entity: Vault/Scacchiera/Wiki/entities/bss84-7-f.md
  category: semiconductor
  footprint: Package_TO_SOT_SMD:SOT-23
  uses:
  - board: matrix
    reference: Q2
    value: BSS84-7-F
  - board: matrix
    reference: Q4
    value: BSS84-7-F
  - board: matrix
    reference: Q6
    value: BSS84-7-F
  - board: matrix
    reference: Q8
    value: BSS84-7-F
  - board: matrix
    reference: Q10
    value: BSS84-7-F
  - board: matrix
    reference: Q12
    value: BSS84-7-F
  - board: matrix
    reference: Q14
    value: BSS84-7-F
  - board: matrix
    reference: Q16
    value: BSS84-7-F
  - board: matrix
    reference: Q18
    value: BSS84-7-F
  - board: matrix
    reference: Q20
    value: BSS84-7-F
  - board: matrix
    reference: Q22
    value: BSS84-7-F
  - board: matrix
    reference: Q24
    value: BSS84-7-F
  - board: matrix
    reference: Q26
    value: BSS84-7-F
  - board: matrix
    reference: Q28
    value: BSS84-7-F
  - board: matrix
    reference: Q30
    value: BSS84-7-F
  - board: matrix
    reference: Q32
    value: BSS84-7-F
  library_audit:
    status: passed
    checked: '2026-07-26'
    evidence: manufacturer pin and package drawing checked against the SKiDL pin numbers,
      KiCad pad numbers, polarity, top assembly side and KiCad zero-degree orientation
    checks:
    - symbol_pin_numbers_and_names
    - symbol_electrical_types
    - exposed_and_no_connect_pins
    - footprint_pad_numbers
    - package_dimensions
    - polarity_and_pin_one
    - assembly_side
    - cpl_zero_rotation
  ratings_audit:
    status: passed
    fields: pinout, no-connect and exposed-pad treatment, recommended operating range,
      absolute maximum voltage, current, power and temperature, startup state, thermal
      data and package
    datasheet_locator: pin description, absolute maximum, recommended operation, electrical,
      thermal and package tables
  simulation_model:
    kind: vendor
    path: hardware/sim/models/vendor/BSS84.spice.txt
    valid_region: Diodes model for BSS84, D-G-S order; corner limits remain datasheet
      bounded
  conflicts: []
- mpn: CC0603FRNPO9BN221
  manufacturer: Yageo
  supplier: JLCPCB
  order_code: C519500
  availability:
    status: available
    checked: '2026-07-26'
    source: https://jlcpcb.com/partdetail?part=C519500
  datasheet: Vault/Scacchiera/Datasheets/CC0603FRNPO9BN221_C519500.pdf
  wiki_source: Vault/Scacchiera/Wiki/sources/cc0603frnpo9bn221-datasheet.md
  wiki_entity: Vault/Scacchiera/Wiki/entities/cc0603frnpo9bn221.md
  category: capacitor
  footprint: Capacitor_SMD:C_0603_1608Metric
  uses:
  - board: matrix
    reference: C2
    value: 220p C0G 2%
  - board: matrix
    reference: C6
    value: 220p C0G 2%
  - board: matrix
    reference: C10
    value: 220p C0G 2%
  - board: matrix
    reference: C14
    value: 220p C0G 2%
  - board: matrix
    reference: C18
    value: 220p C0G 2%
  - board: matrix
    reference: C22
    value: 220p C0G 2%
  - board: matrix
    reference: C26
    value: 220p C0G 2%
  - board: matrix
    reference: C30
    value: 220p C0G 2%
  - board: matrix
    reference: C34
    value: 220p C0G 2%
  - board: matrix
    reference: C38
    value: 220p C0G 2%
  - board: matrix
    reference: C42
    value: 220p C0G 2%
  - board: matrix
    reference: C46
    value: 220p C0G 2%
  - board: matrix
    reference: C50
    value: 220p C0G 2%
  - board: matrix
    reference: C54
    value: 220p C0G 2%
  - board: matrix
    reference: C58
    value: 220p C0G 2%
  - board: matrix
    reference: C62
    value: 220p C0G 2%
  library_audit:
    status: passed
    checked: '2026-07-26'
    evidence: manufacturer pin and package drawing checked against the SKiDL pin numbers,
      KiCad pad numbers, polarity, top assembly side and KiCad zero-degree orientation
    checks:
    - symbol_pin_numbers_and_names
    - symbol_electrical_types
    - exposed_and_no_connect_pins
    - footprint_pad_numbers
    - package_dimensions
    - polarity_and_pin_one
    - assembly_side
    - cpl_zero_rotation
  ratings_audit:
    status: passed
    fields: capacitance, tolerance, rated voltage, dielectric, temperature range,
      DC-bias behavior where published and package dimensions
    datasheet_locator: part-number, characteristics and dimensions tables
  simulation_model:
    kind: analytical
    path: hardware/sim
    valid_region: lumped model with datasheet tolerance, bias, ESR, DCR and temperature
      corners
  conflicts: []
- mpn: CC1206KKX7RCBB472
  manufacturer: Yageo
  supplier: JLCPCB
  order_code: C107198
  availability:
    status: available
    checked: '2026-07-26'
    source: https://jlcpcb.com/partdetail?part=C107198
  datasheet: Vault/Scacchiera/Datasheets/CC1206KKX7RCBB472_C107198.pdf
  wiki_source: Vault/Scacchiera/Wiki/sources/cc1206kkx7rcbb472-datasheet.md
  wiki_entity: Vault/Scacchiera/Wiki/entities/cc1206kkx7rcbb472.md
  category: capacitor
  footprint: Capacitor_SMD:C_1206_3216Metric
  uses:
  - board: hub
    reference: C12
    value: 4.7n 1kV
  library_audit:
    status: passed
    checked: '2026-07-26'
    evidence: manufacturer pin and package drawing checked against the SKiDL pin numbers,
      KiCad pad numbers, polarity, top assembly side and KiCad zero-degree orientation
    checks:
    - symbol_pin_numbers_and_names
    - symbol_electrical_types
    - exposed_and_no_connect_pins
    - footprint_pad_numbers
    - package_dimensions
    - polarity_and_pin_one
    - assembly_side
    - cpl_zero_rotation
  ratings_audit:
    status: passed
    fields: capacitance, tolerance, rated voltage, dielectric, temperature range,
      DC-bias behavior where published and package dimensions
    datasheet_locator: part-number, characteristics and dimensions tables
  simulation_model:
    kind: analytical
    path: hardware/sim
    valid_region: lumped model with datasheet tolerance, bias, ESR, DCR and temperature
      corners
  conflicts: []
- mpn: CDMC8D28NP-1R2MC
  manufacturer: Sumida
  supplier: JLCPCB
  order_code: C17268233
  availability:
    status: available
    checked: '2026-07-26'
    source: https://jlcpcb.com/partdetail?part=C17268233
  datasheet: Vault/Scacchiera/Datasheets/CDMC8D28NP-1R2MC_C17268233.pdf
  wiki_source: Vault/Scacchiera/Wiki/sources/cdmc8d28np-1r2mc-datasheet.md
  wiki_entity: Vault/Scacchiera/Wiki/entities/cdmc8d28np-1r2mc.md
  category: inductor
  footprint: Chessboard:CDMC8D28
  uses:
  - board: power
    reference: L2
    value: 1.2uH
  library_audit:
    status: passed
    checked: '2026-07-26'
    evidence: manufacturer pin and package drawing checked against the SKiDL pin numbers,
      KiCad pad numbers, polarity, top assembly side and KiCad zero-degree orientation
    checks:
    - symbol_pin_numbers_and_names
    - symbol_electrical_types
    - exposed_and_no_connect_pins
    - footprint_pad_numbers
    - package_dimensions
    - polarity_and_pin_one
    - assembly_side
    - cpl_zero_rotation
  ratings_audit:
    status: passed
    fields: inductance, tolerance, rated or saturation current, DC resistance, self-resonance,
      temperature range and package dimensions
    datasheet_locator: electrical characteristics, ratings and dimensions tables
  simulation_model:
    kind: analytical
    path: hardware/sim
    valid_region: lumped model with datasheet tolerance, bias, ESR, DCR and temperature
      corners
  conflicts: []
- mpn: CL05A105KA5NQNC
  manufacturer: Samsung Electro-Mechanics
  supplier: JLCPCB
  order_code: C52923
  availability:
    status: available
    checked: '2026-07-26'
    source: https://jlcpcb.com/partdetail?part=C52923
  datasheet: Vault/Scacchiera/Datasheets/CL05A105KA5NQNC_C52923_manufacturer.pdf
  wiki_source: Vault/Scacchiera/Wiki/sources/cl05a105ka5nqnc-datasheet.md
  wiki_entity: Vault/Scacchiera/Wiki/entities/cl05a105ka5nqnc.md
  category: capacitor
  footprint: Capacitor_SMD:C_0402_1005Metric
  uses:
  - board: hub
    reference: C20
    value: 1u 25V
  - board: hub
    reference: C24
    value: 1u 25V
  library_audit:
    status: passed
    checked: '2026-07-26'
    evidence: manufacturer pin and package drawing checked against the SKiDL pin numbers,
      KiCad pad numbers, polarity, top assembly side and KiCad zero-degree orientation
    checks:
    - symbol_pin_numbers_and_names
    - symbol_electrical_types
    - exposed_and_no_connect_pins
    - footprint_pad_numbers
    - package_dimensions
    - polarity_and_pin_one
    - assembly_side
    - cpl_zero_rotation
  ratings_audit:
    status: passed
    fields: capacitance, tolerance, rated voltage, dielectric, temperature range,
      DC-bias behavior where published and package dimensions
    datasheet_locator: part-number, characteristics and dimensions tables
  simulation_model:
    kind: analytical
    path: hardware/sim
    valid_region: lumped model with datasheet tolerance, bias, ESR, DCR and temperature
      corners
  conflicts: []
- mpn: CL05B104KO5NNNC
  manufacturer: Samsung Electro-Mechanics
  supplier: JLCPCB
  order_code: C1525
  availability:
    status: available
    checked: '2026-07-26'
    source: https://jlcpcb.com/partdetail?part=C1525
  datasheet: Vault/Scacchiera/Datasheets/CL05B104KO5NNNC_C1525_manufacturer.pdf
  wiki_source: Vault/Scacchiera/Wiki/sources/cl05b104ko5nnnc-datasheet.md
  wiki_entity: Vault/Scacchiera/Wiki/entities/cl05b104ko5nnnc.md
  category: capacitor
  footprint: Capacitor_SMD:C_0402_1005Metric
  uses:
  - board: lightbar
    reference: C1
    value: 100n
  - board: lightbar
    reference: C2
    value: 100n
  - board: lightbar
    reference: C3
    value: 100n
  - board: lightbar
    reference: C4
    value: 100n
  - board: lightbar
    reference: C5
    value: 100n
  - board: lightbar
    reference: C6
    value: 100n
  - board: lightbar
    reference: C7
    value: 100n
  - board: lightbar
    reference: C8
    value: 100n
  - board: lightbar
    reference: C9
    value: 100n
  - board: lightbar
    reference: C10
    value: 100n
  - board: lightbar
    reference: C11
    value: 100n
  - board: lightbar
    reference: C12
    value: 100n
  - board: lightbar
    reference: C13
    value: 100n
  - board: lightbar
    reference: C14
    value: 100n
  - board: matrix
    reference: C65
    value: 100n X7R 10%
  - board: matrix
    reference: C66
    value: 100n X7R 10%
  - board: matrix
    reference: C1
    value: 100n X7R 10%
  - board: matrix
    reference: C5
    value: 100n X7R 10%
  - board: matrix
    reference: C9
    value: 100n X7R 10%
  - board: matrix
    reference: C13
    value: 100n X7R 10%
  - board: matrix
    reference: C17
    value: 100n X7R 10%
  - board: matrix
    reference: C21
    value: 100n X7R 10%
  - board: matrix
    reference: C25
    value: 100n X7R 10%
  - board: matrix
    reference: C29
    value: 100n X7R 10%
  - board: matrix
    reference: C33
    value: 100n X7R 10%
  - board: matrix
    reference: C37
    value: 100n X7R 10%
  - board: matrix
    reference: C41
    value: 100n X7R 10%
  - board: matrix
    reference: C45
    value: 100n X7R 10%
  - board: matrix
    reference: C49
    value: 100n X7R 10%
  - board: matrix
    reference: C53
    value: 100n X7R 10%
  - board: matrix
    reference: C57
    value: 100n X7R 10%
  - board: matrix
    reference: C61
    value: 100n X7R 10%
  - board: hub
    reference: C38
    value: 100n
  - board: hub
    reference: C39
    value: 100n
  - board: hub
    reference: C15
    value: 100n
  - board: hub
    reference: C16
    value: 100n
  - board: hub
    reference: C17
    value: 100n
  - board: hub
    reference: C18
    value: 100n
  - board: hub
    reference: C1
    value: 100n
  - board: hub
    reference: C10
    value: 100n
  - board: hub
    reference: C11
    value: 100n
  - board: hub
    reference: C28
    value: 100n
  - board: hub
    reference: C21
    value: 100n
  - board: hub
    reference: C22
    value: 100n
  - board: hub
    reference: C23
    value: 100n
  - board: hub
    reference: C26
    value: 100n
  - board: power
    reference: C21
    value: 100n 16V
  - board: power
    reference: C1
    value: 100n 16V
  - board: power
    reference: C2
    value: 100n 16V
  - board: power
    reference: C20
    value: 100n 16V
  - board: power
    reference: C10
    value: 100n 16V
  - board: power
    reference: C11
    value: 100n 16V
  - board: power
    reference: C12
    value: 100n 16V
  - board: power
    reference: C16
    value: 100n 16V
  library_audit:
    status: passed
    checked: '2026-07-26'
    evidence: manufacturer pin and package drawing checked against the SKiDL pin numbers,
      KiCad pad numbers, polarity, top assembly side and KiCad zero-degree orientation
    checks:
    - symbol_pin_numbers_and_names
    - symbol_electrical_types
    - exposed_and_no_connect_pins
    - footprint_pad_numbers
    - package_dimensions
    - polarity_and_pin_one
    - assembly_side
    - cpl_zero_rotation
  ratings_audit:
    status: passed
    fields: capacitance, tolerance, rated voltage, dielectric, temperature range,
      DC-bias behavior where published and package dimensions
    datasheet_locator: part-number, characteristics and dimensions tables
  simulation_model:
    kind: analytical
    path: hardware/sim
    valid_region: lumped model with datasheet tolerance, bias, ESR, DCR and temperature
      corners
  conflicts: []
- mpn: CL10A105KB8NNNC
  manufacturer: Samsung Electro-Mechanics
  supplier: JLCPCB
  order_code: C15849
  availability:
    status: available
    checked: '2026-07-26'
    source: https://jlcpcb.com/partdetail?part=C15849
  datasheet: Vault/Scacchiera/Datasheets/CL10A105KB8NNNC_C15849_manufacturer.pdf
  wiki_source: Vault/Scacchiera/Wiki/sources/cl10a105kb8nnnc-datasheet.md
  wiki_entity: Vault/Scacchiera/Wiki/entities/cl10a105kb8nnnc.md
  category: capacitor
  footprint: Capacitor_SMD:C_0603_1608Metric
  uses:
  - board: hub
    reference: C13
    value: 1u 50V
  - board: hub
    reference: C6
    value: 1u
  - board: power
    reference: C3
    value: 1u 25V
  - board: power
    reference: C17
    value: 1u 25V
  library_audit:
    status: passed
    checked: '2026-07-26'
    evidence: manufacturer pin and package drawing checked against the SKiDL pin numbers,
      KiCad pad numbers, polarity, top assembly side and KiCad zero-degree orientation
    checks:
    - symbol_pin_numbers_and_names
    - symbol_electrical_types
    - exposed_and_no_connect_pins
    - footprint_pad_numbers
    - package_dimensions
    - polarity_and_pin_one
    - assembly_side
    - cpl_zero_rotation
  ratings_audit:
    status: passed
    fields: capacitance, tolerance, rated voltage, dielectric, temperature range,
      DC-bias behavior where published and package dimensions
    datasheet_locator: part-number, characteristics and dimensions tables
  simulation_model:
    kind: analytical
    path: hardware/sim
    valid_region: lumped model with datasheet tolerance, bias, ESR, DCR and temperature
      corners
  conflicts: []
- mpn: CL10A225KO8NNNC
  manufacturer: Samsung Electro-Mechanics
  supplier: JLCPCB
  order_code: C23630
  availability:
    status: available
    checked: '2026-07-26'
    source: https://jlcpcb.com/partdetail?part=C23630
  datasheet: Vault/Scacchiera/Datasheets/CL10A225KO8NNNC_C23630_manufacturer.pdf
  wiki_source: Vault/Scacchiera/Wiki/sources/cl10a225ko8nnnc-datasheet.md
  wiki_entity: Vault/Scacchiera/Wiki/entities/cl10a225ko8nnnc.md
  category: capacitor
  footprint: Capacitor_SMD:C_0603_1608Metric
  uses:
  - board: hub
    reference: C25
    value: 2.2u 16V
  - board: power
    reference: C9
    value: 2.2u 16V
  library_audit:
    status: passed
    checked: '2026-07-26'
    evidence: manufacturer pin and package drawing checked against the SKiDL pin numbers,
      KiCad pad numbers, polarity, top assembly side and KiCad zero-degree orientation
    checks:
    - symbol_pin_numbers_and_names
    - symbol_electrical_types
    - exposed_and_no_connect_pins
    - footprint_pad_numbers
    - package_dimensions
    - polarity_and_pin_one
    - assembly_side
    - cpl_zero_rotation
  ratings_audit:
    status: passed
    fields: capacitance, tolerance, rated voltage, dielectric, temperature range,
      DC-bias behavior where published and package dimensions
    datasheet_locator: part-number, characteristics and dimensions tables
  simulation_model:
    kind: analytical
    path: hardware/sim
    valid_region: lumped model with datasheet tolerance, bias, ESR, DCR and temperature
      corners
  conflicts: []
- mpn: CL21A106KAYNNNE
  manufacturer: Samsung Electro-Mechanics
  supplier: JLCPCB
  order_code: C15850
  availability:
    status: available
    checked: '2026-07-26'
    source: https://jlcpcb.com/partdetail?part=C15850
  datasheet: Vault/Scacchiera/Datasheets/CL21A106KAYNNNE_C15850_manufacturer.pdf
  wiki_source: Vault/Scacchiera/Wiki/sources/cl21a106kaynnne-datasheet.md
  wiki_entity: Vault/Scacchiera/Wiki/entities/cl21a106kaynnne.md
  category: capacitor
  footprint: Capacitor_SMD:C_0805_2012Metric
  uses:
  - board: hub
    reference: C14
    value: 10u 25V
  - board: hub
    reference: C2
    value: 10u 25V
  - board: hub
    reference: C27
    value: 10u 25V
  - board: power
    reference: C8
    value: 10u 25V
  library_audit:
    status: passed
    checked: '2026-07-26'
    evidence: manufacturer pin and package drawing checked against the SKiDL pin numbers,
      KiCad pad numbers, polarity, top assembly side and KiCad zero-degree orientation
    checks:
    - symbol_pin_numbers_and_names
    - symbol_electrical_types
    - exposed_and_no_connect_pins
    - footprint_pad_numbers
    - package_dimensions
    - polarity_and_pin_one
    - assembly_side
    - cpl_zero_rotation
  ratings_audit:
    status: passed
    fields: capacitance, tolerance, rated voltage, dielectric, temperature range,
      DC-bias behavior where published and package dimensions
    datasheet_locator: part-number, characteristics and dimensions tables
  simulation_model:
    kind: analytical
    path: hardware/sim
    valid_region: lumped model with datasheet tolerance, bias, ESR, DCR and temperature
      corners
  conflicts: []
- mpn: CL21A226MAQNNNE
  manufacturer: Samsung Electro-Mechanics
  supplier: JLCPCB
  order_code: C45783
  availability:
    status: available
    checked: '2026-07-26'
    source: https://jlcpcb.com/partdetail?part=C45783
  datasheet: Vault/Scacchiera/Datasheets/CL21A226MAQNNNE_C45783_manufacturer.pdf
  wiki_source: Vault/Scacchiera/Wiki/sources/cl21a226maqnnne-datasheet.md
  wiki_entity: Vault/Scacchiera/Wiki/entities/cl21a226maqnnne.md
  category: capacitor
  footprint: Capacitor_SMD:C_0805_2012Metric
  uses:
  - board: hub
    reference: C3
    value: 22u 25V
  - board: hub
    reference: C4
    value: 22u 25V
  - board: power
    reference: C7
    value: 22u 25V
  - board: power
    reference: C15
    value: 22u 25V
  - board: power
    reference: C18
    value: 22u 25V
  - board: power
    reference: C19
    value: 22u 25V
  - board: power
    reference: C22
    value: 22u 25V
  library_audit:
    status: passed
    checked: '2026-07-26'
    evidence: manufacturer pin and package drawing checked against the SKiDL pin numbers,
      KiCad pad numbers, polarity, top assembly side and KiCad zero-degree orientation
    checks:
    - symbol_pin_numbers_and_names
    - symbol_electrical_types
    - exposed_and_no_connect_pins
    - footprint_pad_numbers
    - package_dimensions
    - polarity_and_pin_one
    - assembly_side
    - cpl_zero_rotation
  ratings_audit:
    status: passed
    fields: capacitance, tolerance, rated voltage, dielectric, temperature range,
      DC-bias behavior where published and package dimensions
    datasheet_locator: part-number, characteristics and dimensions tables
  simulation_model:
    kind: analytical
    path: hardware/sim/power_boost.py
    valid_region: initial tolerance and X5R temperature change are datasheet-bounded;
      the 50 percent DC-bias value is a sensitivity bound, and 500 kHz ESR remains
      open
  conflicts: []
- mpn: CL21A475KAQNNNE
  manufacturer: Samsung Electro-Mechanics
  supplier: JLCPCB
  order_code: C1779
  availability:
    status: available
    checked: '2026-07-26'
    source: https://jlcpcb.com/partdetail?part=C1779
  datasheet: Vault/Scacchiera/Datasheets/CL21A475KAQNNNE_C1779_manufacturer.pdf
  wiki_source: Vault/Scacchiera/Wiki/sources/cl21a475kaqnnne-datasheet.md
  wiki_entity: Vault/Scacchiera/Wiki/entities/cl21a475kaqnnne.md
  category: capacitor
  footprint: Capacitor_SMD:C_0805_2012Metric
  uses:
  - board: power
    reference: C4
    value: 4.7u 25V
  - board: power
    reference: C5
    value: 4.7u 25V
  - board: power
    reference: C14
    value: 4.7u 25V
  - board: power
    reference: C6
    value: 4.7u 25V
  library_audit:
    status: passed
    checked: '2026-07-26'
    evidence: manufacturer pin and package drawing checked against the SKiDL pin numbers,
      KiCad pad numbers, polarity, top assembly side and KiCad zero-degree orientation
    checks:
    - symbol_pin_numbers_and_names
    - symbol_electrical_types
    - exposed_and_no_connect_pins
    - footprint_pad_numbers
    - package_dimensions
    - polarity_and_pin_one
    - assembly_side
    - cpl_zero_rotation
  ratings_audit:
    status: passed
    fields: capacitance, tolerance, rated voltage, dielectric, temperature range,
      DC-bias behavior where published and package dimensions
    datasheet_locator: part-number, characteristics and dimensions tables
  simulation_model:
    kind: analytical
    path: hardware/sim
    valid_region: lumped model with datasheet tolerance, bias, ESR, DCR and temperature
      corners
  conflicts: []
- mpn: CL32A107MQVNNNE
  manufacturer: Samsung Electro-Mechanics
  supplier: JLCPCB
  order_code: C49066
  availability:
    status: available
    checked: '2026-07-26'
    source: https://jlcpcb.com/partdetail?part=C49066
  datasheet: Vault/Scacchiera/Datasheets/CL32A107MQVNNNE_C49066_manufacturer.pdf
  wiki_source: Vault/Scacchiera/Wiki/sources/cl32a107mqvnnne-datasheet.md
  wiki_entity: Vault/Scacchiera/Wiki/entities/cl32a107mqvnnne.md
  category: capacitor
  footprint: Capacitor_SMD:C_1210_3225Metric
  uses:
  - board: lightbar
    reference: C15
    value: 100u 6.3V
  library_audit:
    status: passed
    checked: '2026-07-26'
    evidence: manufacturer pin and package drawing checked against the SKiDL pin numbers,
      KiCad pad numbers, polarity, top assembly side and KiCad zero-degree orientation
    checks:
    - symbol_pin_numbers_and_names
    - symbol_electrical_types
    - exposed_and_no_connect_pins
    - footprint_pad_numbers
    - package_dimensions
    - polarity_and_pin_one
    - assembly_side
    - cpl_zero_rotation
  ratings_audit:
    status: passed
    fields: capacitance, tolerance, rated voltage, dielectric, temperature range,
      DC-bias behavior where published and package dimensions
    datasheet_locator: part-number, characteristics and dimensions tables
  simulation_model:
    kind: analytical
    path: hardware/sim
    valid_region: lumped model with datasheet tolerance, bias, ESR, DCR and temperature
      corners
  conflicts: []
- mpn: CSD25404Q3
  manufacturer: Texas Instruments
  supplier: JLCPCB
  order_code: C2865523
  availability:
    status: available
    checked: '2026-07-26'
    source: https://jlcpcb.com/partdetail?part=C2865523
  datasheet: Vault/Scacchiera/Datasheets/CSD25404Q3_C2865523.pdf
  wiki_source: Vault/Scacchiera/Wiki/sources/csd25404q3-datasheet.md
  wiki_entity: Vault/Scacchiera/Wiki/entities/csd25404q3.md
  category: semiconductor
  footprint: Chessboard:CSD25404Q3_DQG
  uses:
  - board: power
    reference: Q1
    value: CSD25404Q3
  library_audit:
    status: passed
    checked: '2026-07-26'
    evidence: manufacturer pin and package drawing checked against the SKiDL pin numbers,
      KiCad pad numbers, polarity, top assembly side and KiCad zero-degree orientation
    checks:
    - symbol_pin_numbers_and_names
    - symbol_electrical_types
    - exposed_and_no_connect_pins
    - footprint_pad_numbers
    - package_dimensions
    - polarity_and_pin_one
    - assembly_side
    - cpl_zero_rotation
  ratings_audit:
    status: passed
    fields: pinout, no-connect and exposed-pad treatment, recommended operating range,
      absolute maximum voltage, current, power and temperature, startup state, thermal
      data and package
    datasheet_locator: pin description, absolute maximum, recommended operation, electrical,
      thermal and package tables
  simulation_model:
    kind: datasheet_bounded
    path: hardware/sim/reverse_battery.py
    valid_region: ngspice functional polarity model sweeps cold and already-powered
      insertion; comparator offset, hysteresis, power-on reset, MOSFET body diode
      and hot on-resistance are bounded from the filed component data sheets
  conflicts: []
- mpn: DFE252012F-1R0M=P2
  manufacturer: Murata
  supplier: JLCPCB
  order_code: C435392
  availability:
    status: available
    checked: '2026-07-26'
    source: https://jlcpcb.com/partdetail?part=C435392
  datasheet: Vault/Scacchiera/Datasheets/DFE252012F-1R0M-P2_C435392.pdf
  wiki_source: Vault/Scacchiera/Wiki/sources/dfe252012f-1r0m-p2-datasheet.md
  wiki_entity: Vault/Scacchiera/Wiki/entities/dfe252012f-1r0m-p2.md
  category: inductor
  footprint: Chessboard:DFE252012F
  uses:
  - board: power
    reference: L1
    value: 1uH
  library_audit:
    status: passed
    checked: '2026-07-26'
    evidence: manufacturer pin and package drawing checked against the SKiDL pin numbers,
      KiCad pad numbers, polarity, top assembly side and KiCad zero-degree orientation
    checks:
    - symbol_pin_numbers_and_names
    - symbol_electrical_types
    - exposed_and_no_connect_pins
    - footprint_pad_numbers
    - package_dimensions
    - polarity_and_pin_one
    - assembly_side
    - cpl_zero_rotation
  ratings_audit:
    status: passed
    fields: inductance, tolerance, rated or saturation current, DC resistance, self-resonance,
      temperature range and package dimensions
    datasheet_locator: electrical characteristics, ratings and dimensions tables
  simulation_model:
    kind: analytical
    path: hardware/sim
    valid_region: lumped model with datasheet tolerance, bias, ESR, DCR and temperature
      corners
  conflicts: []
- mpn: ESP32-C6-MINI-1U-N4
  manufacturer: Espressif Systems
  supplier: DigiKey
  order_code: 1965-ESP32-C6-MINI-1U-N4CT-ND
  availability:
    status: available
    checked: '2026-07-26'
    source: https://www.digikey.es/es/products/detail/espressif-systems/ESP32-C6-MINI-1U-N4/21292143
  datasheet: Vault/Scacchiera/Datasheets/ESP32-C6-MINI-1U-N4_C7558096.pdf
  wiki_source: Vault/Scacchiera/Wiki/sources/esp32-c6-mini-1u-n4-datasheet.md
  wiki_entity: Vault/Scacchiera/Wiki/entities/esp32-c6-mini-1u-n4.md
  category: semiconductor
  footprint: Chessboard:ESP32-C6-MINI-1U
  uses:
  - board: hub
    reference: U4
    value: ESP32-C6-MINI-1U-N4
  library_audit:
    status: passed
    checked: '2026-07-26'
    evidence: manufacturer pin and package drawing checked against the SKiDL pin numbers,
      KiCad pad numbers, polarity, top assembly side and KiCad zero-degree orientation
    checks:
    - symbol_pin_numbers_and_names
    - symbol_electrical_types
    - exposed_and_no_connect_pins
    - footprint_pad_numbers
    - package_dimensions
    - polarity_and_pin_one
    - assembly_side
    - cpl_zero_rotation
  ratings_audit:
    status: passed
    fields: pinout, no-connect and exposed-pad treatment, recommended operating range,
      absolute maximum voltage, current, power and temperature, startup state, thermal
      data and package
    datasheet_locator: pin description, absolute maximum, recommended operation, electrical,
      thermal and package tables
  simulation_model:
    kind: datasheet_bounded
    path: hardware/sim
    valid_region: no distributable vendor ngspice model was identified; V3 may use
      only parameters enumerated in this part's filed datasheet and must sweep their
      full published limits; digital protocol behavior belongs to V6
  conflicts: []
- mpn: GRM1555C1H221JA01D
  manufacturer: Murata
  supplier: JLCPCB
  order_code: C71693
  availability:
    status: available
    checked: '2026-07-26'
    source: https://jlcpcb.com/partdetail?part=C71693
  datasheet: Vault/Scacchiera/Datasheets/GRM1555C1H221JA01D_C71693.pdf
  wiki_source: Vault/Scacchiera/Wiki/sources/grm1555c1h221ja01d-datasheet.md
  wiki_entity: Vault/Scacchiera/Wiki/entities/grm1555c1h221ja01d.md
  category: capacitor
  footprint: Capacitor_SMD:C_0402_1005Metric
  uses:
  - board: hub
    reference: C33
    value: 220p C0G 2%
  - board: hub
    reference: C36
    value: 220p C0G 2%
  library_audit:
    status: passed
    checked: '2026-07-26'
    evidence: manufacturer pin and package drawing checked against the SKiDL pin numbers,
      KiCad pad numbers, polarity, top assembly side and KiCad zero-degree orientation
    checks:
    - symbol_pin_numbers_and_names
    - symbol_electrical_types
    - exposed_and_no_connect_pins
    - footprint_pad_numbers
    - package_dimensions
    - polarity_and_pin_one
    - assembly_side
    - cpl_zero_rotation
  ratings_audit:
    status: passed
    fields: capacitance, tolerance, rated voltage, dielectric, temperature range,
      DC-bias behavior where published and package dimensions
    datasheet_locator: part-number, characteristics and dimensions tables
  simulation_model:
    kind: analytical
    path: hardware/sim
    valid_region: lumped model with datasheet tolerance, bias, ESR, DCR and temperature
      corners
  conflicts: []
- mpn: GRM1555C1H680JA01D
  manufacturer: Murata
  supplier: JLCPCB
  order_code: C76977
  availability:
    status: available
    checked: '2026-07-26'
    source: https://jlcpcb.com/partdetail?part=C76977
  datasheet: Vault/Scacchiera/Datasheets/GRM1555C1H680JA01D_C76977.pdf
  wiki_source: Vault/Scacchiera/Wiki/sources/grm1555c1h680ja01d-datasheet.md
  wiki_entity: Vault/Scacchiera/Wiki/entities/grm1555c1h680ja01d.md
  category: capacitor
  footprint: Capacitor_SMD:C_0402_1005Metric
  uses:
  - board: hub
    reference: C34
    value: 68p C0G 2%
  library_audit:
    status: passed
    checked: '2026-07-26'
    evidence: manufacturer pin and package drawing checked against the SKiDL pin numbers,
      KiCad pad numbers, polarity, top assembly side and KiCad zero-degree orientation
    checks:
    - symbol_pin_numbers_and_names
    - symbol_electrical_types
    - exposed_and_no_connect_pins
    - footprint_pad_numbers
    - package_dimensions
    - polarity_and_pin_one
    - assembly_side
    - cpl_zero_rotation
  ratings_audit:
    status: passed
    fields: capacitance, tolerance, rated voltage, dielectric, temperature range,
      DC-bias behavior where published and package dimensions
    datasheet_locator: part-number, characteristics and dimensions tables
  simulation_model:
    kind: analytical
    path: hardware/sim
    valid_region: lumped model with datasheet tolerance, bias, ESR, DCR and temperature
      corners
  conflicts: []
- mpn: LQM21DH100M70L
  manufacturer: Murata
  supplier: JLCPCB
  order_code: C882484
  availability:
    status: available
    checked: '2026-08-20'
    source: https://jlcpcb.com/partdetail?part=C882484
  datasheet: Vault/Scacchiera/Datasheets/LQM21DH100M70L_C882484.pdf
  wiki_source: Vault/Scacchiera/Wiki/sources/lqm21dh100m70l-datasheet.md
  wiki_entity: Vault/Scacchiera/Wiki/entities/lqm21dh100m70l.md
  category: inductor
  footprint: Inductor_SMD:L_0805_2012Metric
  uses:
  - board: matrix
    reference: L1
    value: 10uH
  - board: matrix
    reference: L3
    value: 10uH
  - board: matrix
    reference: L5
    value: 10uH
  - board: matrix
    reference: L7
    value: 10uH
  - board: matrix
    reference: L9
    value: 10uH
  - board: matrix
    reference: L11
    value: 10uH
  - board: matrix
    reference: L13
    value: 10uH
  - board: matrix
    reference: L15
    value: 10uH
  - board: matrix
    reference: L17
    value: 10uH
  - board: matrix
    reference: L19
    value: 10uH
  - board: matrix
    reference: L21
    value: 10uH
  - board: matrix
    reference: L23
    value: 10uH
  - board: matrix
    reference: L25
    value: 10uH
  - board: matrix
    reference: L27
    value: 10uH
  - board: matrix
    reference: L29
    value: 10uH
  - board: matrix
    reference: L31
    value: 10uH
  library_audit:
    status: passed
    checked: '2026-08-20'
    evidence: manufacturer pin and package drawing checked against the SKiDL pin numbers,
      KiCad pad numbers, polarity, top assembly side and KiCad zero-degree orientation
    checks:
    - symbol_pin_numbers_and_names
    - symbol_electrical_types
    - exposed_and_no_connect_pins
    - footprint_pad_numbers
    - package_dimensions
    - polarity_and_pin_one
    - assembly_side
    - cpl_zero_rotation
  ratings_audit:
    status: passed
    fields: inductance, tolerance, rated or saturation current, DC resistance, self-resonance,
      temperature range and package dimensions
    datasheet_locator: electrical characteristics, ratings and dimensions tables
  simulation_model:
    kind: analytical
    path: hardware/sim
    valid_region: lumped model with datasheet tolerance, bias, ESR, DCR and temperature
      corners
  conflicts: []
- mpn: LQW2BASR47J00L
  manufacturer: Murata
  supplier: JLCPCB
  order_code: C337959
  availability:
    status: available
    checked: '2026-07-26'
    source: https://jlcpcb.com/partdetail?part=C337959
  datasheet: Vault/Scacchiera/Datasheets/LQW2BASR47J00L_C337959.pdf
  wiki_source: Vault/Scacchiera/Wiki/sources/lqw2basr47j00l-datasheet.md
  wiki_entity: Vault/Scacchiera/Wiki/entities/lqw2basr47j00l.md
  category: inductor
  footprint: Inductor_SMD:L_0805_2012Metric
  uses:
  - board: hub
    reference: L3
    value: 470nH
  - board: hub
    reference: L4
    value: 470nH
  library_audit:
    status: passed
    checked: '2026-07-26'
    evidence: manufacturer pin and package drawing checked against the SKiDL pin numbers,
      KiCad pad numbers, polarity, top assembly side and KiCad zero-degree orientation
    checks:
    - symbol_pin_numbers_and_names
    - symbol_electrical_types
    - exposed_and_no_connect_pins
    - footprint_pad_numbers
    - package_dimensions
    - polarity_and_pin_one
    - assembly_side
    - cpl_zero_rotation
  ratings_audit:
    status: passed
    fields: inductance, tolerance, rated or saturation current, DC resistance, self-resonance,
      temperature range and package dimensions
    datasheet_locator: electrical characteristics, ratings and dimensions tables
  simulation_model:
    kind: analytical
    path: hardware/sim
    valid_region: lumped model with datasheet tolerance, bias, ESR, DCR and temperature
      corners
  conflicts: []
- mpn: NR6045S4R7MT
  manufacturer: Magnetsyc
  supplier: JLCPCB
  order_code: C42370396
  availability:
    status: available
    checked: '2026-07-26'
    source: https://jlcpcb.com/partdetail?part=C42370396
  datasheet: Vault/Scacchiera/Datasheets/NR6045S4R7MT_C42370396.pdf
  wiki_source: Vault/Scacchiera/Wiki/sources/nr6045s4r7mt-datasheet.md
  wiki_entity: Vault/Scacchiera/Wiki/entities/nr6045s4r7mt.md
  category: inductor
  footprint: Chessboard:NR6045S
  uses:
  - board: hub
    reference: L1
    value: 4.7uH
  library_audit:
    status: passed
    checked: '2026-07-26'
    evidence: manufacturer pin and package drawing checked against the SKiDL pin numbers,
      KiCad pad numbers, polarity, top assembly side and KiCad zero-degree orientation
    checks:
    - symbol_pin_numbers_and_names
    - symbol_electrical_types
    - exposed_and_no_connect_pins
    - footprint_pad_numbers
    - package_dimensions
    - polarity_and_pin_one
    - assembly_side
    - cpl_zero_rotation
  ratings_audit:
    status: passed
    fields: inductance, tolerance, rated or saturation current, DC resistance, self-resonance,
      temperature range and package dimensions
    datasheet_locator: electrical characteristics, ratings and dimensions tables
  simulation_model:
    kind: analytical
    path: hardware/sim
    valid_region: lumped model with datasheet tolerance, bias, ESR, DCR and temperature
      corners
  conflicts: []
- mpn: PN5180A0HN/C3E
  manufacturer: NXP Semiconductors
  supplier: JLCPCB
  order_code: C1526287
  availability:
    status: available
    checked: '2026-07-26'
    source: https://jlcpcb.com/partdetail?part=C1526287
  datasheet: Vault/Scacchiera/Datasheets/PN5180A0HN-C3E_C1526287.pdf
  wiki_source: Vault/Scacchiera/Wiki/sources/pn5180a0hn-c3e-datasheet.md
  wiki_entity: Vault/Scacchiera/Wiki/entities/pn5180a0hn-c3e.md
  category: semiconductor
  footprint: Package_DFN_QFN:QFN-40-1EP_6x6mm_P0.5mm_EP4.6x4.6mm
  uses:
  - board: hub
    reference: U3
    value: PN5180A0HN/C3E
  library_audit:
    status: passed
    checked: '2026-07-26'
    evidence: manufacturer pin and package drawing checked against the SKiDL pin numbers,
      KiCad pad numbers, polarity, top assembly side and KiCad zero-degree orientation
    checks:
    - symbol_pin_numbers_and_names
    - symbol_electrical_types
    - exposed_and_no_connect_pins
    - footprint_pad_numbers
    - package_dimensions
    - polarity_and_pin_one
    - assembly_side
    - cpl_zero_rotation
  ratings_audit:
    status: passed
    fields: pinout, no-connect and exposed-pad treatment, recommended operating range,
      absolute maximum voltage, current, power and temperature, startup state, thermal
      data and package
    datasheet_locator: pin description, absolute maximum, recommended operation, electrical,
      thermal and package tables
  simulation_model:
    kind: datasheet_bounded
    path: hardware/sim
    valid_region: no distributable vendor ngspice model was identified; V3 may use
      only parameters enumerated in this part's filed datasheet and must sweep their
      full published limits; digital protocol behavior belongs to V6
  conflicts: []
- mpn: RS-03K1800FT
  manufacturer: Fenghua Advanced Technology
  supplier: JLCPCB
  order_code: C286574
  availability:
    status: available
    checked: '2026-07-26'
    source: https://jlcpcb.com/partdetail?part=C286574
  datasheet: Vault/Scacchiera/Datasheets/RS-03K1800FT_C286574.pdf
  wiki_source: Vault/Scacchiera/Wiki/sources/rs-03k1800ft-datasheet.md
  wiki_entity: Vault/Scacchiera/Wiki/entities/rs-03k1800ft.md
  category: resistor
  footprint: Resistor_SMD:R_0603_1608Metric
  uses:
  - board: matrix
    reference: R2
    value: 180R 1%
  - board: matrix
    reference: R5
    value: 180R 1%
  - board: matrix
    reference: R8
    value: 180R 1%
  - board: matrix
    reference: R11
    value: 180R 1%
  - board: matrix
    reference: R14
    value: 180R 1%
  - board: matrix
    reference: R17
    value: 180R 1%
  - board: matrix
    reference: R20
    value: 180R 1%
  - board: matrix
    reference: R23
    value: 180R 1%
  - board: matrix
    reference: R26
    value: 180R 1%
  - board: matrix
    reference: R29
    value: 180R 1%
  - board: matrix
    reference: R32
    value: 180R 1%
  - board: matrix
    reference: R35
    value: 180R 1%
  - board: matrix
    reference: R38
    value: 180R 1%
  - board: matrix
    reference: R41
    value: 180R 1%
  - board: matrix
    reference: R44
    value: 180R 1%
  - board: matrix
    reference: R47
    value: 180R 1%
  library_audit:
    status: passed
    checked: '2026-07-26'
    evidence: manufacturer pin and package drawing checked against the SKiDL pin numbers,
      KiCad pad numbers, polarity, top assembly side and KiCad zero-degree orientation
    checks:
    - symbol_pin_numbers_and_names
    - symbol_electrical_types
    - exposed_and_no_connect_pins
    - footprint_pad_numbers
    - package_dimensions
    - polarity_and_pin_one
    - assembly_side
    - cpl_zero_rotation
  ratings_audit:
    status: passed
    fields: value, tolerance, rated power, maximum working voltage, temperature coefficient,
      operating temperature and package dimensions
    datasheet_locator: ratings, dimensions and part-number tables
  simulation_model:
    kind: analytical
    path: hardware/sim
    valid_region: lumped model with datasheet tolerance, bias, ESR, DCR and temperature
      corners
  conflicts: []
- mpn: SM02B-GHS-TB(LF)(SN)
  manufacturer: JST
  supplier: JLCPCB
  order_code: C189893
  availability:
    status: available
    checked: '2026-07-26'
    source: https://jlcpcb.com/partdetail?part=C189893
  datasheet: Vault/Scacchiera/Datasheets/SM02B-GHS-TB-LF-SN_C189893.pdf
  wiki_source: Vault/Scacchiera/Wiki/sources/sm02b-ghs-tb-lf-sn-datasheet.md
  wiki_entity: Vault/Scacchiera/Wiki/entities/sm02b-ghs-tb-lf-sn.md
  category: connector
  footprint: Connector_JST:JST_GH_SM02B-GHS-TB_1x02-1MP_P1.25mm_Horizontal
  uses:
  - board: hub
    reference: J10
    value: SM02B-GHS-TB(LF)(SN)
  - board: hub
    reference: J11
    value: SM02B-GHS-TB(LF)(SN)
  library_audit:
    status: passed
    checked: '2026-07-26'
    evidence: manufacturer pin and package drawing checked against the SKiDL pin numbers,
      KiCad pad numbers, polarity, top assembly side and KiCad zero-degree orientation
    checks:
    - symbol_pin_numbers_and_names
    - symbol_electrical_types
    - exposed_and_no_connect_pins
    - footprint_pad_numbers
    - package_dimensions
    - polarity_and_pin_one
    - assembly_side
    - cpl_zero_rotation
  ratings_audit:
    status: passed
    fields: pin numbering, current, voltage, contact resistance, temperature, mating
      direction and package dimensions
    datasheet_locator: ratings, ordering information and dimensional drawing
  simulation_model:
    kind: layout_derived
    path: hardware/sim
    valid_region: contact and interconnect parasitics derived from rated contacts
      and routed geometry
  conflicts: []
- mpn: SM07B-GHS-TB(LF)(SN)
  manufacturer: JST
  supplier: JLCPCB
  order_code: C495552
  availability:
    status: available
    checked: '2026-07-26'
    source: https://jlcpcb.com/partdetail?part=C495552
  datasheet: Vault/Scacchiera/Datasheets/SM07B-GHS-TB-LF-SN_C495552.pdf
  wiki_source: Vault/Scacchiera/Wiki/sources/sm07b-ghs-tb-lf-sn-datasheet.md
  wiki_entity: Vault/Scacchiera/Wiki/entities/sm07b-ghs-tb-lf-sn.md
  category: connector
  footprint: Connector_JST:JST_GH_SM07B-GHS-TB_1x07-1MP_P1.25mm_Horizontal
  uses:
  - board: matrix
    reference: J1
    value: SM07B-GHS-TB
  - board: hub
    reference: J2
    value: SM07B-GHS-TB(LF)(SN)
  - board: hub
    reference: J4
    value: SM07B-GHS-TB(LF)(SN)
  - board: hub
    reference: J5
    value: SM07B-GHS-TB(LF)(SN)
  - board: hub
    reference: J6
    value: SM07B-GHS-TB(LF)(SN)
  - board: power
    reference: J1
    value: SM07B-GHS-TB(LF)(SN)
  library_audit:
    status: passed
    checked: '2026-07-26'
    evidence: manufacturer pin and package drawing checked against the SKiDL pin numbers,
      KiCad pad numbers, polarity, top assembly side and KiCad zero-degree orientation
    checks:
    - symbol_pin_numbers_and_names
    - symbol_electrical_types
    - exposed_and_no_connect_pins
    - footprint_pad_numbers
    - package_dimensions
    - polarity_and_pin_one
    - assembly_side
    - cpl_zero_rotation
  ratings_audit:
    status: passed
    fields: pin numbering, current, voltage, contact resistance, temperature, mating
      direction and package dimensions
    datasheet_locator: ratings, ordering information and dimensional drawing
  simulation_model:
    kind: layout_derived
    path: hardware/sim
    valid_region: contact and interconnect parasitics derived from rated contacts
      and routed geometry
  conflicts: []
- mpn: SN74AHCT1G125DBVR
  manufacturer: Texas Instruments
  supplier: JLCPCB
  order_code: C7484
  availability:
    status: available
    checked: '2026-07-26'
    source: https://jlcpcb.com/partdetail?part=C7484
  datasheet: Vault/Scacchiera/Datasheets/SN74AHCT1G125DBVR_C7484.pdf
  wiki_source: Vault/Scacchiera/Wiki/sources/sn74ahct1g125dbvr-datasheet.md
  wiki_entity: Vault/Scacchiera/Wiki/entities/sn74ahct1g125dbvr.md
  category: semiconductor
  footprint: Package_TO_SOT_SMD:SOT-23-5
  uses:
  - board: hub
    reference: U8
    value: SN74AHCT1G125DBVR
  library_audit:
    status: passed
    checked: '2026-07-26'
    evidence: manufacturer pin and package drawing checked against the SKiDL pin numbers,
      KiCad pad numbers, polarity, top assembly side and KiCad zero-degree orientation
    checks:
    - symbol_pin_numbers_and_names
    - symbol_electrical_types
    - exposed_and_no_connect_pins
    - footprint_pad_numbers
    - package_dimensions
    - polarity_and_pin_one
    - assembly_side
    - cpl_zero_rotation
  ratings_audit:
    status: passed
    fields: pinout, no-connect and exposed-pad treatment, recommended operating range,
      absolute maximum voltage, current, power and temperature, startup state, thermal
      data and package
    datasheet_locator: pin description, absolute maximum, recommended operation, electrical,
      thermal and package tables
  simulation_model:
    kind: datasheet_bounded
    path: hardware/sim
    valid_region: no distributable vendor ngspice model was identified; V3 may use
      only parameters enumerated in this part's filed datasheet and must sweep their
      full published limits; digital protocol behavior belongs to V6
  conflicts: []
- mpn: T37K3RGB-05C000112U1930
  manufacturer: Harvatek
  supplier: DigiKey
  order_code: 3147-T37K3RGB-05C000112U1930CT-ND
  availability:
    status: available
    checked: '2026-07-26'
    source: https://www.digikey.com/en/products/detail/harvatek-corporation/T37K3RGB-05C000112U1930/12177237
  datasheet: Vault/Scacchiera/Datasheets/T37K3RGB-05C000112U1930_DIGIKEY-3147-T37K3RGB-05C000112U1930CT-ND.pdf
  wiki_source: Vault/Scacchiera/Wiki/sources/t37k3rgb-05c000112u1930-datasheet.md
  wiki_entity: Vault/Scacchiera/Wiki/entities/t37k3rgb-05c000112u1930.md
  category: addressable_led
  footprint: Chessboard:T37K3RGB-05C000112U1930
  uses:
  - board: lightbar
    reference: D1
    value: T37K3RGB-05C000112U1930
  - board: lightbar
    reference: D2
    value: T37K3RGB-05C000112U1930
  - board: lightbar
    reference: D3
    value: T37K3RGB-05C000112U1930
  - board: lightbar
    reference: D4
    value: T37K3RGB-05C000112U1930
  - board: lightbar
    reference: D5
    value: T37K3RGB-05C000112U1930
  - board: lightbar
    reference: D6
    value: T37K3RGB-05C000112U1930
  - board: lightbar
    reference: D7
    value: T37K3RGB-05C000112U1930
  - board: lightbar
    reference: D8
    value: T37K3RGB-05C000112U1930
  - board: lightbar
    reference: D9
    value: T37K3RGB-05C000112U1930
  - board: lightbar
    reference: D10
    value: T37K3RGB-05C000112U1930
  - board: lightbar
    reference: D11
    value: T37K3RGB-05C000112U1930
  - board: lightbar
    reference: D12
    value: T37K3RGB-05C000112U1930
  - board: lightbar
    reference: D13
    value: T37K3RGB-05C000112U1930
  - board: lightbar
    reference: D14
    value: T37K3RGB-05C000112U1930
  library_audit:
    status: passed
    checked: '2026-07-26'
    evidence: manufacturer pin and package drawing checked against the SKiDL pin numbers,
      KiCad pad numbers, polarity, top assembly side and KiCad zero-degree orientation
    checks:
    - symbol_pin_numbers_and_names
    - symbol_electrical_types
    - exposed_and_no_connect_pins
    - footprint_pad_numbers
    - package_dimensions
    - polarity_and_pin_one
    - assembly_side
    - cpl_zero_rotation
  ratings_audit:
    status: passed
    fields: pinout, supply range, channel current, logic thresholds, timing, power,
      temperature, polarity and land pattern
    datasheet_locator: pages 2 to 5, electrical, timing, outline and recommended pad
      pattern
  simulation_model:
    kind: behavioral
    path: hardware/sim/lightbar_supply.py
    valid_region: datasheet maximum channel current and timing corners; digital protocol
      belongs to V6
  conflicts: []
- mpn: TCA9535PWR
  manufacturer: Texas Instruments
  supplier: JLCPCB
  order_code: C130204
  availability:
    status: available
    checked: '2026-07-26'
    source: https://jlcpcb.com/partdetail?part=C130204
  datasheet: Vault/Scacchiera/Datasheets/TCA9535PWR_C130204.pdf
  wiki_source: Vault/Scacchiera/Wiki/sources/tca9535pwr-datasheet.md
  wiki_entity: Vault/Scacchiera/Wiki/entities/tca9535pwr.md
  category: semiconductor
  footprint: Package_SO:TSSOP-24_4.4x7.8mm_P0.65mm
  uses:
  - board: hub
    reference: U6
    value: TCA9535PWR
  library_audit:
    status: passed
    checked: '2026-07-26'
    evidence: manufacturer pin and package drawing checked against the SKiDL pin numbers,
      KiCad pad numbers, polarity, top assembly side and KiCad zero-degree orientation
    checks:
    - symbol_pin_numbers_and_names
    - symbol_electrical_types
    - exposed_and_no_connect_pins
    - footprint_pad_numbers
    - package_dimensions
    - polarity_and_pin_one
    - assembly_side
    - cpl_zero_rotation
  ratings_audit:
    status: passed
    fields: pinout, no-connect and exposed-pad treatment, recommended operating range,
      absolute maximum voltage, current, power and temperature, startup state, thermal
      data and package
    datasheet_locator: pin description, absolute maximum, recommended operation, electrical,
      thermal and package tables
  simulation_model:
    kind: datasheet_bounded
    path: hardware/sim
    valid_region: no distributable vendor ngspice model was identified; V3 may use
      only parameters enumerated in this part's filed datasheet and must sweep their
      full published limits; digital protocol behavior belongs to V6
  conflicts: []
- mpn: TLV7021DCKR
  manufacturer: Texas Instruments
  supplier: JLCPCB
  order_code: C702120
  availability:
    status: available
    checked: '2026-07-26'
    source: https://jlcpcb.com/partdetail?part=C702120
  datasheet: Vault/Scacchiera/Datasheets/TLV7021DCKR_C702120.pdf
  wiki_source: Vault/Scacchiera/Wiki/sources/tlv7021dckr-datasheet.md
  wiki_entity: Vault/Scacchiera/Wiki/entities/tlv7021dckr.md
  category: semiconductor
  footprint: Package_TO_SOT_SMD:SOT-353_SC-70-5
  uses:
  - board: power
    reference: U4
    value: TLV7021DCKR
  library_audit:
    status: passed
    checked: '2026-07-26'
    evidence: manufacturer pin and package drawing checked against the SKiDL pin numbers,
      KiCad pad numbers, polarity, top assembly side and KiCad zero-degree orientation
    checks:
    - symbol_pin_numbers_and_names
    - symbol_electrical_types
    - exposed_and_no_connect_pins
    - footprint_pad_numbers
    - package_dimensions
    - polarity_and_pin_one
    - assembly_side
    - cpl_zero_rotation
  ratings_audit:
    status: passed
    fields: pinout, no-connect and exposed-pad treatment, recommended operating range,
      absolute maximum voltage, current, power and temperature, startup state, thermal
      data and package
    datasheet_locator: pin description, absolute maximum, recommended operation, electrical,
      thermal and package tables
  simulation_model:
    kind: datasheet_bounded
    path: hardware/sim/reverse_battery.py
    valid_region: ngspice functional polarity model sweeps cold and already-powered
      insertion; comparator offset, hysteresis, power-on reset, MOSFET body diode
      and hot on-resistance are bounded from the filed component data sheets
  conflicts: []
- mpn: TLV7042DGKR
  manufacturer: Texas Instruments
  supplier: JLCPCB
  order_code: C2760466
  availability:
    status: available
    checked: '2026-07-26'
    source: https://jlcpcb.com/partdetail?part=C2760466
  datasheet: Vault/Scacchiera/Datasheets/TLV7042DGKR_C2760466.pdf
  wiki_source: Vault/Scacchiera/Wiki/sources/tlv7042dgkr-datasheet.md
  wiki_entity: Vault/Scacchiera/Wiki/entities/tlv7042dgkr.md
  category: semiconductor
  footprint: Chessboard:TLV7042_DGK
  uses:
  - board: hub
    reference: U2
    value: TLV7042DGKR
  library_audit:
    status: passed
    checked: '2026-07-26'
    evidence: manufacturer pin and package drawing checked against the SKiDL pin numbers,
      KiCad pad numbers, polarity, top assembly side and KiCad zero-degree orientation
    checks:
    - symbol_pin_numbers_and_names
    - symbol_electrical_types
    - exposed_and_no_connect_pins
    - footprint_pad_numbers
    - package_dimensions
    - polarity_and_pin_one
    - assembly_side
    - cpl_zero_rotation
  ratings_audit:
    status: passed
    fields: pinout, no-connect and exposed-pad treatment, recommended operating range,
      absolute maximum voltage, current, power and temperature, startup state, thermal
      data and package
    datasheet_locator: pin description, absolute maximum, recommended operation, electrical,
      thermal and package tables
  simulation_model:
    kind: datasheet_bounded
    path: hardware/sim
    valid_region: no distributable vendor ngspice model was identified; V3 may use
      only parameters enumerated in this part's filed datasheet and must sweep their
      full published limits; digital protocol behavior belongs to V6
  conflicts: []
- mpn: TLV809K33DBVR
  manufacturer: Texas Instruments
  supplier: JLCPCB
  order_code: C48241
  availability:
    status: available
    checked: '2026-07-26'
    source: https://jlcpcb.com/partdetail?part=C48241
  datasheet: Vault/Scacchiera/Datasheets/TLV809K33DBVR_C48241.pdf
  wiki_source: Vault/Scacchiera/Wiki/sources/tlv809k33dbvr-datasheet.md
  wiki_entity: Vault/Scacchiera/Wiki/entities/tlv809k33dbvr.md
  category: semiconductor
  footprint: Package_TO_SOT_SMD:SOT-23
  uses:
  - board: power
    reference: U3
    value: TLV809K33DBVR
  library_audit:
    status: passed
    checked: '2026-07-26'
    evidence: manufacturer pin and package drawing checked against the SKiDL pin numbers,
      KiCad pad numbers, polarity, top assembly side and KiCad zero-degree orientation
    checks:
    - symbol_pin_numbers_and_names
    - symbol_electrical_types
    - exposed_and_no_connect_pins
    - footprint_pad_numbers
    - package_dimensions
    - polarity_and_pin_one
    - assembly_side
    - cpl_zero_rotation
  ratings_audit:
    status: passed
    fields: pinout, no-connect and exposed-pad treatment, recommended operating range,
      absolute maximum voltage, current, power and temperature, startup state, thermal
      data and package
    datasheet_locator: pin description, absolute maximum, recommended operation, electrical,
      thermal and package tables
  simulation_model:
    kind: datasheet_bounded
    path: hardware/sim
    valid_region: no distributable vendor ngspice model was identified; V3 may use
      only parameters enumerated in this part's filed datasheet and must sweep their
      full published limits; digital protocol behavior belongs to V6
  conflicts: []
- mpn: TPS2553DBVR-1
  manufacturer: Texas Instruments
  supplier: JLCPCB
  order_code: C111738
  availability:
    status: available
    checked: '2026-07-26'
    source: https://jlcpcb.com/partdetail?part=C111738
  datasheet: Vault/Scacchiera/Datasheets/TPS2553DBVR-1_C111738.pdf
  wiki_source: Vault/Scacchiera/Wiki/sources/tps2553dbvr-1-datasheet.md
  wiki_entity: Vault/Scacchiera/Wiki/entities/tps2553dbvr-1.md
  category: semiconductor
  footprint: Package_TO_SOT_SMD:SOT-23-6
  uses:
  - board: hub
    reference: U7
    value: TPS2553DBVR-1
  library_audit:
    status: passed
    checked: '2026-07-26'
    evidence: manufacturer pin and package drawing checked against the SKiDL pin numbers,
      KiCad pad numbers, polarity, top assembly side and KiCad zero-degree orientation
    checks:
    - symbol_pin_numbers_and_names
    - symbol_electrical_types
    - exposed_and_no_connect_pins
    - footprint_pad_numbers
    - package_dimensions
    - polarity_and_pin_one
    - assembly_side
    - cpl_zero_rotation
  ratings_audit:
    status: passed
    fields: pinout, no-connect and exposed-pad treatment, recommended operating range,
      absolute maximum voltage, current, power and temperature, startup state, thermal
      data and package
    datasheet_locator: pin description, absolute maximum, recommended operation, electrical,
      thermal and package tables
  simulation_model:
    kind: vendor
    path: hardware/sim/models/vendor/TPS2553_SLVM425B.zip
    valid_region: TI unencrypted transient PSpice model; V3 must prove ngspice compatibility
      and sweep datasheet input, load, temperature and external-component limits
  conflicts: []
- mpn: TPS61088RHLR
  manufacturer: Texas Instruments
  supplier: JLCPCB
  order_code: C87357
  availability:
    status: available
    checked: '2026-07-26'
    source: https://jlcpcb.com/partdetail?part=C87357
  datasheet: Vault/Scacchiera/Datasheets/TPS61088RHLR_C87357.pdf
  wiki_source: Vault/Scacchiera/Wiki/sources/tps61088rhlr-datasheet.md
  wiki_entity: Vault/Scacchiera/Wiki/entities/tps61088rhlr.md
  category: semiconductor
  footprint: Package_DFN_QFN:Texas_VQFN-RHL-20
  uses:
  - board: power
    reference: U2
    value: TPS61088RHLR
  library_audit:
    status: passed
    checked: '2026-07-26'
    evidence: manufacturer pin and package drawing checked against the SKiDL pin numbers,
      KiCad pad numbers, polarity, top assembly side and KiCad zero-degree orientation
    checks:
    - symbol_pin_numbers_and_names
    - symbol_electrical_types
    - exposed_and_no_connect_pins
    - footprint_pad_numbers
    - package_dimensions
    - polarity_and_pin_one
    - assembly_side
    - cpl_zero_rotation
  ratings_audit:
    status: passed
    fields: pinout, no-connect and exposed-pad treatment, recommended operating range,
      absolute maximum voltage, current, power and temperature, startup state, thermal
      data and package
    datasheet_locator: pin description, absolute maximum, recommended operation, electrical,
      thermal and package tables
  simulation_model:
    kind: vendor
    path: hardware/sim/models/vendor/TPS61088_TRANS.LIB
    valid_region: official TI transient model is filed; its two-expression ngspice
      compatibility copy parses but does not switch, so V3 uses a datasheet-bounded
      switching stage and leaves control-loop evidence open
  conflicts: []
- mpn: USB4105-GF-A
  manufacturer: GCT
  supplier: JLCPCB
  order_code: C3020560
  availability:
    status: available
    checked: '2026-07-26'
    source: https://jlcpcb.com/partdetail?part=C3020560
  datasheet: Vault/Scacchiera/Datasheets/USB4105-GF-A_C3020560.pdf
  wiki_source: Vault/Scacchiera/Wiki/sources/usb4105-gf-a-datasheet.md
  wiki_entity: Vault/Scacchiera/Wiki/entities/usb4105-gf-a.md
  category: connector
  footprint: Connector_USB:USB_C_Receptacle_GCT_USB4105-xx-A_16P_TopMnt_Horizontal
  uses:
  - board: hub
    reference: J1
    value: USB4105-GF-A
  library_audit:
    status: passed
    checked: '2026-07-26'
    evidence: manufacturer pin and package drawing checked against the SKiDL pin numbers,
      KiCad pad numbers, polarity, top assembly side and KiCad zero-degree orientation
    checks:
    - symbol_pin_numbers_and_names
    - symbol_electrical_types
    - exposed_and_no_connect_pins
    - footprint_pad_numbers
    - package_dimensions
    - polarity_and_pin_one
    - assembly_side
    - cpl_zero_rotation
  ratings_audit:
    status: passed
    fields: pin numbering, current, voltage, contact resistance, temperature, mating
      direction and package dimensions
    datasheet_locator: ratings, ordering information and dimensional drawing
  simulation_model:
    kind: layout_derived
    path: hardware/sim
    valid_region: contact and interconnect parasitics derived from rated contacts
      and routed geometry
  conflicts: []
component_blockers: []
external_components:
- mpn: NTCLE317E4103SBA
  role: Cell-bonded off-board charge-temperature sensor
  supplier: JLCPCB/LCSC
  order_code: C3154341
  availability:
    status: available
    checked: '2026-07-26'
    source: https://www.lcsc.com/product-detail/C3154341.html
  datasheets:
  - Vault/Scacchiera/Datasheets/NTCLE317E4103SBA_C3154341.pdf
  wiki_source: Vault/Scacchiera/Wiki/sources/ntcle317e4103sba-datasheet.md
  wiki_entity: Vault/Scacchiera/Wiki/entities/ntcle317e4103sba.md
  interface_audit:
    status: passed
    evidence: 75 mm insulated leads terminate at hub J11, sense on pin 1 and ground
      on pin 2; the 1.6 mm epoxy body is tape-bonded or glued to the cell as permitted
  ratings_audit:
    status: passed
    fields: 10 kohm at 25 degrees Celsius, R25 tolerance 2.19 percent, B25/85 3984
      K plus or minus 0.5 percent, 0.5 degree accuracy from 25 to 85 degrees Celsius
    datasheet_locator: quick reference, mounting, dimensions and ordering table
  simulation_model:
    kind: analytical
    path: hardware/sim
    valid_region: V3 beta-equation resistance model sweeps filed R25, beta, comparator
      and resistor corners; V8 measures the assembled trip temperatures
  conflicts: []
- mpn: ER-OLEDM3.12-1W
  role: Two off-board player OLED display modules
  supplier: BuyDisplay
  order_code: ER-OLEDM3.12-1W
  availability:
    status: available
    checked: '2026-07-29'
    source: https://www.buydisplay.com/white-grayscale-3-12-inch-oled-display-module-256x64-arduino-raspberry-pi
  datasheets:
  - Vault/Scacchiera/Datasheets/ER-OLEDM3.12-1W_BUYDISPLAY.md
  wiki_source: Vault/Scacchiera/Wiki/sources/er-oledm3-12-1w-manufacturer-evidence.md
  wiki_entity: Vault/Scacchiera/Wiki/entities/er-oledm3-12-1w.md
  interface_audit:
    status: blocked
    evidence: The module has a 16-pin 2.54 mm header while hub J5 and J6 are seven-pin
      JST GH; the exact harness and required serial-mode low straps are not yet bound.
  ratings_audit:
    status: blocked
    fields: 3.0 to 3.5 V logic supply, 3.6 V absolute maximum, 320 mA active maximum
      and 2 mA sleep maximum from datasheet section 4.3
    datasheet_locator: sections 4.1 through 4.3
  simulation_model:
    kind: datasheet_bounded
    path: hardware/verification/load_budget.py
    valid_region: 320 mA maximum current per display; digital protocol belongs to
      V6
  conflicts:
  - Product page calls 2 mA the active maximum while the datasheet calls it sleep
    current.
  - Original manufacturer PDF could not be filed because the supplier returned HTTP
    403.
