g3ncl/scacchiera/hardware/pcb/quad_layout.py

"""Place and route one 300 by 140 mm four-lane sensing board.

The loops are front copper and every component is on the back, which is the
monolith's rule and the reason it exists: the top face has to stay flat against
the controlled air gap. Nothing but antenna copper goes past `POUR_EDGE`,
enforced with a keepout rather than left to the router's judgement, so the four
276 mm loops can never acquire a signal track crossing them.

The component zone is 14.5 by 140 mm holding fifty-two footprints, which is the
same parts-per-area density the monolith's own margins carry. Four lane clusters
sit on the lane centres and the three things too wide for a cluster (both links
and the register) go in the gaps between them.

Placement is deterministic; the routing is delegated to Freerouting exactly as
the matrix board's margins are, and verified afterwards by the real KiCad DRC.
"""

import os
import subprocess
import sys
from pathlib import Path

import pcbnew

from hardware.pcb.layout import BoardBuilder, Placement, Position
from hardware.pcb.netlist import read_netlist
from hardware.pcb.quad_geometry import (
    DECOUPLE,
    LANES_PER_BOARD,
    LINK_IN,
    LINK_OUT,
    PLAY_CENTER,
    POUR_EDGE,
    POUR_INSET,
    QUAD_LENGTH,
    QUAD_THICKNESS,
    QUAD_WIDTH,
    REGISTER,
    antenna_reference,
    cell_slots,
    lane_center,
)
from hardware.pcb.ses_import import apply_session


OUTPUT = Path(__file__).parent / "generated" / "quad"
REVIEWED_SESSION = Path(__file__).parent / "routes" / "quad.ses"
FREEROUTING_JAR = os.environ.get("FREEROUTING_JAR", "/tmp/freerouting-2.2.4.jar")
FREEROUTING_PASSES = int(os.environ.get("FREEROUTING_PASSES", "20"))


def _placements() -> dict[str, Placement]:
    placements: dict[str, Placement] = {
        # Rotated so the pin row runs across the board and the cable leaves off
        # the x = 0 end, under the side rail, rather than off a long edge where
        # the neighbouring board of the same plane sits.
        "J1": Placement(Position(*LINK_IN), rotation=90.0, back=True),
        "J2": Placement(Position(*LINK_OUT), rotation=90.0, back=True),
        "U1": Placement(Position(*REGISTER), back=True),
        "C17": Placement(Position(*DECOUPLE), rotation=90.0, back=True),
    }
    for lane in range(LANES_PER_BOARD):
        # Each loop keeps the monolith's position along the play axis, so the
        # copper this board carries is the copper already extracted and
        # simulated rather than a new shape.
        placements[antenna_reference(lane)] = Placement(
            Position(PLAY_CENTER, lane_center(lane))
        )
        for reference, (x, y) in cell_slots(lane).items():
            # Rotation 0 puts a two-pin part's terminals on the x axis, which is
            # across the columns: each net then joins a pad to the pad of the
            # part beside or above it instead of reaching around a body.
            placements[reference] = Placement(Position(x, y), back=True)
    return placements


def _add_antenna_keepout(builder: BoardBuilder) -> None:
    """Forbid tracks and vias over the loops, on both faces.

    The router has no reason to go there and every reason not to: a track under
    an antenna is a shorted turn, and a via through one puts copper in the play
    area the read budget reserves.
    """
    for layer_name in ("F.Cu", "B.Cu"):
        zone = pcbnew.ZONE(builder.board)
        zone.SetIsRuleArea(True)
        zone.SetDoNotAllowTracks(True)
        zone.SetDoNotAllowVias(True)
        zone.SetLayer(builder.board.GetLayerID(layer_name))
        outline = zone.Outline()
        outline.NewOutline()
        for x, y in (
            (POUR_EDGE, 0.0),
            (QUAD_LENGTH, 0.0),
            (QUAD_LENGTH, QUAD_WIDTH),
            (POUR_EDGE, QUAD_WIDTH),
        ):
            point = pcbnew.VECTOR2I_MM(x, y)
            outline.Append(point.x, point.y)
        builder.board.Add(zone)


def _add_ground_pour(board: pcbnew.BOARD) -> None:
    """Both faces of the component zone, and nothing beyond it.

    The front pour is the RF return for the cells; the back pour bonds the
    component-side ground pads. Neither may reach under a loop, so both stop at
    the same edge the monolith's margin pour stops at.
    """
    for layer in (pcbnew.F_Cu, pcbnew.B_Cu):
        zone = pcbnew.ZONE(board)
        zone.SetLayer(layer)
        zone.SetNet(board.FindNet("GND"))
        zone.SetLocalClearance(pcbnew.FromMM(0.2))
        zone.SetPadConnection(pcbnew.ZONE_CONNECTION_FULL)
        zone.SetIslandRemovalMode(pcbnew.ISLAND_REMOVAL_MODE_ALWAYS)
        outline = zone.Outline()
        outline.NewOutline()
        for x, y in (
            (POUR_INSET, POUR_INSET),
            (POUR_EDGE, POUR_INSET),
            (POUR_EDGE, QUAD_WIDTH - POUR_INSET),
            (POUR_INSET, QUAD_WIDTH - POUR_INSET),
        ):
            point = pcbnew.VECTOR2I_MM(x, y)
            outline.Append(point.x, point.y)
        board.Add(zone)


def _remove_rule_areas(board: pcbnew.BOARD) -> None:
    for zone in list(board.Zones()):
        if zone.GetIsRuleArea():
            board.Remove(zone)


def _check_loop_terminals(builder: BoardBuilder) -> None:
    """Every loop's terminals must land inside the component zone.

    The footprint puts them on tails at one end, and which end that is depends
    on the placement rotation. Verify rather than trust it: a terminal past the
    pour edge is a pad the router cannot reach and a pad the pour cannot bond.
    """
    for lane in range(LANES_PER_BOARD):
        reference = antenna_reference(lane)
        for number in ("1", "2"):
            terminal = builder.pad_position(reference, number)
            if terminal.x > POUR_EDGE:
                raise ValueError(
                    f"{reference} terminal {number} landed at x={terminal.x:.2f}, "
                    f"past the {POUR_EDGE} mm pour edge"
                )


def generate_board(output: Path = OUTPUT / "quad.kicad_pcb") -> None:
    netlist = read_netlist(OUTPUT / "quad.net")
    builder = BoardBuilder(netlist, board_thickness_mm=QUAD_THICKNESS)
    settings = builder.board.GetDesignSettings()
    settings.m_CopperEdgeClearance = pcbnew.FromMM(0.2)
    settings.m_ViasMinSize = pcbnew.FromMM(0.4)
    settings.m_MinThroughDrill = pcbnew.FromMM(0.2)
    settings.m_ViasMinAnnularWidth = pcbnew.FromMM(0.1)
    builder.add_outline(QUAD_LENGTH, QUAD_WIDTH)
    placements = _placements()
    for component in netlist.components:
        placement = placements.get(component.reference)
        if placement is not None:
            builder.add_component(component, placement)
    _check_loop_terminals(builder)
    _add_antenna_keepout(builder)
    # Every board carries the same block in the same place: back silk, top
    # right corner, mirrored so it reads from the back.
    builder.add_title(
        "SCACCHIERA · QUAD\nrev 1.0 · 2026\nClaudio Genovese",
        Position(270.0, 12.0),
        height=1.5,
        back=True,
    )
    builder.save(output)


def _finalize_ground(board_path: Path) -> None:
    board = pcbnew.LoadBoard(str(board_path))
    if not board.Zones():
        _add_ground_pour(board)
    pcbnew.ZONE_FILLER(board).Fill(board.Zones())
    if not pcbnew.SaveBoard(str(board_path), board):
        raise OSError(f"could not save {board_path}")


def route_board(
    board_path: Path = OUTPUT / "quad.kicad_pcb",
    *,
    reroute: bool = False,
) -> None:
    """Import the reviewed route, or explicitly replace it with Freerouting."""
    dsn = board_path.with_suffix(".dsn")
    session_path = REVIEWED_SESSION
    if reroute:
        session_path = board_path.with_suffix(".ses")
        board = pcbnew.LoadBoard(str(board_path))
        if not pcbnew.ExportSpecctraDSN(board, str(dsn)):
            raise OSError(f"Specctra DSN export failed for {board_path}")
        if not Path(FREEROUTING_JAR).is_file():
            raise FileNotFoundError(
                f"Freerouting jar not found at {FREEROUTING_JAR}; set FREEROUTING_JAR"
            )
        subprocess.run(
            (
                "java", "-Djava.awt.headless=true", "-jar", FREEROUTING_JAR,
                "-de", str(dsn), "-do", str(session_path), "-mp", str(FREEROUTING_PASSES),
            ),
            check=True,
        )
    board = pcbnew.LoadBoard(str(board_path))
    apply_session(board, session_path.read_text(encoding="utf-8"), frozenset())
    _remove_rule_areas(board)
    if not pcbnew.SaveBoard(str(board_path), board):
        raise OSError(f"could not save routed board {board_path}")
    _finalize_ground(board_path)


if __name__ == "__main__":
    if "--unrouted" in sys.argv:
        unrouted = OUTPUT.parent / "unrouted" / "quad-unrouted.kicad_pcb"
        unrouted.parent.mkdir(parents=True, exist_ok=True)
        generate_board(unrouted)
    else:
        generate_board()
        route_board(reroute="--reroute" in sys.argv)
