g3ncl/scacchiera/(commit log)

2026-07-25 fix: prepare jlcpcb assembly
    [economic-parts-2026-07-24.csv, matrix-live-stock-2026-07-25.csv]
2026-07-25 feat: classify assembly routes
2026-07-25 fix: refine assembly sourcing
    [bom.py, fab.py, test_bom.py]
2026-07-25 feat: add datasheet rule, fix R17 current limit, make matrix layout reproducible
    Datasheets become a vault layer. CLAUDE.md and AGENTS.md gain a Datasheets
    section: read before choosing a part or writing a number, file after binding.
    17 manufacturer datasheets are filed under Vault/Scacchiera/Datasheets/ with
    source summaries and entity pages.
    That ingest caught a fatal error. R17 set the TPS2553 light-bar current limit
    to 287/323/365 mA where the load is 448 mA, so the bars would have latched dark
    on every board built. The 82k came from a recalled formula rather than section
    9.5.1. Now 39k (C23153, Basic, so free). ERC, DRC and a passing 28-test suite
    were all blind to it, which is why it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
    [bom.py, fab.py, footprints.py, generate.py, hub.py, hub_layout.py, lightbar.py]
2026-07-25 feat: add V0 requirement traceability
2026-07-26 feat: define quick charge requirements
2026-07-26 docs: evaluate quick charge module
2026-07-26 docs: select commercial battery subsystem
    [PISUGAR3_PLUS.step]
2026-07-26 docs: bind simplified hub power parts
2026-07-26 feat: rebuild hub power boundary
2026-07-26 fix: bind exact comparator footprint
    [footprints.py, hub.py, v1-components.yaml]
2026-07-26 feat: close V2 on the four-layer hub
    Rebuild the hub placement and reviewed route around the commercial 5 V
    boundary. Four copper layers keep a usable ground return under the dense
    MCU and NFC routing, where repeated two-layer trials stranded different
    long nets on every run.
    Derive the gerber layer list from the board's own layer table. A fixed
    outer pair would have shipped a hub package with no inner copper, losing
    the fixed VBUS branch and the SCLK bridge while DRC stayed green.
    Recovery is UART0 on J9, not USB-Serial-JTAG: the inlet is power-only.
    [fab.py, footprints.py, hub.py, hub_layout.py, test_fab.py, test_static_connectivity.py, v2-static.yaml]
2026-07-26 feat: simulate the charge interlock over every published corner
    File Vishay's own R/T curve for the cell bead's ceramic. The part data sheet
    prints R25, B25/85 and R85 but no curve, and the single-beta fit those three
    numbers support reads 0.80 K warm at 0 C, in the unsafe direction, against a
    cold margin of about 4.5 K. The filed coefficients reproduce both resistances
    the data sheet does print, and a test holds them to it.
    Sweep the gate over 384 corners emitted from the hub's own SKiDL objects: both
    extremes of each 1% resistance group, 4.5 to 5.5 V in, and the comparator's
    full published offset and hysteresis in each direction. Worst case the gate
    permits charging from 2.17 to 36.43 C,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
2026-07-29 feat: return the hub to two layers and unbind the power module
    Length instead of copper layers. The 110 x 46 mm two-layer route would not
    converge, which is why the board went to four; at 162 x 46 mm it closes at 0
    violations, 0 unconnected and 0 schematic parity issues. The service volume is
    a 310 mm player rail holding only this board, so length is free and a
    four-layer panel is not. Functional zones slide apart so the crossings between
    clusters open while the geometry inside one is untouched.
    Reserve the back copper under the reader's match and the run to the matrix
    connector: no tracks, vias allowed, and the routed board has no signal segment
    inside it. The reserve stops clear of the re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
    [criteria.yaml, generate_component_audit.py, hub.py, hub_layout.py, test_components.py, test_static_connectivity.py, traceability.yaml]
2026-07-29 feat: measure the light-bar current limit on TI's model
    The 39 k resistor programming the limiter had only the data sheet's IOS
    formula behind it, and the workflow is explicit that a formula is not release
    evidence. TI's transient PSpice model, extracted from the archive already in
    the repository and driven from the rail's own SKiDL connectivity, carries both
    bars at full white (444 mA at 4.459 V) and clamps a short at 657 to 670 mA
    across resistor and supply corners, inside the 1.0 A its harness contacts are
    rated for. It agrees with the formula to within one percent.
    Both criteria are written against the data sheet's 609 to 734 mA spread rather
    than the simulation, because the model carri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
    [criteria.yaml, hub.py, test_sim_led_rail.py, traceability.yaml, v1-components.yaml, v2-static.yaml]
2026-07-29 feat: finish the hub's V3 power path
    Buck power stage over 72 corners of load, input voltage, inductance tolerance
    and output capacitance: 3.59 mV of ripple against a 50 mV budget, 2.141 A of
    inductor peak against the converter's 2.5 A lowest guaranteed limit, and
    2.015 A rms against the inductor's 3.30 A rating. Saturation never binds
    because the converter current-limits first.
    The model holds no control behaviour at all. A loop added to place the
    operating point rang to 17.9 A, so it was deleted rather than tuned and the
    bench computes duty analytically per corner. Regulation, transient response
    and stability stay data sheet claims for V8, which the model file says.
    The input switch and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
    [charge_path.py, criteria.yaml, rail_budget.py, test_charge_path.py, test_rail_budget.py, test_sim_buck.py]
2026-07-29 feat: derive the coincident worst-case module load
    The power-module interface obliges a module to supply 1.3 A, which was an
    estimate written while defining the contract. Derived from filed data sheets
    with everything at its worst at once, the radio at its 382 mA transmit peak,
    the reader at its 250 mA TVDD maximum, both light bars white, the matrix
    biased and both displays active, the board draws 1.14 A. The obligation holds
    with 12 percent in hand and the interface now cites the derivation.
    The derivation also found what it could not close. The two display modules are
    fixed by the functional specification but have no filed data sheet and no V1
    record, so their current is an allowance carr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
    [criteria.yaml, load_budget.py, test_load_budget.py, traceability.yaml]
2026-07-29 feat: settle the matrix bias choke's rating
    The plan carried the 10 uH choke's 15 mA rating as an open V3 concern, because
    the design's own bias band runs to 14 mA and the RF bench only ever ran one
    nominal point. Swept over the rail's 3.27 to 3.33 V regulation band and the
    setting resistor's 1 percent tolerance, the bias reaches 10.58 mA, leaving 29
    percent of the component maximum unused.
    The two numbers were worth separating, since conflating them is what made this
    look risky. The 7 to 14 mA band says what the design wants the bias to be; the
    15 mA says what the part can take. There is now a criterion for each, and the
    new one cites the component's own data sheet rather than the design's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
    [criteria.yaml, test_sim_matrix_bias.py, traceability.yaml]
2026-07-29 feat: bound waveform integrity on the cabled buses
    Two buses leave the hub on a cable and nothing in docs dimensions those
    harnesses, so both are bounded rather than measured.
    The light-bar data line is self-clocked, so edge speed is not the metric:
    a uniform delay shifts both edges alike and the pixel never notices. Its
    buffer sources through about 150 ohm and sinks through 55 ohm, and that
    asymmetry stretches the high time by 15 ns at a 150 pF cable bound, against
    the 50 ns the pixel's symbol table allows.
    I2C rises in 796 ns at the specification's own 200 pF ceiling. That fits
    standard mode with a fifth in hand and does not fit fast mode, which would
    need the bus under about 70 pF. The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
    [criteria.yaml, signal_integrity.py, test_signal_integrity.py, traceability.yaml]
2026-07-29 feat: bound the matrix serial link, and correct V3's status
    The shift registers' own data sheet gives an input transition rate, 139 ns/V,
    which is the limit that applies rather than a general rule about edge rates.
    At the 150 pF cable bound the link delivers 16.4 ns/V, more than eight times
    inside it. The same edge is about a third of a half period at 4 MHz, which a
    rule of thumb would flag, so that observation is kept alongside the sourced
    result: raising the clock should be a decision, not an accident.
    Correct an overclaim while here. The plan said the hub's V3 was complete to
    the limit of what a model can honestly say. Walking the workflow's six cases
    instead of the list of work done tur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
    [criteria.yaml, signal_integrity.py, test_signal_integrity.py, traceability.yaml]
2026-07-29 feat: add a custom power board on the light-bar panel
    Panelising removes the fabrication cost that made custom lose, so a charger
    board now rides on the light bars' order and snaps off after delivery. That
    reasoning holds for the PCB and only for the PCB: V1 and V3 both open further
    because a lithium charger is now inside the design.
    The board implements the interface contract written for a purchased module
    rather than defining its own boundary, so the hub is untouched and V2 stays
    passing, and a bought module remains a drop-in replacement. The cell
    temperature interlock stays on the hub where it has 384 corners behind it, and
    the hub keeps measuring cell voltage itself, so nothing on this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
    [fab.py, footprints.py, generate.py, panel.py, power.py, power_layout.py]
2026-08-19 feat: split the sensing plane, power the board, bring up firmware (#1)
    * fix: audit the custom power board
    * fix: correct the power load evidence
    * docs: require 5v usb pd compatibility
    * design: define the 10w power basis
    * design: implement the 10w power board
    * design: qualify the 10w power path
    * design: protect the cell input
    * design: bound boost output corners
    * design: stabilize boost compensation
    * docs: define protected cell assembly gate
    * cad: reserve the protected cell envelope
    * docs: select a lower-cost pack candidate
    * verify: bound display SPI timing against the SSD1362 table
    * design: bound the V3 transient, thermal and fault cases
    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
    [economic-parts-2026-08-02.csv, partitions.csv]
2026-08-19 fix(pcb): resolve footprint fields across pcbnew binding versions
2026-08-19 fix(pcb): survive library renames and undefined solver exit codes
    [hub.py, hub_layout.py, test_static_connectivity.py]
2026-08-19 feat(fab): rendered review package for the board order
2026-08-19 docs: resolve the coupling conflict and record the library pinning gap
    [criteria.yaml, traceability.yaml]
2026-08-19 docs: sharpen the four V3 vendor gaps against current datasheets
2026-08-19 docs: pre-validate the buck transient remedy without spending a reroute
2026-08-19 docs: release the complete prototype set as V8 test articles
2026-08-20 docs: scope order artifacts to the library set each board passes on
2026-08-20 feat(pcb): vendor the bound kicad libraries into the repo
2026-08-20 feat(pcb): vendor kicad-libraries 9.0.6, the release the routes were reviewed against
2026-08-20 feat(pcb): unrouted board exports for external routing
2026-08-20 feat(pcb): park the hub's placer-owned parts outside the unrouted outline
2026-08-20 refactor(pcb): collect the unrouted exports in one folder
2026-08-20 feat(pcb): one purchase list for the hand-fitted parts
2026-08-20 feat(pcb): rebind the sensing choke to a part with a published saturation limit
2026-08-22 feat(pcb): fab layers in the review package, the placement orientation reference
2026-08-22 fix(pcb): the usb receptacle faces the board edge, not the board
    [hub_layout.py]
2026-08-22 fix(pcb): vbus escapes inboard, the locating pegs own the edge path
    [hub_layout.py]
2026-08-22 feat(pcb): reference legends on silk and a per-board title block
2026-08-22 fix(pcb): move the power title clear of the boost caps
    [power_layout.py]
2026-08-22 feat(pcb): one title block on every board's back silk
2026-08-22 fix(pcb): clean silk, the assembly legend moves to printable fab drawings
    [footprints.py, review.py]
2026-08-22 fix(pcb): stitch the walled-in usb ground pad, freerouting jvm from env
    [hub_layout.py]
